minzhetang/pangu-riscv-soc/README.md

# 盘古100Pro+ RISC-V SoC

面向盘古100Pro+（MES2L676-100HP）、目标器件PG2L100H-6IFBG676的比赛项目。包含五级流水线CPU、同步存储适配、UART TX/GPIO包装及裸机C验证。

状态快照：**2026-10-25，F147只读复核在明示建模边界内排除新旧最终综合网表的有效组合环，但sdm2adm的7→8条告警根因/严重性仍未解释；F146收益候选暂不替换F143/O2稳定基线**。不是正式CoreMark成绩、完整ISA、外部/CDC时序、post-route全验证或实机验收。

仓库已建立：`main`跟踪`origin/main`，首次53项基线提交为`cac9f87aedef4879a3dc2893dc16f32fed8c849b`。首次推送前已核空引用，仓库名称及Private标记由负责人在已登录官网确认。Git成功没有改变下面的软件/硬件验收边界。

## 已验证与尚未验证

|事项|当前证据|
|---|---|
|CPU执行裸机C及同步存储|有限软件系统通过，存储32K ROM/32K RAM使用官方primitive功能模型|
|UART/GPIO|原程序N16/N234回归无退化，真实CPU读写及公开串行输出通过；B v02原R1–R3由F152独立复验关闭，有限软件交付可接收；RX未系统集成|
|最终阶段v01审收（历史，后续见F152）|F149共70文件完整分类覆盖，7新编译/7运行；共享RX逐笔顺序、指定关联变异和末半stop复位控制关闭，有限功能保留。事件快照、TX绝对沿号和活动元数据仍有条件；不升级系统或硬件验收|
|物理时钟计数|64位自由运行、组合只读、高低高读取；计时单元增强296检查及真实C通过|
|CoreMark短运行|2K总数据、两个种子、各1迭代，CRC/全状态/有序副作用/计时与后置UART通过|
|计算区原始时钟数|性能种子2,103,648；验证种子2,263,000；不是主机运行秒数|
|正式CoreMark成绩|**未取得**。不足10秒的原提示保留；27MHz仅为软件频率设定|
|PDS逻辑实现预检|F141实际综合/映射/PnR通过，最终1806 LUT/1555 FF/14 DRM36；27MHz内部setup/hold最差24.425/0.115ns。外部IO未约束、7条constant-probe警告未关闭，非板级Fmax/运行验收|
|板级顶层适配|F142新增15个真实IO约束、KEY0三沿复位、四键/八LED和234拍UART；复位与两个短C新运行/全状态/公开波形通过。实际PnR1805 LUT/1519 FF/14DRM，27MHz内部最差setup23.279ns/hold0.129ns；异步/外部时序和7告警仍有边界，无位流/实机|
|新板级top上的CoreMark|F143保持13源/两旧镜像，在N234下2个新DUT有限通过；计算窗口逐笔事件/时刻及终态同F136，raw ticks仍2103648/2263000，完整662/661字节UART；计算无退化也无提速。本轮0GCC/0PDS/0硬件|
|O2→O3单变量质量实验|F144两新镜像/两新DUT严格功能短测通过，但计算ticks2106278/2267352，比O2慢0.1250%/0.1923%；镜像均增3080B。拒绝O3、保留O2；0PDS/0硬件，不将全程序结束稍早或编译选项当计算收益/架构创新|
|控制流只读质量评估|F145从旧真实轨迹核对149422/162524次计算区重定向，后继EX间隔6拍；已决目标提前送同步ROM、标签匹配少一槽仅为候选。0新DUT/构建/参考重放，理论空间不是实测收益|
|已决目标取指候选|F146原763+67定向+2CoreMark严格通过；同O2镜像计算2103648→1804804、2263000→1937952，少14.2060%/14.3636%。+108LUT/+33FF，27MHz内部STA通过但估频72.6850→60.5583MHz；constant-probe7→8未定位，候选不升稳定基线，无位流/硬件|
|告警只读收窄|F147两最终VM完整解析，INIT/实际绑常量与状态边界建图0残余；粗略共同伪反馈不是PDS根因。0新编译/DUT/PDS，告警保持未闭；精简官方两问已备未发|
|正式计量就绪检查|F150只读核68输入/四旧原流：迭代参数写死1、检查器为短测、长跑日志/周期预算不适配；下一双2迭代校准具体范围待批。0新编译/DUT/PDS，不是正式成绩|
|双种子各2迭代校准|F151新2DUT严格有限通过，raw4207378/4526490、finalCRC72be/fe8c、完整662/661UART；只新端口迭代接线/验证预算，13RTL不改，先验参考与每笔副作用/全态核同。仍不足10秒、非正式或实机验收|
|B最终阶段v02接收|F152外层80文件/7新编译7DUT，RX270事件/2700快照0差异、TX12完整事件E+10N准确、27diff精确重建；N1旧版本文案非阻塞另注。v02当前B交付、核心同SHA，RX未接SoC，非新系统/硬件验收；F154收到冻结97/96核同、B已知悉|
|长测证据/资源M0|F153仅主机处理四旧流，392.5MB→64.6MB逐字节还原、原输入39项不改；发现旧samples列表270M拍引用下限2.16GB。0新DUT/CPU/PDS，下一分段记录与流式检查的具体scope待批准，非长测就绪|
|当前系统上板、片上波形|**未验证**；over_temp原因未闭环，硬件操作保持停止|

F146仅在独立副本修改cpu/soc取指选择，队员包装/TX/GPIO及官方算法不改。历史F136性能检查器曾漏计启动BSS，初版FAIL保留、以其`check-result-v2.json`为准；F143新`check-result.json`继承正确v2语义，不过滤启动零写。有限结果不能证明CPU整体正确，F146仅新增有限程序/同频条件下有实测支持的计算收益，不证明创新首创或最高频率吞吐改善。

## 目录与验收入口

首次提交保留原工作路径，避免移动或重写已冻结成果：

- `work/system/2026-10-24-timed-coremark-m1/source/`：本阶段整组RTL。`memory_model.sv`为项目自写绑定，不含Pango专有primitive实现，亦不是已验证生产可综合内存。
- 同目录`firmware/`、`port/`：启动/链接、计时C及CoreMark平台适配。
- 同目录`tests/`、Python检查文件：计时单元、系统监视和独立判定；仅白名单内文件入仓。
- 同目录`runs/*/check-result*.json`及少量报告：选定的软件验收证据；波形和大型原始日志留在本地。
- [本阶段验证报告](reports/verification/2026-10-24-timed-coremark-m1.md)、[前一系统报告](reports/verification/2026-10-24-soc-txgpio-m1-system.md)。报告中的本地绝对路径不代表该资源已随仓库分发。
- [F141生产视图与PDS预检](reports/verification/2026-10-24-fpga-implementability-m0.md)：`work/fpga/2026-10-24-implementability-m0`保留独立副本、验证宏侧文件、脚本、完整命令及选定结果；旧F136绑定仍为历史软件基线。初始化/模型/工具数据库和原始日志不入仓。未生成位流，过温STOP不变。
- [F142板级软件适配报告](reports/verification/2026-10-25-board-top-m1.md)：`work/fpga/2026-10-25-board-top-m1`包含独立新增top/reset、短C、TB/检查器、引脚/时钟工程和分层结果；既有11源功能不改。其当时新top未跑CoreMark状态由下条F143限定取代，原报告不改；模型16键、负测及波形解析不计新DUT。
- [F143板级CoreMark复验](reports/verification/2026-10-25-board-coremark-m1.md)：同名work/fpga目录保留新TB/运行器/检查器、精确镜像与13源收据、完整UART变化记录和窗口原生VCD、质量对照及分层结果。连续串口记录不冒充全算法原生波形或片上ILA，旧成果和硬件STOP保持。
- [F144编译优化反例与取舍](reports/verification/2026-10-25-compile-quality-m1.md)：同名work/fpga目录保留统一O3/真实描述diff、冻结预期、完整命令、严格终态/事件/串口与波形结果、容量/栈/计算和输出分列。O3只为已验证后拒绝的候选，不是新默认基线；原O2未重跑或覆盖。
- [F145控制流只读量化](reports/verification/2026-10-25-control-flow-quality-m0.md)：work/analysis同名目录包含原迹解析/逐PC统计、来源SHA、最小候选范围；没有新CPU验证、实现或优化收益，下一RTL/TB/模型/PDS阶段须另获批准。
- [F146取指候选与质量代价](reports/verification/2026-10-25-resolved-target-fetch-m1.md)：同名work/fpga目录含准确两源diff、逐例结果、两检查器历史失败/同输出修正、完整命令和新原始证据。候选暂缓合入，F143仍稳定；完整日志/波形/模型本地保留，不声称干净克隆一键复现。
- [F147告警只读调查](reports/verification/2026-10-25-prefetch-warning-m0.md)：完整图/建模边界、共有粗略假阳性、官方帮助检索与内部图不可达范围分列；不以自写解析器代替官方消息解释，不提升候选或恢复硬件。
- [F151双迭代真实校准](reports/verification/2026-10-25-coremark-iter2-m1.md)：新参数初始化、先验参考、2个实际DUT/计时/全状态/有序副作用及完整串行证据，旧源/失败保留；F143稳定/F146暂缓，下一长测资源方案未自动实施。
- [F150正式测量就绪](reports/verification/2026-10-25-coremark-measurement-readiness-m0.md)：旧实际ELF/轨迹和资源预算审计，保持稳定F143；下一有限双迭代scope未批，原B反馈已由用户报告转交，等待新答复。
- [F153长测资源与有界归档原型](reports/verification/2026-10-26-coremark-longrun-evidence-m0.md)：work/analysis同名目录含原型/实际四流结果/正负控和下一PENDING范围；未改DUT采集器或功能检查器，不当>=10秒验证/FPGA成绩。
- [F152最终v02接收与差额关闭](reports/progress/2026-10-25-stage-final-v02-review.md)、[给B的回执与五问答复](deliveries/mainline-stage-final-v02-response-2026-10-25-v1/TEAMMATE_REPLY.md)：逐文件覆盖/原5波形与7新DUT分开，N1注记保留；B只冻结和具体复验支持，无必须新开发或重封包，旧根OPEN_PREEXISTING与硬件STOP保持。
- [F149最终阶段v01审收](reports/progress/2026-10-25-stage-final-v01-review.md)、[队员R1–R3集中反馈](deliveries/mainline-stage-final-response-2026-10-25-v1/TEAMMATE_REPLY.md)：新DUT/原波形分列，已证项关闭，只收敛验证/元数据差额；原核心和硬件STOP保持。
- [F148/2335完整审收与八问](reports/progress/2026-10-25-increment-2335-mainline-alignment.md)、[集中队员回复](deliveries/mainline-increment-2335-response-2026-10-25-v1/TEAMMATE_REPLY.md)：原/新波形、失败和有限关闭分列，原核心保持，B仅验证差额/最终封包；10/27窗口及硬件STOP不变。
- [1735增量分层审收](reports/progress/2026-10-24-increment-1735-mainline-alignment.md)、[给队员的集中反馈](deliveries/mainline-increment-1735-response-2026-10-24-v1/TEAMMATE_REPLY.md)。新收件不扩大PDS或硬件授权，原系统有限验收保持。
- [首次提交范围](docs/repository/FIRST_COMMIT_SCOPE.md)、[逐文件SHA-256清单](docs/repository/first-commit-files.json)、[外部依赖与复现边界](docs/repository/EXTERNAL_DEPENDENCIES.md)。

## 复现边界

既有环境为Icarus/vvp 13.0、xPack RISC-V GCC 15.2.0-1、PDS 2022.2-SP6.4。工具、授权、专有模型及CoreMark上游算法源不在首次提交中；不会从本仓库自动安装或下载它们。

计时单元`tb_timer_unit_v2`只依赖本仓库三个源文件及现有Icarus，无需PDS模型。下面是PowerShell入口示例，**不表示为本轮Git同步额外重跑了计时单元**；先自行将两个变量设为本机已有合法工具的绝对路径，不修改系统PATH：

```powershell
$iverilog = '<absolute-path-to-iverilog.exe>'
$vvp = '<absolute-path-to-vvp.exe>'
$ivlLib = '<absolute-path-to-ivl-library-directory>'
$baseline = 'work/system/2026-10-24-timed-coremark-m1'
New-Item -ItemType Directory -Force build | Out-Null
& $iverilog -B $ivlLib -g2012 -Wall -s tb_timer_unit_v2 -o build/timer-unit.vvp "$baseline/source/cycle_counter64.sv" "$baseline/source/soc_data_adapter.sv" "$baseline/tests/tb_timer_unit_v2.sv"
if ($LASTEXITCODE -ne 0) { throw 'Compile failed; do not execute its output' }
Push-Location build
try { & $vvp -N -M- "-M$ivlLib" timer-unit.vvp } finally { Pop-Location }
```

**完整SoC尚不具备干净克隆后一键复现入口。**保留的阶段Python脚本含本机路径、历史保护记录和外部依赖；部分历史文件不在首提中。不可直接执行这些脚本并假定已具备依赖。后续应独立整理可迁移运行器、初始化生成与外部模型定位；本次不为入仓改动验证逻辑或伪造重新复现。

## 仓库边界

`.gitignore`采用明确文件白名单，新增文件须审查后更新清单；默认不收工具/安装包、专有模型、授权或凭据、机器标识、照片/原始资料、完整交付包、本地项目记忆及大型构建/波形产物。`.gitattributes`关闭换行自动转换，以保持冻结文件的原始SHA；不修改全局Git配置。

忽略规则不保护已跟踪文件，也挡不住强制添加。每个工作单元仍须核对实际差异、暂存清单和敏感信息，再非强制推送并检查远端结果。普通源码/测试/文档经审查可更新白名单；重大范围、敏感疑点、远端冲突/分叉或破坏性操作须暂停。测试按改动风险选择，不为每次Git操作全量重跑。

`first-commit-files.json`记录`cac9f87`的历史53项快照，不是永久禁止修改代码的规则；其中准备状态与SHA对应首提交。后续文件发生已审修改时，应以当前Git差异和新范围验证。`verify_first_commit.py`是首提准备的一次性历史入口，不应在已初始化仓库重复执行其prepare/audit。这里没有后台定时同步，也不读取或索取认证凭据。

本仓库未替全部工程统一授予新的开源许可。CoreMark及其他第三方依赖的版权/许可仍归各自权利人；工具授权文件与应保留的开源版权声明是两类不同材料。
