minzhetang/pangu-riscv-soc/reports/progress/evidence/2026-10-25-stage-final-v02-review/COMMANDS.md

# v02主机复验命令和原始收据

所有调用普通用户；仅固定7项编译经过本批外部工具审批，其余普通执行。不运行收到的Python main或旧VVP。

1. review.py init / structured / diff：原件只读检查；final_waves.py解析原五波形。
2. native_review.py prepare / compile / run：复制核SHA后7固定编译与7新DUT。
3. verify_new.py：新公开波形/账本/绝对沿及纯函数变异。

工作目录：D:/A_FPGA_Comp/work/peripheral-review/2026-10-25-stage-final-v02

完整绝对argv逐项列在该目录plan.json、compile.json、run.json以及logs/<id>/process.json；新stdout/stderr与VVP/VCD同根保留。

```json
{"id": "wrap16", "phase": "compile", "argv": ["D:\\A_FPGA_Comp\\tools\\iverilog-13.0-msys2-ucrt64\\ucrt64\\bin\\iverilog.exe", "-B", "D:\\A_FPGA_Comp\\tools\\iverilog-13.0-msys2-ucrt64\\ucrt64\\lib\\ivl", "-g2012", "-Wall", "-s", "tb_local_regif_txgpio_m1", "-DCLKS_PER_BIT=16", "-DTB_MAX_CYCLES=300000", "-I", "D:\\A_FPGA_Comp\\work\\peripheral-review\\2026-10-25-stage-final-v02\\source", "-o", "D:\\A_FPGA_Comp\\work\\peripheral-review\\2026-10-25-stage-final-v02\\build\\wrap16.vvp", "D:\\A_FPGA_Comp\\work\\peripheral-review\\2026-10-25-stage-final-v02\\source\\local_regif_txgpio_m1.v", "D:\\A_FPGA_Comp\\work\\peripheral-review\\2026-10-25-stage-final-v02\\source\\uart_tx.v", "D:\\A_FPGA_Comp\\work\\peripheral-review\\2026-10-25-stage-final-v02\\source\\gpio_core.v", "D:\\A_FPGA_Comp\\work\\peripheral-review\\2026-10-25-stage-final-v02\\source\\regif_tx_public_monitor.sv", "D:\\A_FPGA_Comp\\work\\peripheral-review\\2026-10-25-stage-final-v02\\source\\tb_local_regif_txgpio_m1.sv"], "cwd": "D:\\A_FPGA_Comp\\work\\peripheral-review\\2026-10-25-stage-final-v02", "returncode": 0, "hex": "0x00000000", "timed_out": false, "timeout_s": 60, "duration_s": 0.062, "stdout": "D:\\A_FPGA_Comp\\work\\peripheral-review\\2026-10-25-stage-final-v02\\logs\\compile-wrap16\\stdout.log", "stderr": "D:\\A_FPGA_Comp\\work\\peripheral-review\\2026-10-25-stage-final-v02\\logs\\compile-wrap16\\stderr.log", "log_truncated": false, "cleanup": "NOT_NEEDED"}
```
```json
{"id": "wrap234", "phase": "compile", "argv": ["D:\\A_FPGA_Comp\\tools\\iverilog-13.0-msys2-ucrt64\\ucrt64\\bin\\iverilog.exe", "-B", "D:\\A_FPGA_Comp\\tools\\iverilog-13.0-msys2-ucrt64\\ucrt64\\lib\\ivl", "-g2012", "-Wall", "-s", "tb_local_regif_txgpio_m1", "-DCLKS_PER_BIT=234", "-DTB_MAX_CYCLES=300000", "-I", "D:\\A_FPGA_Comp\\work\\peripheral-review\\2026-10-25-stage-final-v02\\source", "-o", "D:\\A_FPGA_Comp\\work\\peripheral-review\\2026-10-25-stage-final-v02\\build\\wrap234.vvp", "D:\\A_FPGA_Comp\\work\\peripheral-review\\2026-10-25-stage-final-v02\\source\\local_regif_txgpio_m1.v", "D:\\A_FPGA_Comp\\work\\peripheral-review\\2026-10-25-stage-final-v02\\source\\uart_tx.v", "D:\\A_FPGA_Comp\\work\\peripheral-review\\2026-10-25-stage-final-v02\\source\\gpio_core.v", "D:\\A_FPGA_Comp\\work\\peripheral-review\\2026-10-25-stage-final-v02\\source\\regif_tx_public_monitor.sv", "D:\\A_FPGA_Comp\\work\\peripheral-review\\2026-10-25-stage-final-v02\\source\\tb_local_regif_txgpio_m1.sv"], "cwd": "D:\\A_FPGA_Comp\\work\\peripheral-review\\2026-10-25-stage-final-v02", "returncode": 0, "hex": "0x00000000", "timed_out": false, "timeout_s": 60, "duration_s": 0.047, "stdout": "D:\\A_FPGA_Comp\\work\\peripheral-review\\2026-10-25-stage-final-v02\\logs\\compile-wrap234\\stdout.log", "stderr": "D:\\A_FPGA_Comp\\work\\peripheral-review\\2026-10-25-stage-final-v02\\logs\\compile-wrap234\\stderr.log", "log_truncated": false, "cleanup": "NOT_NEEDED"}
```
```json
{"id": "rx8", "phase": "compile", "argv": ["D:\\A_FPGA_Comp\\tools\\iverilog-13.0-msys2-ucrt64\\ucrt64\\bin\\iverilog.exe", "-B", "D:\\A_FPGA_Comp\\tools\\iverilog-13.0-msys2-ucrt64\\ucrt64\\lib\\ivl", "-g2012", "-Wall", "-s", "tb_uart_rx", "-DCLKS_PER_BIT=8", "-DTB_MAX_CYCLES=5045", "-I", "D:\\A_FPGA_Comp\\work\\peripheral-review\\2026-10-25-stage-final-v02\\source", "-o", "D:\\A_FPGA_Comp\\work\\peripheral-review\\2026-10-25-stage-final-v02\\build\\rx8.vvp", "-s", "review_rx_dump", "D:\\A_FPGA_Comp\\work\\peripheral-review\\2026-10-25-stage-final-v02\\source\\uart_rx.v", "D:\\A_FPGA_Comp\\work\\peripheral-review\\2026-10-25-stage-final-v02\\source\\rx_public_capture.sv", "D:\\A_FPGA_Comp\\work\\peripheral-review\\2026-10-25-stage-final-v02\\source\\tb_uart_rx.sv", "D:\\A_FPGA_Comp\\work\\peripheral-review\\2026-10-25-stage-final-v02\\tests\\review_rx_dump.sv"], "cwd": "D:\\A_FPGA_Comp\\work\\peripheral-review\\2026-10-25-stage-final-v02", "returncode": 0, "hex": "0x00000000", "timed_out": false, "timeout_s": 60, "duration_s": 0.063, "stdout": "D:\\A_FPGA_Comp\\work\\peripheral-review\\2026-10-25-stage-final-v02\\logs\\compile-rx8\\stdout.log", "stderr": "D:\\A_FPGA_Comp\\work\\peripheral-review\\2026-10-25-stage-final-v02\\logs\\compile-rx8\\stderr.log", "log_truncated": false, "cleanup": "NOT_NEEDED"}
```
```json
{"id": "rx16", "phase": "compile", "argv": ["D:\\A_FPGA_Comp\\tools\\iverilog-13.0-msys2-ucrt64\\ucrt64\\bin\\iverilog.exe", "-B", "D:\\A_FPGA_Comp\\tools\\iverilog-13.0-msys2-ucrt64\\ucrt64\\lib\\ivl", "-g2012", "-Wall", "-s", "tb_uart_rx", "-DCLKS_PER_BIT=16", "-DTB_MAX_CYCLES=11319", "-I", "D:\\A_FPGA_Comp\\work\\peripheral-review\\2026-10-25-stage-final-v02\\source", "-o", "D:\\A_FPGA_Comp\\work\\peripheral-review\\2026-10-25-stage-final-v02\\build\\rx16.vvp", "-s", "review_rx_dump", "D:\\A_FPGA_Comp\\work\\peripheral-review\\2026-10-25-stage-final-v02\\source\\uart_rx.v", "D:\\A_FPGA_Comp\\work\\peripheral-review\\2026-10-25-stage-final-v02\\source\\rx_public_capture.sv", "D:\\A_FPGA_Comp\\work\\peripheral-review\\2026-10-25-stage-final-v02\\source\\tb_uart_rx.sv", "D:\\A_FPGA_Comp\\work\\peripheral-review\\2026-10-25-stage-final-v02\\tests\\review_rx_dump.sv"], "cwd": "D:\\A_FPGA_Comp\\work\\peripheral-review\\2026-10-25-stage-final-v02", "returncode": 0, "hex": "0x00000000", "timed_out": false, "timeout_s": 60, "duration_s": 0.046, "stdout": "D:\\A_FPGA_Comp\\work\\peripheral-review\\2026-10-25-stage-final-v02\\logs\\compile-rx16\\stdout.log", "stderr": "D:\\A_FPGA_Comp\\work\\peripheral-review\\2026-10-25-stage-final-v02\\logs\\compile-rx16\\stderr.log", "log_truncated": false, "cleanup": "NOT_NEEDED"}
```
```json
{"id": "rx234", "phase": "compile", "argv": ["D:\\A_FPGA_Comp\\tools\\iverilog-13.0-msys2-ucrt64\\ucrt64\\bin\\iverilog.exe", "-B", "D:\\A_FPGA_Comp\\tools\\iverilog-13.0-msys2-ucrt64\\ucrt64\\lib\\ivl", "-g2012", "-Wall", "-s", "tb_uart_rx", "-DCLKS_PER_BIT=234", "-DTB_MAX_CYCLES=110967", "-I", "D:\\A_FPGA_Comp\\work\\peripheral-review\\2026-10-25-stage-final-v02\\source", "-o", "D:\\A_FPGA_Comp\\work\\peripheral-review\\2026-10-25-stage-final-v02\\build\\rx234.vvp", "-s", "review_rx_dump", "D:\\A_FPGA_Comp\\work\\peripheral-review\\2026-10-25-stage-final-v02\\source\\uart_rx.v", "D:\\A_FPGA_Comp\\work\\peripheral-review\\2026-10-25-stage-final-v02\\source\\rx_public_capture.sv", "D:\\A_FPGA_Comp\\work\\peripheral-review\\2026-10-25-stage-final-v02\\source\\tb_uart_rx.sv", "D:\\A_FPGA_Comp\\work\\peripheral-review\\2026-10-25-stage-final-v02\\tests\\review_rx_dump.sv"], "cwd": "D:\\A_FPGA_Comp\\work\\peripheral-review\\2026-10-25-stage-final-v02", "returncode": 0, "hex": "0x00000000", "timed_out": false, "timeout_s": 60, "duration_s": 0.063, "stdout": "D:\\A_FPGA_Comp\\work\\peripheral-review\\2026-10-25-stage-final-v02\\logs\\compile-rx234\\stdout.log", "stderr": "D:\\A_FPGA_Comp\\work\\peripheral-review\\2026-10-25-stage-final-v02\\logs\\compile-rx234\\stderr.log", "log_truncated": false, "cleanup": "NOT_NEEDED"}
```
```json
{"id": "rxneg", "phase": "compile", "argv": ["D:\\A_FPGA_Comp\\tools\\iverilog-13.0-msys2-ucrt64\\ucrt64\\bin\\iverilog.exe", "-B", "D:\\A_FPGA_Comp\\tools\\iverilog-13.0-msys2-ucrt64\\ucrt64\\lib\\ivl", "-g2012", "-Wall", "-s", "tb_uart_rx_neg", "-DCLKS_PER_BIT=16", "-DTB_MAX_CYCLES=20000", "-I", "D:\\A_FPGA_Comp\\work\\peripheral-review\\2026-10-25-stage-final-v02\\source", "-o", "D:\\A_FPGA_Comp\\work\\peripheral-review\\2026-10-25-stage-final-v02\\build\\rxneg.vvp", "D:\\A_FPGA_Comp\\work\\peripheral-review\\2026-10-25-stage-final-v02\\source\\uart_rx.v", "D:\\A_FPGA_Comp\\work\\peripheral-review\\2026-10-25-stage-final-v02\\source\\rx_public_capture.sv", "D:\\A_FPGA_Comp\\work\\peripheral-review\\2026-10-25-stage-final-v02\\source\\tb_uart_rx_neg.sv"], "cwd": "D:\\A_FPGA_Comp\\work\\peripheral-review\\2026-10-25-stage-final-v02", "returncode": 0, "hex": "0x00000000", "timed_out": false, "timeout_s": 60, "duration_s": 0.047, "stdout": "D:\\A_FPGA_Comp\\work\\peripheral-review\\2026-10-25-stage-final-v02\\logs\\compile-rxneg\\stdout.log", "stderr": "D:\\A_FPGA_Comp\\work\\peripheral-review\\2026-10-25-stage-final-v02\\logs\\compile-rxneg\\stderr.log", "log_truncated": false, "cleanup": "NOT_NEEDED"}
```
```json
{"id": "txcap", "phase": "compile", "argv": ["D:\\A_FPGA_Comp\\tools\\iverilog-13.0-msys2-ucrt64\\ucrt64\\bin\\iverilog.exe", "-B", "D:\\A_FPGA_Comp\\tools\\iverilog-13.0-msys2-ucrt64\\ucrt64\\lib\\ivl", "-g2012", "-Wall", "-s", "tb_regif_tx_capture_neg", "-DCLKS_PER_BIT=16", "-DTB_MAX_CYCLES=20000", "-I", "D:\\A_FPGA_Comp\\work\\peripheral-review\\2026-10-25-stage-final-v02\\source", "-o", "D:\\A_FPGA_Comp\\work\\peripheral-review\\2026-10-25-stage-final-v02\\build\\txcap.vvp", "D:\\A_FPGA_Comp\\work\\peripheral-review\\2026-10-25-stage-final-v02\\source\\regif_tx_public_monitor.sv", "D:\\A_FPGA_Comp\\work\\peripheral-review\\2026-10-25-stage-final-v02\\source\\tb_regif_tx_capture_neg.sv"], "cwd": "D:\\A_FPGA_Comp\\work\\peripheral-review\\2026-10-25-stage-final-v02", "returncode": 0, "hex": "0x00000000", "timed_out": false, "timeout_s": 60, "duration_s": 0.047, "stdout": "D:\\A_FPGA_Comp\\work\\peripheral-review\\2026-10-25-stage-final-v02\\logs\\compile-txcap\\stdout.log", "stderr": "D:\\A_FPGA_Comp\\work\\peripheral-review\\2026-10-25-stage-final-v02\\logs\\compile-txcap\\stderr.log", "log_truncated": false, "cleanup": "NOT_NEEDED"}
```
```json
{"id": "wrap16", "phase": "run", "argv": ["D:\\A_FPGA_Comp\\tools\\iverilog-13.0-msys2-ucrt64\\ucrt64\\bin\\vvp.exe", "-N", "-M-", "-MD:\\A_FPGA_Comp\\tools\\iverilog-13.0-msys2-ucrt64\\ucrt64\\lib\\ivl", "D:\\A_FPGA_Comp\\work\\peripheral-review\\2026-10-25-stage-final-v02\\build\\wrap16.vvp", "+WAVE_FILE=D:/A_FPGA_Comp/work/peripheral-review/2026-10-25-stage-final-v02/build/wrap16.vcd"], "cwd": "D:\\A_FPGA_Comp\\work\\peripheral-review\\2026-10-25-stage-final-v02", "returncode": 0, "hex": "0x00000000", "timed_out": false, "timeout_s": 30, "duration_s": 0.031, "stdout": "D:\\A_FPGA_Comp\\work\\peripheral-review\\2026-10-25-stage-final-v02\\logs\\run-wrap16\\stdout.log", "stderr": "D:\\A_FPGA_Comp\\work\\peripheral-review\\2026-10-25-stage-final-v02\\logs\\run-wrap16\\stderr.log", "log_truncated": false, "cleanup": "NOT_NEEDED"}
```
```json
{"id": "wrap234", "phase": "run", "argv": ["D:\\A_FPGA_Comp\\tools\\iverilog-13.0-msys2-ucrt64\\ucrt64\\bin\\vvp.exe", "-N", "-M-", "-MD:\\A_FPGA_Comp\\tools\\iverilog-13.0-msys2-ucrt64\\ucrt64\\lib\\ivl", "D:\\A_FPGA_Comp\\work\\peripheral-review\\2026-10-25-stage-final-v02\\build\\wrap234.vvp", "+WAVE_FILE=D:/A_FPGA_Comp/work/peripheral-review/2026-10-25-stage-final-v02/build/wrap234.vcd"], "cwd": "D:\\A_FPGA_Comp\\work\\peripheral-review\\2026-10-25-stage-final-v02", "returncode": 0, "hex": "0x00000000", "timed_out": false, "timeout_s": 30, "duration_s": 0.109, "stdout": "D:\\A_FPGA_Comp\\work\\peripheral-review\\2026-10-25-stage-final-v02\\logs\\run-wrap234\\stdout.log", "stderr": "D:\\A_FPGA_Comp\\work\\peripheral-review\\2026-10-25-stage-final-v02\\logs\\run-wrap234\\stderr.log", "log_truncated": false, "cleanup": "NOT_NEEDED"}
```
```json
{"id": "rx8", "phase": "run", "argv": ["D:\\A_FPGA_Comp\\tools\\iverilog-13.0-msys2-ucrt64\\ucrt64\\bin\\vvp.exe", "-N", "-M-", "-MD:\\A_FPGA_Comp\\tools\\iverilog-13.0-msys2-ucrt64\\ucrt64\\lib\\ivl", "D:\\A_FPGA_Comp\\work\\peripheral-review\\2026-10-25-stage-final-v02\\build\\rx8.vvp", "+WAVE_FILE=D:/A_FPGA_Comp/work/peripheral-review/2026-10-25-stage-final-v02/build/rx8.vcd"], "cwd": "D:\\A_FPGA_Comp\\work\\peripheral-review\\2026-10-25-stage-final-v02", "returncode": 0, "hex": "0x00000000", "timed_out": false, "timeout_s": 30, "duration_s": 0.079, "stdout": "D:\\A_FPGA_Comp\\work\\peripheral-review\\2026-10-25-stage-final-v02\\logs\\run-rx8\\stdout.log", "stderr": "D:\\A_FPGA_Comp\\work\\peripheral-review\\2026-10-25-stage-final-v02\\logs\\run-rx8\\stderr.log", "log_truncated": false, "cleanup": "NOT_NEEDED"}
```
```json
{"id": "rx16", "phase": "run", "argv": ["D:\\A_FPGA_Comp\\tools\\iverilog-13.0-msys2-ucrt64\\ucrt64\\bin\\vvp.exe", "-N", "-M-", "-MD:\\A_FPGA_Comp\\tools\\iverilog-13.0-msys2-ucrt64\\ucrt64\\lib\\ivl", "D:\\A_FPGA_Comp\\work\\peripheral-review\\2026-10-25-stage-final-v02\\build\\rx16.vvp", "+WAVE_FILE=D:/A_FPGA_Comp/work/peripheral-review/2026-10-25-stage-final-v02/build/rx16.vcd"], "cwd": "D:\\A_FPGA_Comp\\work\\peripheral-review\\2026-10-25-stage-final-v02", "returncode": 0, "hex": "0x00000000", "timed_out": false, "timeout_s": 30, "duration_s": 0.093, "stdout": "D:\\A_FPGA_Comp\\work\\peripheral-review\\2026-10-25-stage-final-v02\\logs\\run-rx16\\stdout.log", "stderr": "D:\\A_FPGA_Comp\\work\\peripheral-review\\2026-10-25-stage-final-v02\\logs\\run-rx16\\stderr.log", "log_truncated": false, "cleanup": "NOT_NEEDED"}
```
```json
{"id": "rx234", "phase": "run", "argv": ["D:\\A_FPGA_Comp\\tools\\iverilog-13.0-msys2-ucrt64\\ucrt64\\bin\\vvp.exe", "-N", "-M-", "-MD:\\A_FPGA_Comp\\tools\\iverilog-13.0-msys2-ucrt64\\ucrt64\\lib\\ivl", "D:\\A_FPGA_Comp\\work\\peripheral-review\\2026-10-25-stage-final-v02\\build\\rx234.vvp", "+WAVE_FILE=D:/A_FPGA_Comp/work/peripheral-review/2026-10-25-stage-final-v02/build/rx234.vcd"], "cwd": "D:\\A_FPGA_Comp\\work\\peripheral-review\\2026-10-25-stage-final-v02", "returncode": 0, "hex": "0x00000000", "timed_out": false, "timeout_s": 30, "duration_s": 0.703, "stdout": "D:\\A_FPGA_Comp\\work\\peripheral-review\\2026-10-25-stage-final-v02\\logs\\run-rx234\\stdout.log", "stderr": "D:\\A_FPGA_Comp\\work\\peripheral-review\\2026-10-25-stage-final-v02\\logs\\run-rx234\\stderr.log", "log_truncated": false, "cleanup": "NOT_NEEDED"}
```
```json
{"id": "rxneg", "phase": "run", "argv": ["D:\\A_FPGA_Comp\\tools\\iverilog-13.0-msys2-ucrt64\\ucrt64\\bin\\vvp.exe", "-N", "-M-", "-MD:\\A_FPGA_Comp\\tools\\iverilog-13.0-msys2-ucrt64\\ucrt64\\lib\\ivl", "D:\\A_FPGA_Comp\\work\\peripheral-review\\2026-10-25-stage-final-v02\\build\\rxneg.vvp", "+WAVE_FILE=D:/A_FPGA_Comp/work/peripheral-review/2026-10-25-stage-final-v02/build/rxneg.vcd"], "cwd": "D:\\A_FPGA_Comp\\work\\peripheral-review\\2026-10-25-stage-final-v02", "returncode": 0, "hex": "0x00000000", "timed_out": false, "timeout_s": 30, "duration_s": 0.032, "stdout": "D:\\A_FPGA_Comp\\work\\peripheral-review\\2026-10-25-stage-final-v02\\logs\\run-rxneg\\stdout.log", "stderr": "D:\\A_FPGA_Comp\\work\\peripheral-review\\2026-10-25-stage-final-v02\\logs\\run-rxneg\\stderr.log", "log_truncated": false, "cleanup": "NOT_NEEDED"}
```
```json
{"id": "txcap", "phase": "run", "argv": ["D:\\A_FPGA_Comp\\tools\\iverilog-13.0-msys2-ucrt64\\ucrt64\\bin\\vvp.exe", "-N", "-M-", "-MD:\\A_FPGA_Comp\\tools\\iverilog-13.0-msys2-ucrt64\\ucrt64\\lib\\ivl", "D:\\A_FPGA_Comp\\work\\peripheral-review\\2026-10-25-stage-final-v02\\build\\txcap.vvp", "+WAVE_FILE=D:/A_FPGA_Comp/work/peripheral-review/2026-10-25-stage-final-v02/build/txcap.vcd"], "cwd": "D:\\A_FPGA_Comp\\work\\peripheral-review\\2026-10-25-stage-final-v02", "returncode": 0, "hex": "0x00000000", "timed_out": false, "timeout_s": 30, "duration_s": 0.031, "stdout": "D:\\A_FPGA_Comp\\work\\peripheral-review\\2026-10-25-stage-final-v02\\logs\\run-txcap\\stdout.log", "stderr": "D:\\A_FPGA_Comp\\work\\peripheral-review\\2026-10-25-stage-final-v02\\logs\\run-txcap\\stderr.log", "log_truncated": false, "cleanup": "NOT_NEEDED"}
```
