minzhetang/pangu-riscv-soc/reports/progress/evidence/2026-10-25-stage-final-v02-review/READING_CHECKLIST_COMPLETED.md

# v02逐文件阅读/解析清单

80文件；0仅哈希、0未读。旧同SHA内容按F149完整阅读证据复用，变更源按实际v01→v02完整差额核查。原5VCD全时间线解析与本次7新DUT分开。

|文件|状态|
|---|---|
|artifacts/stage-return-final-20261027-v02/CHANGED_FILES.json|FULL_STRUCTURED_PARSE_AND_SEMANTIC_CHECK|
|artifacts/stage-return-final-20261027-v02/coverage_map.json|FULL_STRUCTURED_PARSE_AND_SEMANTIC_CHECK|
|artifacts/stage-return-final-20261027-v02/delivery.json|FULL_STRUCTURED_PARSE_AND_SEMANTIC_CHECK|
|artifacts/stage-return-final-20261027-v02/DEPENDENCIES.json|FULL_STRUCTURED_PARSE_AND_SEMANTIC_CHECK|
|artifacts/stage-return-final-20261027-v02/DIFF.patch|FULL_STRUCTURED_PARSE_AND_SEMANTIC_CHECK|
|artifacts/stage-return-final-20261027-v02/HISTORY_ALIASES.json|FULL_STRUCTURED_PARSE_AND_SEMANTIC_CHECK|
|artifacts/stage-return-final-20261027-v02/MODULE_STATUS.json|FULL_STRUCTURED_PARSE_AND_SEMANTIC_CHECK|
|artifacts/stage-return-final-20261027-v02/OPEN_ITEMS.md|FULL_CURRENT_DELTA_PLUS_VERIFIED_PRIOR_FULL_READ|
|artifacts/stage-return-final-20261027-v02/SHA256SUMS.txt|FULL_STRUCTURED_PARSE_AND_SEMANTIC_CHECK|
|artifacts/stage-return-final-20261027-v02/SOURCE_INDEX.json|FULL_STRUCTURED_PARSE_AND_SEMANTIC_CHECK|
|artifacts/stage-return-final-20261027-v02/START_HERE.md|FULL_CURRENT_DELTA_PLUS_VERIFIED_PRIOR_FULL_READ|
|artifacts/stage-return-final-20261027-v02/work/peripherals/rx/CHANGELOG.md|FULL_CURRENT_DELTA_PLUS_VERIFIED_PRIOR_FULL_READ|
|artifacts/stage-return-final-20261027-v02/work/peripherals/rx/docs/RX-LEDGER-1.3.5.md|FULL_CURRENT_DELTA_PLUS_VERIFIED_PRIOR_FULL_READ|
|artifacts/stage-return-final-20261027-v02/work/peripherals/rx/logs/rx-20261025-211013/compile_illegal.log|FULL_STRUCTURED_PARSE_AND_SEMANTIC_CHECK|
|artifacts/stage-return-final-20261027-v02/work/peripherals/rx/logs/rx-20261025-211013/compile_N16.log|FULL_STRUCTURED_PARSE_AND_SEMANTIC_CHECK|
|artifacts/stage-return-final-20261027-v02/work/peripherals/rx/logs/rx-20261025-211013/compile_N234.log|FULL_STRUCTURED_PARSE_AND_SEMANTIC_CHECK|
|artifacts/stage-return-final-20261027-v02/work/peripherals/rx/logs/rx-20261025-211013/compile_N8.log|FULL_STRUCTURED_PARSE_AND_SEMANTIC_CHECK|
|artifacts/stage-return-final-20261027-v02/work/peripherals/rx/logs/rx-20261025-211013/compile_neg.log|FULL_STRUCTURED_PARSE_AND_SEMANTIC_CHECK|
|artifacts/stage-return-final-20261027-v02/work/peripherals/rx/logs/rx-20261025-211013/compile_watchdog.log|FULL_STRUCTURED_PARSE_AND_SEMANTIC_CHECK|
|artifacts/stage-return-final-20261027-v02/work/peripherals/rx/logs/rx-20261025-211013/plan_check.log|FULL_STRUCTURED_PARSE_AND_SEMANTIC_CHECK|
|artifacts/stage-return-final-20261027-v02/work/peripherals/rx/logs/rx-20261025-211013/run_illegal.log|FULL_STRUCTURED_PARSE_AND_SEMANTIC_CHECK|
|artifacts/stage-return-final-20261027-v02/work/peripherals/rx/logs/rx-20261025-211013/run_manifest.json|FULL_STRUCTURED_PARSE_AND_SEMANTIC_CHECK|
|artifacts/stage-return-final-20261027-v02/work/peripherals/rx/logs/rx-20261025-211013/run_N16.log|FULL_STRUCTURED_PARSE_AND_SEMANTIC_CHECK|
|artifacts/stage-return-final-20261027-v02/work/peripherals/rx/logs/rx-20261025-211013/run_N234.log|FULL_STRUCTURED_PARSE_AND_SEMANTIC_CHECK|
|artifacts/stage-return-final-20261027-v02/work/peripherals/rx/logs/rx-20261025-211013/run_N8.log|FULL_STRUCTURED_PARSE_AND_SEMANTIC_CHECK|
|artifacts/stage-return-final-20261027-v02/work/peripherals/rx/logs/rx-20261025-211013/run_neg.log|FULL_STRUCTURED_PARSE_AND_SEMANTIC_CHECK|
|artifacts/stage-return-final-20261027-v02/work/peripherals/rx/logs/rx-20261025-211013/run_watchdog.log|FULL_STRUCTURED_PARSE_AND_SEMANTIC_CHECK|
|artifacts/stage-return-final-20261027-v02/work/peripherals/rx/logs/rx-20261025-211013/schema_validate.log|FULL_STRUCTURED_PARSE_AND_SEMANTIC_CHECK|
|artifacts/stage-return-final-20261027-v02/work/peripherals/rx/logs/rx-20261025-211013/tool_iverilog.log|FULL_STRUCTURED_PARSE_AND_SEMANTIC_CHECK|
|artifacts/stage-return-final-20261027-v02/work/peripherals/rx/logs/rx-20261025-211013/tool_python.log|FULL_STRUCTURED_PARSE_AND_SEMANTIC_CHECK|
|artifacts/stage-return-final-20261027-v02/work/peripherals/rx/logs/rx-20261025-211013/tool_vvp.log|FULL_STRUCTURED_PARSE_AND_SEMANTIC_CHECK|
|artifacts/stage-return-final-20261027-v02/work/peripherals/rx/logs/rx-status-selfcheck-20261025-211027/summary.json|FULL_STRUCTURED_PARSE_AND_SEMANTIC_CHECK|
|artifacts/stage-return-final-20261027-v02/work/peripherals/rx/results.json|FULL_STRUCTURED_PARSE_AND_SEMANTIC_CHECK|
|artifacts/stage-return-final-20261027-v02/work/peripherals/rx/scripts/run_rx.py|FULL_CURRENT_DELTA_PLUS_VERIFIED_PRIOR_FULL_READ|
|artifacts/stage-return-final-20261027-v02/work/peripherals/rx/scripts/rx_status_selfcheck.py|SAME_SHA_FULL_PRIOR_REVIEW_REUSED|
|artifacts/stage-return-final-20261027-v02/work/peripherals/rx/STATUS.md|FULL_CURRENT_DELTA_PLUS_VERIFIED_PRIOR_FULL_READ|
|artifacts/stage-return-final-20261027-v02/work/peripherals/rx/tb/rx_public_capture.sv|SAME_SHA_FULL_PRIOR_REVIEW_REUSED|
|artifacts/stage-return-final-20261027-v02/work/peripherals/rx/tb/tb_uart_rx.sv|FULL_CURRENT_DELTA_PLUS_VERIFIED_PRIOR_FULL_READ|
|artifacts/stage-return-final-20261027-v02/work/peripherals/rx/tb/tb_uart_rx_neg.sv|SAME_SHA_FULL_PRIOR_REVIEW_REUSED|
|artifacts/stage-return-final-20261027-v02/work/peripherals/rx/tests/rx-plan-1.3.5.json|FULL_STRUCTURED_PARSE_AND_SEMANTIC_CHECK|
|artifacts/stage-return-final-20261027-v02/work/peripherals/rx/tests/rx-plan-1.3.5.sha256|FULL_STRUCTURED_PARSE_AND_SEMANTIC_CHECK|
|artifacts/stage-return-final-20261027-v02/work/peripherals/rx/waves/rx-20261025-211013/uart_rx_N16.vcd|FULL_VCD_ALL_TIMESTAMPS_PUBLIC_MODEL|
|artifacts/stage-return-final-20261027-v02/work/peripherals/rx/waves/rx-20261025-211013/uart_rx_N234.vcd|FULL_VCD_ALL_TIMESTAMPS_PUBLIC_MODEL|
|artifacts/stage-return-final-20261027-v02/work/peripherals/rx/waves/rx-20261025-211013/uart_rx_N8.vcd|FULL_VCD_ALL_TIMESTAMPS_PUBLIC_MODEL|
|artifacts/stage-return-final-20261027-v02/work/regif/txgpio-m1/docs/RUNBOOK.md|FULL_CURRENT_DELTA_PLUS_VERIFIED_PRIOR_FULL_READ|
|artifacts/stage-return-final-20261027-v02/work/regif/txgpio-m1/docs/W01-W10.md|FULL_CURRENT_DELTA_PLUS_VERIFIED_PRIOR_FULL_READ|
|artifacts/stage-return-final-20261027-v02/work/regif/txgpio-m1/logs/regif-capture-20261025-210624/compile_capture.log|FULL_STRUCTURED_PARSE_AND_SEMANTIC_CHECK|
|artifacts/stage-return-final-20261027-v02/work/regif/txgpio-m1/logs/regif-capture-20261025-210624/run_capture.log|FULL_STRUCTURED_PARSE_AND_SEMANTIC_CHECK|
|artifacts/stage-return-final-20261027-v02/work/regif/txgpio-m1/logs/regif-capture-20261025-210624/summary.json|FULL_STRUCTURED_PARSE_AND_SEMANTIC_CHECK|
|artifacts/stage-return-final-20261027-v02/work/regif/txgpio-m1/logs/regif-entry-selfcheck-20261025-210805/summary.json|FULL_STRUCTURED_PARSE_AND_SEMANTIC_CHECK|
|artifacts/stage-return-final-20261027-v02/work/regif/txgpio-m1/logs/regif-m1-20261025-210743/compile_N16.log|FULL_STRUCTURED_PARSE_AND_SEMANTIC_CHECK|
|artifacts/stage-return-final-20261027-v02/work/regif/txgpio-m1/logs/regif-m1-20261025-210743/compile_N234.log|FULL_STRUCTURED_PARSE_AND_SEMANTIC_CHECK|
|artifacts/stage-return-final-20261027-v02/work/regif/txgpio-m1/logs/regif-m1-20261025-210743/plan_check.log|FULL_STRUCTURED_PARSE_AND_SEMANTIC_CHECK|
|artifacts/stage-return-final-20261027-v02/work/regif/txgpio-m1/logs/regif-m1-20261025-210743/run_N16.log|FULL_STRUCTURED_PARSE_AND_SEMANTIC_CHECK|
|artifacts/stage-return-final-20261027-v02/work/regif/txgpio-m1/logs/regif-m1-20261025-210743/run_N234.log|FULL_STRUCTURED_PARSE_AND_SEMANTIC_CHECK|
|artifacts/stage-return-final-20261027-v02/work/regif/txgpio-m1/logs/regif-m1-20261025-210743/tool_iverilog.log|FULL_STRUCTURED_PARSE_AND_SEMANTIC_CHECK|
|artifacts/stage-return-final-20261027-v02/work/regif/txgpio-m1/logs/regif-m1-20261025-210743/tool_python.log|FULL_STRUCTURED_PARSE_AND_SEMANTIC_CHECK|
|artifacts/stage-return-final-20261027-v02/work/regif/txgpio-m1/logs/regif-m1-20261025-210743/tool_vvp.log|FULL_STRUCTURED_PARSE_AND_SEMANTIC_CHECK|
|artifacts/stage-return-final-20261027-v02/work/regif/txgpio-m1/README.md|FULL_CURRENT_DELTA_PLUS_VERIFIED_PRIOR_FULL_READ|
|artifacts/stage-return-final-20261027-v02/work/regif/txgpio-m1/results.json|FULL_STRUCTURED_PARSE_AND_SEMANTIC_CHECK|
|artifacts/stage-return-final-20261027-v02/work/regif/txgpio-m1/scripts/regif_capture_selfcheck.py|SAME_SHA_FULL_PRIOR_REVIEW_REUSED|
|artifacts/stage-return-final-20261027-v02/work/regif/txgpio-m1/scripts/regif_entry_selfcheck.py|FULL_CURRENT_DELTA_PLUS_VERIFIED_PRIOR_FULL_READ|
|artifacts/stage-return-final-20261027-v02/work/regif/txgpio-m1/scripts/run_regif_m1.py|FULL_CURRENT_DELTA_PLUS_VERIFIED_PRIOR_FULL_READ|
|artifacts/stage-return-final-20261027-v02/work/regif/txgpio-m1/tb/regif_tx_public_monitor.sv|FULL_CURRENT_DELTA_PLUS_VERIFIED_PRIOR_FULL_READ|
|artifacts/stage-return-final-20261027-v02/work/regif/txgpio-m1/tb/tb_local_regif_txgpio_m1.sv|SAME_SHA_FULL_PRIOR_REVIEW_REUSED|
|artifacts/stage-return-final-20261027-v02/work/regif/txgpio-m1/tb/tb_regif_tx_capture_neg.sv|SAME_SHA_FULL_PRIOR_REVIEW_REUSED|
|artifacts/stage-return-final-20261027-v02/work/regif/txgpio-m1/tests/w01-w10-plan-1.0.5.json|FULL_STRUCTURED_PARSE_AND_SEMANTIC_CHECK|
|artifacts/stage-return-final-20261027-v02/work/regif/txgpio-m1/tests/w01-w10-plan-1.0.5.sha256|FULL_STRUCTURED_PARSE_AND_SEMANTIC_CHECK|
|artifacts/stage-return-final-20261027-v02/work/regif/txgpio-m1/waves/regif-m1-20261025-210743/regif_m1_N16.vcd|FULL_VCD_ALL_TIMESTAMPS_PUBLIC_MODEL|
|artifacts/stage-return-final-20261027-v02/work/regif/txgpio-m1/waves/regif-m1-20261025-210743/regif_m1_N234.vcd|FULL_VCD_ALL_TIMESTAMPS_PUBLIC_MODEL|
|AUTHORIZATION_AND_BOUNDARIES.md|FULL_TEXT_READ|
|CHECK_REPORT.json|FULL_STRUCTURED_PARSE_AND_MANIFEST_CHECK|
|CHECK_REPORT.md|FULL_TEXT_READ|
|DELIVERY_CONTENTS.json|FULL_STRUCTURED_PARSE_AND_MANIFEST_CHECK|
|MAINLINE_HANDOFF.md|FULL_TEXT_READ|
|QUESTIONS_TO_MAINLINE.md|FULL_TEXT_READ|
|REFERENCES.md|FULL_TEXT_READ|
|RESULTS_SUMMARY.json|FULL_STRUCTURED_PARSE_AND_MANIFEST_CHECK|
|SHA256SUMS.txt|FULL_STRUCTURED_PARSE_AND_MANIFEST_CHECK|
|START_HERE.md|FULL_TEXT_READ|
