minzhetang/pangu-riscv-soc/snapshots/2026-11-01-paused-technical-review/evidence/hardware/2026-11-01-mul-sm2-repeat-h70-r1/UART_REPORT.txt

BOARD_QA_M2 BOOT
RAMTEST PASS wstrb/sign/zero
MULTEST PASS 80
LED 00000000 WRITE 00000001 READ 00000001
LED 00000001 WRITE 00000002 READ 00000002
LED 00000002 WRITE 00000004 READ 00000004
LED 00000003 WRITE 00000008 READ 00000008
LED 00000004 WRITE 00000010 READ 00000010
LED 00000005 WRITE 00000020 READ 00000020
LED 00000006 WRITE 00000040 READ 00000040
LED 00000007 WRITE 00000080 READ 00000080
GPIO_INPUT_READY KEY1..4 press/release;120s limit
INPUT 00000000
GPIO_WAIT
GPIO_WAIT
GPIO_WAIT
GPIO_WAIT
INPUT 00000001
GPIO_WAIT
INPUT 00000000
GPIO_WAIT
GPIO_WAIT
INPUT 00000002
INPUT 00000000
GPIO_WAIT
GPIO_WAIT
INPUT 00000004
GPIO_WAIT
INPUT 00000000
GPIO_WAIT
INPUT 00000008
GPIO_WAIT
INPUT 00000000
GPIO_INPUT PASS press=0000000f release=0000000f
2K performance run parameters for coremark.
CoreMark Size    : 666
Total ticks      : 496232016
Total time (secs): 18
Iterations/Sec   : 14
Iterations       : 256
Compiler version : GCC 15.2.0
Compiler flags   : -DBOARD_QA_M2=1 -DPROJECT_MULSI3_SM2=1 -march=rv32i -mabi=ilp32 -O2 -ffreestanding -fno-builtin -fno-common -fno-pie -fno-stack-protector -fno-unwind-tables -fno-asynchronous-unwind-tables -mno-relax -msmall-data-limit=0 -Wall -Wextra -Werror -nostdlib -nostartfiles -Wl,--no-relax -Wl,--build-id=none -Wl,-T,firmware/link.ld -Wl,-Map,build/performance256/program.map -Ifirmware -Iport -Iupstream -Ibuild/performance256 -DTOTAL_DATA_SIZE=2000 -DITERATIONS=256 -DPERFORMANCE_RUN=1
Memory location  : Code in on-chip ROM; data in static on-chip RAM; clock ratio 1:1
seedcrc          : 0xe9f5
[0]crclist       : 0xe714
[0]crcmatrix     : 0x1fd7
[0]crcstate      : 0x8e3a
[0]crcfinal      : 0xb40f
Correct operation validated. See README.md for run and reporting rules.
Raw start hi/lo : 00000000 1a12331b
Raw end hi/lo   : 00000000 37a6196b
Raw delta hi/lo : 00000000 1d93e650
Timer Hz set    : 27000000; MEASUREMENT CANDIDATE; TARGET EVIDENCE REQUIRED
BOARD_QA_M2 END LED=000000a5
