minzhetang/pangu-riscv-soc/snapshots/2026-11-03-submission/START_HERE.md

# Latest submission source and technical report — 3 November 2026

This reviewed snapshot accompanies the full [competition code package](../../deliveries/competition-source-package-2026-11-03-v1/package/START_HERE.md). The archive is a real RAR5 code attachment; expanded source is also tracked for inspection. No private-workspace access is required to read its main code, tests and declared dependencies.

- [Full project/source coverage](../../deliveries/competition-source-package-2026-11-03-v1/package/PROJECT_MAP.md)
- [Production, application and independent-candidate identities](../../deliveries/competition-source-package-2026-11-03-v1/package/VERSION_TABLE.md)
- [Reproduction entry points and legal external dependencies](../../deliveries/competition-source-package-2026-11-03-v1/package/REPRODUCIBILITY.md)
- [Chinese technical report PDF](report/技术报告.pdf) and [editable DOCX](report/技术报告.docx): 41 pages, 16 tables, 18 figures. These are the reviewed-layout submission draft, pending the owner's final submission review, not a competition acceptance or new functional result.
- [Contribution/result evidence mapping](report/成果—证据对应表.md), [figure descriptions](report/图表说明.md), and [remaining submission materials](report/提交前需用户核实.md).

Production SM2 and the event-recorder application each retain their finite board-level evidence. BTB/M-mode, Cache and synthetic fixed-point FC are separate candidates. The BTB CoreMark long run remains incomplete; the completed short tests, offline resource/STA results and failed-run prefixes are not a new >=10-second candidate score. Original on-chip O2 captures do not become SM2 or BTB captures. The actual PDS resource table is 14.5 DRM36-equivalent for SM2; earlier truncated integer14 is historical.

Report figures include real board/interface images, captured-WDF-derived plots and labelled explanatory diagrams. They are not a claim that all source trees have board or ILA acceptance. Public models, references, negative tests and historical failure records remain labelled. RX has not been integrated into the production SoC; the separate offline tool retains its G1–G3 limitations.

The PDF/DOCX and selected supporting materials are exact copies of the local report delivery (REPORT_SOURCE_MAP.json). The full local QA history, memory extracts, official template copies and draft exports are deliberately not uploaded. Code-package provenance and the current file set are described by its own MANIFEST/SHA256SUMS. No new build, simulation, PDS flow or hardware operation was performed for this Git synchronization. No project-wide open-source license has been added; third-party copyright and CoreMark notices remain.

The older root README/CONTRIBUTION review is a separate pending documentation change and is not included in this sync. Use this snapshot and the linked code-package version table for the current results. Tool installers, credentials, licenses/keys, machine identifiers, proprietary models/databases and large historical traces remain excluded. No repository visibility change or deployment is authorized by this snapshot.
