minzhetang/pangu-riscv-soc/deliveries/mainline-led-configured-status-scope-2026-10-30-v1/EXECUTION_SCOPE.md

# A-LED-CONFIG-STATUS-M1 / 1.0.0

日期2026-10-30，D206；**PENDING_USER_APPROVAL，未执行**。本范围是D204单次只读结束之后的新建议，不继承其硬件额度。无B派工/对外发送。

## 目的与固定输入

只验证一次官方LED临时配置前后STATUSR变化、配置完成状态和用户可观察的LED行为。不做CPU/CoreMark/ILA或长期热稳定验收。

- 目标PG2L100H，公开ID00602899，index0/TCK1MHz。
- 原LED `work/pds-led/2026-10-11-scbv-high-build/generate_bitstream/led_test.sbit`，3791112B，SHA256 `5CBE55491613F163BBDC372F2F5226F1D0E1C1A95A508A02ED54BF150704F307`。
- program3（关断配置+ISC），沿历史已执行路径；不改SCBV/电源/跳线/温控/位流。不重新构建。
- 使用已装PDS2022.2-SP6.4官方cdt_js/cdt_cfg_shell，普通用户、无GUI；工具审批独立。不安装、改许可/驱动/系统环境。

## 批准后可实施内容

在唯一新目录准备有界控制器、离线解析/流程/故障守卫；旧只读入口和旧LED脚本不覆盖、不重跑。实体就绪门未满足前不启动服务器、不枚举设备。

一次冷启动、一个本轮服务器/客户端、一次扫描/公开ID、**一次配置前状态**。前状态bit27=1或身份不符则不分配/下载位流，直接结束。否则只分配上述固定文件、设置program3、执行一次cfg_program；成功后立即读状态，若flag0且时间充足可约5秒后再读一次（总状态最多3次）。flag1/错误/超时即结束，不继续等待或追加下载。LED观察在现有时间窗内，由用户反馈，不强求视频/延长运行。

命令白名单：cfg_set_tcl_break、cfg_connect、cfg_set_cable_property、cfg_scan_chain、cfg_read_device_property(mode0/3)、cfg_assign_file(固定文件)、cfg_set_device_property(program3)、cfg_program(至多一次)、cfg_disconnect及客户端退出。不允许通配Tcl/其他设备属性。

**不含Flash、复位命令、readback/verify、UID/eFuse、CPU程序、温控寄存器、SCBV或供电修改**。首次LED位流仍只易失性下载。服务器会产生配置动作，不能将杀掉客户端解释成器件已停止。

## 预算与风险

- 历史单配置168.5秒，不保证这次相同。配置命令上限200秒，控制器总上限240秒（含自有进程清理），从接12V起用户独立通电硬限300秒。
- 实施时按保守上电时间界动态扣减；发cfg_program前必须有完整200秒配置预算及至少20秒读取/退出余量，否则不开始配置，不靠重新计时获得预算。用户回复/审批延迟照计。
- 到达限时或有异味/烟雾/异响/供电反复掉电，用户先断12V，再断下载器USB；不等待聊天或程序，不带电插拔JTAG、不摸芯片判温。实体步骤一次一步。
- 配置期间无连续温度或bit27监控，不能保证风险可控到无损坏；300秒只为容纳已知耗时并留退出余量，**不是经测温证明安全的区间**。
- 配置异常/超时：保留已发命令/输出、标注设备状态未知，不盲发断连/复位/重试；按结束或紧急断电步骤停止供电，随后确认本轮自有进程退出。不对配置断电的设备状态作成功承诺。

## 验收与收尾

记录同一次上电的前/后原状态、hex/binary一致性、DONE/错误位、每条命令/单配置计数、进程rc与退出、用户观察/断电报告、SHA与未修改输入。只有新实际输出可作本轮证据。

配置完成、状态采样、LED行为、实际温度/安全、CPU实机与正式成绩分别报告；flag0不自动解除停止。前flag0/后flag1只能说配置后出现，不证明配置导致真实过热或误报。完成或失败即停，不自动进入下一硬件阶段。
