minzhetang/pangu-riscv-soc/work/fpga/2026-10-25-board-top-m1/IMPLEMENTATION_SCOPE.md

# A-BOARD-TOP-M1 已批准纯软件范围

2026-10-25实施（资料核对始于10-24）；D131。用户在F141结尾唯一建议后明确“同意继续”，批准板级顶层/复位/UART/引脚约束及必要短验证、PDS CLI复验。原D130建议保留历史，不重复申请普通技术选择。

在本独立目录保留F141十一源的source-before，CPU/ALU/control/regfile、B包装/TX/GPIO、计时器/路由/存储功能不改。新增board_top/board_reset_sync、基于真实四按键的短C/独立监视/自动判定和有来源的15IO约束；原TB/输入/预期/算法不改。

GPIO低4位为KEY1–4按下=1，高4位0，LED不反相；KEY0低有效异步断言、3沿同步释放（无消抖/物理MTBF承诺）。UART为234物理拍/bit，27MHz名义115384.615baud，误差约+0.1603%；不是默认16拍或照抄教材50MHz示例。

先冻结手工预期和独立模型，固定两Icarus编译目标（复位单元/真实C板顶层），实际三个有界运行（复位/K5/K12）；核完整RF/32K RAM、每笔有序WB和访存、不去重、公开UART/GPIO及控制X/Z/正常停止。复位单元覆盖冷初态/无钟/异步断言/3沿释放/反复按键。新C有data/BSS、实际外设读写/重复合法写/6帧/签名/EBREAK，非CoreMark。

通过后已有PDS2022.2-SP6.4 CLI对目标PG2L100H/-6/FBG676执行compile/synthesis/map/pnr/report_timing（无gen_bit_stream），使用F141同一performance镜像，核初始化、关键层次和15个真实引脚、内部27MHz多角时序。异步输入/输出没有板厂外部时序预算时保留未约束边界，不造delay/false path。7条constant-probe只作有界只读诊断，不能无依据判无害或等同真实组合环。

普通编译/启动既有崩溃证据仍在；本批外部执行通过工具另审批、非管理员、固定命令、编译120s/运行45s/PDS1200s、首错诊断。新错误如需改CPU/存储协议/原预期即停，保留证据给最小方案。

不新增工具/GUI/管理员/许可证或环境修改，不执行破解软件，不动原件、B任务/接口/返回窗口。**无位流、服务器/设备枚举/JTAG/上电/下载/Flash/SCBV/供电/温控；over_temp STOP保持。**板级软件适配不等硬件/完整CDC或正式CoreMark/ILA验收。阶段完成报告/记忆/普通Git工作单元同步后停止。
