minzhetang/pangu-riscv-soc/snapshots/2026-11-03-submission/report/figures/04-event-flow.pdf

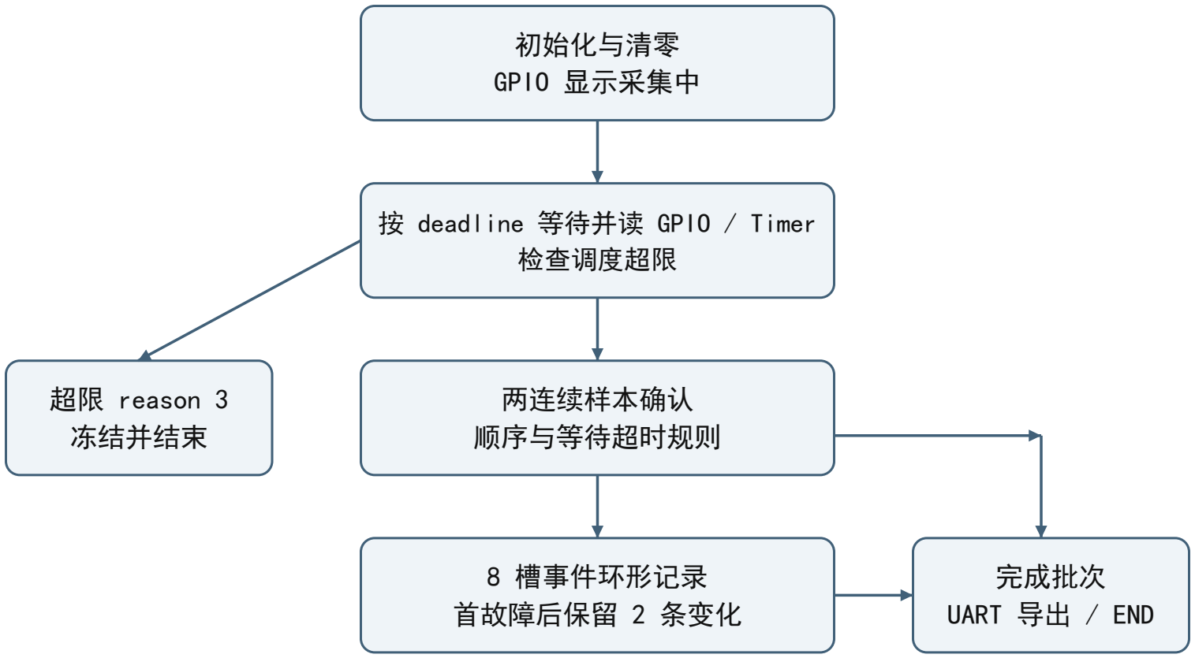
[picture p1: figure]
初始化与清零 GPIO 显示采集中; 按 deadline 等待并读 GPIO / Timer 检查调度超限; 两连续样本确认 顺序与等待超时规则; 8 槽事件环形记录 首故障后保留 2 条变化; 超限 reason 3 冻结并结束; 完成批次 UART 导出 / END

采集期间不阻塞打印；导出期间停止监测；冻结后拒绝与环形覆盖均显式计数
