minzhetang/pangu-riscv-soc/snapshots/2026-11-03-submission/report/figures/06-btb-control.pdf

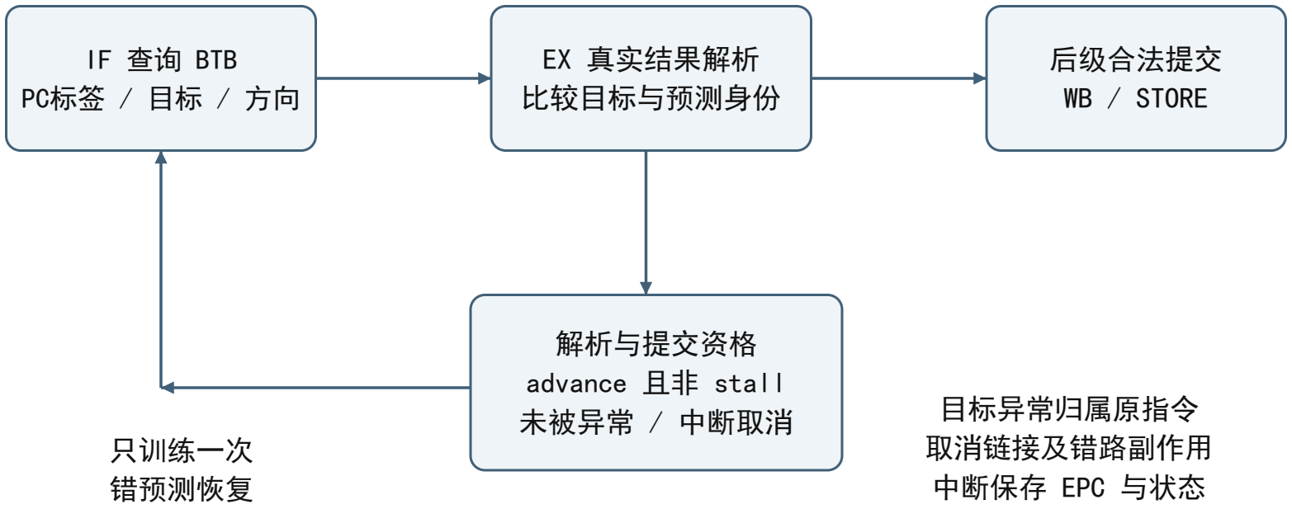
[picture p2: figure]
IF 查询 BTB PC标签 / 目标 / 方向; EX 真实结果解析 比较目标与预测身份; 后级合法提交 WB / STORE; 解析与提交资格 advance 且非 stall 未被异常 / 中断取消; 只训练一次 错预测恢复; 目标异常归属原指令 取消链接及错路副作用 中断保存 EPC 与状态

独立候选保留原特权模块；实际验收限定动态预测及所选 M-mode 场景
