minzhetang/pangu-riscv-soc/snapshots/2026-11-02-sm2-acceptance/REPORT.md

# SM2双种子实机复验与UART接收诊断

日期：2026-11-02，北京时间。D300/F260。**结论：接受D294定义裸机EEI内的SM2非调试运行版本，作为当前推荐版本；旧O2恢复版及所有失败保留。** 本轮没有修改CPU、SoC、外设RTL或CoreMark程序，没有重新仿真/综合；使用此前已审位流，实际完成两次新的易失性配置。Flash、芯片保护、SCBV、供电和跳线未由软件更改。

## 1. 版本、证据与采用门

结果入口：`D:/A_FPGA_Comp/work/quality/2026-11-02-sm2-resume-m3/RESULTS.json`。恢复快照：`D:/A_FPGA_Comp/deliveries/accepted-basic-sm2-2026-11-02-v1/START_HERE.md`。快照80项源副本/证据约23.7MB，逐项核SHA；完整码流仅本地保存，不因冻结自动运行。

固定比较条件：同PG2L100H/FBG676工程、27MHz约束、RV32I/ILP32、GCC15.2.0/O2、CoreMark256迭代、相同数据集/种子和计算计时边界。主线先前新增EEI对齐终止规则已有24项定向及原763冻结回归，本轮没有重复运行或把它升级为全部RV32I/特权符合性。

SM2只替换编译运行时软乘`__mulsi3`，采用符号幅度及双bit循环；CoreMark算法/工作量不变，编译flags明示`PROJECT_MULSI3_SM2`。基准、SM2性能及验证实现的CPU SHA均为`60F02899294C5BEF04E522622E32764A13B910008ADD85A73FE607550F9AF272`。80组乘法和RAM字节/半字/符号扩展自检在计时窗外，串口格式化与GPIO等待也不计入计算周期。

预先冻结的采用门为性能周期至少减少5%、程序增量不超过512B、不增加DRM、同27MHz内部时序通过及正确性/重复性保持。本次没有改门槛或回填预期。

| 项目 | 原O2对照 | SM2性能 | SM2验证 |
|---|---:|---:|---:|
| 256迭代计算周期 |538539600|496232016|522673286|
| 标称27MHz秒数 |19.945911111|18.378963556|19.358269852|
| 新清洁报告 |原实机基线，按原版本引用|本轮1份完整严格通过；与旧H69首轮同周期|本轮2份完整严格通过，同周期|
| 五CRC |各原记录|e9f5/e714/1fd7/8e3a/b40f|18f2/e3c1/0747/8d84/798f|
| 性能程序字节 |19684|19744（+60B）|19752，不与不同种子的性能bin直接比增量|
| LUT / FF / DRM36 |1810 /1527 /14|相同|相同|

性能种子周期减少**7.85598385%**，同标称频率下吞吐增加**8.52576671%**；二者不是同一百分比。性能种子精确名义迭代率13.928968259次/秒；不拿程序按整数秒打印的商替代原始64位周期计算。不用宿主墙钟时间跑分，也不把参数27MHz当独立实测校频。

上表资源/STA来自D294已有实现审计，本轮只重新核身份，没有重跑PDS。性能/验证均27MHz八组内部STA零失败、0Critical、1856片INIT与固定程序一致。该0Critical属于**非调试运行版**，不能消除旧调试版4个Critical或物理CDC/外部IO的限制。

## 2. 两次配置与身份链

| 镜像 | 实际配置阶段 | sbit SHA256 | 完整原厂SVF SHA256 |
|---|---|---|---|
| 性能 |`work/pds-jtag/2026-11-02-sm2-performance-m3`|`5A687E9081AB17EB8EAA7FBC6277CB383F5035B70FDBACD4F4EEBA2F21668CE4`|`18501E48C340300CCFD9762A20615DD9B420A38EB558C4412E4FE89A114446FD`|
| 验证 |`work/pds-jtag/2026-11-02-sm2-validation-m3`|`65567CF5D50D53925DADEAE3B5FF5E2FBF6DD04CD4F9E91EDE5F0621C382D68D`|`D20212CEA388D9F8B22D2F2D1AC6E7D2F6140ABD4C538E01113CBBCA1FEAF87C`|

每阶段恰一次`cfg_execute_svf`，无`cfg_program`或Flash操作。本阶段2次配置预算已用完，不自动恢复性能镜像或追加下载。最后驻留为**SM2验证种子非调试镜像**。

验证SVF本轮由官方工具离线导出，未通过修改SVF载荷构造。按先前已核PDS导出变换还原后，从同步区偏移2084至末尾与sbit配置流完全一致；同步前141字节为导出器正常化差异，不声称整文件逐字节等同。完整SVF指令流程与已验原厂性能流程一致。两次配置后均两份状态读回`0x081ffca0`，DONE/DONE_I/GOUTEN为1、CRC/ID/timeout等为0；bit27记录为1，但不被单独用作本方停止条件，也没有改芯片保护或确认实际温度。

## 3. 串口问题的实际排查结果

初始设备枚举未见CP210x，用户仅重新插紧UART后恢复COM22/OK/问题0。下载器A/B口不是板载UART，未将COM20/21当作UART。只读核得CP210x签名驱动版本11.6.0.420；本轮没有安装、回滚或重配置驱动。

| 对照 | 原始结果 | 判断 |
|---|---|---|
| 新.NET 65536B请求 |0字节、114条RXOver|增缓冲没有解决，拒绝验收|
| .NET 4096B，用户复跑 |0字节、16条RXOver|不能归因于仅缓冲大小|
| 原生Win32 ReadFile/COMSTAT |0字节、15条mask1 RXOver，3955次读取；队列0|波特率/8N1回读一致，不能只归咎.NET|
| 用户仅UART USB断开10秒后重接，原生同参数 |1912B、五CRC及496232016周期正确，UART错误0；宿主收尾标forced unknown|报告/传输正确但整体严格检查FAIL，原件不改|
| 增2秒有界退出等待后的性能复跑 |1872B、同CRC/周期、错误0、root0/Job空/无强清|完整严格通过|
| 验证首轮 / 重复 |2268B /1908B、同CRC/522673286周期、错误0、所有工具正常退出|两份完整严格通过|

UART USB断接后恢复是**本次对照观察**，不是唯一根因证明，更不证明硬件、线材或驱动永久无问题。各报告字节数差异来自计时窗外的`GPIO_WAIT`和按键事件，不是减少基准计算/输出。没有隐藏接收错误、裁掉不合格报告或把退出码0单独当成功。

微软将`CE_RXOVER`定义为输入缓冲溢出/相关接收条件，与`CE_OVERRUN`字符缓冲丢字节不同；本轮分别照录，不把两者混为同一种已定位故障。参考[ClearCommError官方文档](https://learn.microsoft.com/en-us/windows/win32/api/winbase/nf-winbase-clearcommerror)。原生入口在确认错误后记录并调用API继续读取，不忽略错误，最终只要有错误就拒绝清洁验收。

宿主收尾修复只在**根进程已退出**时，给所属子进程最多2秒自行收尾，随后仍沿原严格Job检查；若仍有残留，原强清/未知标志继续生效。没有把原forced unknown改成PASS或扩大无限等待，原v1源码与失败检查保留。

## 4. 验收证据与可复查命令

本轮完整通过的三份`CAPTURE_CHECK.json`、`SERIAL_RESULT.json`、`RESULT.json`及`uart-raw.bin`分别在：

- `D:/A_FPGA_Comp/work/pds-jtag/2026-11-02-sm2-performance-native-repeat-m3/`
- `D:/A_FPGA_Comp/work/pds-jtag/2026-11-02-sm2-validation-m3/`
- `D:/A_FPGA_Comp/work/pds-jtag/2026-11-02-sm2-validation-native-repeat-m3/`

性能旧首轮H69仅做原记录重核，结果`LEGACY_H69_RECHECK.json`，不计新DUT；新native-r2有正确报告但宿主收尾未过，保留其`CAPTURE_CHECK.json`失败和`REPORT_ONLY_CHECK.json`分层结论。所有当前通过捕获都有完整有序QA/RAM/80乘法/四键、唯一完整CoreMark、五CRC、原始计时差值、真实终止和全字节/分块账本检查。

离线复核命令（只读已有文件，验证器拒绝覆盖同名旧结果，重判需新输出目录）：

```powershell
& '<VERIFIED_PYTHON>' -X utf8 -B work/quality/2026-11-02-sm2-resume-m3/check_capture.py <capture-stage> performance
# 第二、三份使用validation。实际全部命令/来源/结果由各ATTEMPT和RESULT定位。
```

用户另确认KEY0时全灭、松开8灯依次亮、末态LED0/2/5/7亮；这是现场光学观察，和程序GPIO寄存器回读分开。不是独立仪器测量或完整IO电气验收。串口的GPIO检查分别保存每次真实按下/松开事件，未去重伪造。

## 5. 最终版本与剩余边界

推荐SM2性能/验证这对固定非调试版本，用于定义裸机EEI内的当前基本作品运行；原O2和原始失败不删除、不覆盖。复制快照中已核源码、约束、启动/链接/端口、bin/ELF、位流、SVF和必要证据；**不是已经形成完整比赛提交包**。软件重建所需CoreMark上游六文件及版权/Apache-2.0材料、GNU工具链和PDS合法环境另列依赖，未把外部模型/安装包/许可证塞入快照。

仍未解决/未验证：

- UART此次异常的唯一底层原因及长期稳定性；独立校频、温度、SCBV实际供电接线。
- 物理CDC/MTBF/外部IO全面签核；旧调试版4Critical。
- SM2程序本身的新片上流水窗口：原O2四窗ILA只作原基线瓶颈分析，不移植成优化版取证。
- 完整RV32I、特权异常/MMU或高阶任务2；B的HL4仍为独立候选，不合并、不继承本实机结果。
- 无统一退休PC/完整架构提交轨迹，有限签名与程序输出不能证明所有执行正确。
- 最终比赛技术报告、代码依赖闭包和视频/照片材料的统一整理与提交核验。

本轮结束时所有所属监听、客户端和硬件服务器正常退出；最后验证版仍按用户连接状态驻留，没有获得新的断电回执。后续硬件范围另按实际目标核准，不复用本轮ATTEMPT或按键提示。D245待审仓库文档保持原样，本轮不以技术结论顺带批准该批文档。
