minzhetang/pangu-riscv-soc/reports/hardware/2026-10-30-diagnostic-readiness.md

# 当前诊断条件与停止边界

2026-10-30，F184/D202。用户报告：仅基本万用表，型号不清楚，无测温功能，可测电压/电流/电阻/通断；这是用户报告，不是A独立器材验收。不再追问型号、不自动要求购买。

## 本轮实际复核

- 两份原PDF重新核SHA，读取相关页，Poppler新渲染并视觉核对三页：UG040005 V1.3实际59/印58表3-14，UG040009 V1.6实际15/印14与29/印28。缺Symbol/ArialUnicode显示字体警告保留，关键表格与正文可辨。原PDF及技术结论未被新证据推翻。
- CFG27行仅名为over_temp/过温标志，没有该位完整极性/有效性/锁存清除定义。ADC OT高有效/滞回，以及未配置ADC上电仍监测的说明，不能补成CFG27全部规则。
- 原结果JSON与配置命令日志重新读取；仅一次历史cfg_program，STATUSR081efca0/bit27=1。没有新温度、配置前bit27或供电读数，没有执行原硬件脚本。
- 本地PDF提取脚本首次把BOM编码拼为utf8-sig而停止，改为标准utf-8-sig后完成只读复核；未发生工具/硬件调用，不把该错误说成芯片或文档问题。

证据与SHA/页码：`work/analysis/2026-10-30-hardware-diagnostic-readiness-m0/REVIEW_RESULT.json`；新图cfg59.png/adc15.png/adc29.png。原文件：`reports/hardware/2026-10-14-over-temp-evidence/UG040005_Logos2_Configuration_V1.3_EN.pdf`、`UG040009_Logos2_ADC_V1.6_EN.pdf`；原JSON `reports/hardware/2026-10-14-led-volatile-result.json`，配置日志 `work/pds-jtag/2026-10-14-led-volatile/configuration_tcl.log`。前一系统调查的供电/原理图未知仍按F045/F046/F182，不重复全部归档调查。

## 当前可以决定什么

1. 基本万用表能提供电气检查线索，不能直接证明芯片实际温度，也不能靠电压正常、蜂鸣或某次阻值判断CFG27正常。当前测点/完整核心板接线与板厂验收条件不充分，不安排临时试探性的带电测量。
2. 不摸芯片测温，不改温控阈值/otsd_en，不轮换SCBV，不换供电/跳线凑通过，不因无咨询渠道或临近截止放行。本轮没有上电、JTAG或温度试验授权。
3. 当前缺的是可信温度取证及相匹配的安全测试条件，不是再跑软件仿真。未来可核实合适仪器/测试平台或有文档依据的诊断能力，不绑定必须购买某一设备；单独有测温工具也不自动证明全部供电/结温和CFG位正常，表面温度不直接等于结温。
4. 内部ADC数据可以是未来方案的候选信息源，但它涉及上电/读取/可能配置与校准，且与OT共享芯片监测路径，不能现在把它当独立验证或直接下载demo来解除未知。已有demo含校准条件，未核条件前不执行。

## 责任与下一步

- 硬件线：STOP，现阶段不请求接线、上电、通断测试或下载；暂无充分证据制定可立即执行的有电诊断。需要新的实体条件时，再集中给出用途、局限、具体动作和权限，用户不承担研究工作。不再索取已明确没有的测温功能或要求无渠道的厂商咨询。
- 主线可独立推进：用已验软件轨迹/窗口分析和两256实现报告整理性能解释与交付报告素材，区分完整程序/算法计时窗、参考推导/新DUT/实机，指出最有证据的瓶颈；不新跑DUT或改CPU，不用VCD替代片上波形。另行实施优化或工具执行仍核范围。
- 保留F183两256非调试位流和F181软件证据，既有7告警/外部IO/CDC、R4的4Critical/采样驱动未知不消失。此次只是把诊断的真实条件说清楚，未解决过温原因或取得实机成绩。
