minzhetang/pangu-riscv-soc/reports/progress/2026-10-30-board-readiness-m0.md

# 256程序非调试实现准备与硬件准入复核

2026-10-30；F182/D199。主线已接管剩余工作，不等B。此轮仅标准库静态检查、证据整理和待批范围；未修改功能源、未启动PDS/仿真或硬件。

## 本轮消除的缺口

新M1功能源13份逐字节同F163/source-before，生产模板12份逐字节同，memory_model是原已验的观测视图移除/INIT内联转换。不是新换一种存储时序。两份256 ELF/bin SHA与F181结果核同，真实ELF seed4=256、seed3=0x66、seed1/2模式正确；镜像分别16352/16356B，RAM/栈布局在既定范围。解码实际INIT文件，各ROM32768B严格=image+零，各RAM32768B严格A5。没有新解释器/DUT运行。

旧非调试8位流F548BC8BAA3DDFB5E2EB3158AE108F5A9DFCE7FE6C08919DB8DB245187C8D7A4当前核同，仍只绑定旧8程序；新256没有位流。performance256/validation256 raw538539600/579425414为F181参考记录，27MHz条件下约19.946/21.460秒，不是实际温度/频率/实机成绩。两个工程必须独立，不能混入调试候选。

读取F163真实build.tcl、审计相关段及原时序/源差异/INIT收据，确认可以复用compile/synthesize/dev_map/pnr/report_timing/gen_bit_stream路线。新的程序/字符串/布局变化不止一个字节，不能沿用F163“只改一个INIT”的旧断言；新审计应按两原bin独立算1792个片段，并保留未测外部IO/CDC/7告警边界。当前原件保护核同数量见SUMMARY，不重新执行旧审计入口或工具。

## 硬件准入仍未满足

|门槛|可验证的现状|本轮处置/以后需要什么|
|---|---|---|
|历史实际状态|直接解析原LED JSON：公开ID00602899、STATUSR081efca0、over_temp1、done/done_i1、CRC0|保留首次实际读数；没有新的状态/实温/配置前基线，不能认定真热、正常默认或误报|
|芯片状态规则|既有系统调查中CFG27有效性/极性/锁存清除与ADC通路仍缺完整依据|复用已核官方页码，不从ADC OT滞回推CFG27，也不以未实例化ADC忽略风险；本轮未新增阅读PDF或勘误证据|
|配置供电|SCBV High是已有用户接受的工程推断，实际三脚供电接线未闭环|本轮不改High/Low、供电、跳线或温控；警告消失不是电压实测|
|电源/当前实体状态|历史用户D-ON下POWER亮、后来已断12V与下载器USB；底板A3V3灯不能证明全电源正常|本轮未实体复核，不把旧P-ON说成OFF，不要求接线/上电/测量|
|ILA|R4尚有4条Critical/完整采样驱动/CDC证据缺口|在使用调试候选前单独关闭；不阻塞非调试程序离线构建，也不能被该构建豁免|

不能仅靠纯软件测试闭合实际温度和实际供电；没有咨询途径同样不构成安全放行依据。目前只能确定继续STOP，不能杜撰一个上电/测量阈值或恢复流程。本轮未申请联系厂家/老师，不重复已穷尽的全部压缩包调查。后续如提出实体诊断，先给明确证据依据、动作/观察量与停止条件，另批；尚无足够依据时不得安排实体尝试。

## 执行排序与下一门槛

采用：保护M1软件基线，先取得双种子256**非调试软件位流**，硬件线继续停止；旧调试导出反复失败不作为该构建前置。理由：它能消除真实交付缺口，且无需改CPU/存储时序或依赖未知实体状态。暂缓新增CPU/ISA/Cache等，保留ILA正式取证义务。未批准构建，不因本次continue自动执行PDS。

待批范围：`deliveries/mainline-coremark256-nodebug-scope-2026-10-30-v1/IMPLEMENTATION_SCOPE.md` 1.0.0，两个独立case/最多2次PDS CLI，各1800秒，总4800秒，0新GCC/仿真/硬件，保留实际许可提示与已知告警。是明确的新生产INIT/实现阶段，已用完的旧PDS额度不能复用，需用户一次授权；不是让用户选择普通技术细节。

证据入口`work/analysis/2026-10-30-board-readiness-m0/audit.py、SOURCE_AND_IMAGE_IDENTITY.json、SAFETY_GATES.json、SUMMARY.json`。历史规则来源：`reports/hardware/2026-10-15-systematic-hardware-evidence-review.md` §2/3.1–3.3；原LED `reports/hardware/2026-10-14-led-volatile-result.json`；F163实现报告及本地JSON。只读复用已核规则，本轮没有取得新的安全文档/实测，不夸大为安全原因已解决。
