minzhetang/pangu-riscv-soc/reports/progress/2026-10-28-fpga-evidence-readiness-m0.md

# 真实FPGA/片上取证路径：只读准备结果

2026-10-28（北京时间）；F164/D166。本轮只读分析与证据整理，0新构建/仿真/PDS/硬件；F163位流和F160软件验收不变。

当前已有能执行实际C程序/CoreMark并输出UART的有限软件系统，已有对应8迭代CPU位流。**现在的关键缺口是安全可用设备、实际CPU输出/时基和片上波形，而不是继续追加ISA或离线工具。**本轮取得了一份此前未读到的远程平台正式使用手册，消除了“平台是否只支持外部仪器”的资料疑问，但没有取得任何平台使用权或实机验收。

## 新证据及实际检查

|证据|实际结果|出处/范围|
|---|---|---|
|官方指南既有规则|选题一注意事项允许初赛自备或远程FPGA；复用F118已视觉核实内容，本轮未重新全审赛题/提交规则|本地选题指南PDF实际11/印刷9页；既有`reports/progress/2026-10-22-official-guide-preliminary-delivery-review.md`|
|板厂远程手册|V1.0，修订日2026/1/7，24页；全篇提取阅读，实际2/8/11/13/17/23/24页整页视觉核对|[板厂发布页](https://szlogicmatrix.com/1501.html)；独立证据目录`remote_lab_developer_manual.pdf`，3187357B，SHA256 **05FE830148F5638E0A6986938BE06DA916E700F283B28BA9ECA253A82620FDD0**|
|设备与下载|手册8–10页为申请/预约/时长规则，13页接受.sbit且演示PG2L100H与PG2L200H不匹配提示；截图不是当日可用库存或费用表|PDF8/13页视觉。10分钟是文档默认申请时长，不是免费承诺/本项目预约|
|两类分析工具|17页68通道连接外部40pin，不能当内部流水线；23–24页另有Debugger，描述导入PDS FIC及内部ILA/PCIe DMA采集|PDF17/23/24页视觉；后者为板厂功能说明，不是本项目已复现；平台封装/DMA要求仍未知|
|实时公开入口|指南HTTP地址本次普通网络Win10013后，独立工具审批下只读GET得到200和FPGA LAB标题；未执行JS/登录/读取设备清单|`HTTP_RESULTS.json`保留失败，`HTTP_RESULTS_EXTERNAL.json`保留两个固定URL成功。HTTPS入口仅工具访问失败，不能断言不存在或建议在未知入口填密码|
|PDS原生调试路径|Fabric Inserter V1.0/2022.07.12：插DebugCore形成新网表，保存FIC后Map调用插核；不能仅给现有无核sbit配一个FIC就声称可抓内部信号|`D:/PDS/PDS_2022.2-SP6.4/doc/Fabric_Inserter_User_Guide.pdf`，PDF7/17/24/26/40/47页；关键页视觉，版本页2视觉|
|采样/连接要求|Clock为调试工作/采样时钟，可选Reset低有效；深度64–131072、可选升/降沿，过滤与多窗口会影响观察含义/时序；ins_set_net按list_nets索引连接而非任意RTL层次名|同上PDF7/24/26/47，明确只是手册规则；没有运行list_nets/Inserter或验证可连接性|
|输出证据|Fabric Debugger V1.1/2023.04.24支持ASCII/WDF/FIC/VCD/TXT导出；**来自FPGA真实采集的VCD**可作片上证据，旧仿真VCD不能冒充|`D:/PDS/PDS_2022.2-SP6.4/doc/Fabric_Debugger_User_Guide.pdf` PDF18/印刷17页；版本页2/印刷1，视觉|
|现有基线|F160整组13源SHA及F163位流实际重核；源码逻辑采样对象可定位，合成网表仅做名称出现统计，不宣称每个对象可连接|`BASELINE_CHECK.json、PROBE_PLAN_DRAFT.json`；不是新DUT、真实退休或探针插入验证|

本地证据目录：`D:/A_FPGA_Comp/work/analysis/2026-10-28-fpga-evidence-readiness-m0/`。PDF全文及页面副本仅本地，Git只纳入脱敏索引/派生结论，不再分发厂商手册全文或公开联系方式。

阅读边界：PDS两本156页仅全文提取/相关章节阅读，不称逐页视觉；Inserter视觉2/7/17/24/26/40/47，Debugger视觉2/9/18/38；远程7页视觉，共18页。初次输出截断涉及非采用页，重要命令/连接/导出页另行完整补读；编码默认GBK读取失败后改显式UTF8，不涉及设计或DUT失败。网络取得的是公开资料/HTML壳，不是登录、预约、编译、烧写或实际捕获。

## 技术定案：先把片上观察设计清楚，暂不构建

1. 保留F163无调试基准，后续仅新独立调试副本，不覆盖位流/原源。优先PDS网表插核；如所需信号被优化，只能另批准最小PAP_MARK_DEBUG元数据，不能借此改CPU功能。当前RTL层次名不是FIC网表索引。
2. 草案只用1个DebugCore、1024点、27MHz物理时钟每拍采样、All Data、先禁用多窗口/资格过滤；观察逻辑140bit，有效载荷143360bit，仅为容量下界，实际块分配/控制资源/时序待新实现。窗口约37.926微秒，只能解释局部流水效率，不能覆盖整个CoreMark或宣称退休IPC。
3. 沿既有定义，执行槽为id_valid && pipeline_advance && !eei_hold；不能只采执行槽而丢失空拍/停顿。计划含id_pc、控制、32位timer低位及有序写数据观察。原理时钟域已知，但具体插核采样延迟、前/后沿坐标和触发位置必须先校准；不把Fetch PC当退休PC。
4. 针对F162同镜像地址，分次捕获list、matrix/软乘、state的局部窗口。多次捕获不是同一次全程序轨迹。raw波形、FIC、位流/程序SHA、触发/时钟/深度、完整UART、计时区和资源/时序配对归档；评分程序后续单独控制≥10秒/双种子/输出区间，不能把短程序直接改名正式成绩。
5. 本地PDS JTAG调试与远程手册所述PCIe DMA路径不能视为等价；远程若要求平台顶层/不同器件/引脚/时钟，必须先取得约束和接入说明，再定最小适配范围。第13页“烧录”没有明确SRAM/Flash目的地，须确认可限定易失性下载，不把按钮名称当授权。当前100H sbit绝不直接套200H。

## 分线推进与真实门槛

|工作|现在结论/负责|下一验收/停止条件|
|---|---|---|
|CPU/软件/位流|A保留F160/F163，无新ISA/编译需求|只有真实程序暴露缺陷才另定最小修复；不为等硬件新增细节任务|
|本地板|over_temp STOP；旧Pango咨询包已备，不重复索板图/下载器照片|必须有芯片规则/安全诊断及单独实体权限；本轮无新Pango回复，不能推断已外发/未回复或真实温度|
|远程/其他实验室板|A已确认文档级内部Debugger能力和公开门户壳；实际平台准入未定|由用户向指导老师/平台管理员人工确认下列四项；A负责分析答复与后续适配，不让用户设计信号|
|片上调试软件准备|A已收敛探针/容量/证据草案，未生成FIC/调试位流|设备/接入已明确后，另批新独立插核构建和校准范围；不动原13功能/固件，不自动PDS/GUI|
|B资源工具差额|沿D158 G1–G3，不重派核心，不替B重写，不作为A使用平台先决条件|反馈包按F161；新回执/ETA未知。原10/27 18窗口已经过去，不自动顺延或借此宣布新工具交付通过|
|报告/初赛包|A可并行复用真实证据，物理/正式分数/片上空缺明示|沿既核11/4 18:00截止；本轮不复核日期公告，不承诺取证一定完成或以文档补造缺口|

唯一需要人完成的最小动作：转发`deliveries/mainline-fpga-platform-check-2026-10-28-v1/PLATFORM_QUESTIONS.txt`给指导老师或平台管理员，获取**可用设备/约束、FIC/调试兼容与封装、UART/计时、正式安全入口/费用/时段**四项事实。主线已完成公开可独立检查；没有账号/当前库存和内部接入资料，不能自行推定兼容。无需发源码/位流、提供口令或操作本地硬件；咨询未代发。

下一推荐实施仅在适配条件明确后定案为“独立调试副本、必要非功能探针保留、单次插核构建及配对时序/资源/镜像核验”，**尚未授权/实施**；若只有不同器件/需要DMA功能，先说明代价和具体范围，不先开工。截止临近不解除任何安全/对外权限。
