minzhetang/pangu-riscv-soc/reports/progress/2026-10-27-b-offline-r1-dispatch.md

# B新任务：离线工具资源/失败守卫整改R1

2026-10-27（客户端日期），F158/D158。用户要求按当前进度派新任务。**先关闭已证实的工具护栏缺口，不继续添加外设/CPU/通用功能。** 已准备`deliveries/mainline-b-offline-r1-2026-10-27-v1/`，补充1.0.1、冻结ABI1.0.0不改，收到核验可开工；尚未代发，新B回执/容量/承诺未知。

## 当前证据与审收范围

原`队员成果接收/B-VERIFY-OFFLINE-M0-return-v01/`374文件/373SHA核同（共836432B），两个frozen文件与A合同输入同字节。已解析B结果37条PASS_LOCAL/P02合计9378498，但不是A全量独立复现。旧“尚未收到/回执未知”由收到v01文件及其回执取代；历史时刻/工时是B自述，未当A实测。

A仅在新独立副本执行4个小型CLI控制，人工预期先冻结，原v01及输入包不改：

|ID|预期|实测|结论|
|---|---|---|---|
|C0|默认8条完整MATCH/rc0|rc0、8条、fully_consumed=true|正控符合|
|C1|worker限额1B，超出不能MATCH，应LIMIT5|rc0/MATCH，实际parent测worker峰18755584B、自测峰21000192B|资源阈值未生效；无需实际大分配即可复现|
|C2|结果限256B，不写超限文件|rc7/TOOL_ERROR，但worker-result1372B、result2135B|有拒绝、无错误MATCH，但仍违反文件限额|
|C3|-O拒绝且不改受保护工具树|rc3正确，却在复制工具树创建目录/945B结果|错误路径保护顺序有缺口|

全部为普通可信现有Python执行B源码的**host控制**，不是新DUT/CPU/ISA重放/硬件。原件373SHA后核仍同。精确计划/结果/原stdout/stderr在`work/analysis/2026-10-27-b-offline-r1-dispatch/`；任务包带CASE、结果及移植式复现命令，未带私人机器/解释器账户路径。

## 最小任务与分工

B-VERIFY-OFFLINE-M0-R1：仅在自己的新return-v02中修RUN/src/测试入口，执行工作集/日志/结果配置限额、统一所有分支的输出保护和有界身份读取、同一总截止时间及真实父/worker rc判据。冻结比较/codec/原37输入和预期不动；回归37例加针对性新负例/真实runner控制、压力和搬目录。结果容量过小可rc5拒绝并不写结果，不能写超限fallback。CASE元数据1MiB/归档index2MiB前置检查；不把metadata身份哈希排除在期限外。无新ISA、采集格式、通用清树、安装或硬件。

这是有界质量收束，非接管B重写：A提供3已证反例与固定验收；B完成局部实现与真实证据后A审代码/独立复现。原37自测保留，不冒称所有比较行为错误；更不因收到包升级系统/硬件验收。

预计2–4净工时是A工作块估计，不是B承诺；B收到先回容量/ETA和10/27 18:00北京时间旧外设窗口冲突情况，不自行改窗。到点交真实完成/剩余，不降预期。目标返回`B-VERIFY-OFFLINE-M0-return-v02/`，源码/准确diff/原37不变SHA/新增冻结计划/原日志与真实rc/资源清理/压力移植/未完成/SHA齐备；无需重发65MB输入或重封外设v02。

A主线F157管道有限通过、1编译/1DUT已用完，下一只读采集开销/长跑预算；旧M1同步已核`bc051624`远端/干净（66项/487路径）。A不等B完整QA，不替其重写；F143稳定/F151校准/F146暂缓/F147告警及over_temp STOP保持，未启动任何新硬件或长测。
