minzhetang/pangu-riscv-soc/reports/progress/2026-10-26-b-stream-toolkit-assessment.md

# B流式验证工具包建议评估：收窄离线范围，不外包整条主线

2026-10-26，F155/D154。**原提案有价值，但范围过宽且部分重复。不推荐原样整包派发；推荐B承担独立的离线故障、压力及可移植复现验收包，A保留CPU参考语义、在线采集和最终集成。**这是评估/建议，没有批准新任务或合同、没有派发/外发、没有队员工期承诺；原A-M1仍PENDING。

## 1. 实际起点

|已核证据|真实状态|对分工的影响|
|---|---|---|
|F151 `check_coremark.py:84–106`|Stream.append已经逐笔比较EX/WB/MEM，finish拒绝多余尾事件；参考模型31/67/76/88行实际生成各类append|并非缺少流式逐笔比较；另写相同内核会重复并引入双实现漂移|
|同文件26/33/46/50行|UART samples逐物理拍增长，然后整列解码；F153算术下限约2.16GB/270M拍|通用比较库不能直接解决具体UART/稀疏MMIO适配的内存问题|
|F153 block_codec.py/SUMMARY|4MiB无损分块/索引已实现，四旧流392.5→64.6MB逐字节核同；原型单输入上限512MiB|不再另造压缩格式；边界/故障/压力复验仍有增量价值，不能宣称生产长流已就绪|
|A stage_coremark.py26行及B已有runner_common.py|已有有界执行、原生rc和日志截断/清树机制；B清树采用Windows Toolhelp|不从零重写进程管理，不把Windows实现冒称跨平台|
|两oracles/expected.json|EX/WB/MEM是count+digest；另有RF/RAM/report文件和计时/MMIO列表，逐笔架构期望仍由Reference运行时生成|“参考结果已冻结”不等于已有可直接发B的完整逐笔期望流；只交摘要不够支持逐笔核验|
|stage_coremark.py6–9行|仍引用多个历史工作目录，仿真构建还依赖PDS模型|拷贝当前脚本不能直接算独立目录可移植复现，需要A先提供最小离线适配入口|
|实际M1目录/状态|新M1目录不存在、SCOPE_STATUS明确PENDING；B v02已接收冻结，仅保留有界协助|目前没有正在实施的新管道可以直接转交；新B任务也未授权/接受|

12份实物SHA、代码锚点和oracle结构见`evidence/2026-10-26-b-stream-toolkit-assessment/ASSESSMENT_EVIDENCE.json`。本轮只读静态分析，0编译/仿真/ISA重放/压力测试，未修改任何上述源文件。

## 2. 能否缩短关键路径

**有条件节省A的离线工具开发/测试工时，但不能承诺缩短主要CPU仿真时间。**原方案的净收益取决于：实际交出去的A工作量，减去A冻结输入、适配、独立复验和返工成本。没有这些实测，不给节省百分比或“一天一定比A自己做快”的承诺。

F153双160次约11主机小时只是当前速度的条件估算。比较器再快也不会直接减少VVP模拟CPU所执行的拍；硬件停止、时基和ILA同样不是工具包能解决的事项。现有逐笔比较已经流式，重写比较内核的边际收益可能小于接入成本。

真正值得并行的是独立故障源、首错定位、EOF/关闭标记、截断/退出码、内存随规模增长、搬目录后误引旧BASE等检查。它能提高可信度，也能减少A事后追查，但需要一次主线独立复现。AI开发快不能替代语义冻结和验收。此前R1真实采样沿、R2事件/观察沿的差异说明，只定字段名而不定含义仍会反复修证；不应简单归咎B速度。

## 3. 推荐的一日独立任务候选

建议名称：**B-VERIFY-OFFLINE-M0：离线证据工具的独立对抗测试与复现验收包**。状态为建议、未派发、没有正式合同或截止承诺。

建议B负责：

1. 只读复用A冻结的分块读取/现有逐笔匹配内核，通过A提供的最小入口做离线CLI、首错诊断和独立目录复现，不另实现ISA/流水线/计时判据。
2. 在新目录或有界生成器中构造缺/多/重复/乱序、跨块首错、字段错、X/Z、半行/缺尾/缺关闭证据、索引/压缩损坏、过长行、超预算和假成功结果。合法重复WB/STORE不能去重；SHA只核身份，不能代替逐笔比较。
3. 输出错误类别、首错流/序号、期望/实际和有限邻域；日志/差异/运行有硬上限。提前结束、未完整消费或日志截断不能判成功。比较空流相等不能自动推出CPU正常完成。
4. 多档规模压力测试，报告真实读取字节/记录数/时间/峰值；不得把生成器逻辑偏移超过4GB当成实际4GB文件I/O验证。优先支持两端已有Windows/Python，不新增安装；未实测Linux/macOS不宣称通过。
5. 一次交源码、运行入口、冻结故障矩阵、原始日志、结果JSON、SHA/来源清单和局限说明。每项应可执行复现，不能只给RTL式的单文件、截图或PASS总数。

**A保留**：公共参考模型、架构期望生成、UART采样/计数/相位含义、DUT记录器/在线归档/背压/临时spool清理、CPU/系统验收及真实DUT权限。B不改CPU、参考模型、冻结预期或主线文件，不启动DUT/PDS/硬件，不重做进程清树，也不修改旧冻结包。

“约一天”应是A冻结输入且B确认接收/可用工时后的目标工作块，不是当前已经确认的工期。10月27日18:00仍是旧外设返回窗口，不能自动拿来约束这个新任务，也不因新建议顺延旧窗。

## 4. 一次交接是否足够

一次交接可覆盖**一个固定离线版本**，不足以保证未来格式永不变或零返工。派发前A至少一次备齐：

- 版本/SHA、字段宽度、周期含义、每类顺序、重复/X-Z/空流/跨块边界、EOF和完整关闭证据。EX不是退休PC，WB/MEM分流不能被B擅自拼成统一提交序列。
- 可直接运行的最小只读入口、路径参数、迭代器或既有append接口。不能让B从全项目历史目录里自行决定架构和拆依赖。
- 固定正负样本、人工预期、资源/日志/差异上限、错误分类和退出码；A另保留预先冻结的独立验收样本，不能按B实际结果回填期望。
- 逐笔参考来源：若比较真正架构期望，A须提供只读参考产出接口/适配器或预先导出的记录，不能只给count+digest。已验收DUT旧轨迹可作记录回归黄金样本，但必须标为“已验收轨迹重放”，不能冒充独立ISA参考或新CPU功能证明。
- 独立新输出目录、禁止覆盖/删除用户原件、既有工具清单与缺失时停止行为；不自动下载依赖。输入/结果显式UTF-8，纳入中文、空格路径，不能依赖机器默认编码。库校验不能因Python优化选项或异常处理变为放行，生产使用条件应由A冻结。

目前codec、四旧流和既有参考语义源可以提供；**独立生产比较入口、长测逐笔参考和M1新采集格式不能冒充已经准备好**。因此不能现在只发一句“按最新工程做”就期望B独立一天。

若想立即派出不依赖M1的部分，应只以**F153离线容器+既有已验收轨迹**为固定对象做故障/压力/移植验收；生产比较器适配仍在A，不让B等待未实施的新管道。该部分提高验证质量，但不声称直接修好2.16GB采样列表。

交接后用一次集中问题单、一次集中返回和一次A复验收敛；真实缺陷仍可能需要最小差额，不能承诺绝无评审/返工。发现协议缺口时B集中列出，不自行改格式/降标准。新格式由A版本化，旧结果不静默改写。

## 5. 并行、汇合和退路

- A-M1若获批，A推进在线采集、有界UART/MMIO适配、独立语义/全态判断及一次2迭代DUT对照，不等待B完成全部通用工具。
- B只有在新任务正式批准/接受后才开展离线质量包，当前没有新增实施授权。结果按材料、模块、主机复现、接口、系统、硬件六层验收。
- 若B延误/不兼容，不把整个主线停住；已有有限检查仍可用于既定短验证。不得在正式派给B后又在A平行重写同一套；需接管或改变承诺时集中说明，由负责人选择。
- 若A准备冻结接口的成本过高，替代任务就是审查现有F153容器，交独立故障语料和可复现问题，不再开发通用比较器。它更独立，能提前暴露工具失效，但属于质量支持线。

**结论：收窄后的离线质量包值得考虑，原版“流式验证+完整运行复现全包”不宜原样派发。**推荐保留A主线所有权、一次冻结小范围、B集中交付；不以给B安排一天本身衡量项目收益。若采纳，下一由A准备最小冻结入口与正式新范围，再确认新增B任务和可用工时。本轮未派发/外发、未建立任务包、未更改D152原scope SHA/PENDING状态，硬件STOP保持。
