minzhetang/pangu-riscv-soc/reports/progress/2026-10-26-b-v02-freeze-ack.md

# B v02回执与冻结身份确认

2026-10-26，F154/D153。用户报告B已知悉并确认F152/D151，随后只读核查实际收到的`队员成果接收/frozen-v02-20261026`：97文件、96条SHA全部核同；70份v02镜像、17份继承依赖、4份A接收回执与既有原件同字节。FREEZE_INDEX引用和记录SHA核同，精确清单见同级evidence的RESULT.json/inventory.json。

本次只检查冻结身份，复用同SHA的F152语义/仿真结论，0新构建/DUT/PDS/硬件，不将冻结当v03或新功能验收。14:30冻结时刻是B记录声明，未独立见证该动作。

B只保留冻结和按A具体有界问题协助，当前无需补交/开发/重跑/ZIP/v03。N1旧文案由A另注，W06/GPIO有限接收与旧根OPEN_PREEXISTING保持。10月27日18北京时间窗口不变。

当前“B回执未知”已由用户反馈取代；A下一A-COREMARK-STREAM-EVIDENCE-M1仍PENDING，协作回执不是该阶段批准，over_temp硬件STOP保持。未外发或建立后台任务。
