minzhetang/pangu-riscv-soc/snapshots/2026-11-03-submission/report/图表说明.md

# 图表与图片说明

正文使用18幅图、16张表。figures还保留可追溯原图和可编辑矢量PDF；不应把目录中的所有文件都当作正文编号。

| 文件 | 来源/生成方法 |
|---|---|
| `figures\01-system.png` | 本报告依据已核源码/结果绘制；说明性图表，依据SOURCE_DATA；非工具截图或实测波形 |
| `figures\02-pipeline.png` | 本报告依据已核源码/结果绘制；说明性图表，依据SOURCE_DATA；非工具截图或实测波形 |
| `figures\03-memory-phases.png` | 本报告依据已核源码/结果绘制；说明性图表，依据SOURCE_DATA；非工具截图或实测波形 |
| `figures\04-event-flow.png` | 本报告依据已核源码/结果绘制；说明性图表，依据SOURCE_DATA；非工具截图或实测波形 |
| `figures\05-cache-architecture.png` | 本报告依据已核源码/结果绘制；说明性图表，依据SOURCE_DATA；非工具截图或实测波形 |
| `figures\06-btb-control.png` | 本报告依据已核源码/结果绘制；说明性图表，依据SOURCE_DATA；非工具截图或实测波形 |
| `figures\07-ai-datapath.png` | 本报告依据已核源码/结果绘制；说明性图表，依据SOURCE_DATA；非工具截图或实测波形 |
| `figures\08-sm2-cycles.png` | 本报告依据已核源码/结果绘制；说明性图表，依据SOURCE_DATA；非工具截图或实测波形 |
| `figures\09-cache-tradeoff.png` | 本报告依据已核源码/结果绘制；说明性图表，依据SOURCE_DATA；非工具截图或实测波形 |
| `figures\10-btb-cycles.png` | 本报告依据已核源码/结果绘制；说明性图表，依据SOURCE_DATA；非工具截图或实测波形 |
| `figures\11-platform.jpg` | 实物图\板子\34C5BFA1610D91A5CB45FD70DDE63EC8.jpg；仅旋转90度/裁剪None，不改技术内容 |
| `figures\12-pds-debugger.png` | deliveries\video-editing-assets-for-B-2026-11-02-v1\02-images\native-gui\03-PDS-Debugger-O2-waveform.png；仅旋转0度/裁剪(0, 0, 1920, 845)，不改技术内容 |
| `figures\13-list-waveform.png` | work\fpga\2026-11-01-coremark256-ila-efficiency-m1\qualified-windows\list\list-waveform.png；原图逐字节复制 |
| `figures\13b-list-detail.png` | work\fpga\2026-11-01-coremark256-ila-efficiency-m1\qualified-windows\list\list-waveform.png；仅旋转0度/裁剪(0, 430, 2150, 770)，不改技术内容 |
| `figures\14-matrix-waveform.png` | work\fpga\2026-11-01-coremark256-ila-efficiency-m1\qualified-windows\matrix\matrix-waveform.png；原图逐字节复制 |
| `figures\15-state-waveform.png` | work\fpga\2026-11-01-coremark256-ila-efficiency-m1\qualified-windows\state\state-waveform.png；原图逐字节复制 |
| `figures\16-matrix_repeat-waveform.png` | work\fpga\2026-11-01-coremark256-ila-efficiency-m1\qualified-windows\matrix_repeat\matrix_repeat-waveform.png；原图逐字节复制 |
| `figures\17-normal-ui.png` | work\video-recording\2026-11-03-event-demo-v1\take-normal-r3\sscom-after-take.png；仅旋转0度/裁剪(0, 44, 1640, 700)，不改技术内容 |
| `figures\18-order-ui.png` | work\video-recording\2026-11-03-event-demo-v1\take-order\sscom-receive-original.txt；原始ASCII文本仅按空格换行排版，不是工具截图；旧截图实际为Codex前台，已排除 |
| `figures\19-timeout-ui.png` | work\video-recording\2026-11-03-event-demo-v1\take-timeout-r2\sscom-after-take.png；仅旋转0度/裁剪(0, 44, 1640, 700)，不改技术内容 |

三幅可读局部波形20-list-readable、21-matrix-readable、22-state-readable逐点取自既有真实FPGA WDF对应CSV，不是重新DUT/片上采样，也不是生成的假波形。原始值、窗口和文件身份见evidence/WAVE_FIGURE_DATA.json。图10是已保存WDF在Fabric Debugger离线重开的真实界面。

说明性系统图依据实际源码绘制；柱状图只重绘已核数据，数值与适用条件见报告及NUMERIC_RECHECK.json。照片仅旋转，真实界面仅裁剪，不补画输出。图15由真实原始ASCII串口文件换行排版，明确不是GUI截图。原始误截Codex图片没有作为证据图交付。
