minzhetang/pangu-riscv-soc/snapshots/2026-11-03-submission/report/成果—证据对应表.md

# 成果与证据对应表

本文档供提交前核对，不替代正式报告。E01–E21与报告参考文献对应；路径以项目根目录为基准，均为既有证据，本轮未产生新DUT/PDS/板级结果。

| 编号与成果 | 实现与适用版本 | 原始证据入口 | 可使用的结论 |
|---|---|---|---|
| E01 五级流水线与冒险 | `deliveries/accepted-basic-sm2-2026-11-02-v1/performance/pds/source/cpu.v`<br>SM2生产裸机EEI | `reports/verification/2026-10-24-memory-adapt-m1.md`<br>`work/quality/2026-11-01-basic-completion-m2/regression763` | 五级流水线、两相同步存储适配、前推和真实源load-use；有限回归，不等完整ISA认证 |
| E02 启动链接 | `deliveries/accepted-basic-sm2-2026-11-02-v1/performance/software/firmware/start.S`<br>SM2以及独立event | `deliveries/accepted-basic-sm2-2026-11-02-v1/performance/software/firmware/link.ld`<br>`reports/verification/2026-10-23-c-boot-m1-external-and-run.md` | 真实GCC RV32I/ILP32、data复制/BSS清零/8KiB栈；RF initial不是热复位清零 |
| E03 SoC外设与Timer64 | `deliveries/accepted-basic-sm2-2026-11-02-v1/performance/pds/source/soc_top.sv`<br>固定SYNC_MEMORY=1 | `deliveries/accepted-basic-sm2-2026-11-02-v1/performance/pds/source/soc_data_adapter.sv`<br>`deliveries/accepted-basic-sm2-2026-11-02-v1/performance/pds/source/local_regif_txgpio_m1.v`<br>`reports/verification/2026-10-24-timed-coremark-m1.md` | ROM32KiB/RAM32KiB、TX/GPIO及Timer64；RX仅独立核心 |
| E04 基础板级CoreMark | `deliveries/accepted-basic-sm2-2026-11-02-v1/performance/software/port/core_portme.c`<br>SM2性能256/验证256 | `reports/hardware/2026-11-02-sm2-dualseed-and-uart-closure.md`<br>`work/quality/2026-11-02-sm2-resume-m3/RESULTS.json` | 27MHz名义条件18.378963556/19.358269852秒；五CRC与重复输出通过；非EEMBC认证或独立校频 |
| E05 软乘优化 | `deliveries/accepted-basic-sm2-2026-11-02-v1/performance/software/firmware/mul_sm2.S`<br>SM2 vs同EEI旧软乘 | `work/quality/2026-11-01-basic-completion-m2/PERFORMANCE_PLAN.json`<br>`reports/hardware/2026-11-02-sm2-dualseed-and-uart-closure.md` | 同条件性能计算周期538539600→496232016，下降7.85598%，+60B、不增DRM；不是硬件乘法 |
| E06 主线资源勘误 | `work/quality/2026-11-01-basic-completion-m2/impl-sm2/build/place_route/board_top.prr`<br>SM2 PnR | `work/fpga/2026-11-03-event-recorder-m3/RESOURCE_PARSER_CORRECTION.json` | 1810LUT/1527FF/14.5 DRM36等效；旧整数14已被原表纠正 |
| E07 真实片上效率分析 | `work/fpga/2026-11-01-coremark256-ila-efficiency-m1/qualified-windows`<br>旧O2固定256调试版 | `reports/hardware/2026-11-01-coremark256-onchip-pipeline-efficiency.md`<br>`work/fpga/2026-11-01-coremark256-ila-efficiency-m1/BUBBLE_ACCOUNTING.json` | 4个不同140通道×1024点窗口，实际EX槽密度/14load-use/169控制冲刷；非退休IPC或SM2新窗口 |
| E08 复位同步可靠性 | `deliveries/accepted-basic-sm2-2026-11-02-v1/performance/pds/source/board_reset_sync.sv`<br>非调试可靠性版/旧调试观察版分开 | `reports/hardware/2026-11-01-basic-reliability-and-performance.md`<br>`work/quality/2026-11-01-basic-completion-m2/DEBUG_CDC_IO_DISPOSITION.json` | 显式同步级保留及窄域入口例外；旧调试4Critical保持有限观察限制 |
| E09 事件记录算法 | `work/application/2026-11-03-event-recorder-m2/firmware/app.c`<br>event M2/M3-M5板级 | `reports/application/2026-11-03-event-recorder-three-scenario-acceptance.md`<br>`reports/application/2026-11-03-event-recorder-m2-software-freeze.md` | 100ms/128样本、二样本滤波、8槽环形与故障后2事件；正常/顺序错/超时真实板级账本 |
| E10 应用量化比较 | `work/application/2026-11-03-event-recorder-m1/COMPARISON.json`<br>M1 12000tick/32样本软件同条件 | `reports/application/2026-11-03-event-recorder-and-independent-advanced.md` | 正常UART1216→256字符、记录载荷384→128B、处理3002→2722tick；不是当前板级dense对比或总CPU占用 |
| E11 应用实现 | `work/fpga/2026-11-03-event-recorder-m3/AUDIT_RESULT_v2.json`<br>1836B event固件 | `reports/application/2026-11-03-event-recorder-pds-build.md` | 1778LUT/1527FF/12.5DRM36，27MHz内部8组时序通过，非全IO/CDC签核 |
| E12 应用真实演示 | `work/video-recording/2026-11-03-event-demo-v1/take-normal-r3/sscom-after-take.png`<br>正常/超时真实SSCOM UI；顺序错误为真实串口原文 | `work/video-recording/2026-11-03-event-demo-v1/take-order/sscom-receive-original.txt`<br>`work/video-recording/2026-11-03-event-demo-v1/take-timeout-r2/sscom-after-take.png` | 三场景真实接收文本与正常/超时界面；顺序错误原截图为Codex前台已排除；手机视频用户报告完成，原片/终剪未审 |
| E13 BTB与精确控制修复 | `work/advanced/2026-11-03-mmode-vector-m3/source/cpu_hl4.v`<br>独立M1-M3，不替换生产 | `reports/verification/2026-11-03-btb-mmode-independent-candidate.md`<br>`reports/verification/2026-11-03-btb-ifstall-candidate-m2.md`<br>`reports/verification/2026-11-03-mmode-vector-m3.md` | 单次store消费/训练、目标异常归属、stall链接保留、有限M-mode向量IRQ及返回；非完整特权 |
| E14 候选真C与CoreMark | `work/advanced/2026-11-03-coremark-strict-m5/AUDIT.json`<br>M4/M5独立32项BTB | `reports/verification/2026-11-03-taskB-software-closure.md`<br>`reports/verification/2026-11-03-coremark-resource-no-board.md` | 真C逐笔和全态；CoreMark10次短测、24故障、46相关；32项周期降低17.7560%/18.2796% |
| E15 BTB资源时序 | `work/fpga/2026-11-03-advanced-btb-offline-m1`<br>同1迭代ROM 0/64/32项 | `reports/verification/2026-11-03-coremark-resource-no-board.md` | 32项11299LUT/5088FF/16DRM36，27MHz内部STA通过/估33.9006MHz，较64少611LUT/1888FF；未板测 |
| E16 长轨迹复用 | `work/analysis/2026-11-03-coremark-evidence-alternative-v1/r3/RESULTS.json`<br>M6 192次未完成前缀 | `reports/verification/2026-11-03-coremark-layered-evidence.md` | 每种子16252928事件逐笔前缀匹配；guard错误终止，绝非≥10秒候选通过 |
| E17 两路I/D Cache | `work/independent-extensions/2026-11-03-cache-ai-m0-7c92/CACHE_REPORT.md`<br>M0独立Cache | `work/independent-extensions/2026-11-03-cache-ai-m0-7c92/CACHE_COMPARISON.csv`<br>`reports/verification/2026-11-03-independent-cache-ai-reception.md` | I/D各128B、2way/4set/16B、write-through/no-write-allocate；局部性709→390、stream357→918 |
| E18 准入策略演进 | `work/independent-extensions/2026-11-03-cache-ai-m0-7c92/cache-m2-two-ghost/REPORT.md`<br>M1/M2独立，不默认启用 | `work/independent-extensions/2026-11-03-cache-ai-m0-7c92/cache-m1-admission/REPORT.md`<br>`work/independent-extensions/2026-11-03-cache-ai-m0-7c92/cache-m2-two-ghost/COMPARISON.csv`<br>`reports/reviews/2026-11-03-cache-ai-m0-m2-v1/GOLDEN_RECHECK.json` | 双ghost交替534→282、stream357；M0交替270仍快，twoword942等退化保留 |
| E19 定点FC | `work/independent-extensions/2026-11-03-cache-ai-m0-7c92/AI_REPORT.md`<br>独立16×8合成FC | `work/independent-extensions/2026-11-03-cache-ai-m0-7c92/AI_RESULTS.json`<br>`reports/verification/2026-11-03-independent-cache-ai-reception.md` | 128MAC、40bit整数累加、ties-away舍入/饱和、136/148拍；配置单列，无真实模型/识别率 |
| E20 流式严格验证 | `reports/verification/2026-10-26-coremark-stream-evidence-m1.md`<br>主线验证链 | `reports/verification/2026-11-03-coremark-resource-no-board.md`<br>`reports/verification/2026-11-03-coremark-layered-evidence.md` | 无损分段/逐笔有序/全态及独立计时、负向守卫；不将旧重放作新DUT |
| E21 成果归属 | `.project-memory/COLLABORATION.md`<br>用户确认主线及B来源 | `CONTRIBUTION.md`<br>`deliveries/task2-review-20261101-v01/mainline-adjudication-v1/MAINLINE_DECISION.md` | 主线由负责人Codex辅助；B外设/包装/自测/离线工具与原HL4另列，主线审查修复集成另列 |

## 本轮重新核对与纠正

- SM2布局布线报告的DRM36等效数为14.5，旧摘要曾将小数截断为14；正文按原报告纠正，不改写旧记录。
- take-order/sscom-after-take.png实际为Codex前台，不能用作串口截图。图15改为同目录已保存的真实ASCII接收文本排版，明确不是界面截图；原件不改。
- 新高阶候选使用自身M5短测和离线PDS证据；M6仅有两组完整前缀，不称整例或目标时间≥10秒通过。
- 已验基础SM2、旧O2片上分析、event应用和独立高阶分别对应固定版本。
