minzhetang/pangu-riscv-soc/snapshots/2026-11-03-submission/report/提交前需用户核实.md

# 提交前只需人工核实的事项

1. **作品名和网站字段一致**：报告题名为“面向设备故障回溯的 RISC-V 可编程事件记录终端”。请与报名/作品页面名称统一；正文按匿名模板未填写学校、老师、姓名。不是要求重新确认已记录的技术分工。
2. **最终实物照片**：报告已有真实开发板正面结构照。模板另要求作品全貌正面、斜45°照片；当前可核资料没有本作品最终完整接线工作台的这两张照片。需要补真实照片并据此替换/增补3.1，不能拿概念图或厂商宣传照替代。网站全貌1张、细节最多4张，各≤10MB。拍照本身不需要为本报告重新上电。
3. **视频终稿与原片**：三类应用片段已由用户报告拍完，手机原片未在本次可核文件中取得。本轮不宣称审过最终视频；提交前核对正常/错误/超时、串口与LED可读，MP4/H.264、≤3分钟、≤300MB，避免PPT式讲解。已有软件素材无需重录。
4. **声明与访问权限**：使用授权书需真实队伍编号、全体成员、年份、全员签名与日期，打印签名扫描PDF；获奖/指导教师项目等声明仅由本人核实。网站代码包和私有GitHub访问需按提交要求安排，不能假定评委能访问私有仓库。本轮没有更改可见性、打包源码或上传。

技术范围已在报告3.3.12与4.1集中说明，无需为了提交把独立Cache/AI写成已集成，把候选短测写成≥10秒，或把旧片上窗口写成SM2新采样。报告可先审阅，以上实物材料补齐前不应声称全部提交项已完备。
