minzhetang/pangu-riscv-soc/reports/progress/evidence/2026-10-25-increment-2335-alignment/READING_CHECKLIST_COMPLETED.md

# 2335主线阅读覆盖完成清单

原接收窗口清单不覆盖；79件逐项阅读/完整解析，哈希核对与功能结论分开。

|状态|相对接收根路径|字节|证据|
|---|---|---:|---|
|已完整解析|CHANGED_FILES.json|22307|READING_COVERAGE.json对应路径/分段/解析记录|
|已全文阅读|CHECK_PACKAGE_OPEN.md|405|READING_COVERAGE.json对应路径/分段/解析记录|
|已完整解析|delivery.json|3749|READING_COVERAGE.json对应路径/分段/解析记录|
|已完整解析|DEPENDENCIES.json|1464|READING_COVERAGE.json对应路径/分段/解析记录|
|已完整解析|DIFF.patch|215236|READING_COVERAGE.json对应路径/分段/解析记录|
|已完整解析|HISTORY_ALIASES.json|1424|READING_COVERAGE.json对应路径/分段/解析记录|
|已全文阅读|MAINLINE_ASKS.md|1911|READING_COVERAGE.json对应路径/分段/解析记录|
|已全文阅读|MECHANISM_COMMANDS.md|1969|READING_COVERAGE.json对应路径/分段/解析记录|
|已全文阅读|META_CORRECTIONS.md|948|READING_COVERAGE.json对应路径/分段/解析记录|
|已完整解析|MODULE_STATUS.json|2496|READING_COVERAGE.json对应路径/分段/解析记录|
|已全文阅读|README.md|4310|READING_COVERAGE.json对应路径/分段/解析记录|
|已完整解析|REMAINING_NET_HOURS.json|1399|READING_COVERAGE.json对应路径/分段/解析记录|
|已全文阅读|REVIEW_RESPONSE.md|2668|READING_COVERAGE.json对应路径/分段/解析记录|
|已完整解析|SHA256SUMS-INCREMENT.txt|8860|READING_COVERAGE.json对应路径/分段/解析记录|
|已完整解析|SOURCE_INDEX.json|5921|READING_COVERAGE.json对应路径/分段/解析记录|
|已全文阅读|SOURCE_INDEX.md|3978|READING_COVERAGE.json对应路径/分段/解析记录|
|已完整解析|history/regif-results-231958.json|19172|READING_COVERAGE.json对应路径/分段/解析记录|
|已完整解析|history/rx-results-232514.json|60063|READING_COVERAGE.json对应路径/分段/解析记录|
|已全文阅读|work/peripherals/docs/RUNNER-P0-20261024.md|3036|READING_COVERAGE.json对应路径/分段/解析记录|
|已全文阅读（完整分段）|work/peripherals/rx/CHANGELOG.md|8539|READING_COVERAGE.json对应路径/分段/解析记录|
|已完整解析|work/peripherals/rx/results.json|60063|READING_COVERAGE.json对应路径/分段/解析记录|
|已全文阅读（完整分段）|work/peripherals/rx/STATUS.md|8990|READING_COVERAGE.json对应路径/分段/解析记录|
|已全文阅读|work/peripherals/rx/docs/RX-LEDGER-1.3.3.md|2023|READING_COVERAGE.json对应路径/分段/解析记录|
|已全文阅读（完整分段）|work/peripherals/rx/scripts/run_rx.py|28865|READING_COVERAGE.json对应路径/分段/解析记录|
|已全文阅读|work/peripherals/rx/scripts/rx_status_selfcheck.py|2390|READING_COVERAGE.json对应路径/分段/解析记录|
|已全文阅读|work/peripherals/rx/tb/rx_public_capture.sv|2235|READING_COVERAGE.json对应路径/分段/解析记录|
|已全文阅读（完整分段）|work/peripherals/rx/tb/tb_uart_rx.sv|49904|READING_COVERAGE.json对应路径/分段/解析记录|
|已全文阅读（完整分段）|work/peripherals/rx/tb/tb_uart_rx_neg.sv|14430|READING_COVERAGE.json对应路径/分段/解析记录|
|已完整解析|work/peripherals/rx/tests/rx-plan-1.3.3.json|21387|READING_COVERAGE.json对应路径/分段/解析记录|
|已完整解析|work/peripherals/rx/tests/rx-plan-1.3.3.sha256|112|READING_COVERAGE.json对应路径/分段/解析记录|
|已完整解析|work/peripherals/rx/logs/rx-20261024-232514/compile_illegal.log|795|READING_COVERAGE.json对应路径/分段/解析记录|
|已完整解析|work/peripherals/rx/logs/rx-20261024-232514/compile_N16.log|860|READING_COVERAGE.json对应路径/分段/解析记录|
|已完整解析|work/peripherals/rx/logs/rx-20261024-232514/compile_N234.log|863|READING_COVERAGE.json对应路径/分段/解析记录|
|已完整解析|work/peripherals/rx/logs/rx-20261024-232514/compile_N8.log|857|READING_COVERAGE.json对应路径/分段/解析记录|
|已完整解析|work/peripherals/rx/logs/rx-20261024-232514/compile_neg.log|847|READING_COVERAGE.json对应路径/分段/解析记录|
|已完整解析|work/peripherals/rx/logs/rx-20261024-232514/compile_watchdog.log|821|READING_COVERAGE.json对应路径/分段/解析记录|
|已完整解析|work/peripherals/rx/logs/rx-20261024-232514/plan_check.log|1832|READING_COVERAGE.json对应路径/分段/解析记录|
|已完整解析|work/peripherals/rx/logs/rx-20261024-232514/run_illegal.log|785|READING_COVERAGE.json对应路径/分段/解析记录|
|已完整解析|work/peripherals/rx/logs/rx-20261024-232514/run_manifest.json|5261|READING_COVERAGE.json对应路径/分段/解析记录|
|已完整解析|work/peripherals/rx/logs/rx-20261024-232514/run_N16.log|55440|READING_COVERAGE.json对应路径/分段/解析记录|
|已完整解析|work/peripherals/rx/logs/rx-20261024-232514/run_N234.log|34905|READING_COVERAGE.json对应路径/分段/解析记录|
|已完整解析|work/peripherals/rx/logs/rx-20261024-232514/run_N8.log|46552|READING_COVERAGE.json对应路径/分段/解析记录|
|已完整解析|work/peripherals/rx/logs/rx-20261024-232514/run_neg.log|1390|READING_COVERAGE.json对应路径/分段/解析记录|
|已完整解析|work/peripherals/rx/logs/rx-20261024-232514/run_watchdog.log|811|READING_COVERAGE.json对应路径/分段/解析记录|
|已完整解析|work/peripherals/rx/logs/rx-20261024-232514/schema_validate.log|1174|READING_COVERAGE.json对应路径/分段/解析记录|
|已完整解析|work/peripherals/rx/logs/rx-20261024-232514/tool_iverilog.log|4092|READING_COVERAGE.json对应路径/分段/解析记录|
|已完整解析|work/peripherals/rx/logs/rx-20261024-232514/tool_python.log|694|READING_COVERAGE.json对应路径/分段/解析记录|
|已完整解析|work/peripherals/rx/logs/rx-20261024-232514/tool_vvp.log|1478|READING_COVERAGE.json对应路径/分段/解析记录|
|已完整解析|work/peripherals/rx/logs/rx-status-selfcheck-20261024-232527/summary.json|975|READING_COVERAGE.json对应路径/分段/解析记录|
|已完整解析|work/peripherals/rx/waves/rx-20261024-232514/uart_rx_N16.vcd|822316|READING_COVERAGE.json对应路径/分段/解析记录|
|已完整解析|work/peripherals/rx/waves/rx-20261024-232514/uart_rx_N234.vcd|8931739|READING_COVERAGE.json对应路径/分段/解析记录|
|已完整解析|work/peripherals/rx/waves/rx-20261024-232514/uart_rx_N8.vcd|371833|READING_COVERAGE.json对应路径/分段/解析记录|
|已全文阅读|work/regif/txgpio-m1/README.md|2579|READING_COVERAGE.json对应路径/分段/解析记录|
|已完整解析|work/regif/txgpio-m1/results.json|19172|READING_COVERAGE.json对应路径/分段/解析记录|
|已全文阅读|work/regif/txgpio-m1/docs/RUNBOOK.md|2698|READING_COVERAGE.json对应路径/分段/解析记录|
|已完整解析|work/regif/txgpio-m1/docs/SHA256SUMS.txt|10739|READING_COVERAGE.json对应路径/分段/解析记录|
|已全文阅读|work/regif/txgpio-m1/docs/W01-W10.md|3489|READING_COVERAGE.json对应路径/分段/解析记录|
|已全文阅读|work/regif/txgpio-m1/scripts/regif_capture_selfcheck.py|3084|READING_COVERAGE.json对应路径/分段/解析记录|
|已全文阅读|work/regif/txgpio-m1/scripts/regif_entry_selfcheck.py|6234|READING_COVERAGE.json对应路径/分段/解析记录|
|已全文阅读（完整分段）|work/regif/txgpio-m1/scripts/run_regif_m1.py|19240|READING_COVERAGE.json对应路径/分段/解析记录|
|已全文阅读|work/regif/txgpio-m1/tb/regif_tx_public_monitor.sv|2972|READING_COVERAGE.json对应路径/分段/解析记录|
|已全文阅读（完整分段）|work/regif/txgpio-m1/tb/tb_local_regif_txgpio_m1.sv|23194|READING_COVERAGE.json对应路径/分段/解析记录|
|已全文阅读|work/regif/txgpio-m1/tb/tb_regif_tx_capture_neg.sv|3496|READING_COVERAGE.json对应路径/分段/解析记录|
|已完整解析|work/regif/txgpio-m1/tests/w01-w10-plan-1.0.3.json|14202|READING_COVERAGE.json对应路径/分段/解析记录|
|已完整解析|work/regif/txgpio-m1/tests/w01-w10-plan-1.0.3.sha256|118|READING_COVERAGE.json对应路径/分段/解析记录|
|已完整解析|work/regif/txgpio-m1/logs/regif-capture-20261024-231843/compile_capture.log|838|READING_COVERAGE.json对应路径/分段/解析记录|
|已完整解析|work/regif/txgpio-m1/logs/regif-capture-20261024-231843/run_capture.log|1277|READING_COVERAGE.json对应路径/分段/解析记录|
|已完整解析|work/regif/txgpio-m1/logs/regif-capture-20261024-231843/summary.json|511|READING_COVERAGE.json对应路径/分段/解析记录|
|已完整解析|work/regif/txgpio-m1/logs/regif-entry-selfcheck-20261024-232004/summary.json|4138|READING_COVERAGE.json对应路径/分段/解析记录|
|已完整解析|work/regif/txgpio-m1/logs/regif-m1-20261024-231958/compile_N16.log|982|READING_COVERAGE.json对应路径/分段/解析记录|
|已完整解析|work/regif/txgpio-m1/logs/regif-m1-20261024-231958/compile_N234.log|984|READING_COVERAGE.json对应路径/分段/解析记录|
|已完整解析|work/regif/txgpio-m1/logs/regif-m1-20261024-231958/plan_check.log|1375|READING_COVERAGE.json对应路径/分段/解析记录|
|已完整解析|work/regif/txgpio-m1/logs/regif-m1-20261024-231958/run_N16.log|5181|READING_COVERAGE.json对应路径/分段/解析记录|
|已完整解析|work/regif/txgpio-m1/logs/regif-m1-20261024-231958/run_N234.log|3007|READING_COVERAGE.json对应路径/分段/解析记录|
|已完整解析|work/regif/txgpio-m1/logs/regif-m1-20261024-231958/tool_iverilog.log|4093|READING_COVERAGE.json对应路径/分段/解析记录|
|已完整解析|work/regif/txgpio-m1/logs/regif-m1-20261024-231958/tool_python.log|697|READING_COVERAGE.json对应路径/分段/解析记录|
|已完整解析|work/regif/txgpio-m1/logs/regif-m1-20261024-231958/tool_vvp.log|1479|READING_COVERAGE.json对应路径/分段/解析记录|
|已完整解析|work/regif/txgpio-m1/waves/regif-m1-20261024-231958/regif_m1_N16.vcd|130401|READING_COVERAGE.json对应路径/分段/解析记录|
|已完整解析|work/regif/txgpio-m1/waves/regif-m1-20261024-231958/regif_m1_N234.vcd|1918491|READING_COVERAGE.json对应路径/分段/解析记录|

8问逐项书面答复见主线报告§8及deliveries/mainline-increment-2335-response-2026-10-25-v1/TEAMMATE_REPLY.md。

未重复文件按dependencies/semantics继承定位；ZIP仅队员SHA声明，未独立核验；源目录无改动。
