minzhetang/pangu-riscv-soc/deliveries/competition-source-package-2026-11-03-v1/package/advanced/cache-ai/AI_REPORT.md

# AI 独立全连接算子结果（仅合成数据）

未移植真实训练模型。模型来源：无；权重/输入来源：本目录 reference_ai.py 确定性数学函数及人工边界值；无第三方模型使用许可依赖。
文件名检索未找到 .onnx/.tflite/.pt/.pth/.npz/.npy（排除 tools 和本交付目录）；未解包遍历归档、未宣称项目绝无真实模型。用户没有提供已核验合法模型，本轮按允许的合成算子分支完成。
这是具备配置、矩阵存储、128 次 MAC 调度、8 行输出和背压控制的 FC 原型；无 CPU 接入、激活/网络拼接、识别率、端到端 AI 系统或 CPU 加速比。

|用例|无背压/有背压周期|配置周期|量化前最大绝对误差|最终最大绝对误差|最终RMSE|饱和输出|
|---|---:|---:|---:|---:|---:|---:|
|non_grid_1|136/148|304|0.0398116301|0.0361495208|0.0173183255|0/8|
|non_grid_7|136/148|304|0.0164461785|0.0159578972|0.00844058423|0/8|
|non_grid_19|136/148|304|0.0186124557|0.0110440963|0.00714440981|0/8|
|zero|136/148|304|0|0|0|0/8|
|extrema|136/148|304|0|61.5175781|61.5087897|8/8|
|bias_limits|136/148|304|0|524349.5|524349.26|8/8|
|rounding|136/148|304|0|0.0078125|0.00769139844|0/8|
|saturation|136/148|304|0|0.015625|0.00913572131|3/8|

误差单位为实数输出值。non_grid 三组以未量化 float 输入、权重和 bias 的 Python 点积为参考；边界用例以精确可表示整数张量的实数点积为参考。大范围/极端 bias 的巨大误差来自规定的输出饱和，不作模型精度结论。
所有 raw40 与 Python 任意精度整数点积逐行精确相等，所有 int8 与独立 divmod 舍入/饱和预期相等。输出 16 组×8=128 项（含背压重复），另有协议复跑。
计算周期从 start 接受边沿到最后结果接受边沿；16 MAC+1 响应/行，无等待136拍，固定背压合计12拍后148拍。
配置152个握手，当前简单 TB 每项驱动占2拍，计304拍；这是驱动开销，不是硬件要求的最低配置时间。配置与计算合计440/452拍（不含 start 驱动间隔和复位）。
有符号 int8/64，bias/4096；raw40/4096。累加数学边界 [-2147743744,2147745791]，40位无溢出；输出最近舍入、半值远离零、限幅[-128,127]。
零、正负乘积、极值、±32/±96半值、饱和边界、int32 bias极限均覆盖。协议测试：非法配置无初始化效果、缺失初始化错误、忙时不接受配置/start、保留配置重复启动、MAC中/结果挂起复位、复位后必须重载。
负向控制把派生向量最后一个输出期望改1，得到 mismatch/exit1；原冻结材料不改。
原始日志 logs/ai_*，波形 ai_rounding.vcd、ai_reset.vcd；逐项实际输出见 AI_RESULTS.json；原始浮点和定点张量/预期 ai_vectors/cases.json。
