minzhetang/pangu-riscv-soc/deliveries/competition-source-package-2026-11-03-v1/package/advanced/cache-ai/CACHE_REPORT.md

# Cache 独立仿真结果

44 组配置全部通过独立字节内存及独立 Cache 行/LRU 事务预期检查。包含 I/D、缓存/直通、延迟 0/3；每次后端还叠加确定性命令及 beat 等待。
以下周期包含同一 TB 的请求驱动、响应消费、0..3 拍背压及固定收尾开销；不是 CPU 周期或物理时钟实测。延迟参数是每 beat 准备等待数，不是总内存延迟。
命中率分母为可缓存且合法的读请求；写命中不计入统计。无 Cache 命中率为 0。字节数仅为 payload：读 beat 每拍 4 B，写按有效字节；不计地址/控制总线开销。

|通道/序列|延迟|请求|无Cache→有Cache周期|周期变化|读命中|后端事务|传输B|
|---|---:|---:|---:|---:|---:|---:|---:|
|D/locality|0|64|519→342|-34.10%|60/64 (93.75%)|64→4|256→64|
|D/locality|3|64|709→390|-44.99%|60/64 (93.75%)|64→4|256→64|
|D/stream|0|32|264→534|+102.27%|0/32 (0.00%)|32→32|128→512|
|D/stream|3|32|357→918|+157.14%|0/32 (0.00%)|32→32|128→512|
|D/conflict|0|7|62→95|+53.23%|2/7 (28.57%)|7→5|28→80|
|D/conflict|3|7|80→155|+93.75%|2/7 (28.57%)|7→5|28→80|
|D/protocol|0|8|66→66|+0.00%|2/3 (66.67%)|7→5|28→32|
|D/protocol|3|8|85→91|+7.06%|2/3 (66.67%)|7→5|28→32|
|D/bytes|0|22|178→190|+6.74%|1/3 (33.33%)|21→20|54→74|
|D/bytes|3|22|236→268|+13.56%|1/3 (33.33%)|21→20|54→74|
|D/mixed|0|96|777→1353|+74.13%|0/64 (0.00%)|96→96|318→1086|
|D/mixed|3|96|1062→2166|+103.95%|0/64 (0.00%)|96→96|318→1086|
|I/locality|0|64|519→342|-34.10%|60/64 (93.75%)|64→4|256→64|
|I/locality|3|64|709→390|-44.99%|60/64 (93.75%)|64→4|256→64|
|I/stream|0|32|264→534|+102.27%|0/32 (0.00%)|32→32|128→512|
|I/stream|3|32|357→918|+157.14%|0/32 (0.00%)|32→32|128→512|
|I/conflict|0|7|62→95|+53.23%|2/7 (28.57%)|7→5|28→80|
|I/conflict|3|7|80→155|+93.75%|2/7 (28.57%)|7→5|28→80|
|I/protocol|0|8|63→63|+0.00%|2/3 (66.67%)|6→4|24→28|
|I/protocol|3|8|79→85|+7.59%|2/3 (66.67%)|6→4|24→28|
|D/lanes|0|65|519→591|+13.87%|16/33 (48.48%)|63→47|196→336|
|D/lanes|3|65|706→885|+25.35%|16/33 (48.48%)|63→47|196→336|

|检查|结果及证据|
|---|---|
|命中/缺失/冲突替换|locality/stream/conflict，全响应及 hit/事务/字节统计精确相等；conflict 的 A,B,A,C,B 区分 LRU 与 FIFO|
|字节写/零掩码/写缺失|bytes 原测试 + lanes 补测，16 种掩码每次写后立即读；命中与冷行写分别覆盖|
|等待与背压|两延迟和确定性命令/beat 停顿；每个响应 0..3 拍等待；逐拍检查响应与命令有效载荷稳定|
|相同请求/副作用/锁存|protocol 序列及 MODE2；valid 连续保持跨两次接收，阻塞期间不重复接收，MMIO 正好返回 0/1，修改已接受的输入不影响事务|
|复位|MODE1：填充中取消、响应挂起取消、已提交写后取消；无幽灵响应、计数复位、已提交写保留；I/D 并发分别得到独立内存结果|
|非法请求|非对齐读/I 写 error，后端无对应命令；无完整异常/总线错误协议|
|检查器负向|只改派生向量第一期望字，RTL 仿真 exit1 且 data mismatch；原预期 SHA 未变|

收益依访问序列而异。局部性有收益；stream 的每行仅用一个字仍取整行，读传输扩大 4 倍且周期增加；不接受“Cache 一定提速”。
原字节测试最后才读，可能掩盖中间 lane 错误，已以先冻结的独立补测收敛；原结果保留。没有修改原冻结计划/预期。
接口与限制见 cache_plan.md / INTERFACES.md；原始日志在 logs；逐项机器数据在 CACHE_RESULTS.json 和 CACHE_SUPPLEMENT_RESULTS.json。
