minzhetang/pangu-riscv-soc/deliveries/competition-source-package-2026-11-03-v1/package/application/event-recorder/A_REPORT.md

# A线事件记录应用：三场景有限板级验收与交付

2026-11-03，D320/F277。**固定应用第一版的正确性/正常与错误场景/量化说明/材料阶段完成；不是全部工业产品或FPGA长期稳定性验收。**

## 实际用途与真实执行链

低速设备动作异常时，需要知道“先错了哪个动作、等了多久、故障前后发生了什么”，而不只是看到报警灯。原型由未改SM2 CPU/SoC执行真正编译的裸机C，通过同步GPIO及timer读取状态，过滤、顺序/等待规则、RAM环形记录，批次完成后物理UART输出。KEY1/2/3明确模拟设备输入，没有部署到真实工业设备。

固定规则0→1→3→7→0，采样2700000目标tick/128次，WAIT20、2连续样本稳定过滤、8槽事件记录。首次故障后保留2条后续变化再冻结，之后变化显式拒绝；环满显式evicted，调度过载reason3冻结，不静默补采。采集中不打印，结束后导出，导出期间不采集。没有RX/中断/外部传感器/Flash日志。CPU、存储时序、外设接口及约束不因本轮补验而改。

## 三项板级验收

|场景及原始目录|全部有序E事件(index,state,reason)|关键结果|用户观察|
|---|---|---|---|
|正常 M4/capture-normal-r2|(63,1,0)、(76,3,0)、(94,7,0)、(104,0,0)|128样本、4事件、fault0/frozen0/rejected0/late0；292B|LED0/2/5/7常亮|
|顺序错误 M4/capture-order-r2|(24,2,1)、(36,0,1)、(64,1,0)|fault1、故障+2后文后frozen1、rejected1/late0；253B|LED0/7常亮|
|等待超时 M5/capture-timeout-r2|(22,1,0)、(42,1,2)、(48,0,1)、(74,1,0)|fault2、frozen1/rejected1/late0；292B|KEY0后LED6采集，最终明确确认LED0和LED7均亮|

新超时全部事件tick分别62100703、116100703、132300701、202500705。接受状态1到超时index差**20**，tick差**54000000**，按标称27MHz对应2秒；后两事件顺序和冻结检查通过。最终采集窗口345600100tick、处理8876tick、128样本完成。正常/顺序错误窗口分别345600102/345600100tick，处理8866/8480tick。均约12.800004秒标称换算，不是宿主墙钟，不冒已校准频率。

逐条原始UART而不是PASS摘要核对：REC2固定14字段、全部E数量/顺序/软件时间与采样index日程/原因/严格值、END和无额外文本、串口无错误；无去重。冻结后的rejected1实际报告保留，不能描述为无限连续无丢事件。板级无独立精确GPIO全边沿采样和内部全部WB/STORE/退休PC观测，不扩大声明。原RTL仿真完整输入/内存/副作用/串行TX解码/返回值检查沿原报告使用，不拿最终字符串替代这些检查。

## 配置、恢复和可重建性

M5同固定sbit/完整官方CRAM SVF一次易失性重载311.531秒成功；原始ID正确、配置后两次0x081ffca0/DONE1/DONE_I1/GOUTEN1，bit27照录，其余受检配置错误0。自动无人输入报告136B与M4逐字节一致：128样本345600098tick，work8214、fault/late/事件均0。

本次超时完成后再只读核验两次：仍**0x081ffca0，DONE/DONE_I/GOUTEN=1**，13.203秒、原生rc0、自有Job空无强清，未配置/改保护。这证明此次测试后的有限状态保持，**不关闭此前DONE0变化根因**。用户的连续供电报告和曾见读数变化同时保留，不能猜成误按PROG、断电、温控或CPU错误；POWER亮不等配置有效。

新增便携build_software入口已分别实际重建event/dense，与冻结程序bin逐字节同：1836B/2164B。event .bss196B、dense1220B，另各预留8KB栈，没有独立栈水位测试。89原件SHA复核保持，主CPU SHA60F02899…F272。ROM载荷绑定/1600INIT/27MHz内部8组0failing/97约束审计沿M3，1778LUT/1527FF/12.5DRM36；旧CoreMark SM2实际14.5DRM，不能跨程序当本轮优化收益。固定程序/sbit/SVF完整身份见覆盖表和清单。

## 量化收益：限定为同条件RTL对照

M1使用相同采样过程、输入、顺序与故障规则对比固定原始采样和事件上下文策略。正常场景：输出1216→256字符，减少78.95%；记录载荷384→128B，减少66.67%；采样处理段3002→2722tick，减少9.33%。每条事件/故障和相同观察范围核对，原始数据见M1_COMPARISON；共同审核RAM未混入产品载荷。没有把减少采样率或少做检测算成收益。

这些不是当前100ms板级dense对照测量，不能将当前normal292B与旧1216B跨配置直接算收益。忙轮询等待仍占CPU，不宣称总CPU占用下降；事件策略保留诊断上下文，不宣称可还原每个原始采样。M1最大已观察延迟18024.5tick属于12000tick周期及有限相位，不是当前板级全相位保证。100ms内脉冲可完全漏采、200ms内脉冲可能被2样本过滤；不以27MHz宣称高速采样。

## 所有失败与等待如实保留

- M4首normal实际1→3→1→0→3，与冻结正常预期不符；首order仅2→0，故障上下文未收齐。都仍为FAIL，不根据实际回填预期。
- M4首timeout/随后KEY0正控制均0B/全LED灭，工具明确停止；只读DONE/DONE_I/GOUTEN0。配置变化原因未知，不能说已经实测超时算法失败。
- M5首timeout窗口900秒到期0B，现场回执后到（LED6曾亮，后LED0亮），只证明现场观察，不能补造已关闭窗口的UART。D319/v1当时“未收回执”历史由此次迟到回执补充，不改旧TIME_LIMIT结果。
- M5新timeout-r2重新监听后真实复跑成功，才取得本次292B和明确LED0/7回执。没有重新下载，不拿迟到观察升级旧运行。

这些记录与成功一并随包，不把外层Python rc0、文件存在或哈希自洽当功能PASS。所有本轮所属配置/接收/诊断工具正常结束，Job空，无后台工作；当前仍供电为用户现态报告，不是软件保证有人看守。

## 推荐版本和仍未完成

推荐本固定event应用作为**低速、有限批次原型演示版**：保留未改SM2 CPU/SoC及当前ROM绑定，原D300 CoreMark基础恢复包继续独立保留，不合HL4。正常/顺序错误/等待超时三场景具备可信物理UART与LED证据；其他抖动、环绕、过载等沿有限软件验证，未冒称全部板级覆盖。

旧配置保持异常、全物理IO/CDC/MTBF、旧调试Critical、温度/晶振校准/接线未测边界仍开放；没有新应用ILA、真实工业传感器运行或工业认证，没有新增视频。后续唯一高价值工作是按DEMO_GUIDE录下同一版本三场景的板卡与真实串口同框素材，和本报告/代码包一起纳入提交；依赖实体拍摄，不伪造或用PPT片段替代。若再次配置状态异常，按既有证据有界诊断，不宣布长期稳定。

本轮没有新CPU功能、PDS重构、Flash/芯片保护/SCBV/供电跳线改变、B新派工或外发；D245待审仓库文档未借本轮自动提交推送。
