minzhetang/pangu-riscv-soc/deliveries/competition-source-package-2026-11-03-v1/package/evidence/reports/2026-11-03-event-recorder-and-independent-advanced.md

# 事件记录应用M1与独立高阶候选阶段报告

2026-11-03。D311/F270/F271。应用优先；本阶段没有PDS构建、GUI/服务器、JTAG、下载、串口硬件接收或电源操作。原D300有限验收及硬件风险记录保持，不把软件测试解除为硬件放行。

## 做成了什么

在未改动的已验SM2 CPU/SoC/外设RTL上，真正编译的裸机C程序通过GPIO MMIO获取TB驱动的数字状态，读取真实RTL计时器，执行两样本抖动过滤、动作顺序/超时检测、环形事件与故障前后上下文保存，再经原UART发送器输出。TB从串行引脚独立解码，不只看PASS文本；完整账本、时间戳、顺序、原始存储、复位重跑和main返回另行核对。

这是面向低速数字设备状态的**有限批次原型**，不是现场工业部署或连续高速采集产品。它解决“持续保存原始样本产生大量数据，而故障时缺少清晰前后事件”的原型问题。能保留事件变化及窗口，不能恢复被丢弃的全部原始采样波形。

基线恢复入口：`deliveries/accepted-basic-sm2-2026-11-02-v1/START_HERE.md`。其FINAL_MANIFEST逐项回核通过，沿用快照，不制造新的巨大复制。应用输入源与M0同SHA，未改生产CPU/SoC或公共冻结模型；仿真存储用M0独立同步数组模型，不是厂商DRM时序模型。

## 赛题原件复核

原文件：`题目/全国大学生嵌入式芯片与系统设计竞赛'2026FPGA赛道选题指南-紫光同创 (1).pdf`。

实际PDF第10页=印刷第8页：RV32I基础、不少于3级流水线、数据/控制冲突处理、UART/GPIO；高阶2为动态预测（如BTB）及完整RISC-V异常/中断。实际第11页=印刷第9页：实际应用场景、CoreMark/MHz、频率及资源效率、代码/约束/注释与ILA关键算法流水线分析；CoreMark运行不少于10秒。两页已渲染并视觉阅读，留在应用spec目录。应用不能替代原CoreMark/片上分析；有限BTB不能等同完整高阶2。该两页未明确高阶必做/免做，不擅自解释。

截止沿已有同赛事协办方公告记录2026-11-04 18:00（北京时间），来源入口 `deliveries/submission-video-2026-11-02-v1/SUBMISSION_CHECKLIST.md`；本轮未重新联网核查。当前已11月3日，不把剩余时间投入整套特权/MMU换核；先冻结可信应用软件证据与原作品，硬件应用另批。

## 输入、规则与验收

冻结计划先于DUT：初版6场景在FROZEN_PLAN.json，新增满窗口故障场景预先写入FROZEN_PLAN_v2.json，旧计划不改。每组32个外部GPIO状态，2个软件模式，每次TB完成两轮真实复位。GPIO输入不是宿主生成结果；Python只驱动/核对输入与期望，不执行替代CPU的应用。

|场景|预期关键结果|实际|
|---|---|---|
|normal|4次合法变化，无故障|两模式/两轮PASS|
|order_post|顺序错误1，保存触发与2后续，冻结，之后1次显式拒绝|PASS|
|timeout|状态1在第6个后续采样超时，reason2|PASS|
|bounce_reject|交替抖动不产生接受事件|PASS|
|bounce_boundary|连续两次刚好接受，单次不接受|PASS|
|ring_wrap|16次合法变化，8槽，evicted8，顺序保留最后8条|PASS|
|wrap_fault_window|13条插入，evicted5；最后5前+1触发+2后，冻结|PASS|

14个唯一场景/模式组，28份选用重复结果。续跑缓存缺陷导致部分组重复执行，不将重复调用增加为覆盖；详README的证据留存限制。每组使用同预期，不根据DUT回填。

检查内容：每个样本值对应实际GPIO load；每个timestamp对应RTL计时器实际load及目标采样窗；完整事件tick/index/state/reason与顺序；dense32组原始存储精确匹配；异常写错误/X拒绝；完整UART接受字符与引脚解码逐字一致、start/stop检查；main最后x10=0与EEI停止kind2；复位后两轮数据完全一致。检查器另有missing/duplicate/order/time/state五个负向变异，均拒绝，这是离线检查器自检，不计新DUT用例。

尚无全寄存器/所有访存的统一退休轨迹实机或仿真参考证明；局部寄存器/main返回与软件状态签名不能冒充完整ISA符合性。

## 量化与边界

两模式同采样间隔12000tick、同32样本输入口径、同过滤/诊断/故障上下文。dense在同事件引擎上额外保存并输出全部原始采样；不比较一个完全不做诊断的简化采样器。

正常场景：有效UART字符1216→256（少78.95%）；所有7场景约69.97%–90.57%。记录载荷容量384B（256B原始+128B同上下文）→128B（少66.67%）。两模式共同保留256B审核samples及其他工作数据，故**不是整个程序RAM或硬件资源降低66.67%**；示例程序尚未剥离审核仪器化。环形覆盖与冻结拒绝显式报告，事件摘要不保存所有原始样本。

正常处理段3002→2722目标tick（约9.33%）；该段不含等待/串口，且包含共同审计。不宣称整体CPU占用或CoreMark提速：两模式都忙轮询，观察窗约384k tick几乎不变。真实串口输出在采集结束后，导出期不继续监测，不能无条件持续运行。

同一输入变化到记录最大**18024.5目标tick**，从新VCD外部pins与reset时基回查；这是本批输入相位最大值，不是全相位穷尽。两样本抖动过滤+采样抖动的冻结检查预算≤25004tick。timestamp是软件观察时间；32位低计时未测试回绕。当前27MHz标称换算下采样间隔约0.444ms，批次约14.22ms；此仿真版本不是可直接让人按键操作的慢速演示程序，下一需冻结人可操作参数。

短于采样间隔的脉冲可能漏；未连续两次观察的变化会被过滤。过载处理限于8槽覆盖/冻结拒绝与deadline监视；没有生产级持续流控、中断或RX控制。32样本结束必须导出/停止，故障后没有新事件时不能保证补足2条上下文。

## 工具、错误与证据入口

实际版本日志：GCC xPack15.2.0，Icarus13.0 stable；无需安装/改PATH。编译/展开/仿真完整argv、rc、墙钟和超时位于应用COMMANDS.json/TOOL_VERSIONS.json；程序ELF/bin/8192字ROMhex、启动/链接、普通VCD、RAMdump和UART均为本阶段新产物。

原Icarus0xC0000005保留；等价观察信号/寄存器返回观察调整后成功，但同RTL冗余再编也异常，根因未定。两模式复用同一成功VVP，因为RTL/TB相同、ROM在运行时加载，不拿旧固件冒新运行。CRLF宿主检查错误与修正保留。续跑组织缺陷记录于README，后续新实现使用唯一目录，不能掩盖其历史波形留存不足。

工作目录 `work/application/2026-11-03-event-recorder-m1`，入口README、RESULTS、COMPARISON、CHECKER_CONTROLS、BASELINE_CHECK/FULL_BASELINE_RECHECK、APP_TB_DIFF、ARTIFACTS和SHA。必要原波形/读取日志留本地，体积约783MB，不复制到每份交付或上传。该规模也说明应继续采用有界局部采集而非无限扩测。

## 高阶线实际进展

`work/advanced/2026-11-03-hl4-precise-target-m0`：原B BTB模块12项检查编译/仿真通过；原HL4 CPU独立顶层展开rc0，但连接ROM/反例TB展开两次0xC0000005，DUT NOT_RUN。R2目标未对齐修复准确diff已保存，仅独立候选，**未验证/不采用**。

没有新动态证据证明CPU停顿训练、预测恢复、精确异常、中断有界响应正确；R1/R3和PMP/MMU/CSR缺口保持开放。没有新CoreMark预测收益、PDS、位流或实机结果。完整高阶2未完成，原生产CPU没有替换。没有给B派新工单或索取已有材料。

## 推荐下一阶段

唯一优先：应用M2软件定型——参数化人可操作的采样周期/批次与触发窗口，剥离审核数组后核实际RAM上限，保留同口径自动检查，形成可供后续PDS绑定的独立程序镜像。当前授权内可继续普通用户软件实施；PDS构建/新镜像下载/实体演示另集中申请，不消费旧额度。高阶只在应用冻结后继续连接TB工具隔离和原/修复反例，不堆叠未验证修复。
