minzhetang/pangu-riscv-soc/deliveries/competition-source-package-2026-11-03-v1/package/evidence/reports/2026-11-03-independent-cache-ai-reception.md

# 独立Cache/AI原型主线接收审查

2026-11-03；D331/F288。结论：**有条件接收为独立原型及有限仿真证据，不采用到生产CPU/SoC，不默认启用M1/M2。**

## 真实主线状态与范围

恢复时CURRENT/INDEX已是D330/F287：原M6长测因宿主守卫误计归档gzip退出，用户已采纳分层复用、不重跑方案。因此没有正在运行的M6需要中断或接管。本次不推定恢复长测，不更改该主线决定。0新DUT编译/仿真、0PDS、0硬件、0安装/外发/Git操作；只执行已审阅的三个离线审计及本机只读解析/金值重算。

## 阅读、完整性与审计

三份MAINLINE_HANDOFF、接口、报告、M2完整Cache RTL和FC RTL、TB、模拟后端、参考/冻结生成器、候选diff与运行器已核查。全目录1160文件逐SHA及文本解码，所有Python AST/JSON结构解析，13份SHA清单逐项校验且所有引用在交付根内；无符号/重解析链接。每项状态见INPUT_COVERAGE，自动文本解码不冒称人工逐行审阅全部历史副本。少数PLAN采用CP936编码，以该编码补读，原件不转换。

check_delivery.py无--replay，仅调用audit；M1/M2 audit无仿真/子进程入口。实际普通Python -X utf8 -B运行三者native rc0，输出与命令在COMMANDS和三份audit.log。根脚本的--replay会启动仿真，本轮没有调用；参考/冻结生成器也没有执行写入。

440份原始.log全部读取/提取指标及错误行，21份VCD完整事件解析：结构、时间单调、时钟/复位后握手计数；两份AI rounding波形逐笔核±32/±96等8输出，M2 adverse波形48请求/48响应及44命中一致。其余波形保留完整解析计数，协议语义仍依据TB审查和原日志，不称全部信号/全部边界的独立波形证明。全部交付文件审计前后SHA相同。

另用本审查独立字节数组按冻结输入重算M0/M1/M2向量全部响应金值，并用整数点积/舍入/饱和重算8组AI、64行金值，全部一致。没有重新生成或覆盖原预期，也不是新DUT。只读审计及旧波形重审不能升级成主线重新编译运行通过。

## 有限成果与真实取舍

|成果|收到并核定的原记录|量化结果及边界|
|---|---|---|
|M0 Cache|I/D各128B，2way/4set/16B行；44配置、复位/并发/held-valid/掩码补测/负向；原隔离recheck依赖同SHA|D locality delay3直通709→Cache390周期；stream却357→918，不能说总能加速|
|M1 admission|102配置、5协议及1预期数据错误拒绝；110进程原收据|stream918→357、pollution1296→522；两行交替270→534退化，因此默认ADMISSION=0保留|
|M2 two-ghost|184配置、4协议、数据和统计两类负向；16/16预冻性能门；193进程原收据|两行交替M1 534→M2 282，44/48命中、192→40B；stream仍357；相对M0交替270仍慢4.44%，局部性414仍慢于M0 390|
|AI FC|16×8，128 MAC，raw40/int8；8合成张量×2背压、配置/初始化/复位/负向原记录|start到末输出136/148周期；配置TB304周期单列；不构成真实模型/识别率或CPU加速比|

M2仍有three-line历史槽抖动、twoword942慢于M0 797及直通534等反例；不是通用最优。M2历史状态220逻辑bit/Cache，I+D440bit，比M1多224bit总量；不能当实际FF/LUT/频率/功耗报告。各阶段矩阵有继承与重叠，不简单相加冒充唯一覆盖量。

## 接收层次

|层级|结论|
|---|---|
|材料完整性|本机SHA/清单/引用/只读审计通过；原件未改|
|模块自身有限仿真|原日志、冻结金值、协议/负向与代表性波形支持，限定接收|
|本机复现|仅离线审计/金值重算/波形解析完成；新DUT重编/运行未执行|
|CPU/SoC接口兼容|尚不兼容直接接入，未批准适配|
|系统集成|未实施/未验收|
|综合与板级|均NOT_RUN；AI真实模型NOT_DONE|

## 主要集成风险和审计局限

1. **不可缓存译码不能照搬**：原型bit31=1旁路，而主线UART/timer等0x2000…地址bit31=0。直接接入会缓存状态/副作用读，存在陈旧值或重复/遗漏副作用风险。须按主线实际地址图独立定合同，并验证不推测MMIO、取指/数据访问权限及握手。
2. Cache前后端均blocking ready/valid，并要求后端正确按长度/顺序/rlast返回；无错误/超时恢复。当前CPU接口不能仅接线替代；须另批存储等待适配。阵列组合读未证明DRM映射、频率或时序。
3. I/D仿真是两份独立后端内存，不验证共享存储仲裁、一致性、自修改代码、DMA。cacheable/uncached别名写不snoop，bypass切换不失效，只能按合同统一reset；不能在系统里默认成立。复位要求后端协议一起取消，已提交写不回滚。
4. M1/M2参数在cache_m0有默认0，但子系统wrapper没有向外暴露策略参数，测试用defparam选择两实例。未来应经正式包装合同，不能把TB开关当生产配置接口。
5. AI合成FC无真实模型、网络/激活拼接或端到端任务，极值饱和误差不是识别率。cfg_ready/valid同步高有效reset与生产复位/软件控制并未适配。
6. 三个原审计依赖assert，必须普通Python，不可-O。计划/预期SHA一致支持冻结身份，单靠SHA不能独立证明历史冻结时间；原运行器有先核冻结再运行逻辑，源码到历史编译物的完整身份本轮未重新构建验证。原收据的Job关闭不等于已经独立证明全部子孙自然退出，不能夸大工具机制验收。

## 主线吸收决定

吸收源码、原始证据及上述取舍到独立候选档案，可在作品报告中写“独立Cache准入策略实验、合成FC算子有限验证”。不能写已接入CPU、已提升CoreMark、完整高阶1/3完成或真实AI模型移植。M0/M1/M2原件、默认参数及生产版不改，不新派B任务、不扩新策略。不自动进入CPU集成/综合/板测。后续若进入新实施阶段，最有价值的证据是代表性真实访问轨迹与实际资源代价；这是建议，非本轮新工单。

审查入口reports/reviews/2026-11-03-cache-ai-m0-m2-v1/RESULT.json、INPUT_COVERAGE、MANIFESTS、LOG_REVIEW、WAVE_REVIEW、GOLDEN_RECHECK、COMMANDS和SHA256SUMS。原件路径work/independent-extensions/2026-11-03-cache-ai-m0-7c92，根及M1/M2交接说明分别保持。
