minzhetang/pangu-riscv-soc/deliveries/competition-source-package-2026-11-03-v1/package/evidence/reports/2026-10-26-coremark-stream-evidence-m1.md

# 长测证据管道M1：有限验收通过，主机时间代价保留

2026-10-26，F157/D156–157。**保持13RTL和2迭代镜像不变，完成旧双种子等价重放、1次编译、1次新DUT及端到端严格核验。** CPU没有提速或增加ISA。它打通了“真实CPU运行→已关闭分段→无损回读归档→独立逐笔参考/全态/计时/实际串口→旧证据逐字节对照”；不是正式长测/硬件成绩。

## 实测与边界

|项|本次实际结果|
|---|---|
|旧性能/验证两种子|原严格结果除新增streaming统计外JSON逐字段一致，完整实际PIN时间线与字节解码PASS；各是旧记录重放，不计新DUT|
|模型/故障控制|N8/16/234逐拍旧模型与稀疏模型边界一致；管道15项（1正/14拒绝）、采集4拒绝、入口正常/-O/-OO三项符合预期；不计B通用套件|
|编译|1次，原生0，55.140秒；3类warning（继承时间单位、部分模块无时间单位、厂商grsn隐式线），路径归一后同F151：True|
|新DUT|仅performance-N234，2迭代，原生0，449.313秒，正常STOP/32拍尾，无第二次运行|
|架构/时序|全RF/32KiB RAM/每笔EX、WB、MEM/phase/独立计时PASS；物理5888943拍、stall173406、flush435221、计算4207378 ticks、crcfinal72be均同F151|
|真实UART/VCD|完整662字节、3838实际PIN变化；实际时间戳/中心采样及原生窗口VCD前后沿检查PASS。不是全算法VCD、退休PC或ILA|
|无损归档|142段（trace107/bus35），4602669条，194334829原始字节→31974737归档及元数据字节；回读后逐行/字节同旧，两者不是只比SHA|
|临时空间|峰值4102446B，<32MiB；142段仅关闭、回读逐字节和身份核同后逐文件删除，失败测试的超限文件保留；旧原始日志未删|
|内存|归档父进程峰值42344448B，VVP峰值60805120B，最终检查峰值229031936B；旧流重放峰值约252MB，均在本轮限制内|
|保护|208原件和50执行冻结输入SHA核同；13RTL、初始镜像、ISA模型不变；0GCC/PDS/硬件|

## 不能隐去的代价与限制

旧同输入DUT记录为320.390秒，本次449.313秒（观测比值1.4024）。主机负载未受控，不能据此断言全部增量由日志封装造成；但当前没有仿真加速证据，不能只报告压缩收益。CPU物理拍和计算量保持完全相同，归档不是CPU创新或性能提升。

去掉逐物理拍samples列表后，GPIO0空闲仅在活动/完成边界核实后跳步，实际PIN独立解码。仍保留有限MMIO观测、UART变化与归档元数据，并非整个工具恒定内存。当前512MiB raw/流、1024段/流、16M记录/流、5M ISA步和8M DUT拍是本短阶段硬限，**不能直接开160迭代或>4GB流**。正式长跑还需流总量/分页索引/参考预算与主机耗时安排，不得静默放大上限。

准备期保留3个非DUT错误：生成器检查误匹配新统计关键字、host_worker多余save导入在模型执行前失败、性能重放比较Python元组与已序列化JSON数组而失败。最后一项严格检查已PASS，保存JSON与旧JSON逐字段一致后单独资格核验，未为修脚本重跑该CPU或改预期；完整原始日志及checkpoint收据均留存。

## 证据与复现

主目录`work/fpga/2026-10-26-coremark-stream-evidence-m1/`：SUMMARY、SOURCE_RECEIPTS、APPROVAL、TEST_PLAN、compile/DUT-attempt、compile-result、frozen-live-inputs、COMMANDS、各logs/process/stdout/stderr；准确TB_DIFF、3份checker输入适配patch及audit_wave零差异证明。`runs/performance-N234/`含完整无损archive、全态、uart-pins、原生wave、check-result、strict-equality-result、UART/wave audits及capture-result；`replays/`明确旧重放，`controls/`真实拒绝/故障分列。

新源的关键变化只在采集TB、输入迭代和GPIO0/UART采样层。用`guarded_entry.py`作为正式调用边界；`-O/-OO`明确拒绝，不能直接以优化模式导入断言型内部库。本次实际命令均为非优化模式，入口负例未重跑DUT。

## 下一步技术排序

先依据这次实测做**只读采集开销归因和长跑资源预算**：分开VVP解释执行、分段归档、ISA检查和串口阶段；明确大流索引/记录总量、参考步数与可用主机时间。确认代价后再确定一项局部采集改进或正式长跑范围。新增TB改动/编译/DUT及数小时预算须另列范围，不能复用已用完的1+1许可，也不让B离线工具成为主线等待门槛。

B仍独立离线质量包，实际回执未确认，不重派核心。F143功能RTL稳定、F151校准保留、F146暂缓/F147告警，over_temp硬件STOP不变；软件通过不解除温度/供电/真实时基/片上波形缺口。

SHA256SUMS固定核对504份文件；SHA表本身及表后生成的postflight.json是独立收据，不进入自引用清单。

Git中的脱敏SUMMARY与原生进程数组见`reports/verification/evidence/2026-10-26-coremark-stream-evidence-m1/`；本地原始argv和完整载荷继续只读保留。
