minzhetang/pangu-riscv-soc/deliveries/competition-source-package-2026-11-03-v1/package/advanced/cache-ai/cache-m1-admission/REPORT.md

# Cache M1 可选准入策略：有限验证结果

102组序列配置、5项协议/复位测试及1项故意错误期望拒绝通过；共110个逐次低优先级有界编译/仿真进程。没有长压力测试、CPU集成、PDS、硬件或主线进程操作。
本轮在M0末级已测出的流式浪费上验证一个候选，没有改M0原件。单字冷读不取整行，同组再次读同一缺失行才填充。详情见PLAN.md。
**定案：仅保留为可选实验参数，ADMISSION默认0；不全局替代M0。** 流式与污染访问有收益，但常见冷启动及同组交替访问有退化。

|序列（0=D，1=I）|delay|无Cache/M0/M1周期|相对M0变化|无Cache/M0/M1字节|M0/M1事务|M0/M1命中（分母）|
|---|---:|---:|---:|---:|---:|---:|
|0_locality|0|519/342/354|+3.51%|256/64/80|4/8|60/56 (64)|
|0_locality|3|709/390/414|+6.15%|256/64/80|4/8|60/56 (64)|
|0_stream|0|264/534/264|-50.56%|128/512/128|32/32|0/0 (32)|
|0_stream|3|357/918/357|-61.11%|128/512/128|32/32|0/0 (32)|
|0_conflict|0|62/95/62|-34.74%|28/80/28|5/7|2/0 (7)|
|0_conflict|3|80/155/80|-48.39%|28/80/28|5/7|2/0 (7)|
|0_protocol|0|66/66/75|+13.64%|28/32/36|5/6|2/1 (3)|
|0_protocol|3|85/91/97|+6.59%|28/32/36|5/6|2/1 (3)|
|0_bytes|0|178/190/184|-3.16%|54/74/66|20/21|1/0 (3)|
|0_bytes|3|236/268/253|-5.60%|54/74/66|20/21|1/0 (3)|
|0_mixed|0|777/1353/777|-42.57%|318/1086/318|96/96|0/0 (64)|
|0_mixed|3|1062/2166/1062|-50.97%|318/1086/318|96/96|0/0 (64)|
|0_lanes|0|519/591/468|-20.81%|196/336/148|47/48|16/15 (33)|
|0_lanes|3|706/885/603|-31.86%|196/336/148|47/48|16/15 (33)|
|0_twoword|0|393/509/585|+14.93%|192/384/480|24/48|24/0 (48)|
|0_twoword|3|534/797/942|+18.19%|192/384/480|24/48|24/0 (48)|
|0_adverse|0|393/246/393|+59.76%|192/32/192|2/48|46/0 (48)|
|0_adverse|3|534/270/534|+97.78%|192/32/192|2/48|46/0 (48)|
|0_pollution|0|681/840/459|-45.36%|336/608/88|38/16|46/68 (84)|
|0_pollution|3|930/1296/522|-59.72%|336/608/88|38/16|46/68 (84)|
|1_locality|0|519/342/354|+3.51%|256/64/80|4/8|60/56 (64)|
|1_locality|3|709/390/414|+6.15%|256/64/80|4/8|60/56 (64)|
|1_stream|0|264/534/264|-50.56%|128/512/128|32/32|0/0 (32)|
|1_stream|3|357/918/357|-61.11%|128/512/128|32/32|0/0 (32)|
|1_conflict|0|62/95/62|-34.74%|28/80/28|5/7|2/0 (7)|
|1_conflict|3|80/155/80|-48.39%|28/80/28|5/7|2/0 (7)|
|1_protocol|0|63/63/70|+11.11%|24/28/32|4/5|2/1 (3)|
|1_protocol|3|79/85/90|+5.88%|24/28/32|4/5|2/1 (3)|
|1_twoword|0|393/509/585|+14.93%|192/384/480|24/48|24/0 (48)|
|1_twoword|3|534/797/942|+18.19%|192/384/480|24/48|24/0 (48)|
|1_adverse|0|393/246/393|+59.76%|192/32/192|2/48|46/0 (48)|
|1_adverse|3|534/270/534|+97.78%|192/32/192|2/48|46/0 (48)|
|1_pollution|0|681/840/459|-45.36%|336/608/88|38/16|46/68 (84)|
|1_pollution|3|930/1296/522|-59.72%|336/608/88|38/16|46/68 (84)|

周期包含相同驱动/背压/收尾开销，沿用M0定义；非CPU或板级实测。命中率用命中数除表中合法可缓存读数；字节只计payload。
stream单次逐行读：M1与无Cache流量相同；two-word每行仅读两字：首读旁路、次读才取整行，反而比M0多一个事务，应避免用于这类访问。
adverse同组A/B交替：单ghost槽反复被覆盖，始终不能准入；M0两路本能容纳两行。pollution热集穿插冷行：未复用冷行不驱逐热行，因此出现收益。
增加每Cache四组×(26bit tag+1valid)=108逻辑状态位，I+D共216位及比较/控制逻辑；未综合，不能换算成实际FF/LUT或频率代价。
准确性：所有读值/错误来自独立字节内存；单独的list+ghost参考决定命中及后端统计，冻结在RTL实现前。旧bytes与逐次lanes均回归，覆盖写穿透、16掩码、写缺失/零掩码、MMIO、非对齐和I写错误。
新MODE3：首次single、ghost复位清除、第二次4beat填充、随后命中、填充中复位不安装残行；继承MODE1/2验证已提交写保持、I/D并发及held-valid副作用。
测试夹具在运行前发现MODE1固定绝对事务数不适配候选，另存execution_tb.sv改为相对事务数等待。原冻结TB/预期未改，说明和独立SHA见PRE_RUN_CORRECTION.md。
candidate.sv的ADMISSION=0是缺省M0路径，本轮baseline从原M0源码编译；新参数1通过TB显式defparam开启。未新增CPU接口或指令。
资源限制沿用复制的run.py：20秒、256MiB/进程、384MiB/Job，挂起创建后加入Job再恢复；64MiB目录/1MiB日志为20ms采样守卫，不是文件系统硬配额。
本轮停止于一个策略的定向比较，不继续堆叠更多准入/预取/替换算法；AI仍为M0合成算子，未新增真实模型证据。
