minzhetang/pangu-riscv-soc/deliveries/competition-source-package-2026-11-03-v1/package/advanced/cache-ai/cache-m2-two-ghost/REPORT.md

# Cache M2：两项ghost历史的有限优化结果

已完成一轮候选，不改M0/M1原件。184组轨迹配置、4项协议/复位、数据与统计两类负向检查均通过，预冻性能门16/16满足。193个有界编译/仿真进程逐个执行。
M2每组保留两个未准入行tag，以FIFO替换历史；命中任一历史时才整行填充。M1只有一个tag，同组A/B交替会相互覆盖，M2可保留二者。容量/行大小/写策略/请求与响应/不可缓存区域均沿用M0。

**结论：在本矩阵中修复M1两行交替退化并保留流式收益；仍为可选独立原型，不全局默认替换M0。**

|通道/序列（0=D,1=I）|延迟|直通/M0/M1/M2周期|M2相对M1|M0/M1/M2字节|M0/M1/M2事务|M0/M1/M2读命中数（分母）|
|---|---:|---:|---:|---:|---:|---:|
|0_adverse|0|393/246/393/255|-35.11%|32/192/40|2/48/4|46/0/44 (48)|
|0_adverse|3|534/270/534/282|-47.19%|32/192/40|2/48/4|46/0/44 (48)|
|0_bytes|0|178/190/184/184|+0.00%|74/66/66|20/21/21|1/0/0 (3)|
|0_bytes|3|236/268/253/253|+0.00%|74/66/66|20/21/21|1/0/0 (3)|
|0_conflict|0|62/95/62/87|+40.32%|80/28/64|5/7/7|2/0/0 (7)|
|0_conflict|3|80/155/80/132|+65.00%|80/28/64|5/7/7|2/0/0 (7)|
|0_fifo|0|111/171/111/141|+27.03%|144/52/100|9/13/13|4/0/0 (13)|
|0_fifo|3|147/279/147/214|+45.58%|144/52/100|9/13/13|4/0/0 (13)|
|0_lanes|0|519/591/468/468|+0.00%|336/148/148|47/48/48|16/15/15 (33)|
|0_lanes|3|706/885/603/603|+0.00%|336/148/148|47/48/48|16/15/15 (33)|
|0_locality|0|519/342/354/354|+0.00%|64/80/80|4/8/8|60/56/56 (64)|
|0_locality|3|709/390/414/414|+0.00%|64/80/80|4/8/8|60/56/56 (64)|
|0_mixed|0|777/1353/777/777|+0.00%|1086/318/318|96/96/96|0/0/0 (64)|
|0_mixed|3|1062/2166/1062/1062|+0.00%|1086/318/318|96/96/96|0/0/0 (64)|
|0_pollution|0|681/840/459/459|+0.00%|608/88/88|38/16/16|46/68/68 (84)|
|0_pollution|3|930/1296/522/522|+0.00%|608/88/88|38/16/16|46/68/68 (84)|
|0_protocol|0|66/66/75/75|+0.00%|32/36/36|5/6/6|2/1/1 (3)|
|0_protocol|3|85/91/97/97|+0.00%|32/36/36|5/6/6|2/1/1 (3)|
|0_seeded|0|519/474/495/495|+0.00%|174/210/206|30/39/38|34/25/26 (42)|
|0_seeded|3|709/631/681/669|-1.76%|174/210/206|30/39/38|34/25/26 (42)|
|0_stream|0|264/534/264/264|+0.00%|512/128/128|32/32/32|0/0/0 (32)|
|0_stream|3|357/918/357/357|+0.00%|512/128/128|32/32/32|0/0/0 (32)|
|0_triple|0|393/798/393/393|+0.00%|768/192/192|48/48/48|0/0/0 (48)|
|0_triple|3|534/1374/534/534|+0.00%|768/192/192|48/48/48|0/0/0 (48)|
|0_twoword|0|393/509/585/585|+0.00%|384/480/480|24/48/48|24/0/0 (48)|
|0_twoword|3|534/797/942/942|+0.00%|384/480/480|24/48/48|24/0/0 (48)|
|1_adverse|0|393/246/393/255|-35.11%|32/192/40|2/48/4|46/0/44 (48)|
|1_adverse|3|534/270/534/282|-47.19%|32/192/40|2/48/4|46/0/44 (48)|
|1_conflict|0|62/95/62/87|+40.32%|80/28/64|5/7/7|2/0/0 (7)|
|1_conflict|3|80/155/80/132|+65.00%|80/28/64|5/7/7|2/0/0 (7)|
|1_fifo|0|111/171/111/141|+27.03%|144/52/100|9/13/13|4/0/0 (13)|
|1_fifo|3|147/279/147/214|+45.58%|144/52/100|9/13/13|4/0/0 (13)|
|1_locality|0|519/342/354/354|+0.00%|64/80/80|4/8/8|60/56/56 (64)|
|1_locality|3|709/390/414/414|+0.00%|64/80/80|4/8/8|60/56/56 (64)|
|1_pollution|0|681/840/459/459|+0.00%|608/88/88|38/16/16|46/68/68 (84)|
|1_pollution|3|930/1296/522/522|+0.00%|608/88/88|38/16/16|46/68/68 (84)|
|1_protocol|0|63/63/70/70|+0.00%|28/32/32|4/5/5|2/1/1 (3)|
|1_protocol|3|79/85/90/90|+0.00%|28/32/32|4/5/5|2/1/1 (3)|
|1_seeded|0|519/390/420/417|-0.71%|128/164/160|8/17/16|56/47/48 (64)|
|1_seeded|3|709/486/540/534|-1.11%|128/164/160|8/17/16|56/47/48 (64)|
|1_stream|0|264/534/264/264|+0.00%|512/128/128|32/32/32|0/0/0 (32)|
|1_stream|3|357/918/357/357|+0.00%|512/128/128|32/32/32|0/0/0 (32)|
|1_triple|0|393/798/393/393|+0.00%|768/192/192|48/48/48|0/0/0 (48)|
|1_triple|3|534/1374/534/534|+0.00%|768/192/192|48/48/48|0/0/0 (48)|
|1_twoword|0|393/509/585/585|+0.00%|384/480/480|24/48/48|24/0/0 (48)|
|1_twoword|3|534/797/942/942|+0.00%|384/480/480|24/48/48|24/0/0 (48)|

表中周期沿用相同TB，含请求驱动、逐笔0..3拍响应背压和固定收尾，不是CPU或板级周期。hit率=表内读命中数/合法可缓存读分母；旁路hit率为0。传输bytes仅payload，不含命令头。
延迟3的D两行交替：534→282拍，减少47.19%，44/48命中；较M0的270拍仍多4.44%，因为每行多一个首次单字事务。字节192→40B。
单次流式保持357拍/128B，与直通相同，M0为918拍/512B；污染序列保持522拍，M0为1296拍；局部性保持414拍，仍慢于M0的390拍。
剩余反例：每行只读两个字仍942拍，慢于M0的797和直通534拍；三行同组循环超出两个ghost槽，仍无命中，M2为534拍。未据局部改进声称通用最优。
状态成本：两ghost/组+FIFO共220逻辑bit/Cache、I+D440bit，比M1增加224bit总量；还有第二tag比较器及选择逻辑，未综合，不能视为实际FF/LUT或频率/功耗结论。
新增参数GHOST_TWO默认0，ADMISSION仍默认0。ADMISSION=1,GHOST_TWO=1才启用M2；两个参数通过本TB defparam设置。默认生产/CPU文件均未改，M0/M1分别用原源码新编译作公平对照。
正确性独立于准入参考：所有读值/error由独立字节数组oracle提供；list/FIFO历史oracle只计算hit/事务/bytes。不以同一RTL算法计算数据金值。旧17组序列原样继承，另增I/D三行循环、FIFO覆盖/重访和固定种子64笔读写序列，共23组×4策略×2延迟。
MODE1~4验证复位清双ghost、首次单读/再次填充/随后hit、填充中reset不安装残行、已提交写保留、I/D并发与持续valid副作用。reset同时作用缓存与后端，既有限制保留。
统计负向：真实M1执行同一adverse序列，所有读数据PASS但统计不符M2预期，检查器拒绝；原始log及NEGATIVE_STATS.json均保留。数据负向另将派生向量期望字破坏，实际exit1。
运行器沿用受限Job：挂起创建→加入Job→恢复，BELOW_NORMAL，20秒/进程、256MiB/进程、384MiB/Job；64MiB目录及1MiB日志为20ms采样守卫，非硬磁盘配额。无全局进程控制/主线读取接管。
本轮完成预定一次策略优化，停止扩算法。AI维持M0合成FC，真实模型/识别率/CPU集成/综合实现/板级验证均无新增证据。完整高阶1/3未宣称完成。
