minzhetang/pangu-riscv-soc/deliveries/competition-source-package-2026-11-03-v1/package/application/event-recorder/historical-reports/2026-11-03-event-recorder-board-partial.md

# 事件应用板级验收：正常与顺序错误通过，超时受配置现态阻塞

2026-11-03，D316/D317、F275。入口：`work/pds-jtag/2026-11-03-event-recorder-m4/RESUMED_STAGE_RESULT.json`。

## 实际执行

用户明确恢复，报告暂停期间12V一直未断、三线仍接通并可配合。普通用户只读枚举CP210x COM22正常、未见配置/串口工具竞争；没有新下载、PDS、RTL或程序改动。继续D314原固定应用，逐次独立接收/KEY0复位，115200/8N1、无流控；完整命令在各SERIAL/CAPTURE文件和`capture_case.py`/`capture_case_r2.py`。

|采集|结论|实际原始证据与限制|
|---|---|---|
|自动无人输入（原F274）|有限通过|128样本/345600098tick，136B，事件0/fault0/late0|
|normal首轮|FAIL，保留|331B，实际1→3→1→0→3，fault1/frozen1；用户LED0/7。与冻结正常序列不符，具体操作/输入链路原因未定|
|normal-r2|有限通过|292B，1→3→7→0，index63/76/94/104，全reason0，fault0/frozen0/rejected0/late0；用户LED0/2/5/7|
|order首轮|FAIL，保留|214B，仅2→0，reason1/1，fault1但frozen0；缺最后KEY1事件，不能算完整故障上下文验收|
|order-r2|有限通过|253B，2→0→1，index24/36/64，reason1/1/0，fault1/frozen1/rejected1/late0；用户LED0/7|
|timeout首轮|FAIL/未取得完整运行证据|0B、用户全LED灭；主动结束接收CONTROLLER_STOP，非进程超时，不能说已实测超时语义错误|
|timeout-r2目录内复位正控制|不计超时测试，未完成|只按KEY0，其余键不按；仍0B/全LED灭，主动结束，无DUT超时语义结论|

normal-r2窗口345600102tick、处理8866tick；order-r2窗口345600100tick、处理8480tick。名义27MHz换算均约12.800004秒，没有板载晶振校频。通过项全部事件tick与sample index日程逐条核对、完整报文/END、无UART错误、精确事件数量/顺序/原因和header/fault/frozen核对；没有去重。order-r2末尾拒绝1条与松键后的拒绝机制相符，但无独立GPIO全边沿捕获，不能声称穷尽外部输入。两轮失败未改预期后重判PASS。

各次接收均已退出且Job为空，无强制清理；成功接收rc0，两个空接收因控制器明确停止返回rc2，不能把外层脚本rc0当通过。第一轮normal-r2准备发生PowerShell引号解析错误及随后缺脚本，未执行硬件；改为明确文件生成后成功，记录在首normal USER_OBSERVATION，未据此改任何DUT预期。

## 当前关键阻塞

用户报告POWER亮、KEY0单独复位仍所有用户LED灭。随后新独立只读诊断`read_live_state.py`：器件链/ID PG2L100H/0x00602899匹配，两次状态**0x00180c80，DONE=0、DONE_I=0、GOUTEN=0、bit27=0**，其余受检配置错误位0；13.281秒正常退出、两个Job空无强清，没有文件分配或Program。这与前一次配置后的0x081ffca0不同。

只能确认当前配置状态不满足正常运行条件；不能仅凭此证明SRAM每一位被擦除，也不能确定是否误按PROG、瞬时供电、保护或其它原因。用户“12V一直未断”报告保留，与当前读数分别记载，不能改写成已查明断电，也不能归咎超时C程序或bit27。POWER亮不等配置有效，KEY0复位不能替代重新配置。原正常/顺序错误的真实报告不因后续异常失效，但不宣称平台长期稳定。

## 推荐最小下一步与门槛

准确方案见M4/NEXT_RELOAD_SCOPE.json：申请**额外一次同一固定镜像完整官方CRAM SVF易失性重载**，100kHz、Program600秒/控制器900秒守卫、先监听后配置/状态核验；先自动无人输入正控制，再只补超时场景与LED。若再次配置失效或读写错误，保留证据停止，不自动第二次重载。

原D314只批准1次，已消费；本轮恢复并非额外配置批准。当前方案未执行/未批准，不把prepare文件当权限。不改CPU/SoC、程序、预期、PDS、Flash、芯片保护、供电/SCBV或跳线。已有D300 SM2恢复快照及M3绑定保持，高阶候选仍独立。

## 作品与证据边界

现在确实已有真实CPU裸机C采集GPIO/计时、过滤、规则检测、故障上下文和物理UART导出的正常/顺序错误板级闭环，按键明确为模拟设备输入。不是工业部署、连续高速采样或完整ISA证明。本批没有应用ILA、完整内部WB/STORE或异常机制实机验收；128样本批次后停止采集并导出，忙轮询、不接RX/中断，事件时间是软件观察时刻。

量化对照沿F270/M1：相同仿真采样口径正常场景UART1216→256字符，事件记录载荷384→128B，处理段3002→2722tick；不是本批硬件对照测得收益，也不声称总CPU忙轮询占用下降。production event .bss196B、dense1220B/差1024B及额外8KB栈预留沿F272；物理RAM资源未因此按比例减少。当前normal实际串口292B，配置/协议不同于M1，不混用字节数。

全IO/CDC、旧调试Critical、校频/温度及原工具限制仍保留；新非调试应用12.5DRM36、1778LUT/1527FF沿F273实现报告，不借此关闭旧调试问题。本轮不新增B任务，不后台执行，D245待审文档未提交推送。
