minzhetang/pangu-riscv-soc/deliveries/competition-source-package-2026-11-03-v1/package/application/event-recorder/historical-reports/D319_A_CHECKPOINT.md

# 可编程事件记录与故障回溯原型：A线当前报告

2026-11-03 / D318–D319。最终当前分类：**SOFTWARE_AND_TWO_BOARD_SCENARIOS_READY_TIMEOUT_PENDING_USER**。

## 解决的问题与实际流程

低速设备动作按规定顺序进行，等待超时或顺序不对时，单个报警灯不能解释故障前后经历。原型用同一采样口径检测合法0→1→3→7→0、20样本等待、2样本稳定过滤，并在8槽环形RAM中保留有限故障上下文，首次故障后两条变化事件冻结；采集结束才输出，避免阻塞串口扰动采集。现用板载KEY1/2/3模拟设备状态，未接真实工业设备。

主线CPU/SoC/接口不改，真实C程序启动、读GPIO/timer、在RAM操作和物理UART发送，主机只解析输出。程序event1836B/.bss196B，dense对照2164B/.bss1220B；128样本、2700000tick周期、WAIT20。计时是目标timer不是宿主墙钟。名义27MHz对应12.8秒，没有独立校频。

## 当前证据分层

|层级|事实|边界|
|---|---|---|
|软件与RTL|M1同输入7场景×2模式，每组2复位；M2去审核数组后8组、过载、慢周期两样本、128形状三例通过|原始结果沿用，当前没有为了文档重跑全CPU回归；大历史波形未全部装入包|
|可重建性|本轮便携入口各实际编译一次event/dense，bin逐字节同冻结版本|没有因此改变ROM或新跑DUT|
|实现|原M3初始化、27MHz内部时序/97约束核验，1778LUT/1527FF/12.5DRM36|外部IO/CDC/旧调试Critical不由此全面签核|
|新重载|M5一次完整SVF311.531秒，ID正确、后DONE/DONE_I/GOUTEN1，配置错误项0，bit27=1照录|bit27不是实测温度，没有改芯片保护|
|自动完整批次|两次加载分别得到相同136B：128样本、345600098tick、work8214、late/fault/事件均0|仅无人输入，不代替全部人工场景|
|正常流程|M4-r2：1/3/7/0、index63/76/94/104、reason全0、fault/late/rejected0；292B，LED0/2/5/7|人工输入边沿无独立采样，不能断言绝对边沿精度|
|顺序错误|M4-r2：2/0/1、index24/36/64、reason1/1/0、fault1/frozen1/rejected1/late0；253B，LED0/7|有限故障上下文，不是全原始波形还原|
|超时板级|本次等待现场输入的接收窗口到期，0字节，尚未收到操作完成回执；超时板级仍未验收，不是已经证明超时程序失败。软件权限不能替代实体按键。|按冻结预期检查index差20、账本及冻结，缺证不接收|

正常窗口345600102tick、处理8866tick；错误窗口345600100tick、处理8480tick，处理段不含忙轮询等待和串口导出，不当整体CPU占用下降。主机检查全部E顺序/时间日程/数量/原因及完整REC2/END、传输错误和重复，无去重。没有新应用ILA或内部全WB/STORE实机轨迹。

## 量化对照及不能夸大的地方

相同M1仿真输入、采样口径和故障规则下，正常事件版相对固定采样对照：UART1216→256字符（减少78.95%），记录载荷384→128B（减少66.67%），处理段3002→2722tick（减少9.33%）。这是有限仿真对照，不是当前100ms/128样本板级已量到的收益；当前normal真实292B也不能与旧1216B跨配置直接算收益。更少事件表示保留诊断信息，不宣称仍可无损还原每个采样值。

busy wait仍占CPU、导出期停止监测；没有RX命令、中断、Flash留存或持续后台采集。M1最大已观察变化检测延迟18024.5tick属于其12000tick周期及有限相位，不冒称当前板级全相位最坏延迟。100ms短脉冲可漏采、两样本稳定过滤有明确限制。

## 失败、配置异常和当前未闭项

M4正常首轮实际1/3/1/0/3，与预期不符；顺序错误首轮只有2/0、不足冻结上下文；均保留FAIL，原因未唯一确定，未修改预期。随后timeout和只按KEY0正控制0B/全LED灭，POWER亮；只读ID正确但两次0x00180c80/DONE0/DONE_I0/GOUTEN0，配置状态为何变化未知。用户供电连续报告与工具读数同时保留，不能自行写成已断电、已误按或CPU超时程序已坏。

本轮同镜像恢复后自动报告通过，不能抹去此前异常或宣布长期稳定。本次等待现场输入的接收窗口到期，0字节，尚未收到操作完成回执；超时板级仍未验收，不是已经证明超时程序失败。软件权限不能替代实体按键。 接收的原生退出/显式停止/到期分别记录；不能以外层Python rc0或文件存在当成功。所有结束的自有Job空，无后台程序或隐含重试。

硬件温度/精确供电时刻/晶振校准未知；保护不改，不写Flash/改SCBV/供电跳线，不合HL4或继承其未验证收益。原SM2资源数字14.5DRM、应用12.5，原整数14/12误解析勘误在evidence/implementation，不回写旧冻结历史。

## 唯一下一项

当用户可在板旁操作时，先核当前供电/配置连续性，在全新只读接收窗口执行一次冻结超时序列并观察LED。已有正常/顺序错误无需重跑，不新增CPU功能或无限扩测。

本包是可检查材料交付；不替用户拍摄不存在的实体视频、不对外发送、不宣称比赛全部要求完成。
