minzhetang/pangu-riscv-soc/deliveries/competition-source-package-2026-11-03-v1/START_HERE.md

# 全项目代码总包交付入口

用于比赛“全部代码”附件的文件为：

**[pangu-riscv-soc-all-source-2026-11-03-v1.rar](pangu-riscv-soc-all-source-2026-11-03-v1.rar)**

- 真正RAR5，6,053,724字节（6.053724 MB），严格小于200,000,000字节。
- SHA-256：`2A8B11E52A86D87DC117DAF43451071CF2EF7C10D219E144AE37B74A243882BC`。
- 压缩包内仅有package目录，共8,745文件，展开124,093,673字节。高压缩率来自大量文本代码/冻结输入/参考结果，不是缺少源码。
- [完整SHA与体积记录](RELEASE_RESULT.json)、[归档SHA](ARCHIVE_SHA256.txt)。RAR及目录均保留本地，尚未上传。

## 评审从哪里开始

解包后读[package/START_HERE.md](package/START_HERE.md)，再看[成果覆盖表](package/PROJECT_MAP.md)、[分版表](package/VERSION_TABLE.md)和[复现入口](package/REPRODUCIBILITY.md)。

1. baseline/sm2：已验双种子256次CoreMark基础CPU/SoC、完整FPGA流程/约束、启动/链接/固件/ROM和TX/GPIO/Timer。
2. application/event-recorder：真正裸机C事件记录及正常/顺序错误/超时；抖动、环形窗口和原始采样对照，RTL输入、人工冻结预期、原始串口与检查器。
3. advanced：主线修复后的BTB/M-mode、真实C、严格CoreMark短测及三配置离线资源/STA；Cache M0/M1/M2与定点AI的独立源码、参考/向量/协议负向及量化结果。
4. baseline/o2-onchip及verification：真实片上四窗口、配置/分析脚本；763例冻结基础输入、模型/TB、系统存储、独立RX、外设包装、流式及离线验证工具。

各方向独立保存，未把旧实机证据转给BTB/Cache/AI。M6失败及有效前缀仍只作历史；本包不等候选CoreMark≥10秒完成、完整高阶任务或新硬件验收。

## 静态核验结果

- 复制输入8,725项，8,631个不同来源文件前后SHA不变。
- 8,532份副本逐字节等于原件；193份提交副本的文档/日志/链接map等元数据匿名化用户目录，原件不变。其中1份历史Python整理脚本仅其生成文档的路径文字匿名化，运行逻辑未改，见PROVENANCE。
- 8处ROM与固定bin绑定、12组核心身份、CoreMark六上游算法/许可、763例输入目录核对通过。
- 新入口相对链接、活动Tcl源/约束输入、直接RTL头文件检查通过；历史绝对路径和省略的大轨迹依赖已逐类说明，不宣称所有历史脚本开箱即用。
- 敏感凭据/用户标识（含二进制字符串）未命中；仅命中的“大学”是官方赛事文件标题。无专有模型、安装包、授权密钥或无必要大产物。
- RAR原生test退出0；成员列表与实际文件集合精确一致；独立目录解包后逐SHA/覆盖检查通过。

上述均是**材料与身份检查**。本轮没有编译、仿真、PDS构建、硬件操作、安装、上传、Git提交或推送。

## 依赖与上传前动作

代码、TB、冻结输入/预期、参考模型、启动/链接/移植层、选定固定镜像及合法CoreMark许可均已随包。[外部依赖表](package/dependencies/DEPENDENCIES.md)列明合法Icarus13、GCC15.2.0-1、PDS2022.2-SP6.4及厂商原语的取得要求；专有模型/工具不复制。RX未接主线，独立离线工具G1–G3限制保持。

本包已具备本轮代码附件的RAR格式、体积及静态材料条件；请用户审阅入口后手动上传RAR，**不要上传review目录或整个工作区**。技术报告、视频、照片和签名声明是另外的提交项，本代码包不替代它们，也不证明报名系统最终接收。

review目录是A本机内部溯源/静态检查/归档日志及解包回读副本，不在RAR中。首次归档参数把UTF-8清单错按UTF-16读取，未创建归档；已根据本机RAR手册纠正编码，原rc10保留。一次主机解析器编码拼写错误仅影响列单读取，修正后从既成归档继续核验，未重新生成或覆盖它。上述不是项目DUT失败。
