minzhetang/pangu-riscv-soc/deliveries/mainline-cold-readonly-2026-10-30-v1/EXECUTION_SCOPE.md

# 一次冷启动只读复验：A-COLD-READONLY-M0 /1.0.0

2026-10-30，D204。用户已明确项目进度优先、接受必要风险；主线采用一次有界复验推进诊断，不再以完全查明CFG27或拥有测温仪作为全部检查前置。不是温度/供电安全已证明，也不是无限硬件授权。**执行前仍须逐步完成实体状态确认；尚未上电或运行任何硬件工具。**

## 这一轮做什么

仅一次原装12V冷启动，在用户现场看守和随时可断电的条件下，用已安装PDS官方cdt_js/cdt_cfg_shell扫描一次链，TCK1MHz，读取公开器件ID及两次配置状态。两次状态读取间隔约5秒，记录实际时间。之后断连客户端/停止本轮服务器，用户先断12V再断下载器USB；不带电插拔JTAG。目标PG2L100H/公开ID00602899，封装和速度仍只来自既有板卡资料，不由ID独立证明。

不会分配或下载任何位流，不调用program/verify/readback/复位/寄存器写入/Flash/UID/eFuse命令，不安装/重装驱动、改许可证、SCBV、供电/跳线或温控。不开GUI，不用管理员权限，不联系外部。首次只读结束即停，不自动转LED或CPU下载。

**上电可能自动加载Flash中既有内容**；本轮不修改Flash不代表FPGA一定处于空闲或未配置状态。当前不保证启动内容或所有供电正常，这是风险取舍的一部分。

## 实体步骤与时限

1. 先由用户确认12V及下载器USB当前均断开；排线/开关先不动，若接线相对历史改变则先说明。此前Pin1/原装12V/D-ON与已纠正P-ON错误记录要复用，不重接或沿用旧错误建议。
2. 根据实际断电起点逐步核对JTAG现状，再给接USB与上电的单一步骤；不得同时让用户执行多项实体动作。原装电源不能确认、排线方向/连接有疑点或不便及时断电时，不进入上电步骤。
3. 上电步骤明确要求从12V接通起计时，第一轮暴露目标不超过60秒；这是操作限时，不是声称60秒内安全。到时无论聊天/脚本是否完成，用户先断12V再断USB，不等待软件指令。用户需要现场看守，出现异味/烟雾/异响/电源反复掉电或其它明显异常立即断电，不摸芯片判温。无测温条件无法监视结温变化，不能保证没有损坏风险。
4. 工具入口只在用户确认本轮已就绪后运行；一个客户端/至多一个本轮官方服务器，脚本整体45秒，单命令5秒（链扫描最多8秒），不盲扫重试。现有服务器/客户端或端口占用，先停本轮，不强杀他人进程或擅自借用未知服务。服务器/扫描及USB设备检查只属于这一轮就绪后的操作，未就绪不执行。

## 判断与结束

- bit27为0：仅记录此条件下未置位，不能宣布旧问题根因消失/温度或所有供电正常；保留与历史081efca0的对比、两次原始状态及CRC/DONE等字段。
- bit27为1：记录复现。第一份为1不盲目延长或继续5秒等待，结束客户端并让用户按结束步骤断电；不自行解除温控或换档重试。
- 读数不同：记录时间/其它位，作为状态依赖线索，不直接命名为锁存清除或软件误报。
- 身份不符、命令错误/超时、结果缺失或退出异常：停止，不下载/修驱动/追加扫描。
- 完成标准是取得或明确无法取得新的读数，不是必须得到0。诊断执行完成、现象是否复现、实际温度是否已知、是否可进一步运行分层报告。

风险取舍已获用户表达，不再反复要求“相信无过热”。仍保留一次一个实体步骤、工具权限单独核及阶段范围边界；用户当前唯一需要做的是确认断电起点。硬件工具尚未执行，不预写冷启动/标志0/实机通过。
