minzhetang/pangu-riscv-soc/deliveries/coordination-cancellation-2026-10-30-v1/CANCELLATION.md

# 撤销剩余B交接与主线接管

日期：2026-10-30（北京时间）。决定D198，来源：用户明确撤销B交接并要求剩余工作仅由本主线Codex完成。本说明为主线已生效决定及可转告文字，不是B回执；未代发，B实际获知/停止状态未知。

撤销PLATFORM-HANDOFF-1.0的后续B0–B4接手安排及其他剩余B派工，不再等待B0，不要求B继续开发、补证或封包。既有交付/限定验收/失败证据不撤销，完整技术交接包full-project-technical-handoff-2026-10-29-v01及所有原件/SHA保留，不删除或回写。若收到已完成但尚未转回的B资料，仅作已有成果安全接收核查，不自动重开任务。

余下技术工作由A主线Codex统一承担：CPU/SoC/软件、工具与平台诊断、安全恢复方案、实机与片上分析方案/结果分析、复验、优化、文档和最终整合。用户仅承担无法代做的实体动作、真实权限和人工沟通。换负责人不把未闭安全/工具问题变成已解决，不降低独立检查标准；可复用旧成果，不从零重写。

当前技术锚点：F181四C/四参考/双种子N2两短DUT/48主机控制；256未运行RTL或实机，无正式成绩。F163旧8非调试位流与R4调试候选分别保留。over_temp STOP、配置供电/SCBV、调试Critical及CDC边界不变。此决定不自动批准新构建/仿真/CPU修改、PDS/GUI/安装/驱动/系统或硬件，不重置用完预算。

## 可转告B及其Agent

项目负责人已决定取消此前发给B的剩余工作交接，余下工作统一由A主线承担。请停止按旧交接包新增开发、补证、封包或平台操作；无需继续等待/提交B0回执，也无需重做已交成果。请保留现有源码、原日志、波形和冻结包，不删除或修改历史。若已有尚未交回的完成内容，可一次告知现有位置/版本，勿为此新增执行。原有硬件停止条件保持。本通知不是对既有成果质量的否定，也不要求新增交付。
