minzhetang/pangu-riscv-soc/deliveries/mainline-fpga-implementability-scope-2026-10-24-v1/IMPLEMENTATION_SCOPE.md

# A-FPGA-IMPLEMENTABILITY-M0：生产存储与目标PDS实现预检范围

版本1.0.0；日期2026-10-24（北京时间）；**TECHNICALLY_DEFINED / IMPLEMENTATION_PENDING_APPROVAL**。本文件是可审批范围，不是已授权实施、综合通过或硬件放行。依据D124/D127，保持“真实闭环→证据分析→定向打磨→冻结交付”。

## 目的与已查前提

回答：F136已经执行真实C、GPIO/UART与短CoreMark的软件SoC，能否在PG2L100H-6IFBG676上形成有效的综合/映射/布局布线结果？真实存储资源和27MHz内部时序代价是什么？不再追加无关ISA细节，不以模型通过或32个仿真实例替代实现报告。

已验技术基线：`D:\A_FPGA_Comp\work\system\2026-10-24-timed-coremark-m1`，Git代码文档锚点b713ebd；权威summary为F136有限系统通过。最新B审收F139仅更新验证证据，包装/核心与F136同SHA，不需要队员新开发/批准。

本次只读准备核同11源、F136 postflight整组SHA，机械解码5个现有初始化表的完整ROM/RAM字节，与原632/632/812/15912/15920B程序和补零/A5初态相符。**0新编译/仿真/PDS，当前许可证未重新验证。**完整路径/SHA/证据在`D:\A_FPGA_Comp\reports\progress\evidence\2026-10-24-fpga-implementability-readiness\readiness.json`。

实际风险：

- `source/memory_model.sv`实例化官方primitive且数据口已有功能证据，但还包含仿真模型内部`.mem`的只读观察引用；观察赋值已有translate_off，不能据此断言已不兼容，也不能未经生产视图/工具检查就认定可综合。
- 公共source目录没有全局通用init_tables，5个程序在各`cases/<case>/source/init_tables.svh`分别冻结；必须选定对应镜像，不把一个镜像的结果配另一个初始化。
- 模型实例GTP_DRM18K_E1在本机Logos2 IPC模板有来源，目标资料以36K资源计量；最终primitive识别/映射、INIT保留和实际资源必须查PDS结果，不自行按仿真数换算。
- regfile含initial零化，bank/region寄存器含初值。冷启动初始化支持、复位及热重启不等价；本阶段核工具实际保留情况，不改CPU/RF或宣布任意热复位已验。

## 申请批准的唯一实施范围

授权后在`D:\A_FPGA_Comp\work\fpga\2026-10-24-implementability-m0`新建唯一目录，若已存在换唯一后缀。保留source-before、原镜像/旧测试/报告，复制前后SHA核同。

允许局部新增/修改：

1. **生产存储副本**：仅自有memory_model绑定/初始化生成与必要验证视图分离；保留32K ROM、32K RAM、两读ROM/字节RAM写、固定一拍响应、区域/bank配对、原INIT位值和两拍CPU时序。生产工程排除TB、层级模型观察、$fatal等仿真诊断；仿真侧可用明确条件宏/独立只读观察文件保留原全状态检查。官方仿真primitive只供现有Icarus验证，绝不当PDS设计源或随Git分发。
2. **A顶层与工程连接**：优先以F136 soc_top的逻辑接口和模块连接为实现顶层，新增最小工程包装只解决工具接入；保留外设地址20000000–ff、只读计时20000100/104、ROM/RAM地址图。CPU/ALU/control/regfile、B包装/TX/GPIO、计数器及路由功能不改。避免无实际输出而把整套CPU优化成空设计，核映射的关键层次/数据通路确实存在。
3. **PDS工程/Tcl/FDC**：使用现有PDS2022.2-SP6.4命令行，目标Logos2/PG2L100H/-6/FBG676；先解析、综合、dev_map，再pnr/report_timing。时钟沿用27MHz/37.037037ns。新目录运行，进程退出后再核本次新报告/数据库/日志，不以exit0或旧产物存在验收。
4. **必要验证/报告**：新增局部TB、运行器、初始化反解/功能差异检查及结果汇总；复用原输入/预期和可信Icarus绝对路径，不安装软件、不改PATH。冻结源、命令、预算后运行。新外部编译执行仍按固定批工具权限单独申请。

**命令行PDS解析/综合/映射/布局布线/时序执行属于本次申请内容；目前尚未执行。**已有安装不重装，不打开GUI/硬件工具；若命令行不可用而必须GUI、管理员或许可证修改，保留报错，先请求对应权限。

不允许：改CPU/ISA/流水线/前推/存储协议、改B接口/承诺、增加RX包装/FIFO/中断/Cache/预测器/M扩展、调整算法或正式计时策略、大重构、外发或专有模型复制；不改变SCBV/供电/跳线/温控。不生成位流，尤其不调用gen_bit_stream；不启动硬件服务器、不枚举设备/扫描JTAG、不上电/下载/Flash。

## 固定推进和验收关口

|关口|必要产出与通过标准|失败/停止条件|
|---|---|---|
|M0a生产视图/初始化|生产设计源无官方内部mem引用和TB；自有绑定的功能端口/primitive参数/INIT逐位一致；全容量与bank/byte写检查，原系统C N16/N234和计时C有限复验，核全状态及有序副作用|若需改CPU、原预期或接口，停并给最小诊断；不能为综合把初始化/检查删掉|
|M0b PDS综合/映射|目标器件确为指定版本，官方primitive无未解析黑盒；INIT/bank/lane连接有效，CPU/存储/UART/GPIO/计时功能未被整体剪除；取真实LUT/FF/DRM/IO资源及警告|不能识别GTP18K或需更换物理组织时先诊断，不顺手改成另一套36K/复制ROM；局部工具语法修正保留diff，不能掩盖功能变化|
|M0c布局布线/内部时序|真实pnr结束，27MHz内部寄存器路径setup/hold及最差路径、时钟/未约束项分开报告；资源/频率结论带设计/镜像/工具/约束/SHA|若27MHz不满足，报告实际负裕量/路径和最小建议，不降频凑PASS、不加虚假false path；禁止因PnR成功宣称板卡运行|
|M0d交付|脚本/源/初始化收据、原命令/退出/新日志、综合映射与pnr时序结果、SHA、差异与剩余风险；保留F136及本轮失败|阶段完成停止；下一优化/正式≥10秒/板级顶层/ILA/硬件均不自动开始|

验证按改动风险控制：CPU不变不重跑763旧ISA矩阵；若功能绑定和INIT逐位无变化，先跑上述三个C系统目标及存储单元，不因文档调整重跑长基准。若实际功能绑定改变，才补双参数CoreMark的原镜像有限回归；不修改输入/CRC/预期，不把旧结果记本轮运行。编译60–120s/目标、短系统运行45s/目标、必要CoreMark240s/目标，并同时设周期/日志上限；具体批次冻结后执行，首错诊断、不盲目重装/重试。PDS单次构建进程上限20分钟；等待期间保持进度更新，超时只处理本次明确拥有的进程，不影响其他工程。

## 时序/板级/成绩边界

本阶段是逻辑SoC可实现性预检，**不是已经确认全部板级IO的可下载顶层**。仅有来源的时钟/约束沿用；其他逻辑GPIO/停止诊断口可能未有板级引脚和外部时序约束，不凭空指定引脚/IO delay，不用false path隐藏。内部setup/hold与未约束外部IO分开；若工具缺Fmax有效报告，只报指定27MHz的真实裕量，不外推全系统最高频率。后续板级顶层要另核官方UART/LED/复位等实际接口，但不让当前映射调查无限等待该工作。

冷配置初态不等热复位清RAM；复位行为沿原基线保存，未支持的初始化必须暴露。当前SCBV High Voltage仍是工程决定，不借本阶段声明硬件电压正确。正式CoreMark≥10秒、真实FPGA时钟/运行、片上波形和创新收益都未因软件通过满足。over_temp停止条件继续有效。

## 分工、依赖和唯一用户动作

A承担存储生产视图/PDS/系统复验及报告；B按F139原验证整改和最终包收敛并行，不等待本批准，不新增B任务/返工/窗口承诺。现有包装源码、回执和接口已具备本阶段依赖，不索重复材料。

**推荐批准整个M0纯软件阶段**，一次覆盖上述局部生产存储/工程/必要TB及PDS命令行流程；阶段内普通取舍由A自主收敛，真实新权限仍按规则申请。理由：当前程序闭环已成立，继续增加软件用例不能证明目标资源和时序；先取得映射证据才能判断后续优化的频率/面积代价。未经批准不把笼统“继续”视为本范围/PDS门槛已解除。

可直接批准的表述：**“同意A-FPGA-IMPLEMENTABILITY-M0上述纯软件实施及PDS命令行综合、映射、布局布线、时序检查，不含位流生成或硬件操作。”**

## 官方依据及适用范围

- 安装内`D:\PDS\PDS_2022.2-SP6.4\doc\ADS_Synthesis_User_Guide.pdf` v2.2，实际119–120页/印刷118–119，§5.25：translate_off/on控制综合忽略段；119页已完整视觉核对。这不自动证明本工程所有仿真代码已安全排除。
- 安装内`D:\PDS\PDS_2022.2-SP6.4\doc\Pango_Design_Suite_User_Guide.pdf` v1.5，实际166页/印刷165命令行，250页/249表9-7/8/9目标/compile/dev_map，255页/254表9-14 report_timing（整页已视觉核）。示例含旧2021.3路径，执行参数以当前安装和已成功LED流程核对，不照抄旧版本路径。
- 已验LED只读脚本`D:\A_FPGA_Comp\work\pds-led\2026-10-11-scbv-high-build\build.tcl`证明本项目历史set_arch/综合映射/报告调用方式，不证明今天许可证或新SoC已通过；本阶段移除原脚本gen_bit_stream而不改其历史原件。
