minzhetang/pangu-riscv-soc/deliveries/mainline-increment-1735-response-2026-10-24-v1/TEAMMATE_REPLY.md

# 可直接转发B队员及其AI：1735审收与最后一轮最小收敛

1735 ZIP及全部73个文件已收到。主线逐项完成阅读/结构解析、继承来源核查及五配置原波形解析，并从源码新编译、新运行了包装N16/N234、RX N8/N16/N234和RX负测，共6个目标。编译无警告错误，5个功能波形的独立合同模型检查通过，RX92/110/68笔有序type/data吻合。**整体有条件接收；现有包装和TX/GPIO/RX核心保留，不重派核心开发。**这不是硬件或整包最终验收。A已有F134真实C→GPIO→UART和F136计时/双参数短CoreMark有限系统结果，本次未重跑或升级它们。

以下已接收、无需重复：包装/RX原批准与回执；新版包装缺/重复/错误标记拒绝与2正确+12负例材料；runner First/Next仅允许错误18、拒绝0/5的修正；W01真实请求及26=9+6+11计数、GPIO同值独立写；RX5e 0x44 DROP、A1/A1同沿替换、CANCEL读取真实后态；delivery新SHA纠正。旧F123 60.078/59.063秒失败继续留存。不要再按“未补DROP/同字节/未批准包装或RX”重做。

请现在直接推进下面一次性最小补项，均为原已批任务内的验证/交付整改，不改核心/包装RTL、接口或主线CPU。无需等待A的PDS或新系统阶段。

1. **P0，包装捕获与逐笔关联。**仅调整包装TB/必要共用monitor、runner和新计划。持续从公开uart_tx独立解码每一完整帧/复位取消，不用tx_ready回升替代完整帧，不用刺激任务更新的last_tx_byte填持续账本。现在两处posedge always之间edge_count有竞争：N16首请求日志edge8，实际第9沿，11/26条少1拍，N234有1/10条。固定唯一时基，记录time及沿前输入/真实核心接受。正式判定核seq/edge/addr/strobe/error/ready/accept和帧的关联，不只核9/6/11数量与数据列表；主线把首请求addr改fc、edge改999999仍被analyze_run接受。验收：原N16/N234有限场景保持、6完整+3取消、36请求逐字段可关联；同一正式捕获路径在无主动check_tx_frame时仍能发现额外/漏帧、错字节/坏stop、复位取消及重复/漏GPIO事件，有正确控制。保留已有标记负例，不再制造无关矩阵。

2. **P0，RX真实事件时刻、正式捕获负测及失败传播。**仅改RX验证侧/runner/新计划。统一用合同d/S与唯一时基，在同一事件沿分别取沿前与NBA后稳定公开状态；若还有较晚观察，另记时间，别混成一组pre/post。N16 5e S为第8081沿：实际pre_FE=1、post_FE=0，但新日志pre_FE仍0；仅pre_clear借上拍1，其余来自晚时刻。三配置消费记录均少标1沿，ACCEPT pre_valid/CONSUME post_valid也不是统一沿前后快照。CANCEL已改实测后态，无须再按“填常数”修；把它纳入统一时刻检查即可。负测应真正调用正式捕获实现，或提供可检查的等价证明；目前独立rx_public_capture与正式内嵌串行/延迟/复位捕获不同，共用末端比较宏不够。另修case_status吞overall=FAIL：主线传FAIL及带TEST_PASS的块，实际仍回PASS。总配置/逐行/入口必须一致拒绝非零rc、截断和全局失败。验收：保留92/110/68有序事件和既有功能结果；N8/N16/N234逐笔时刻/前后态可对照VCD，正式捕获路径漏/多/错序/错字节、同字节替换、DROP/CANCEL正负控制可检出；注入整体FAIL不得输出全PASS或入口0。

3. **P1，新计划与最终新包索引收敛，不回改旧包。**RX1.3.1 expected_by_config仍旧40/39、49/48、28/27；新实际应为41/41、50/50、29/29（valid/consume，OV/FE仍4/7）。按新场景手工预期升版冻结，去掉旧通用预算歧义，保留旧计划。RUNBOOK还留旧TB SHA/版号，W01–W10文档VCD字节数也旧；W06文字说已测ready回归沿写，但现程序只发忙内写，应如实标本阶段未覆盖或在原相关边界最小补证。原runner文档手工清理4.172s与该run原JSON4.141s不同，以原记录更正，不重跑。包装子清单过期PYC可从新交付排除；历史results命名别名已从0030同SHA原results解析到，不用重发旧结果。新最终包给自洽的入口/模块版本/SHA/依赖及别名映射，能从净目录定位所有源、include、工具路径参数、计划和原证据。旧根handoff manifest/source/link FAIL继续留历史，B不回写原基线；A负责主线导入映射和验收，B负责新交付自身组成索引。元数据-only不重跑DUT。

只交本次差额：准确diff/新旧SHA、新冻结计划、完整命令/原生rc/超时与截断记录、受影响有限运行日志/普通VCD/完整事件账本、results及未闭项。包装两配置、RX三配置及必要小负测足够，不重跑无关CPU、CoreMark或所有历史测试；先冻结手工预期，不按DUT回填，不改旧证据。若发现必须改核心、合同或扩大接口，先提交最小矛盾，由A评估真实范围，不自行扩大。

**现在做什么/等待谁：**B立即做以上验证和新包收敛，不等RX或包装重新开工批准；CPU/同步存储/计时/CoreMark/PDS准备/系统问题由A负责，B不用承担。RX包装、Timer、CPU/SoC或硬件均不新增授权。A收到后做必要差额复验；不能把A当前系统通过当你方整包最终通过，也不能让这些验证侧整改阻断A已通过系统的独立工作。

**10月27日18:00北京时间返回窗口不变。**已收到新增2.7h与剩余0.5–1h估计，不要求重复报全历史，也不把估计当承诺；只反馈本次尚余补项的新增净工时、是否冲突原窗和真实未完成项。不能自动要求在旧0.5–1h内吸收全部审查返工。若有冲突，原窗先交真实完成部分/未闭项，由A提出最小取舍、负责人决定，不自行延期、取消RX或降低验收。硬件继续STOPPED，无PDS/服务器/JTAG/上电/下载/Flash/SCBV/供电/温控操作。本回复供负责人转交，A未宣称自动发送或队员已收到。
