minzhetang/pangu-riscv-soc/deliveries/competition-source-package-2026-11-03-v1/package/THIRD_PARTY_NOTICES.md

# 来源、版权与团队贡献

项目主线CPU/SoC、存储与软件适配、验证、性能分析、优化、应用和FPGA集成由项目负责人在Codex辅助下完成。队员B提供UART TX/RX、GPIO、TX/GPIO包装、自测/离线工具及原高阶HL4候选；随后主线的审查、反例、修复与集成单独区分。独立Cache/AI原型由项目另一独立研究工作线形成。本包不估算贡献百分比，也不以Git提交署名替代原始来源。

CoreMark来自EEMBC，固定上游提交1f483d5b8316753a742cbf5590caf5bd0a4e4777；本项目未改变其核心算法，新增移植/启动/计时与输出。完整许可和CoreMark acceptable-use条款见dependencies/coremark/LICENSE.md，所有上游头部版权、商标与出处保留。基准非EEMBC认证，短测或候选前缀不宣传为正式成绩。

Pango工具、原语实现和板卡资料归各自权利人，专有模型/工具/许可证未随包；项目memory_model为自身绑定，不因引用GTP_DRM名称而把厂商原语实现重许可。Icarus日志中的Stephen Williams版权和公开作者邮箱是第三方归属，保留而不当成本队身份。

本次整理没有为项目新增整体开源许可，没有抹去第三方权利，也没有改变私有仓库可见性。本包用于用户授权的竞赛提交与技术评审/复现；本轮未外发上传。匿名化只针对本地用户目录名，不变更技术内容；详PROVENANCE。
