minzhetang/pangu-riscv-soc/snapshots/2026-11-01-paused-technical-review/checkpoint/CURRENT-before.md

# 当前阶段与入口

2026-11-01 D294：基础缺口/板级GPIO/调试约束/单热点性能/本地交付进行中。已独立冻结47条当前已验O2输入证据，入口deliveries/accepted-basic-snapshot-2026-11-01-v1/START_HERE.md。用户确认供电/下载器/UART仍接通、可配合；尚无本阶段新硬件。

新独立CPU候选仅接入原EEI对齐fatal：12例×两模式24新PASS，旧14FAIL/2TIMEOUT/8控制PASS；原763冻结全回归PASS。主机CRLF分类错误保留后离线纠正，非重跑。当前准备同27MHz两版程序/实现，板级采集未就绪，不按键。

入口work/quality/2026-11-01-basic-completion-m2/PLAN.json、eei-alignment/RESULTS_ADJUDICATED.json、regression763/RESULTS.json、PERFORMANCE_PLAN.json；后续先查新ATTEMPT/RESULT。原F253/F254稳定版本保持，候选不当已验；芯片保护/Flash/SCBV供电跳线不改，bit27照录，D245本地文档不提交推送。完整WORKING_POLICY。
