minzhetang/pangu-riscv-soc/snapshots/2026-11-01-paused-technical-review/checkpoint/RESUME.md

# 中断恢复入口：2026-11-01 D295

用户要求暂停。本轮仅检查原件、进程与落盘，无新测试、构建或硬件操作。

- 启动按AGENTS完整读取规则和CURRENT，再读CHECKPOINT与EVIDENCE_SHA256。等用户明确恢复并核实际连接，不能用旧回执推断当前供电。
- 原已验O2基线：deliveries/accepted-basic-snapshot-2026-11-01-v1/START_HERE.md。新EEI候选24定向及原763冻结回归通过，原失败/预期不变。
- H66四键输入/RAM/80乘法通过；H67用户视觉确认复位全灭、八灯顺序亮、末态A5（0/2/5/7亮）。H67未重做四键的TIMEOUT保留。
- H69首次候选五CRC/496232016周期通过：18.378963556标称秒，相对538539600降7.85598%，程序+60B，同27MHz、LUT1810/FF1527/DRM36 14不增加。尚未最终采用。
- H70接收总窗截断；H70-r1完整报告同周期、四键完整，但ErrorReceived含Overrun。原因未定，不能认定主机误报或无异常重复通过。原件保留。下一先诊断采集端缓冲/错误与时间记录，再决定有界复验，不盲目重下载。
- 验证种子新镜像PDS与1856 INIT审计完成，27MHz八组0failing，SHA见CHECKPOINT；尚未导出新SVF或上板，H71/H72不存在。解决采集异常后才按剩余额度推进。
- 旧ATTEMPT/按键窗口全部失效，无后台监听。未新确认断电/温度；不造已关闭/安全事实。bit27照录，不改保护/Flash/SCBV。D245文档保持本地，不提交推送。
- 最终报告/代码包/演示材料仍未完成。旧调试4Critical及CDC/外部IO限定不因非调试版0Critical而豁免。

补充：用户随后报告“已断电”，见POWER_OFF_RECEIPT.json。此前未确认断电仅为当时状态；USB/JTAG拔除未确认。易失性配置不视为仍驻留，下次恢复须重新核连接和加载状态，项目继续暂停。
