minzhetang/pangu-riscv-soc/work/analysis/2026-10-26-coremark-longrun-evidence-m0/COMMANDS.md

# 实际命令与执行范围

工作目录：D:/A_FPGA_Comp；工具为既有Python，无安装/PATH修改。

```powershell
& 'C:\Users\tamii\.cache\codex-runtimes\codex-primary-runtime\dependencies\python\python.exe' -B 'D:\A_FPGA_Comp\work\analysis\2026-10-26-coremark-longrun-evidence-m0\run_audit.py'
```

本命令主机处理旧四流12.75s结束，原生rc0；SUMMARY保存各encode/逐字节校验时长、峰值、完整原SHA/索引SHA。CODEC_SELFTEST为host容器完整性，INDEX_BOUND_CHECK为追加的读取前索引限制控制，均非新CPU测试。两原子命令只Python；0GCC/Icarus/vvp/ISA重放/PDS/硬件。

未来SCOPE_STATUS为PENDING；NEXT_IMPLEMENTATION_SCOPE不是可直接执行的指令或授权。gzip有效载荷/受控损坏副本保留本地，原始来源不删。
