minzhetang/pangu-riscv-soc/work/analysis/2026-10-26-coremark-longrun-evidence-m0/NEXT_IMPLEMENTATION_SCOPE.md

# 下一实施范围：A-COREMARK-STREAM-EVIDENCE-M1（提案，待批准）

2026-10-26，依据F153/D152。此文件是具体范围，不是已经实施、已批准或长跑就绪结论。

## 目标与固定输入

在独立`work/fpga/2026-10-26-coremark-stream-evidence-m1`（若存在则唯一新名）解决长测的证据采集/检查内存瓶颈，实际验证一次与F151相同的性能种子2迭代程序。保持F143/F151完整13RTL、官方六算法、两C端口/启动/链接、同O2/seed4=2镜像、27MHz名义时钟、N234、GPIO0和已有所有功能/相位/停止/未知值守卫不变。旧源码、TB、模型、输入、预期和产物不覆盖。候选F146不使用，不重新GCC构建。

## 仅修改新副本

1. 新TB只改trace/bus记录的封装与文件轮转，公开原记录字段/沿前沿后语义、顺序、重复次数和连续uart-pins原始证据不变；每个关闭段<=32768记录且逐行<=256B（<=8MiB），关闭后才发布带类别/连续序号/计数的就绪事件。原生普通VCD窗口保留，不启用压缩VCD。不改CPU/外设/存储或测试程序。
2. 主机监督器只接收本轮已关闭临时spool段，分块gzip后逐字节回读、核SHA/条数与连续索引并固定清单。仅允许在上述核验成功后清理**本轮新建且位于本轮独立spool内的临时原始段**，保留其无损gzip与索引；每个目标解析绝对路径核在spool内，不递归删除、不动任何旧源/旧日志/原包。失败/未验证段保留，运行判FAIL；原始信息不能靠丢段减量。
3. 新检查器按块迭代，不把全日志/所有物理拍装入列表。UART用实际连续PIN变化独立解码，取代`samples`按时钟增长；MMIO/前后计数逐记录检查、计时/相位/BSS/停止/全RF/RAM/有序EX-WB-MEM逐笔比较均保留，不去重、不只比最终digest。验证所需ISA模型不改语义/5M步预算；只有数据输入迭代器/有证明的固定GPIO0空闲跳步可改。空闲跨越须先和原ContractModel按拍运行做边界控制，不能跳过活动UART或ready返回沿。
4. 所有新主机代码、记录格式、段解析及负例在新目录保存；源码/TB/模型前后SHA、准确diff、来源、命令、原生rc、普通VCD/完整串口与输出保持。

## 验收顺序与硬上限

- 先重放F151两种子现有完整原流，逐字节还原，检查全态、逐笔流/计时/串口，与旧结果一致；这是host复验，不计新DUT。缺/多/乱序/重复/错字节、缺WB/多STORE、X/Z、错误phase/停止、索引/内容损坏、超预算都应拒绝。不得把候选codec完整性当CPU功能通过。
- 固定GPIO0的空闲模型控制覆盖N8/16/234和活动/空闲/完成边界，且原ready完成沿旧值、下一沿新值不变。任何不等价先停止，不改RTL/降低预期。
- 再固定**1次非管理员Icarus编译**（外部工具审批另核，120s，失败即停），**1次普通vvp性能种子2迭代**，8M拍/600主机秒。不重跑763例或验证种子DUT。新输出全RF/RAM/逐笔流摘要及计数/物理拍/stall/flush/raw4207378/CRC72be/全部662字节和实际pin时刻必须同F151，逐笔合法流仍独立比较；正常停止尾32拍无副作用。
- 原生VCD256MiB、stdout/stderr各8MiB、未归档spool32MiB（到界即FAIL）、本短例无损归档总256MiB、主机功能检查512MiB工作集/600s及参考5M步/600s。记录真实峰值与吞吐；异常/锁文件/归档落后/杀进程不算成功。不得根据实际结果回填预期。
- 只批准上述**2迭代管道验证**，不批准160迭代或>=10秒DUT长测；正式长跑另以实际管道资源及预先冻结参考决定。prototype现每输入512MiB上限不能直接用于>4GB整文件，生产清单/流式总量上限必须显式设计，不能静默放到无限。

## 权限、依赖与停止条件

这是对新TB记录管道/功能检查器/本轮临时spool生命周期的新增实施范围，须一次明确批准；其后普通技术细节自主处理，不逐项询问。无GUI/管理员/安装/许可证/系统环境修改；外部编译仍单独工具核准。B v02可接收且TX/GPIO/包装与F151同SHA，B无需新任务/再次索包；RX REGIF与SoC接收不在范围。

本阶段若保持全部副作用检查不能满足预算，保存诊断并停止，不通过减少工作量、修改CPU或强行放大上限凑通。工具失败、功能不等价、必须修改13RTL/程序/已批接口、超出上述运行次数或硬件门槛均停止。over_temp STOP、F146暂缓/F147告警保持；不PDS/服务器/设备/JTAG/上电/下载/Flash/供电/SCBV/跳线/温控或外发。
