minzhetang/pangu-riscv-soc/work/analysis/2026-10-25-prefetch-warning-m0/PANGO_QUESTIONS.md

# 给Pango技术支持的精简问题（待负责人转发，尚未发送）

器件PG2L100H-6IFBG676，盘古100Pro+；PDS 2022.2-SP6.4 build146967，采用PDS自带综合流程。

同一板级工程旧版在`Start sdm2adm.`与成功结束之间出现7次、新候选8次：
```
W: Loop was found during constant probe.
```
消息没有编号、网名或层级。后续综合/布局布线通过，27MHz内部STA为正；这不能证明警告无害。只做纯软件，尚无该工程实机证据。

主线只读展开已保存的最终综合Verilog，按官方primitive方向、LUT INIT/实际绑常量和FF/同步DRM状态边界检查，新旧最终图均无残余组合环。曾发现新旧共有的双输出LUT伪反馈：I5固定1时，Z实际不依赖I4；这只是我们粗略图误判的解释，**尚未证明与工具消息相关**。未修改源码消警告，也未关闭检查。

请只协助明确两点：

1. **这条确切sdm2adm消息在该版本/器件上的含义和严重性是什么？**它是否可能来自常量探测的临时依赖或双输出LUT表示，还是必然指最终组合环？若有适用已知问题、勘误/补丁或官方安全判据，请给文档编号/版本。
2. **如何从现有保存数据库定位每条消息的具体节点/逻辑锥？**请给当前版本支持的只读命令/报告选项及应加载的数据库阶段；优先不重新综合、不改RTL。如果必须重建，请说明最少需要的阶段与选项，或需要我们准备的最小工程内容。

暂不附许可证、机器标识、电脑名、下载器信息、整套专有模型或原始日志头；如需工程，先由负责人审查最小分享范围。本文件不授权外发、启动PDS、新构建或硬件操作。
