minzhetang/pangu-riscv-soc/work/analysis/2026-10-25-control-flow-quality-m0/IMPLEMENTATION_SCOPE.md

# A-CONTROL-FLOW-QUALITY-M0：本轮只读评估范围

2026-10-25，D137。用户在F144唯一下一建议后回复“继续”，本轮仅核查既有有效O2基线、原始轨迹及源码，形成一项最小方案与实施请求。

读取F143板级O2整组源码/两个镜像及已验EX-WB-MEM轨迹、F136反汇编/已验分类、F142存储与实现证据。逐文件SHA前后核同；只在本目录及报告/记忆/Git白名单写分析脚本、派生统计与计划，不修改RTL/TB/参考模型/输入/预期，不生成或运行新VVP/ELF/位流。

从已验合法EX顺序与指令编码统计JAL、JALR/返回和条件分支；正负偏移/实际taken、EX间隔与原flush计数互证。目标等于PC+4时不能只凭后继PC判taken，必须单列并核现有间隔，无法确定则标未知。不是退休PC或新DUT动态覆盖，解析器合成检查单独记。

依据真实开销与同步取指/前推/EEI约束，比较小范围方案，最多推荐一个。只读时序推演与理论上界不是实现或收益；如无可信局部方向，保留原结构。止于报告、最小文件/测试/PDS代价范围请求及记忆同步；不自动进入实现。不安装/GUI/授权配置/外发/硬件，over_temp STOP及B原任务/窗口不变。
