minzhetang/pangu-riscv-soc/work/analysis/2026-10-25-control-flow-quality-m0/NEXT_IMPLEMENTATION_SCOPE.md

# A-RESOLVED-TARGET-FETCH-M1：唯一建议的下一实施范围（未批准、未实施）

2026-10-25，D138建议。当前只读评估D137不授权本文件中的RTL、TB、模型调整或运行。

## 问题与方案

F143/O2两组计算窗口的已验EX轨迹表明，taken条件分支/JAL/JALR后的下一条合法EX间隔为6个物理拍；普通无依赖路径为2拍。当前代码先等推进沿更新pc_reg并清IF/ID与ID/EX，再等同步ROM返回，损失两个逻辑槽。

唯一推荐：仅在SYNC_MEMORY=1且新实验参数开启时，将**已经在现有EX路径判定正确的重定向地址**送入随后存储采样沿的取指端口，保存该次请求的valid/PC标签；下一推进沿如果标签、有效状态和重定向仍匹配，就把已返回的目标指令保存在IF/ID，并让顺序PC接目标+4。仍清除错误路径ID/EX，让当前分支/跳转正常进入后级。目标尚不可信、标签不匹配、非对齐、复位/EEI停止等情况走原路径。

这是利用已有两相同步取指时序的候选，不提前猜测条件、不改变比较/前推/分支目标语义，不添加预测表、Cache或新ISA。目标是把已命中请求后的EX间隔由6降至4拍；不是已证明的可用功能或提升。

## 最小文件与接口范围

在新的独立work副本保留source-before/models-before，不动F143/O2、F144失败选择与冻结证据。

- 新cpu.v：新增一个默认0的实验参数及最少valid/地址标签、取指地址mux、IF/ID有效/数据与PC重定向选择。仅SYNC_MEMORY=1且参数1生效，默认0和SYNC_MEMORY=0行为应保持。pc仍是实际取指请求地址，不冒称退休PC；内部pc_reg与IF/ID标签分别核对。
- 新soc_top.sv：仅CPU实例的一处显式参数绑定开启候选。端口/软件地址/MMIO语义不变，board_top/reset、memory_model及所有B RTL不改。
- 新验证副本：允许新定向TB/运行脚本、同步时序检查器/计数模型适配、监视器，必要时给独立参考包装增加明确模式参数；算法、启动/链接、O2 ELF/bin、ISA语义/原预期均不改。不能简单把flush计数去掉或统一把2改1；必须区分重定向事件、实际丢弃槽及独立预测的命中/回退，核请求/响应标签与沿前/沿后状态。
- PDS工程仅在功能通过且计算收益成立后，复制F142原器件/15引脚/27MHz约束，映射相同O2性能镜像，完成compile/synthesize/map/pnr/report_timing代价对照；不生成位流/硬件，不改外部约束以凑时序。

不改ALU/control/regfile、比较/前推/load-use逻辑、写回/存储边沿、数据内存时序、B包装、Timer或接口；不补非法编码/异常。如果实现必须更改这些禁止项或存储协议，保存诊断并停止，重新说明范围。

## 必须冻结的验收

1. 参数0下原763例用原输入/预期/严格判定回归，无退化；不要求其历史17/20个未冻结stall/flush项变成新独立预期。编译预算按准备后的实际固定清单一次审批，不盲复用旧外部许可。
2. 参数1的新小范围定向测试，覆盖六类taken/not-taken、有/无符号及相等边界、正/负/PC+4目标、连续重定向、JAL/JALR链接/rd=x0/rd=rs1、返回、EX/WB/WB→ID和load依赖；重点核目标第一条使用链接值/执行STORE/LOAD/再次跳转，旧路径STORE/WB/ECALL/EBREAK被清、旧MEM STORE仍完成、目标只执行一次。
3. 新请求后复位、EEI drain/STOP、空泡/无效控制、非对齐/未映射目标回退与原语义对照。不得趁机修异常；不能把目标PC对了当作目标指令/标签也对了。
4. 原两个O2 CoreMark镜像在参数1下各一次有界运行；原O2参数0结果复用。核CRC/种子、全RF/32K RAM、每笔EX/WB/MEM各自有序无去重（不冒称统一退休提交）、所有MMIO与12timer LOAD、完整UART/计时分区、正常返回与停止。原生普通波形明确捕获每类新请求/响应/命中与回退的时序窗口，实际UART连续记录不冒充完整ILA。
5. 独立预测的合格重定向目标EX间隔应6→4，未合格保持原行为；不是仅检查全程flush总数。程序不变但计时、串口轮询采样时刻可能变化，应按独立物理外设模型生成动态期望，不照抄旧时间戳/总计数或按DUT回填。
6. 每个进程显式超时和文件上限，CoreMark沿现600万物理拍/360s且首个设计失败停止。新RTL/模式在运行前冻结；旧源码/输入/日志结束SHA核同。当前只读阶段0新编译/DUT不能计入这些测试。

## 收益、代价与停止条件

现有统计下，若所有149422/162524次重定向都各省2物理拍且其他因素不变，理想少298844/325048 tick，约14.21%/14.36%计算时间。这是条件算术，**不是预计必达/已测提升**；只改直接JAL的理想空间仅0.39%/0.35%，不推荐为它单独改前端。

新路径可能把前推/比较/加法/mux接到ROM地址setup；不能沿用旧正裕量保证通过。valid/PC标签和匹配逻辑可能增加FF/LUT。实际以相同种子/镜像/时钟/输出条件下的计算ticks、CRC、代码/观测栈、PDS资源和最终27MHz时序报告判定。计算与输出分开；软件变快但时序/正确性变差不接收，也不把工具估算频率当硬件Fmax。

任一正确性/重复副作用/未关闭X-Z失败、时序不满足、无可信计算收益、需要改变数据存储/握手/全局流水线或显著超预算即停止候选、保留F143。阶段内普通细节由A处理，重大范围再确认。不承诺首创/创新得分或正式成绩。over_temp STOP、B原任务和10/27 18:00北京时间窗口保持。
