minzhetang/pangu-riscv-soc/work/fpga/2026-10-25-board-coremark-m1/NEXT_QUALITY_SCOPE.md

# 唯一下一建议：A-COMPILE-QUALITY-M1（未批准/未实施）

2026-10-25，D134建议。已有闭环证明新板级top功能/计时/报告对应正确，但尚无效率收益。下一用一个可逆的软件变量做可比实验，避免先改CPU或堆复杂模块。

建议批准的整阶段：

1. 先核官方CoreMark适用规则和现有源码完整性；不能确认允许的改动不实施。不改五算法源及处理工作量、种子/2K/各1迭代或计时/输出策略。
2. 在新独立副本仅将现RV32I/ILP32构建的-O2改为-O3，并如实更改编译描述元数据；其余开关、13RTL、存储/地址/时钟/N234/引脚保持。重用本轮O2真实结果，不因文档重复跑旧基线。
3. 两个新镜像检查ROM32K/RAM32K/8K栈/纯RV32I；溢出或新缺陷先停，不扩容量/修CPU/降CRC或预期。新增必要模型/有界TB配置/检查器，原预期/旧证据保留。
4. 固定两个新编译和两个有界短运行，核三CRC/全态/有序副作用/真实计时/全部串行字节，分别报告计算和输出。若进入PDS资源对照，只构建候选性能镜像至综合/映射/pnr/27MHz报告，比较F142对应O2实现；不生成位流/硬件。
5. 验收看同条件原始ticks、代码/栈/资源/内部时序代价与正确性。无收益、失败、容量/时序不满足或需扩大范围即停止该候选，保留O2；有收益也仅候选，不能宣称正式成绩或架构创新。

使用已验合法工具/绝对路径，不安装/改PATH/许可证/GUI；新沙箱外执行仍走工具审批，阶段内普通细节由A收敛。不改B任务/接口/承诺，不重复派核心；over_temp STOP不变。

这是下一阶段的一次范围请求，**不是当前实施或授权记录**。当前D133仅两个既有镜像复验，不自动扩到优化/PDS执行、正式≥10秒或硬件。
