minzhetang/pangu-riscv-soc/deliveries/competition-source-package-2026-11-03-v1/package/advanced/cache-ai/MAINLINE_HANDOFF.md

# 主线待审核吸收：CACHE-ISOLATED-M0 / AI-ISOLATED-M0

日期：2026-11-03（Asia/Shanghai）。唯一目录：
`D:\A_FPGA_Comp\work\independent-extensions\2026-11-03-cache-ai-m0-7c92`。

本轮用户明确允许独立开发覆盖原 CURRENT 的暂停新功能安排，仅限本目录。
主线仍优先 CoreMark M6 长测。本会话未启动、重启、接管、终止或调整主线进程；
未运行PDS/硬件/安装/系统环境修改，未执行Git命令，未写公共记忆/已验CPU/SoC/
公共参考模型/冻结测试/CoreMark目录/共享辅助脚本/其他对话文件。
未建立后台监控，不对主线当前完成状态作新判断。

## 已验证事实

- Cache：独立I/D两端口，各128B、2way、4set、16B行；D写穿透/写缺失不分配，LRU。
  44组缓存/直通×延迟对照全部符合独立内存响应与独立行/LRU统计预期；另有复位、
  I/D并发、持续valid、副作用与负向拒绝。源/接口/计划/原始预期都在本目录。
- 同条件D局部性64读、delay3：709→390周期（减少44.99%），60/64命中，
  后端事务64→4，payload256→64B。单次流式32读：357→918周期（增加157.14%），
  0/32命中，事务32→32，128→512B。完整I/D/两延迟/混合结果看CACHE_COMPARISON.csv。
- AI：16×8定点全连接算子，1 MAC/cycle、128 MAC/任务，完整调度/存储/配置/结果流。
  8组合成张量×2输出停顿模式的raw40及int8逐项匹配独立Python参考。
  start到最后结果握手136/148周期，当前TB配置304周期；不与CPU性能比较。
  缺失初始化、忙时握手、重复start、复位与负向拒绝均有限通过。
- 最终源码在新子目录recheck-001独立复制后，重新完成同样68个有界编译/运行进程，
  全部自动审计通过。每次只运行一个短仿真。主目录保留初次验证，未覆盖历史结果。

## 技术决定与理由

- 选择小Cache、blocking握手、无脏行：以有限成本先验证接收/完成/副作用/复位，
  不引入当前CPU缺失的总线协议。没有采用写回、多请求或CPU包装，均未获集成验证。
- AI选择小FC及合成测试分支：没有用户提供或本轮核验许可的真实模型材料。
  常见模型文件后缀检索无命中，但未解包穷尽全部归档。权重是原创生成的合成张量，
  不称真实模型移植，不报告识别率或完整边缘AI系统。
- 原字节掩码测试仅末尾读可能掩盖中间错误，保留原冻结材料，先冻结逐写逐读补测再验证。
  初次运行器工具路径算错，CreateProcess前WinError2；无仿真启动，空日志保留。
  最终运行器采用挂起创建→设置Job内存/进程数限制→恢复，避免子进程抢先逃出资源限制。

## 分层状态

|层级|CACHE-ISOLATED-M0|AI-ISOLATED-M0|
|---|---|---|
|设计|完成本原型接口/数值/复位约定|完成本算子结构/量化约定|
|实现|独立RTL、双通道包装、模拟后端、TB、参考完成|独立FC RTL、配置/控制器、TB、参考完成|
|独立仿真|上述有限矩阵及隔离复跑PASS|合成算子有限矩阵及隔离复跑PASS|
|真实模型|不适用|NOT_DONE：未取得/移植合法真实模型|
|CPU集成|NOT_RUN/NOT_IMPLEMENTED|NOT_RUN/NOT_IMPLEMENTED|
|综合实现|NOT_RUN|NOT_RUN|
|板级验证|NOT_RUN|NOT_RUN|

## 假设、限制与待办

Cache要求后端严格按长度/顺序返回且无错误；复位须含后端协议取消。无一致性/总线仲裁/
错误恢复，I/D仿真后端内存分离，不可据此称共享存储系统正确。
bit31不可缓存映射为本原型约定，尚未与生产SoC映射适配。
混用缓存/不可缓存别名写可能陈旧；模式切换须失效，当前仅统一reset方式。
组合数组可仿真不等BRAM映射/时序资源已达标。AI没有网络、激活/模型精度或性能优势证据。

待主线审核：决定是否吸收此独立证据/源码、未来映射及实际模型来源。
本轮不自动集成、综合、板测或展开长压力测试。结论严格限独立模块原型及有限验证，
不宣称完整高阶1或高阶3完成；不替代CoreMark主线优先级。

审核入口README.md、CACHE_REPORT.md、AI_REPORT.md、INTERFACES.md；
自动判定 `python check_delivery.py`；SHA256SUMS.txt覆盖交付文件（清单自身除外）。
