minzhetang/pangu-riscv-soc/deliveries/competition-source-package-2026-11-03-v1/package/advanced/cache-ai/cache-m1-admission/MAINLINE_HANDOFF.md

# M1待主线审核吸收，M0原记录保留

2026-11-03，用户要求在原隔离任务继续推进；所有本轮成果在本子目录，公共记忆、
Git、CoreMark、CPU/SoC及共享文件未写，未接管/中断/调优任何主线进程。

已实现并有限验证可选的两次访问准入策略，以原M0同条件重新运行作对照。
delay3 D序列：stream 918→357拍、512→128B；pollution1296→522拍；
locality390→414拍；同组A/B交替270→534拍；每行读两字797→942拍。
这组反例说明不能全局默认开启，故只保留为参数ADMISSION=1候选，默认0不改。
108bit/Cache额外ghost状态，I+D216逻辑bit；资源/频率尚无测量。

独立字节参考检查全部数据，另有准入/LRU/事务参考；102组配置、5项协议/复位、
1项预期负向拒绝通过，110次有界进程。M0原412项交付SHA逐项核同。
原M0参考/冻结预期未覆盖，新PLAN/EXPECTED先冻结再实现；运行前发现并记录继承TB
绝对事务数等待的局限，另存执行TB以相对事务数等待，不改数据预期。

|层级|状态|
|---|---|
|设计|本轮可选策略定义完成|
|实现|候选RTL、TB、独立参考、自动审计及量化表完成|
|独立仿真|有限测试PASS；存在明确性能退化，未作通用采用|
|CPU集成|NOT_RUN/NOT_IMPLEMENTED|
|综合实现|NOT_RUN|
|板级验证|NOT_RUN|
|AI|沿用M0合成FC结果，未改；真实模型NOT_DONE|

审核入口REPORT.md、COMPARISON.csv、SOURCE_DIFF.patch、RESULTS.json、logs/、
波形及三份SHA清单。自动判定 `python audit.py`（只读，不启动仿真）。
主线可审核策略适用条件和未来实际访存轨迹；本轮不扩更多算法、共享总线、CPU、
综合、硬件或长压力测试。不宣称完整高阶1/3或完整边缘AI系统。
