minzhetang/pangu-riscv-soc/deliveries/competition-source-package-2026-11-03-v1/package/advanced/cache-ai/cache-m2-two-ghost/MAINLINE_HANDOFF.md

# Cache M2待审核结论 — 2026-11-03

用户要求再次优化，在原隔离根新建cache-m2-two-ghost，保留M0/M1原件及各自SHA。
未写公共记忆/CPU/SoC/CoreMark/共享脚本/其他对话文件，未执行Git、PDS、硬件或安装，
未控制/中断/调整主线进程。不推断主线实时进度。

定案：为M1增加第二ghost标签和FIFO位，作为ADMISSION=1,GHOST_TWO=1可选候选，
默认ADMISSION=0、GHOST_TWO=0均不改。每Cache220逻辑历史状态位，比M1多112位。
delay3两行交替由M1的534→282周期（减少47.19%），恢复44/48读命中，192→40B。
保持流式357拍/128B、污染序列522拍和局部性414拍。三行循环仍无命中、每行两字
仍比M0慢；不是普遍最优，也没有频率/资源/功耗证据，不全局采用替换M0。

184组有限轨迹配置、4项协议/复位、2类负向检查通过，性能门16/16满足。
独立字节金值/独立准入统计，计划与预期在实现前冻结。193个进程逐次有界低优先级。
新增FIFO覆盖/重访、固定种子混合读写和双ghost复位；完整逐项结果见REPORT.md与JSON。
M0/M1旧清单逐项SHA回读核同。统计负向用真实M1正确读值却错误M2统计验证拒绝，
数据负向仍实际exit1，未改冻期待凑结果。

|层级|状态|
|---|---|
|设计|本轮可选策略已定义|
|实现|独立候选RTL/参考/TB/脚本完成|
|独立仿真|有限矩阵PASS及预冻收益门通过|
|CPU集成|NOT_RUN/NOT_IMPLEMENTED|
|综合实现|NOT_RUN|
|板级验证|NOT_RUN|
|AI真实模型|本轮未变，M0合成算子不升级为真实模型|

自动审计 `python audit.py`（只读，不启动仿真），SHA256SUMS覆盖交付自身外所有文件。
入口REPORT.md、COMPARISON.csv、RESULTS.json、TARGETS.json、SOURCE_DIFF.patch、
logs/与五份VCD。重新运行必须使用独立新目录并保留原日志，原运行器拒绝覆盖。
本轮按一次候选停止，不扩更多替换/准入/预取策略；下一有价值的证据应是已合法获取的
代表性实际访问轨迹与资源代价，而非把这些合成用例收益当CPU/系统收益。
不宣称完整高阶1或3、综合可实现性或板级正确性。
