minzhetang/pangu-riscv-soc/deliveries/competition-source-package-2026-11-03-v1/package/advanced/btb-mmode/project/work/advanced/2026-11-03-btb-mmode-m1/CURRENT-before-D322.md

# 当前阶段与入口

2026-11-03 D321/F281：三场景手机拍摄回执均已收，正常take-normal-r2、错误take-order、超时take-timeout-r2的UI账本都通过；r2超时是最小化窗口恢复后的导出重试，非新物理运行。用户要额外重拍第一段，旧证据保留；NORMAL_R3_READY已核SSCOM COM22打开/空显示/前台，等待新normal-r3拍摄与回执。入口work/video-recording/2026-11-03-event-demo-v1各take及READY。手机原片仍未收到/未视觉核验；UI文本不当原生驱动检测或成片验收。

D320应用v2/D300恢复基线保持，旧失败/配置变化原因未知保留。无新Program/PDS/RTL/Flash/保护SCBV供电跳线改变，温度IO/CDC/旧调试Critical及D245门保持。规则WORKING_POLICY，历史INDEX。
