minzhetang/pangu-riscv-soc/deliveries/competition-source-package-2026-11-03-v1/package/application/research-origin/project/work/application/2026-11-03-event-recorder-m1/CURRENT.before-M1-completion.md

# 当前阶段与入口

2026-11-03 D310/F269：用户批准应用优先+高阶独立RTL软件阶段。应用M0已有真实RV32I C/未改SM2 CPU执行及8份完整记录器快照独立对照通过；仅确定性重放，不是GPIO实时采集/量化对照或实机。入口work/application/2026-11-03-event-recorder-m0/README.md、LEDGER_RESULT.json。下一A实时GPIO/计时/逐笔账本与同输入量化；B高阶尚未新实施/NOT_RUN，不替换主线。无PDS/硬件；D300已验基线保持。下方D309视频状态为历史并存，不代表本应用验收。

2026-11-02 D309/F268：给B后期的集中素材包完成，入口deliveries/video-editing-assets-for-B-2026-11-02-v1/START_HERE.md，同名ZIP约9.63MB。原生v2原ZIP+4直接剪辑视频/4字幕、8张图片、历史UART/分析及口径说明，35文件/34项SHA全核；O2波形与SM2结果分明，旧PPT素材不采用。未含手机新录像/本次SSCOM结果，未外发/新运行或操作GUI硬件；D307用户手动演示状态仍待真实材料核验。

2026-11-02 D308/F267：PDS Fabric Debugger已恢复原O2历史list波形，留GUI给用户手动展示；点击步骤deliveries/manual-board-demo-2026-11-02-v1/PDS波形展示步骤.md，READY见work/video-recording/2026-11-02-manual-wave-open-v1。无新采样/服务器/扫描/下载、不占SSCOM；与当前SM2实时串口分段标明，不称同轮波形。D307串口准备及正式拍摄待用户进行。

2026-11-02 D307/F266：用户将手动操作同框拍摄；点击清单deliveries/manual-board-demo-2026-11-02-v1/操作清单.md。用户报告三线保持且12V未断；当前CP210x COM22，SSCOM5.13.1 GUI已准备（端口关闭、S0/R0）。先由用户设置字体/取消HEX与时间戳/清窗口，等软件就绪再预演一次、正式一次；主线不抢鼠标、不自动开COM/复位/Program。期望当前SM2验证版，须实际输出确认。

2026-11-02 D306：原生PDS/Debugger v2包用户确认可用；最早computer-recordings-v1说明页录屏不入成片（旧包保留）。剪辑纠正与P0补拍入口deliveries/video-editing-direction-2026-11-02-v1/TO_B.md。下一优先板卡真实操作与同次实时UART，原生软件仅短证据段，无新硬件/录屏授权消费。

2026-11-02 D305/F265：已自行录好实际PDS/Debugger原生GUI，4段82秒；入口deliveries/native-software-recordings-for-B-2026-11-02-v2/START_HERE.md，交付同名ZIP约4.66MB。原生工程/资源/时序/源码与原O2历史WDF缩放，完整解码/13帧视觉/70原件SHA通过；无新构建或硬件，两GUI正常退出、服务器0。B后期优先此包；D304仅图文辅助。实物片与成片待补，许可证实际提示剩1天，后续合法续期另处理。

2026-11-02 D304/F264：8段电脑证据展示录屏已完成并打包，入口deliveries/computer-recordings-for-B-2026-11-02-v1/START_HERE.md；交付同名ZIP（约3.24MB）。H264/1080p/无声共136秒，逐段解码/14帧视觉检查通过。用户指定B后期，未外发/无B回执；历史UART和原O2片上图离线展示，不是新运行或原生PDS GUI。下一用户转包、收实物录像，B剪辑配音；下方D303现场/成片待补仍有效。

2026-11-02 D303/F263：用户决定暂不做高阶，转作品提交整理，优先视频。入口deliveries/submission-video-2026-11-02-v1/START_HERE.md；分镜/补拍/提交清单同目录，里程碑见TODO。6张1080p卡、4原O2片上图、两组SM2原UART已整理；现场录像与成片待补。下一先收已有手机录像，不自动启动硬件或安装剪辑工具。

已验仍D300/F260：SM2定义裸机EEI非调试性能/验证版，496232016/522673286周期，双种子CRC及重复报告通过；降周期7.85598%、+60B，同27MHz/LUT1810/FF1527/DRM36 14。报告reports/hardware/2026-11-02-sm2-dualseed-and-uart-closure.md；固定恢复deliveries/accepted-basic-sm2-2026-11-02-v1/START_HERE.md。原O2波形不当SM2新波形；旧调试Critical/CDC/IO/校频温度与UART根因限制保留。

此前2次配置预算已用完，工具已退出，最后SM2验证版；无新断电回执，不复用ATTEMPT/按键。bit27照录，芯片保护/Flash/SCBV供电跳线不改。D302维持B HL4独立候选；D198不派技术工单，D301海报素材保留。

Git技术最新已核4502fea；D245待审README/CONTRIBUTION/依赖/AUDIT及白名单仍本地。本次视频资料未提交推送/上传。完整规则WORKING_POLICY.md；上一CURRENT原样存视频包evidence/CURRENT.before-video-phase.md，历史入口见INDEX。
