minzhetang/pangu-riscv-soc/deliveries/competition-source-package-2026-11-03-v1/package/application/research-origin/project/work/application/2026-11-03-event-recorder-m2/CURRENT.before-M2-completion.md

# 当前阶段与入口

2026-11-03 D311/F270/F271：应用M1有限RTL闭环和量化完成，下一优先A-M2慢速参数/去审核RAM软件定型。入口reports/application/2026-11-03-event-recorder-and-independent-advanced.md、deliveries/event-recorder-software-2026-11-03-v1/START_HERE.md；原始结果work/application/2026-11-03-event-recorder-m1。7场景×2模式/每组2复位严格通过，非板级应用；重复执行/工具失败与证据留存不足见README。高阶原BTB12项模块通过，整核连接TB工具异常、R2补丁NOT_RUN，不替换CPU；入口work/advanced/2026-11-03-hl4-precise-target-m0/README.md。

已验仍D300 SM2基础非调试版，恢复deliveries/accepted-basic-sm2-2026-11-02-v1，84项SHA回核同。当前授权仅独立软件/RTL仿真，未新PDS/GUI/JTAG/下载/Flash或实体操作；不推定现在供电状态或复用旧额度，bit27照录/保护不改。完整规则WORKING_POLICY.md；D245待审文档不自动提交，未外发。本次前CURRENT保留work/application/2026-11-03-event-recorder-m1/CURRENT.before-M1-completion.md；历史/视频入口见INDEX。里程碑见TODO。
