minzhetang/pangu-riscv-soc/snapshots/2026-11-03-submission/report/figures/02-pipeline.pdf

同一上升沿时钟 固定两相使能 valid 与副作用分离

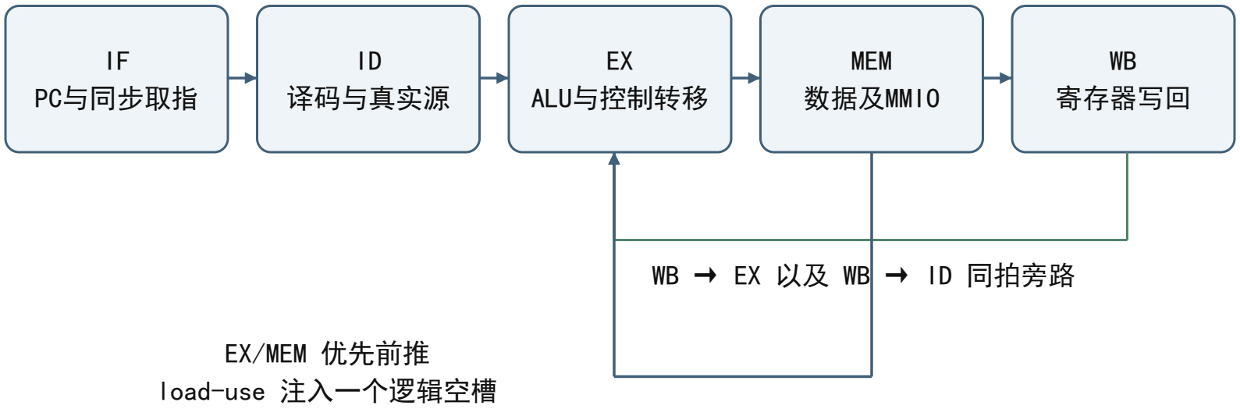
[picture p23: figure]
IF PC与同步取指; ID 译码与真实源; EX ALU与控制转移; MEM 数据及MMIO; WB 寄存器写回; → ID 同拍旁路; EX/MEM 优先前推 load-use 注入一个逻辑空槽
