minzhetang/pangu-riscv-soc/snapshots/2026-11-03-submission/report/figures/03-memory-phases.pdf

## 固定一拍同步读与两相流水推进

流水线 | 保持 | 推进 | 保持 | 推进 | 保持 | 推进

### STORE 只在采样沿产生一次写选通 RF 只在推进沿写回

两相是同一个时钟下的使能，不是两个时钟域；无气泡时也每两拍推进一次
