minzhetang/pangu-riscv-soc/snapshots/2026-11-03-submission/report/figures/05-cache-architecture.pdf

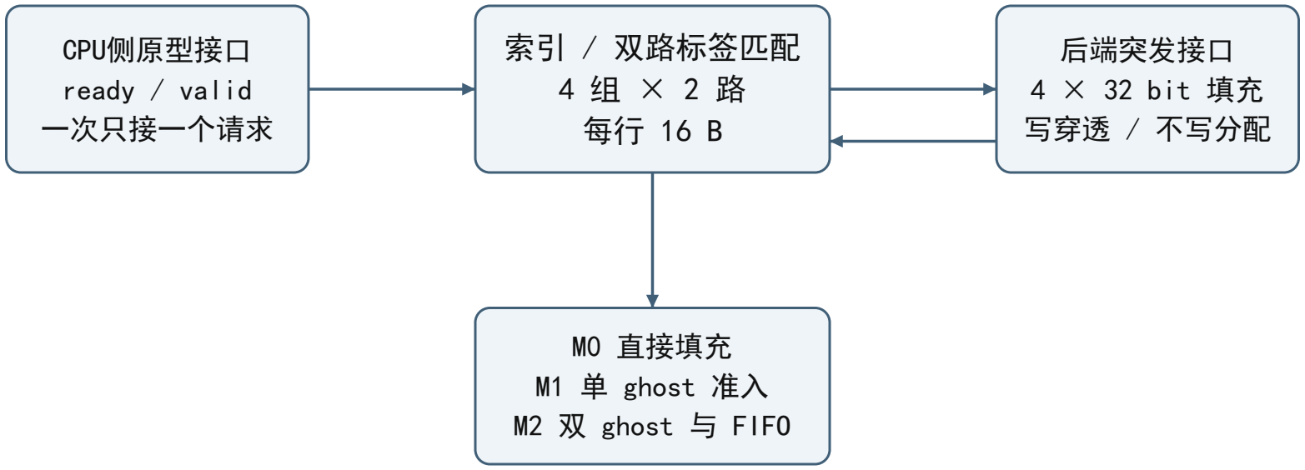
[picture p24: figure]
CPU侧原型接口 ready / valid 一次只接一个请求; 索引 / 双路标签匹配 4 组 × 2 路 每行 16 B; M0 直接填充 M1 单 ghost 准入 M2 双 ghost 与 FIFO; 后端突发接口 4 × 32 bit 填充 写穿透 / 不写分配

I / D 各 128 B 本图为单个 Cache 独立后端模型尚未验证共享仲裁与一致性
