minzhetang/pangu-riscv-soc/snapshots/2026-11-03-submission/report/figures/07-ai-datapath.pdf

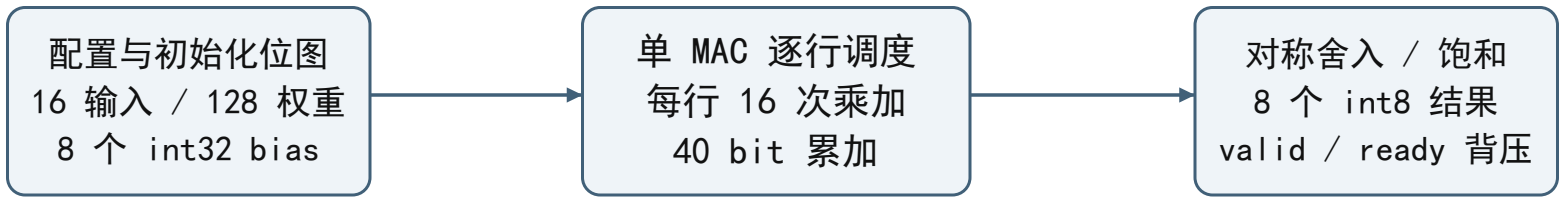
[picture p25: figure]
配置与初始化位图 16 输入 / 128 权重 8 个 int32 bias; 单 MAC 逐行调度 每行 16 次乘加 40 bit 累加; 对称舍入 / 饱和 8 个 int8 结果 valid / ready 背压

raw = bias + Σ input × weight | input、weight 表示整数值 / 64
q = sign(raw) × floor((abs(raw) + 32) / 64) | y = clip(q, -128, 127)

每任务 128 MAC 无背压 136 拍 固定背压 148 拍 配置另计

合成数据算子实验，不是 YOLO / 大模型移植，不报告识别率或 CPU 加速比
