minzhetang/pangu-riscv-soc/snapshots/2026-11-03-submission/report/figures/08-sm2-cycles.pdf

## 实机同条件计算周期

性能种子 / 256次 | 原软乘 | 538539600
SM2 | 496232016

同 CPU / 27 MHz / GCC O2 / 相同工作量 周期减少 7.856% 程序增加 60 B
