minzhetang/pangu-riscv-soc/snapshots/2026-11-03-submission/report/figures/09-cache-tradeoff.pdf

# Cache 准入策略的收益与代价

流式 32 读 | 直通 | 357
M0 | 918
| M1 | 357
| M2 | 357
同组两行交替 | 直通 | 534
M0 | 270
| M1 | 534
M2 | 282
局部性 64 读 | 直通 | 709
| M0 | 390
| M1 | 414
| M2 | 414

D通道 delay=3 纵向为同输入策略对比 单位为原型 TB 周期，不是 CPU 周期
