minzhetang/pangu-riscv-soc/snapshots/2026-11-03-submission/report/figures/10-btb-cycles.pdf

# 独立 BTB 候选 CoreMark 短测

性能种子 / 1次 | 关闭 | 2103652
64项 | 1719152
32项 | 1730128
验证种子 / 1次 | 关闭 | 2263004
64项 | 1837836
32项 | 1849336

计算窗 STORE 接受沿差 共同镜像与同步读时序 未达到 10 秒，不是正式实机成绩
