minzhetang/pangu-riscv-soc/snapshots/2026-11-03-submission/report/figures/20-list-readable.pdf

## list 真实片上局部窗口

样本 548～559 单步为一个物理时钟 数据来自原始 WDF 对应 CSV

548 | 549 | 550 | 551 | 552 | 553 | 554 | 555 | 556 | 557 | 558 | 559

推进

### EX有效

### load-use

冲刷

### 分支取

EX PC | 0578 | 0578 | 0000 | 0584 | 0584 | 0588

绿色为有效推进槽；阴影不代表退休事件。PC 只在推进点标注；逐点原值随报告保留。
