minzhetang/pangu-riscv-soc/snapshots/2026-11-03-submission/report/figures/21-matrix-readable.pdf

## matrix 真实片上局部窗口

样本 4～17 单步为一个物理时钟 数据来自原始 WDF 对应 CSV

4 | 5 | 6 | 7 | 8 | 9 | 10 | 11 | 12 | 13 | 14 | 15 | 16 | 17

推进

### EX有效

### load-use

冲刷

### 分支取

EX PC | 1B68 | 1B6C | 1B6C | 0000 | 1B40 | 1B44 | 1B48

绿色为有效推进槽；阴影不代表退休事件。PC 只在推进点标注；逐点原值随报告保留。
