minzhetang/pangu-riscv-soc/snapshots/2026-11-03-submission/report/figures/22-state-readable.pdf

## state 真实片上局部窗口

样本 512～525 单步为一个物理时钟 数据来自原始 WDF 对应 CSV

512 | 513 | 514 | 515 | 516 | 517 | 518 | 519 | 520 | 521 | 522 | 523 | 524 | 525

推进

### EX有效

### load-use

冲刷

### 分支取

EX PC | 1EE0 | 1EE4 | 1EE8 | 1EE8 | 1EEC | 1EF0 | 1EF4

绿色为有效推进槽；阴影不代表退休事件。PC 只在推进点标注；逐点原值随报告保留。
