minzhetang/pangu-riscv-soc/deliveries/mainline-board-coremark8-bitstream-scope-2026-10-27-v1/IMPLEMENTATION_SCOPE.md

# A-BOARD-COREMARK8-BITSTREAM-M1 / 实施范围1.0.0

2026-10-27，D163技术推荐，**PENDING_SCOPE_APPROVAL：未获新PDS/位流构建授权**。本阶段只为已验证短程序准备CPU基准位流，非正式CoreMark成绩/完整作品/片上ILA/硬件放行。

## 目标与不变基线

在全新`work/fpga/2026-10-27-board-coremark8-bitstream-m1`（已存在则唯一新目录）使用F160整组13功能RTL和已构建/完整仿真通过的性能8迭代镜像：

- `work/fpga/2026-10-27-coremark-longrun-ready-m2/source/`13文件，按SOURCE_RECEIPTS整组核验，不能混F146候选。
- 同目录`build/performance8/program.bin` SHA **EC365839FEA1111CB365763322E2FA99C3C3B3F6B74A5884C5B0EB30593486F0**，15912B；配套ELF/初始化表SHA由本阶段冻结记录。既有8迭代结果物理18515827、计算16829452ticks、CRCccd1/663UART，仅软件有限证据。
- 复用F142板级94条引脚约束与27MHz时钟约束，目标PG2L100H/-6/FBG676、top=board_top。不改电气标准、引脚、普通IO时序或虚构外部delay。

## 唯一允许的实现变化

1. 只在新副本建立PDS最小工程/调用脚本、产物与检查器；功能RTL、CPU流水线、存储/Timer、外设、软件算法/port/启动/链接完全不改。**不调用GCC或Icarus，不新增DUT**；复用F160已验证镜像。
2. PDS源沿F142已验证的确定性转换：12文件字节相同；memory_model去掉M0_VERIFY观测块并将对应初始化表内联，其余逻辑逐字符核同。源模块仍保持原件；这是生产绑定/初始化准备，不是功能RTL重构。新ROM32768B须逐字节等于15912B镜像+零填充，RAM初态保持原A5，不能继续引用旧1迭代INIT。
3. **仅1次既有PDS2022.2-SP6.4普通CLI流程**：compile→ADS synthesis→dev_map→pnr→report_timing→gen_bit_stream。不使用GUI、安装、升级、管理员权限，不改变环境/许可证配置。不执行任何硬件服务器/设备/JTAG/下载/Flash命令。
4. gen_bit_stream仅在新副本显式沿用D010接受的工程决定`-scbv "High Voltage"`；不试Low，不改板上状态或旧工程。实际核心板配置供电仍未完整闭环，软件警告消失不构成电压安全证明。

## 预算、验收与停止

- PDS只启动一次，墙钟<=1800秒；整个阶段含准备/审计<=2400秒。启动前卷可用空间>=4GiB；stdout/stderr各<=32MiB，复用已验限时入口、记录实际可取得的进程资源及观测边界。新范围不等于无限重试或新增完整监督框架。
- 只用现有合法许可正常checkout，记录脱敏成功/失败及实际剩余天数提示；不读取许可内容/机器标识，不依据旧9天推算今日有效期。失败或需要人工许可操作即停，不修改配置或重装。
- 先冻结13源、镜像/ELF、初始化、FDC、脚本及旧报告保护清单。PDS完全退出后才核本次阶段完成标志、真实rc、新鲜非空.sbit、大小/SHA256、工具/器件/SCBV设置与生成时间窗，不能靠旧文件或exit0。
- 核合成网表GTP初始位参数与新ROM/RAM逐块对应、存储/CPU层次实际存在、零latch、真实15针及内部27MHz最终setup/hold/recovery/removal。不将内部通过当14个外部异步IO已约束或已验证CDC。
- 与F142旧流程逐分类对比：已知7条constant-probe及外部未约束限制保留、不宣布无害；Bitstream-2001应不出现，其他新增warning/critical/错误必须诊断记录，必要时停止产物准入。F146新增告警候选不混入本阶段。
- 新源/旧源、镜像、12文件及memory_model确定性转换逐字节或规范化核同；保留旧工程、位流、日志、失败和新候选。工具/时序失败、所需功能改动/新增调用、GUI/系统权限等出现时停止相关动作，不为跑通改RTL/时序预期或继续盲建。

## 交付与后续边界

交付精确diff/源与INIT收据、完整脱敏命令、真实日志/rc、最终时序与资源、告警清单、新位流路径/SHA256以及分层结果。成功只记“CPU短程序软件位流生成”，**未JTAG识别/未CPU实机运行/无正式CoreMark/无ILA**。

本阶段不植入ILA或生成160迭代新程序，不跑长测，不申请账号/远程平台，不连接、上电、读硬件状态、下载或Flash。先保留无调试基准位流用于后续受控比较；片上调试插入/资源开销、正式双种子>=10秒与实机取证仍须分别明确新范围。

over_temp STOP绝不解除。即使软件生成成功，仍须独立安全依据与硬件授权才能进入实机步骤；本确认不能被当作该放行。
