minzhetang/pangu-riscv-soc/deliveries/mainline-stage-final-response-2026-10-25-v1/START_HERE.md

# 最终阶段候选v01主线复核回复

先读TEAMMATE_REPLY.md；COUNTEREXAMPLES.json给实际原/新证据的剩余反例。整体有条件接收，核心/包装不重做，只收敛R1–R3。当前阶段新7编译/7仿真和全5配置公开端口检查已完成；共享顺序/V3指定关联变异/新增末半停止位取消可关闭。完整主线报告在reports/progress/2026-10-25-stage-final-v01-review.md。

本目录由负责人转交；尚未自动发送。无需再发2335、旧整包或ZIP；不包含新核心合同，不扩RX包装/系统/硬件权限。
