minzhetang/pangu-riscv-soc/reports/progress/evidence/2026-10-25-stage-final-v01-review/READING_CHECKLIST_COMPLETED.md

# 最终阶段70项阅读/解析覆盖

状态区分全文阅读、当前完整差额＋已核历史原文、同SHA复用、完整解析；不是把复用冒称重新全文读。

|状态|接收根相对路径|字节|
|---|---|---:|
|FULL_PARSE|CHANGED_FILES.json|20383|
|FULL_PARSE|coverage_map.json|3433|
|FULL_PARSE|delivery.json|3350|
|FULL_PARSE|DEPENDENCIES.json|5424|
|FULL_PARSE|DIFF.patch|102733|
|FULL_PARSE|HISTORY_ALIASES.json|1660|
|FULL_PARSE|MODULE_STATUS.json|3430|
|FULL_READ|OPEN_ITEMS.md|777|
|FULL_PARSE|SHA256SUMS.txt|8011|
|FULL_PARSE|SOURCE_INDEX.json|7246|
|FULL_READ|START_HERE.md|1740|
|FULL_DELTA_PLUS_PRIOR_READ|work/peripherals/rx/CHANGELOG.md|8726|
|FULL_READ|work/peripherals/rx/docs/RX-LEDGER-1.3.4.md|676|
|FULL_PARSE|work/peripherals/rx/logs/rx-20261025-191037/compile_illegal.log|795|
|FULL_PARSE|work/peripherals/rx/logs/rx-20261025-191037/compile_N16.log|860|
|FULL_PARSE|work/peripherals/rx/logs/rx-20261025-191037/compile_N234.log|863|
|FULL_PARSE|work/peripherals/rx/logs/rx-20261025-191037/compile_N8.log|857|
|FULL_PARSE|work/peripherals/rx/logs/rx-20261025-191037/compile_neg.log|847|
|FULL_PARSE|work/peripherals/rx/logs/rx-20261025-191037/compile_watchdog.log|821|
|FULL_PARSE|work/peripherals/rx/logs/rx-20261025-191037/plan_check.log|1832|
|FULL_PARSE|work/peripherals/rx/logs/rx-20261025-191037/run_illegal.log|785|
|FULL_PARSE|work/peripherals/rx/logs/rx-20261025-191037/run_manifest.json|5263|
|FULL_PARSE|work/peripherals/rx/logs/rx-20261025-191037/run_N16.log|55442|
|FULL_PARSE|work/peripherals/rx/logs/rx-20261025-191037/run_N234.log|34907|
|FULL_PARSE|work/peripherals/rx/logs/rx-20261025-191037/run_N8.log|46554|
|FULL_PARSE|work/peripherals/rx/logs/rx-20261025-191037/run_neg.log|1390|
|FULL_PARSE|work/peripherals/rx/logs/rx-20261025-191037/run_watchdog.log|811|
|FULL_PARSE|work/peripherals/rx/logs/rx-20261025-191037/schema_validate.log|1173|
|FULL_PARSE|work/peripherals/rx/logs/rx-20261025-191037/tool_iverilog.log|4092|
|FULL_PARSE|work/peripherals/rx/logs/rx-20261025-191037/tool_python.log|696|
|FULL_PARSE|work/peripherals/rx/logs/rx-20261025-191037/tool_vvp.log|1478|
|FULL_PARSE|work/peripherals/rx/logs/rx-status-selfcheck-20261025-191053/summary.json|975|
|FULL_PARSE|work/peripherals/rx/results.json|60154|
|FULL_DELTA_PLUS_PRIOR_READ|work/peripherals/rx/scripts/run_rx.py|28865|
|FULL_READ|work/peripherals/rx/scripts/rx_status_selfcheck.py|2390|
|FULL_DELTA_PLUS_PRIOR_READ|work/peripherals/rx/STATUS.md|8997|
|FULL_READ|work/peripherals/rx/tb/rx_public_capture.sv|2405|
|FULL_DELTA_PLUS_PRIOR_READ|work/peripherals/rx/tb/tb_uart_rx.sv|51705|
|FULL_DELTA_PLUS_PRIOR_READ|work/peripherals/rx/tb/tb_uart_rx_neg.sv|14533|
|FULL_PARSE|work/peripherals/rx/tests/rx-plan-1.3.4.json|22135|
|FULL_PARSE|work/peripherals/rx/tests/rx-plan-1.3.4.sha256|112|
|FULL_PARSE|work/peripherals/rx/waves/rx-20261025-191037/uart_rx_N16.vcd|1023649|
|FULL_PARSE|work/peripherals/rx/waves/rx-20261025-191037/uart_rx_N234.vcd|11243577|
|FULL_PARSE|work/peripherals/rx/waves/rx-20261025-191037/uart_rx_N8.vcd|456733|
|FULL_READ|work/regif/txgpio-m1/docs/RUNBOOK.md|2698|
|FULL_READ|work/regif/txgpio-m1/docs/W01-W10.md|3581|
|FULL_PARSE|work/regif/txgpio-m1/logs/regif-capture-20261025-190535/compile_capture.log|838|
|FULL_PARSE|work/regif/txgpio-m1/logs/regif-capture-20261025-190535/run_capture.log|1412|
|FULL_PARSE|work/regif/txgpio-m1/logs/regif-capture-20261025-190535/summary.json|550|
|FULL_PARSE|work/regif/txgpio-m1/logs/regif-entry-selfcheck-20261025-190752/summary.json|6567|
|FULL_PARSE|work/regif/txgpio-m1/logs/regif-m1-20261025-190737/compile_N16.log|982|
|FULL_PARSE|work/regif/txgpio-m1/logs/regif-m1-20261025-190737/compile_N234.log|984|
|FULL_PARSE|work/regif/txgpio-m1/logs/regif-m1-20261025-190737/plan_check.log|1375|
|FULL_PARSE|work/regif/txgpio-m1/logs/regif-m1-20261025-190737/run_N16.log|5181|
|FULL_PARSE|work/regif/txgpio-m1/logs/regif-m1-20261025-190737/run_N234.log|3007|
|FULL_PARSE|work/regif/txgpio-m1/logs/regif-m1-20261025-190737/tool_iverilog.log|4093|
|FULL_PARSE|work/regif/txgpio-m1/logs/regif-m1-20261025-190737/tool_python.log|697|
|FULL_PARSE|work/regif/txgpio-m1/logs/regif-m1-20261025-190737/tool_vvp.log|1479|
|FULL_READ|work/regif/txgpio-m1/README.md|2579|
|FULL_PARSE|work/regif/txgpio-m1/results.json|19302|
|FULL_READ|work/regif/txgpio-m1/scripts/regif_capture_selfcheck.py|3249|
|FULL_READ|work/regif/txgpio-m1/scripts/regif_entry_selfcheck.py|7599|
|FULL_DELTA_PLUS_PRIOR_READ|work/regif/txgpio-m1/scripts/run_regif_m1.py|20404|
|FULL_READ|work/regif/txgpio-m1/tb/regif_tx_public_monitor.sv|3205|
|PRIOR_FULL_READ_REUSED|work/regif/txgpio-m1/tb/tb_local_regif_txgpio_m1.sv|23194|
|FULL_READ|work/regif/txgpio-m1/tb/tb_regif_tx_capture_neg.sv|4634|
|FULL_PARSE|work/regif/txgpio-m1/tests/w01-w10-plan-1.0.4.json|15535|
|FULL_PARSE|work/regif/txgpio-m1/tests/w01-w10-plan-1.0.4.sha256|118|
|FULL_PARSE|work/regif/txgpio-m1/waves/regif-m1-20261025-190737/regif_m1_N16.vcd|131109|
|FULL_PARSE|work/regif/txgpio-m1/waves/regif-m1-20261025-190737/regif_m1_N234.vcd|1930509|
