minzhetang/pangu-riscv-soc/deliveries/mainline-formal-coremark-software-scope-2026-10-29-v1/IMPLEMENTATION_SCOPE.md

# A-FORMAL-COREMARK-SOFTWARE-M1 /1.0.0（待批准）

日期2026-10-29；依据F179/D193只读预检。目标：给B正式测量所需的**软件候选及独立先验**，同时取得新移植端口双种子短测的严格结果；不是取得正式跑分或恢复硬件。

## 固定输入和保护

基于`work/fpga/2026-10-27-coremark-longrun-ready-m2`整组，核13RTL/两模型/官方六源/启动链接/旧结果；F163生产绑定作生成初始化的固定模板。只在唯一新目录`work/software/2026-10-29-formal-coremark-m1`（已有选后缀）工作，保留source-before/models-before/port-before、输入SHA和准确diff。旧S/F/D/C、B原件/已转1311文件交接包均不改。

## 允许修改/新增

1. 新core_portme.c/.h：诚实时基常量参数、完整可追溯编译flags/内存描述与测量候选标记；HAS_FLOAT0及现有64位采样/32位delta超限拒绝保持。频率固定27000000，仅作编译设定，不写成实测。移植端口不更改计时窗/少算工作；UART格式化/输出继续窗外。不得删掉不足10秒错误凑通。
2. 新build_identity.h及运行计划/工具脚本：统一相对路径编译，完整参数/seed/迭代/频率/程序身份；不引入硬件FPU、M/C、OS或新库安装。
3. 新参考/检查适配副本、计量解析器和必要自检。保持Reference ISA语义/内存/旁路/调度语义；只允许两处25M步数预算守卫在新副本按case明确调为上限250M，短case外层仍5M限。准确diff区分预算/检查元数据与架构语义。原公共模型/预期不改。
4. 镜像、ROM/RAM初值及独立case：四份C程序（两种子×N2/N256），2000B，rv32i/ilp32/O2；原算法/启动/链接/13功能RTL不改。若生成生产memory_model只内联新INIT数据，不修改绑定逻辑；CPU/SoC/时钟/寄存器/接口/外设/约束/FIC不变。
5. 沿用原采集TB事件谓词/时刻/字段；只允许新副本的实例参数/phase符号地址/周期预算按case冻结，不改监测语义/删事件。原TB、历史计划及所有预期保留。

## 明确执行数量与预算

|项目|最多次数|限额|
|---|---:|---|
|GNU C编译链接|4（perf2/val2/perf256/val256）|每次60s，辅助objcopy/objdump/readelf/nm每项20s；不额外native查询/试编|
|独立ISA先验|4，与四程序对应|N2各5M步/300s；N256各250M步/1200s。报告/参考数据每case64MiB，父/子各512MiB；不得把超限转成功|
|Icarus RTL编译|2，仅双种子N2|每次120s；现有绝对路径/-B/VPI；普通权限，若需要沙箱外必须另核工具权限；错误即停不盲试|
|新DUT|2，仅双种子N2|每例12M物理拍/900s，正常停止+原尾拍；新普通窗口VCD≤256MiB；完整逐笔流，不force/不去重/不预置最终态|
|最终检查|2双种子N2|每例300s；比较全RF/RAM、每笔合法EX/WB/READ/STORE各自有序、计时/stall/flush/副作用、完整PIN及窗口VCD|
|计量/报告主机正负控|一批预先冻结小型夹具|≤60s合计/64MiB；无DUT/PDS；关键边界与缺身份/错CRC/重复/错误输出须拒绝|

整个阶段同一**7200s绝对deadline**，不因子阶段或重试重置；剩余不足则停止。每流raw16GiB/500M条/16384段、index16MiB、每例archive4GiB/spool32MiB沿已有有界协议，不扩大上限来掩盖问题；实际本阶段全部新证据总量≤2GiB，单stdout/stderr16MiB/生成结果64MiB/内存512MiB，计量失败/无测量值fail-closed。不得改Windows安全、PATH、许可或工具。

## 验收与失败处理

先手工冻结各模式标准CRC、报告字段、允许源diff、预算/版本和预期，再编译/独立参考；对应新DUT前冻结完整先验。seed4实际ELF分别2/256、实际上游六源SHA不变、镜像≤32KiB/RAM布局/合法I编码/启动无溢出。N256的crcfinal/RF/RAM/时序由新参考实际求出，不复制8值/不把线性外推当预期。

N2两例严格比较、完整串口报告与窗外发送均通过，官方至少10秒报错在短case保留；N256参考若计算时长不足10名义秒/超32位/CRC或错误字段不合格则停止，不能自动换次数/放宽。**256没有RTL新执行，始终标PROGRAM_BUILT_REFERENCE_ONLY_PENDING_TARGET_RUN**，参考摘要不替代DUT逐笔检查。hardware_valid/formal_score_valid保持false；不因模型、编译或正确性文字升级实机验收。

HAS_FLOAT0整数秒显示照旧；主机精确用iterations×真实freq/rawdelta给迭代率，CoreMark/MHz以实际物理CPU时钟计算，不能把pipeline advance0.5当MHz分母。只有B后续有合法冻结版本/真实时基/双种子≥10s/CRC/重复运行和原始输出、由A核实后才能报正式结果；本阶段解析器面对缺实机身份只能输出候选/拒绝，不能自填“已测”。

出现新编译/加载/设计错误、超时/超限/XZ/错误重复副作用、额外RTL/算法需求时保留证据并停止相关执行，不扩大功能修复或追加运行。报告源diff/工具命令/前后SHA/结果/警告/时长与不足；不回滚或改写旧成功/失败。

## 对B与硬件边界

产出独立版本增量：两256程序/必要源与INIT/构建计划/独立先验、两短程完整软件证据、精确计量和报告工具/说明，包准备不自动发送。B已收旧固定8不变，可先B0/B1/B2；B3等正式候选及相应安全/执行批准。B普通平台判断自主，不重派核心/不由A逐键指挥。

**0 PDS/网表导出/新位流/GUI/安装/硬件服务器/设备枚举/JTAG/上电/下载/Flash；0 SCBV/供电/跳线/温控改动；0外发/上传。** over_temp STOP不变。旧1.3.0直接网表导出不在本范围。
