minzhetang/pangu-riscv-soc/deliveries/mainline-postroute-netlist-export-scope-2026-10-29-v1/IMPLEMENTATION_SCOPE.md

# A-POSTROUTE-NETLIST-EXPORT-M0

版本1.0.0；2026-10-29；推荐待批，未执行。

目的：把R4已有后布局设计导出为可逐脚解析的原生文字连接网表，补充后布局D输入驱动证据；不重新设计CPU或制造位流。官方依据：安装版PDS用户手册V1.5实际PDF148/252页、§3.7/§9.11。仅有功能说明，独立读取缓存DB所需接口仍须本机确认。

## 允许范围

1. 新独立目录，按实际需要复制已有R4数据库/工程元数据并核SHA；原件、FIC、位流、RTL、INIT、程序和约束不变。不得覆盖已存在输出。
2. 一次普通权限`D:/PDS/PDS_2022.2-SP6.4/bin/pds_shell.exe`进程，最长180秒，阶段总900秒；0GUI。该进程内至多6项只读接口/帮助查询（包括`gen_netlist -help`），确认如何载入既有后布局DB及功能网表导出。
3. 只有确认不需重新实现且语义符合本范围时，才在同一进程中载入同字节副本、导出一次文字网表；优先仅sim.v，不需要SDF/仿真。不能用`-run`或自动追跑前置的方式。若不支持独立导出、要求重新编译/实现/新权限，立即记录停止，不猜接口或追加进程。
4. 主机脚本只读解析新网表：记录每个实际核查采样D/CLK引脚、网络、驱动实例/输出脚及逻辑别名；优先136–139/34/38，再全140。保留未知、多驱动、常量及不支持原语，不伪造完整覆盖或执行专有模型。
5. 原生进程退出后才验新文件、大小/SHA/mtime、成功/错误日志和真实执行阶段。单日志16MiB、导出128MiB、阶段磁盘256MiB、被监督进程内存1GiB上限；超限/超时/未知错误即停止。输出只本地保存，专有模型/完整网表不上传。

## 明确禁止

0 compile/synthesize/dev_map/pnr/report_timing/gen_bit_stream，0 GCC/Icarus/DUT/后布局仿真；不修改设计/时钟/约束/属性/复位/程序/B接口。允许工具内只读载入元数据，不允许写回/更新原DB或自动重建依赖。

不打开GUI、管理员、安装、许可配置、驱动或环境修改；不另启原生帮助进程。0 Debugger/服务器/设备枚举/JTAG/上电/下载/Flash，不改SCBV、供电、跳线或温控；over_temp STOP保持。

## 验收与停止

原始DB/冻结输入前后SHA同；实际只发生获批读取/导出。成功导出和连接核查分层，完整数据驱动未核实不记PASS；不以rc0、文件存在或网名相同代替逐脚证据。

若发现真实缺失/错误连接，仅报告最小修复建议，不改RTL/FIC/DB。4条Critical、CDC、实机采样和正式CoreMark不因导出或连接核对而豁免。阶段完成或门槛出现即停止，不自动重开GUI/重复构建。
