minzhetang/pangu-riscv-soc/deliveries/mainline-coremark-longrun-ready-scope-2026-10-27-v1/IMPLEMENTATION_SCOPE.md

# A-COREMARK-LONGRUN-READY-M2 / 实施范围1.0.0

2026-10-27，D159技术推荐；**PENDING，尚未实施/批准**。原D156的1次编译/1次DUT已用完，不据“恢复主线”自动扩大执行。

## 目标

在独立`work/fpga/2026-10-27-coremark-longrun-ready-m2`（冲突则唯一新目录）验证大流容器/主机预算路径，并仅运行一例性能种子8迭代程序，形成可度量准入。不开展160迭代或“仿真10秒即正式成绩”，不改CPU或新增ISA/SoC功能。B独立R1不作为前置等待。

## 最小修改范围

1. 复用F157的13功能RTL、同27MHz名义时钟、N234、GPIO0和官方算法/启动/链接/计时，全部SHA冻结，不改流水线、存储、外设或SCBV。独立复制源码、TB、检查器和两模型，保留before和准确diff。
2. A自己的stream_io/监督器升级为明确有界生产候选：每流raw<=16GiB、记录<=500000000、段<=16384、主索引<=16MiB先stat再读，整例无损归档含元数据<=4GiB；仍每段32768记录/每行256B、raw spool32MiB、单段<=8MiB；不修改同字节F153 block_codec。语义/字段/顺序不改，超界失败而非无限放宽。元数据与删除账本必须有界，清理限本轮已关闭并无损回读/身份核同段，失败保留；不触旧日志或用户成果。
3. 监督器采用同一绝对deadline，向分块压缩/回读/校验传递；处理一批归档时也检查预算/队列，不在回调返回后才检查。内存测量不可用须明确失败，不能None按0继续；只使用现有标准库/自身及本次进程，不枚举设备。以guarded非优化入口执行，冻结依赖断言不被-O绕过。记录VVP、父归档、参考与最终检查分项时间/峰值和观测局限。
4. 参考模型仅提高候选步数预算为25000000，ISA语义不改；冻结比较器迭代/周期限额改成按本case独立期望，原2迭代期望不动。TB保留全RF/RAM/每笔EX-WB-MEM、正常32拍尾、连续真实UART PIN及原生VCD窗口。可仅将每记录total计数累加移到关闭段时汇总，减少冗余解释执行；不改采样时刻/谓词或以少记记录换速度。不追求未经证明的提速比例，不为优化另开多轮DUT。
5. 只编译性能种子新C镜像：现有可信GNU裸机工具链，-O2/RV32I/ILP32及原宏不变，仅ITERATIONS=8；允许单次GCC链接构建及其必要objcopy/objdump/readelf/nm检查，不改六算法/port/启动/链接源码。检查ELF实际seed4=8、仅参数初始化差异及指令支持、预先独立参考CRC/全态/逐笔/计时/输出；不得用DUT回填预期。

## 顺序与验收

A. 先冻结计划/输入。对新CLOSED-SEGMENTS容器做主机正负控制：**真实顺序消费>512MiB**的确定性数据及1025个真实小段，逐字节还原/数量/索引核同、预算/坏尾/缺多乱序/不完整关闭拒绝，测峰值；这是host容器测试，重复旧记录不能当CPU程序或>4GB实际I/O验证。B ABI仍旧冻结512MiB，两种工具格式不静默混用。未实际消费>4GB不得宣称已验证。

B. 旧F151双种子2迭代只读重放，新检查器的所有严格字段/全态/有序副作用/计时/完整UART同旧；不重跑763例或旧DUT。新8迭代独立时序/ISA参考在新DUT前冻结，预算2500万步/900秒，已校准语义和真实MMIO时序不改变。

C. **仅1次Icarus编译**，120秒，普通非管理员现有工具，外部工具路由仍单独核准；失败即停，不盲试。**仅1次普通vvp性能8迭代**，32000000拍/2400主机秒。预估约24分钟只是两点条件估计，不是工期/性能保证，不执行验证种子新DUT。

D. 新全寄存器/32KiB RAM、每笔独立EX/WB/MEM及顺序/数量、不去重、stall/flush、真实计数时刻、phase/BSS、无算法区串口/端口错误、实际完整PIN/UART与原生窗口VCD检查全部符合先验；x/z、提前停止、重复副作用都失败。8迭代预期由独立参考给出，不用本分析的外推当oracle。保留SIM ONLY/非正式成绩；不能用VCD代ILA。

硬预算：所有新主机工作集<=512MiB（VVP同上限）、原生VCD256MiB、stdout/stderr各8MiB、spool32MiB、归档4GiB，参考900秒/2500万步、最终功能检查1800秒、主机容器控制900秒，整个已授权阶段墙钟总额<=7200秒（含处理/清理）；进入前确认本工作卷至少12GiB可用空间，不采集机器标识。原生工具/阶段deadline与资源读不到即失败，不只记录警告。窗口大小不因测试失败扩大。

## 停止条件/交付

工具错误、功能不等价、超预算、需要改13RTL/程序算法/已批接口或增加GCC/编译/DUT次数均停止，保留失败/未完成，不降低预期。单次C构建失败不重试；辅助检查命令各一次，输出异常即停。GUI/安装/管理员/许可/环境及外部权限不在范围。

交付准确diff/源SHA/冻结计划和参考、完整命令与真实rc/日志、新容器/窗口VCD/PIN及各层结果、资源分项和未验证边界。有限8迭代+host规模通过，只证明这些行为；不批准160次/新优化/正式长测，也不证明>4GB实际I/O/FPGA/温度。完成后报告再收敛下一范围，不自动延长。

over_temp STOP、F143稳定/F151校准、F146暂缓/F147告警保持；无PDS/服务器/JTAG/设备/上电/下载/Flash/供电/SCBV/跳线/温控。无需等待B R1，也不代B重写通用离线CLI。
