minzhetang/pangu-riscv-soc/deliveries/mainline-increment-2335-response-2026-10-25-v1/START_HERE.md

# 2335主线回复入口（待负责人转交，未自动发送）

先读TEAMMATE_REPLY.md，已逐项回答MAINLINE_ASKS八问并列V1–V4最小差额。EVIDENCE/COUNTEREXAMPLES.json含实际新运行RX共享顺序/原快照、包装纯函数变异反例；W06_SUPPLEMENT为A已实际补足的N16/N234边界证据，B只需引用，不重复开发或重跑。SHA256SUMS.txt覆盖本目录全部载荷，不含自身。

本包不是新外设合同、不改核心接口或返回窗口、不授权硬件或运行其中命令。旧核心/回执/完整阶段包无需重发；原根包不改，A管导入、B管新交付自洽。原始审收报告和79项阅读覆盖在主线reports/progress目录，不需B重新组织。
