minzhetang/pangu-riscv-soc/deliveries/mainline-increment-2335-response-2026-10-25-v1/TEAMMATE_REPLY.md

# 可直接转发B队员及其AI：2335审收、八问定案及最后差额

2335目录79文件已经主线完整核查：25全文阅读、54完整解析，全部5配置原VCD及继承/67个diff hunk核过；主清单78/78、新值76/76、源索引23/23匹配。清单SHA为F6D9D970...B9539C；90C45380...181441的ZIP SHA目前只记你方声明，A未见ZIP，不要求为此重发2335整包。**整体有条件接收：保留所有核心和包装，不重派核心开发；尚不能称验证交付最终全通过。**下面逐项回答MAINLINE_ASKS八问，替代继续等待式反馈。本文尚未由A自动发送，由负责人转交。

1. **接收与剩余项。**已接收、无需重复：原合同/回执、冻结TX/GPIO/RX及包装RTL、独立公开TX监视器已提交/正式与负测共用、36笔请求真实沿号/字段吻合、RX92/110/68有序内联事件及全部沿号、5e pre_FE=1→post_FE=0、失败传播修正、正常/负例原材料。已闭的项目不重做。剩余仅V1–V4验证/新包差额（见下），不改核心或外部合同。

2. **独立复现。**A用现有Icarus/vvp13.0、绝对路径从源码实际重建并运行包装计划1.0.3的N16/N234、RX计划1.3.3的N8/N16/N234和RX/共享TX捕获小负测；五配置逐端口独立模型检查均通过，原波形复核与新DUT分开记录。RX正式TB未改，另加只读final观察模块导出共享捕获数组，证明共享账本确实错序：N16 seq92/93应为ACCEPT B2→CONSUME B2，实为CONSUME B2→ACCEPT B2；同字节A1亦有相同交换，三配置各4处顺序差异。内联账本/RX核心均通过，不能把这个验证缺陷说成核心FAIL或整包全PASS。watchdog/非法参数和真实Windows清树本轮未重跑，只复核原日志/机制与现有纯函数控制。

3. **W06限制。**它是原合同必验边界，不能单靠声明gap豁免；现在A已经补证关闭N16/N234有限范围：E+10N完成沿按旧ready拒绝、不排队；E+10N+1合法沿接受一次，含同值重复正常帧。主线独立TB、两份新VCD/日志/结果在本回复目录W06_SUPPLEMENT，给定核心不改。**B不必再开发或重跑W06**，只在最终coverage_map引用A-W06-SUPPLEMENT及SHA；原1.0.3未覆盖事实仍留历史，不能把A运行冒称B旧run覆盖。A首份自写TB在time0初始化有X的失败也保留，已用显式复位事件的v2重新通过完整波形，未降低期望。

4. **GPIO1.0.2书面结论。**有限模块功能可接收，不再PENDING：F123的W1/W8/W16及负测已实际通过，核心SHA03380919...F95E、1.0.2计划BACF07BE...47BE/原TB SHA均回核；F139及本次包装N16的六次独立写/两级同步和系统既有使用继续支持。GPIO1.0.2是验证包版本，RTL仍原1.0.0。旧F123清树60.078/59.063秒失败不删除、不改成功；最终入口应明确采用已收1930 run_gpio.py（6CDDE2E5...034CC）与1735共享runner的组合，A已核实际委托关系，勿回退旧入口或声称本轮重做了Windows清树。无需再开发GPIO/全矩阵或重交旧包；最终新树入口与索引仍按V4核验。

5. **旧根包责任。**冻结handoff及其check_package的manifest/source-link失败继续留历史，不回写、不要求B无限修根，也不在本条另授权改旧根。A负责主线继承/导入映射和接收验收；B负责新最终交付自身入口、当前活动清单和依赖正确。旧根open记录可以保留，不阻断本次有限模块接收；新最终树自己的活动文件清单却必须自洽。无需为修新包元数据再等审批。若确需改旧冻结根，另由A说明最小范围后申请，当前不做。

6. **A系统边界。**CPU、同步存储、SoC适配、Timer/CoreMark、PDS/最终集成与报告归A。接收提示中的F141是当时快照；当前主线稳定F143，F146优化候选暂缓升级、F147只读告警收窄，均不新增B任务。本次没有因收包重跑CPU/CoreMark或升级系统/硬件验收。**A接入现有TX/GPIO没有再缺核心、包装或回执，不要求B补这类材料**；RX尚无包装/系统验收，不自动扩RX寄存器包装、FIFO/中断或硬件。只需下列验证差额/最终索引，B无需等待A厂家咨询/工具告警或新系统阶段。

7. **返回窗口。**仍为2026年10月27日18:00北京时间，不自动顺延。2.1h和剩余0.5–1h为你方当时估计，不是可无条件吸收新审查返工的承诺。请只反馈V1–V4真正剩余净工时、是否冲突原窗及未完成项，不重报全历史。若冲突，按原窗先交真实完成部分和未闭清单；A提出最小取舍、负责人决定，B不自行延期、取消RX、改合同或降低判定标准。

8. **最终格式与立即行动。**请形成一个新的stage-return-final-20261027-v01目录（已有则用唯一递增版），不覆盖任何旧包。必须有START_HERE.md、delivery.json、MODULE_STATUS.json、OPEN_ITEMS.md、CHANGED_FILES.json、准确DIFF.patch、SHA256SUMS.txt、SOURCE_INDEX.json、DEPENDENCIES.json、HISTORY_ALIASES.json、coverage_map；每项依赖写明增量ID/包内相对路径/精确SHA/版本和用途。改动文件保留work相对路径，新的验证计划先冻结；仅交受影响测试的新原始compile/run双日志（argv/cwd/工具版/原生rc/超时/截断/结束原因）、普通VCD、逐笔账本和results。旧已收依赖可以准确引用，不需重发全历史/核心/整包；A负责组合。不要用新版本文件冒充旧历史同SHA别名。目录+主清单即可，ZIP可选，提供时由A实算SHA，不能把2335缺ZIP当必补阻塞。**B现在立即做V1–V4验证端差额并最终封包，不等开工/接口重新批准；A负责后续必要差额复验与导入。**

## V1–V4：一次性最小差额与验收标准

- **V1（P0，B）：RX单一权威捕获、严格有序和同事件快照。**只动RX TB/共享capture/必要脚本和新计划。正式与负向真正共用同一捕获事件序列，逐笔一一比较type/data/事件沿或明确相位；不去重、不用集合/成员存在检查放行重复/错序。现行两层循环并非多重集证明；A还给出等数量不同频次仍放行的纯控制反例。每个真实事件先保存其沿前公开输入/输出，再在NBA稳定后取post（建议1ps观察，早于刺激在1ns撤销输入；若晚观察另列time）。N16第176沿CONSUME现在pre_ready记0而实际1、post_valid记1而实际0；5e第8081沿post_clear实际仍1，日志0是后来撤销后的值，pre_FE/OV已对无需重新补DROP。保留92/110/68及原功能预期，不改核心/回填值；检查A1/B2、A1/A1、重复频次、错序、DROP/CANCEL正负例，保持DUT reset/在途取消语义且不丢跨测试历史。不要把data沿前预置成新值来绕开真实NBA消费/发布。仅复验受影响RX三配置及最小共享捕获/状态控制即可。

- **V2（P0，B）：TX完整帧与取消口径。**监视器确已独立观察公开pin，这项提交事实已接收；但当前COMPLETE发生在stop中心后，分别比E+10N早7/116拍。现有六帧原/新完整引脚正确，不代表监视器覆盖了末半stop复位。保持独立串行捕获，在实际完整10N结束才记COMPLETE；之前复位应CANCEL，补一个末半stop复位最小控制，正式/负测用同一实现。若采用STOP_SAMPLE事件可以另记，但不能把它等同完整帧或用ready/last_tx_byte回填。原有6完整+3取消输入不改期望，新增边界独立子项，不改TX/包装RTL。仅跑受影响包装N16/N234及共享捕获小负测，不扩N8全矩阵。

- **V3（P1，B）：包装关联判定补齐最后字段。**已闭首edge、地址/strobe/error/ready/接受类型和36笔真实波形，无需重做。当前非首请求edge仅递增，busy未比、GPIO日志seq/edge与TX事件edge未关联；A改第二笔edge+1、翻busy、COMPLETE改999999、GPIO seq/edge改99/999999仍被正式analyze_run接受。把这些与实际请求/独立合同时间线对应并拒绝同类变异，不只针对例子写特判。正确控制必须继续通过；不更改DUT或已有预期。可与V2同批复验，别重复跑两遍。

- **V4（P1，B）：仅新包元数据，A配合映射。**主清单已通过，别重发2335。模块子清单仍引用过期PYC一项；最终活动清单排除缓存/VVP。RUNBOOK§6仍把231958称1.0.1；RX新functional_expected虽正确，event_ledger.expected_by_config仍旧40/39、49/48、28/27，另留106285/200000旧预算与status旧run号；在新版本中收敛单一权威值/明确历史，旧冻结计划不回写。HISTORY_ALIASES把1.0.2/1.3.2指到新版却标HISTORICAL不是同SHA历史；改成旧源精确引用或明确被新版取代/本地未交过渡版。002716结果已从0030找到同SHA原件，不是缺交；两个新history结果与当前结果同SHA，应标镜像而非虚构新DUT。新清单每个活动文件可定位/核SHA，所有版本标注一致，历史open保留。元数据-only不重跑DUT。

现在不需要新核心/CPU/SoC功能开发；确需改CORE/包装RTL或已批准接口时先交最小矛盾给A，不自行扩大。A不代B重写模块，不要求B承担A的计时/PDS/过温诊断。所有结论仍限纯软件，硬件STOPPED；无PDS/服务器/JTAG/上电/下载/Flash/供电/SCBV/跳线/温控权限。
