minzhetang/pangu-riscv-soc/work/fpga/2026-10-25-board-coremark-m1/IMPLEMENTATION_SCOPE.md

# A-BOARD-COREMARK-M1：已批准纯软件短基线复验

日期2026-10-25；D133。用户在F142唯一下一建议后明确“同意继续”，批准以已验板级13源为不变基线，复用F136性能/验证两个镜像、CRC与手工计划，执行新板级top/三沿复位/N234下的两个短CoreMark基线。

仅新增独立配置/初始化副本、TB观察、运行/检查脚本和证据，不改13个功能RTL、官方算法/软件端口、原镜像、原TB/预期、CPU参考和外设模型。先核完整SHA、冻结两个输入和计时/报告对照，再编译和运行。

编译固定2个目标、各120秒、首错停，已知普通上下文崩溃不盲试，新增非管理员沙箱外工具权限单独审批。两个普通vvp各6000000物理拍/360秒上限，trace/bus/nativeVCD每文件256MiB上限，普通窗口VCD；另从实际UART引脚连续记录变化，完整核全部报告字节，不能把停采VCD称全程波形。

检查完整32寄存器/32K RAM、每笔EX/WB及有序READ/STORE、不去重、12个真实计时LOAD沿前值、启动BSS零写、相位0/1/2/3/4、计算窗口零MMIO写、全部串口字节/帧时刻、正常EBREAK/返回和独立stall/flush计数。CPU无真实退休PC/统一提交，边界保留。算法原始ticks与F136同条件对照，输出等待单独报告，不以串口耗时冒充计算改进。

这是各1迭代/2K总数据的有限软件复验，保留上游不足10秒提示，不声明正式CoreMark成绩、全部CPU/ISA正确或创新收益。若发现功能失败，保留证据，不改RTL/预期或扩大范围凑通；验证端新错误可在独立新版本纠正并保留旧失败，不将重审当新DUT。

**不启动PDS/GUI或硬件服务器，不生成位流，不枚举设备/JTAG/上电/下载/Flash，不改SCBV/供电/温控，不安装/改环境/许可证，不执行破解软件或外发。**B沿F139原任务和10月27日18北京时间窗口，不重复派核心/索已收资料；over_temp STOP不变。

完成真实复验、质量对照、报告/记忆及普通Git工作单元同步后停止；新的优化/正式长测/硬件范围不自动授权。
