minzhetang/pangu-riscv-soc/deliveries/competition-source-package-2026-11-03-v1/package/baseline/o2-onchip/qualified-windows/matrix/matrix-waveform.png

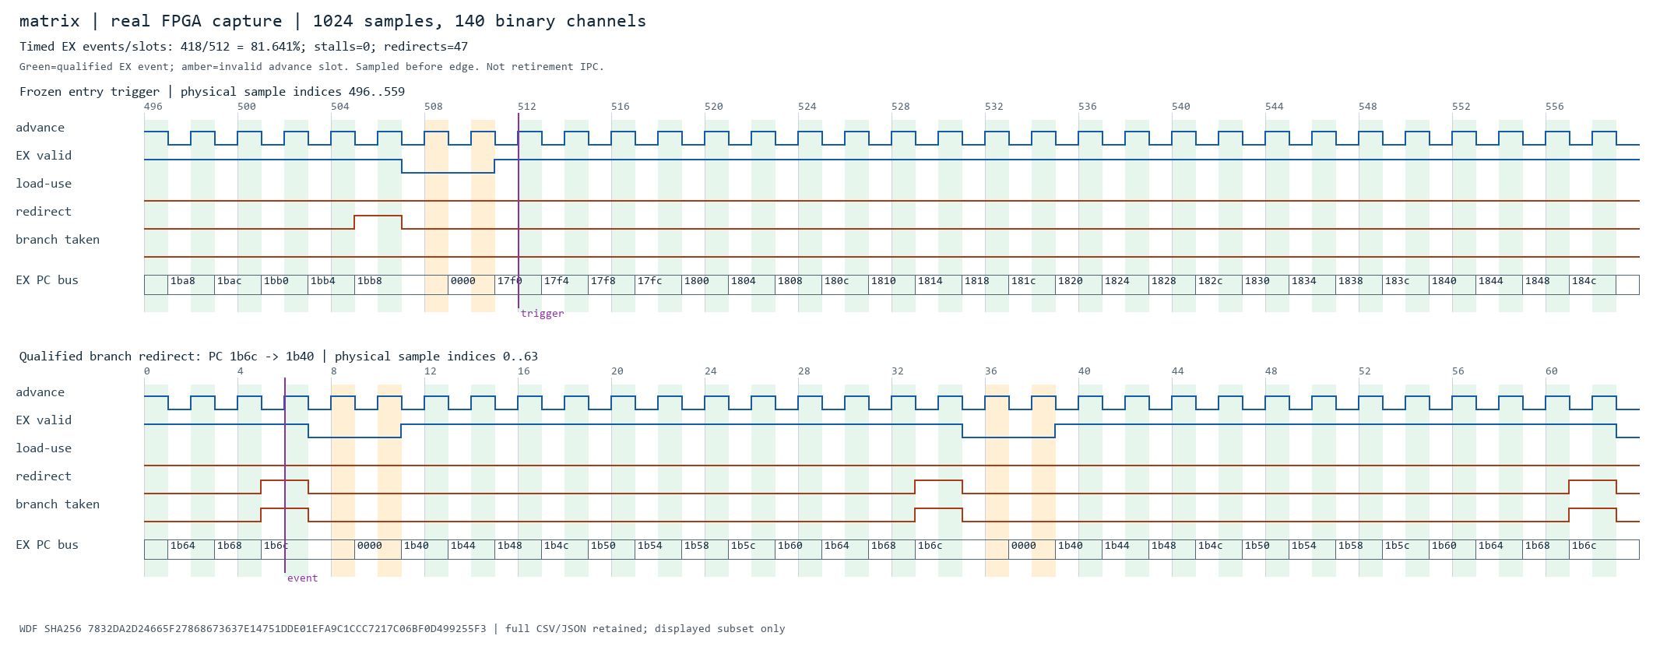
deliveries/competition-source-package-2026-11-03-v1/package/baseline/o2-onchip/qualified-windows/matrix/matrix-waveform.png
