minzhetang/pangu-riscv-soc/snapshots/2026-11-03-submission/report/figures/13b-list-detail.png

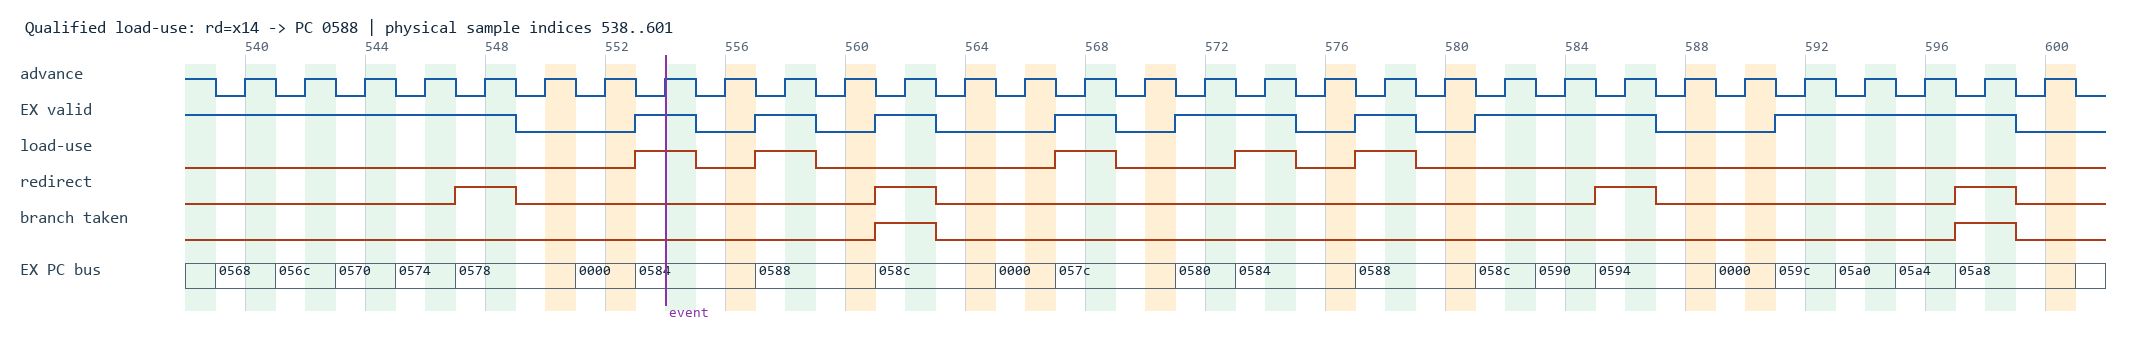
snapshots/2026-11-03-submission/report/figures/13b-list-detail.png
