minzhetang/pangu-riscv-soc/snapshots/2026-11-03-submission/report/figures/18-order-raw-text.pdf

UART raw text / order fault / recorded demonstration

REC2 002932e0 00000080 00000014 00000080 00000000 000002a7 14997309 00002112 00000000 00000003 00000000 00000001 00000001 00000001
E 02e5967d 00000011 00000002 00000001
E 04fd2bdd 0000001e 00000000 00000001
E 06c25b7f 00000029 00000001 00000000
END
