minzhetang/pangu-riscv-soc/(list of files, cad)

Other CAD files:
deliveries/competition-source-package-2026-11-03-v1/package/advanced/btb-mmode/project/work/fpga/2026-11-03-advanced-btb-offline-m1/pred0/device_map/board_top_hl4_dmr.prt
deliveries/competition-source-package-2026-11-03-v1/package/advanced/btb-mmode/project/work/fpga/2026-11-03-advanced-btb-offline-m1/pred0/place_route/board_top_hl4_prr.prt
deliveries/competition-source-package-2026-11-03-v1/package/advanced/btb-mmode/project/work/fpga/2026-11-03-advanced-btb-offline-m1/pred1/device_map/board_top_hl4_dmr.prt
deliveries/competition-source-package-2026-11-03-v1/package/advanced/btb-mmode/project/work/fpga/2026-11-03-advanced-btb-offline-m1/pred1/place_route/board_top_hl4_prr.prt
deliveries/competition-source-package-2026-11-03-v1/package/advanced/btb-mmode/project/work/fpga/2026-11-03-advanced-btb-offline-m1/pred32/device_map/board_top_hl4_dmr.prt
deliveries/competition-source-package-2026-11-03-v1/package/advanced/btb-mmode/project/work/fpga/2026-11-03-advanced-btb-offline-m1/pred32/place_route/board_top_hl4_prr.prt
deliveries/competition-source-package-2026-11-03-v1/package/baseline/o2-onchip/build/device_map/board_top_dmr.prt
deliveries/competition-source-package-2026-11-03-v1/package/baseline/o2-onchip/build/place_route/board_top_prr.prt
