minzhetang/pangu-riscv-soc/deliveries/competition-source-package-2026-11-03-v1/package/baseline/o2-onchip/build/multiseed_summary.csv

version,2022.2-SP6.4<build 146967>
project name,flow.pds
Single Seed:
Seed,State,Convergence,Setup(Slow),Setup(Fast),Hold(Slow),Hold(Fast),Recovery(Slow),Recovery(Fast),Removal(Slow),Removal(Fast),PBM-GP,PBM-PreGP,PBM-PostGP,LP,Total Placement Cpu Time,Detailed routing,Total Routing Cpu Time,Wire Length After Post-GP,Wire Length After LP,Wire Length After DP,Routing Arc Length,Worst Slack After GP Timing,Worst Slack After LP Timing,Worst Slack Before RP,Worst Slack Before DP,Worst Slack After DP,Worst Slack After Placement,Worst Slack After TA By Preroute,TNS After DP,TNS Before Route,Setup(Slow) Total Failing TNS,Setup(Slow) Total Failing Endpoints,Hold(Slow) Total Failing THS,Hold(Slow) Total Failing Endpoints,Power
single,OK,OK,20.033,22.098,0.158,0.113,33.099,34.480,0.352,0.249,NA,NA,NA,0.16,6.83,6.00,14.14,NA,NA,NA,62266,NA,NA,21334,21334,21334,21334,NA,0,0,0.000,0,0.000,0,NA
Pass Rate/Convergence Rate,100.00%,100.00%
Synthesize:
control_set,46
Synthesize Performance Summary:
slack category,Synthesize Setup WNS,Synthesize Setup TNS,Synthesize Recovery WNS,Synthesize Recovery TNS
slack value,25.527,0.000,35.710,0.000
Synthesize Process Cpu Time,0h:0m:8s
Device Map:
Device Map Resource Usage Summary:
Logic Utilization,LUT,FF,DRM,APM,Distributed RAM,HSSTHP,USCM,HCKB,RCKB
Used,2942,3838,18,0,0,NA,2,0,0
Available,66600,133200,155,240,19900,NA,32,96,24
Utilization(%),5%,3%,12%,0%,0%,NA,7%,0%,0%
Device Map Process Cpu Time,0h:0m:7s
Project Configurations:
top module,board_top
compile," -top_module {board_top} "
synthesize," -ads "
device map,
place & route,
Test Parameters Configurations:
testparam,
