minzhetang/pangu-riscv-soc/docs/repository/LATEST_RESULTS.md

# Latest project results — 3 November 2026

Start with the [submission snapshot](../../snapshots/2026-11-03-submission/START_HERE.md), [complete source package](../../deliveries/competition-source-package-2026-11-03-v1/package/START_HERE.md), or [technical report PDF](../../snapshots/2026-11-03-submission/report/技术报告.pdf).

The source package includes accepted SM2 CPU/SoC/software, the device-event application, independent BTB/M-mode and Cache/AI work, FPGA source/constraints, on-chip analysis and the required verification dependencies. Versions and verification layers are kept separate. The RAR is a submission artifact, not a replacement for browseable source.

CoreMark board measurements apply to the accepted baseline; BTB has strict short simulation and offline implementation comparisons, with >=10-second candidate simulation still incomplete. Cache/AI remain independent prototypes and synthetic FC data are not model accuracy. No new functional/hardware validation was performed for this sync. See the version table and report for the actual conditions and limitations.

The root README/CONTRIBUTION documentation review remains local and has not been silently approved or included. This entry makes the current evidence available without changing those pending documents.
