minzhetang/pangu-riscv-soc/reports/verification/2026-10-25-board-coremark-m1.md

# 新板级顶层的双种子CoreMark短复验：有限通过

日期2026-10-25（北京时间）；A-BOARD-COREMARK-M1；授权D133，实测F143/限定验收D134。

**已打通：F142真实引脚对应的13源板级顶层/三沿复位/N234 → 两个既有裸机CoreMark镜像真实CPU执行 → 独立计时/CRC/全状态/有序副作用 → 完整UART实际引脚报告 → 正常停止。**只有纯软件验证，没有新PDS运行、位流或硬件操作；不足10秒，不能报告正式CoreMark成绩或效率提升。

## 1. 基线、输入与保护

新独立H：`D:\A_FPGA_Comp\work\fpga\2026-10-25-board-coremark-m1`。13源来自F142 `D:\A_FPGA_Comp\work\fpga\2026-10-25-board-top-m1\source`，逐文件SHA相同，source-before保留。镜像、ELF、原CRC/手工计划来自F136 `D:\A_FPGA_Comp\work\system\2026-10-24-timed-coremark-m1`；未重跑GCC、修改官方算法/端口或生成新的软件版本。Git开始锚点`77dbf8ac88314d0bb21cfc169d82e0d6ee057065`。

- 性能镜像15912B，BIN SHA `B4CEEC1B250A5151C1D02F018FC45B3D22CDC049E12E26EFC2A0562D23740E60`。
- 验证镜像15920B，BIN SHA `26B4F9C2900141EC2EF3A19F4C75C831ED62A1F6E02B34C441501B0FF4E84429`。
- 两表完整反解：32K ROM逐字节匹配原bin及零填充，32K RAM初态A5；表SHA原样核同。性能表还与**F142实际PDS映射工程**的初始化表SHA相同，不再是只在通用逻辑顶层执行的镜像；验证表本轮没有另作PDS映射。
- CPU/ALU/control/RF、B核心/包装、计时/路由、生产存储和board_top/reset共13源均未改；两个独立Reference/ContractModel原样复制，v2原检查器/旧失败保留。只新增观测TB、GPIO释放输入适配的检查器、运行和审计脚本。
- 先冻结H/manual-plan、frozen-case-plan、compile-plan、source/input SHA，再执行。512项冻结来源/产物/工具结束核同。准确TB/CHECKER diff、consistency-receipt、postflight及最终SHA提供可回查证据；旧VVP/VCD未冒充新执行。

## 2. 实际编译与有界运行

现有Icarus/vvp13.0，绝对路径/-B/VPI；依据既有普通编译0xC证据，仅申请一次固定2目标非管理员外部编译，各120秒、首错停，均通过，44.437/44.187秒，许可用完。保留既有继承/未显式时间单位、官方模型隐式grsn警告；没有为消警告改RTL。未安装/改PATH/许可证或执行破解软件。

|本次新DUT|编译/加载/运行|主机秒|物理拍/推进|stall/flush|EX/WB/READ/STORE|
|---|---|---:|---|---|---|
|performance-N234|PASS|201.875|3784487 / 1892243|152691 / 285711|1168111 / 792281 / 190307 / 20529|
|validation-N234|PASS|209.235|3941007 / 1970503|153013 / 298540|1220391 / 826012 / 190574 / 20433|

每例普通vvp，600万物理拍/360秒上限，trace/bus/nativeVCD各256MiB上限；没有超时/截断/强杀。正常main返回0、SP恢复18000、EBREAK正常停止，尾部32拍无错误副作用。主机运行秒不是FPGA计时。原生波形约346/349KB；完整bus约110MB、trace约53/55MB，在执行前预算内，未裁剪日志凑通过。

## 3. 严格判定结果

|项目|性能种子|验证种子|
|---|---|---|
|seedcrc|e9f5|18f2|
|list/matrix/state CRC|e714 / 1fd7 / 8e3a|e3c1 / 0747 / 8d84|
|start/end实际tick|61967 / 2165615|62369 / 2325369|
|原始计算tick|**2103648**|**2263000**|
|完整UART报告字节|662|661|
|报告SHA|7CFAD89D76DE3D8E0459487A1352DAFB7E7BD5A90D60909940F54A54A825D3D2|D30594959A0504DB76566A7BF5F2D8C7A69EA67154C6D53987145E8A116F9A1C|

全32寄存器/32K RAM、每笔合法EX/WB和READ/STORE及各自顺序均同独立参考，不去重；末态RF/RAM还与F136旧运行逐字节相同。12笔真实计时LOAD逐笔核沿前c−1/高字0，空读取窗口仍26拍，单次start/stop、无port/timer/overflow错误；并未动态触达64位进位重试或溢出错误分支。

阶段顺序严格保留**0/1/2/3/4**，包括启动BSS在PC54的唯一零写；没有再次过滤/遗漏它。计算计时区0笔MMIO写，UART全部在阶段3之后；CRC/数据量/迭代数/报告SHA在DUT前冻结，未按DUT回填。新输入GPIO为实际四键全部释放，不影响算法；没有修改旧3c/c3刺激或其预期。

原上游“Must execute for at least 10 secs”和“Errors detected”仍在RAM和真实串行报告中。这里的PASS表示**有限功能、计时及输出检查通过**，不等于上游正式成绩有效。27MHz为已约束/文档标称的软件设定，尚非实测板载频率；约0.077913/0.083815秒仅为该设定下的折算，不宣称CoreMark/MHz或优化收益。

## 4. 完整UART与窗口原生波形分开

新TB一方面生成明确停采的普通原生VCD，另一方面从**实际UART输出端口变化**连续记录时间、物理拍、clk/reset/引脚值；未用刺激数据/预计字节合成引脚记录。H/audit_uart.py独立校验连续变化与每位234拍的关系，并用另一中心采样解码全部8N1帧，与冻结报告及逐笔合法TX STORE时刻对照：

|观测|性能|验证|
|---|---:|---:|
|连续PIN记录/实际UART跳变|3834 / 3832|3818 / 3816|
|首帧/末帧起始物理拍|2224739 / 3782055|2383615 / 3938575|
|末帧完整结束拍|3784395|3940915|
|原生VCD稳定沿后检查|2719|2749|
|可见物理拍数|2183|2183|

真实pin时间戳按37037ps量化时钟严格对应cycle，首个CPU有效posedge为277777ps；每个计时LOAD在原生VCD都有沿前捕获值，沿后独立计数/相位核验另列。窗口覆盖启动、12读取、算法边界、输出转段和停止；各9个明确off时间段不伪称采到了全算法流水线。

连续UART文本是全输出端口观察，**不是全程原生VCD，更不是片上ILA**。4种真实PIN日志损坏副本（漏跳变/错位值/错时间/重复跳变）全部拒绝，原证据不变；另1控制+4种合成解码拒绝仅为解析器自检，均0新DUT。完整全状态检查器沿用已验v2语义，只将环境GPIO计划改为0，不把旧F136负例算成本轮新跑。

## 5. 计算与等待的质量对照

新旧算法计算窗口的**逐笔事件和值、绝对物理拍顺序**归一换行后SHA完全相同：性能`C9632771A168FB5EC2CE23894973B40F0C5512295BABA75795049DD85F949269`；验证`632C6D6368F014C746A17B6FD66E3C3F9F5F22E923B773AE8762355ABEF80186`。因此F136已验参考分类可以有条件沿用，而不是宣称本轮重新做了全波形空泡审计：

|计算窗口组成|性能物理拍|验证物理拍|
|---|---:|---:|
|2×EX观察|1464532|1570464|
|2×参考load-use|41428|42440|
|4×参考重定向|597688|650096|
|边界残差|0|0|
|合计|2103648|2263000|

重定向部分约占计算tick的28.41%/28.73%，固定两拍执行占69.62%/69.40%；这是当前模型的观测归因，不是退休CPI。软乘法`__mulsi3`仍为432424/485282个EX观察的热点，未据此擅自加M扩展/改算法/预测器。

|区间|性能旧N16→新N234|验证旧N16→新N234|
|---|---:|---:|
|计算|2103648 → 2103648|2263000 → 2263000|
|计算结束至UART阶段（格式化等）|59088 → 59088|58210 → 58210|
|UART阶段至完成|113906 → 1559702|113734 → 1557346|

结论：**计算无退化、无提速；输出等待按N234增加**。不能拿不同串口参数下全程序stall/flush或总时间比较CPU优劣，也不能把少打印字节包装为计算更快。H/quality-compare.json注明旧分类复用条件，0额外DUT/重放。

## 6. 资源、协作、安全及局限

性能实例与F142**13源+初始化表+N234**一致，可关联F142真实PDS实现/引脚/内部27MHz有限时序证据；本轮没有重新综合、修改约束或核许可证。F142的1805LUT/1519FF/14DRM、7条constant-probe、5异步输入/9输出无外部delay及许可最后提示余9天均属上一轮记录，不升级为本轮测量；请及时官方续期。

没有连接/上电、服务器/枚举/JTAG/下载/Flash/SCBV/供电/温控操作，over_temp STOP不变。B的F139原验证/最终包整改及10/27 18北京时间窗口保持；本轮1323个系统实际串行帧支持TX在该系统/参数下的有限行为，不自动关闭B整包条件/RX账本缺口，不重派核心或索已收材料，无新外发/送达事实。

有限种子/2K/单上下文/各1迭代，固定存储/初态，无真实退休PC或统一WB-STORE提交；无完整ISA、全部计时回绕/进位/任意热复位、正式≥10秒、实机/片上波形或创新收益。原生VCD不是完整算法波形。原失败、512保护项和所有源/输入保留，当前结果不抹掉历史问题。

## 7. 交付与唯一下一建议

H/RESULTS.json、COMMANDS.md、consistency-receipt、postflight及最终SHA为入口；compile-plan/result、simulation-result、各原生process/stdout/stderr、trace/bus/全态、uart-pins、nativeVCD、uart/wave-audit、quality-compare均对应本次新产物。专有模型/工具、镜像大表及大原始产物留本地，不随Git分发；Git并非干净克隆一键复现保证。

下一唯一建议：**A-COMPILE-QUALITY-M1，先核适用CoreMark规则，再只比较-O2→-O3的低风险编译优化**。保持13RTL/算法/数据/种子/迭代/地址/时钟/UART不变，如实更新编译描述；同一判定标准实测ticks、CRC、完整副作用/输出、代码/栈大小及现器件PDS资源/27MHz裕量，失败或无收益则保留O2，不扩M/Cache/预测器。具体范围见H/NEXT_QUALITY_SCOPE.md，**这是未批准/未实施的建议**，本轮到此停止，不先承诺提升或把编译开关当架构创新。
