minzhetang/pangu-riscv-soc/reports/verification/2026-10-25-board-top-m1.md

# A-BOARD-TOP-M1：真实板卡接口的纯软件适配，有限通过

实施与报告日期2026-10-25（北京时间）；资料核对始于10-24。D131授权，F142/D132限定验收。**没有位流或硬件操作，over_temp STOP不变。**

已将F141逻辑SoC接入独立板级顶层：15个真实引脚、27MHz/234拍UART、KEY0复位、四按键GPIO及8LED；完成新的短C真实执行、完整公开波形和目标PDS实现。不是完整CDC、板上运行或正式CoreMark验收。

## 1. 基线、范围及证据

- 新目录H：`D:\A_FPGA_Comp\work\fpga\2026-10-25-board-top-m1`；前期资料E：`D:\A_FPGA_Comp\work\fpga\2026-10-24-board-top-m1\evidence`，原件/既有副本保留，没有移动覆盖。
- 基线F141：`D:\A_FPGA_Comp\work\fpga\2026-10-24-implementability-m0`，Git开始`ab23ac2a837c38b312e49c2b4c3687b7292f2fae`。H/IMPLEMENTATION_SCOPE.md及APPROVAL.json记录用户在唯一板级建议后明确“同意继续”；原D130未批准建议保留为历史。
- 11个既有源逐文件SHA核同，CPU/ALU/control/RF、B包装/TX/GPIO、路由/计数器及存储功能均未改。新增board_top.sv、board_reset_sync.sv、短C、TB、局部检查器及工程/约束；source-before、models-before保留。原TB/输入/预期不变，不重跑763矩阵。
- H/frozen.json共438项，执行结束核同；准确新增源码diff、完整命令、输入和新产物SHA见H/SOURCE_DIFF.patch、COMMANDS.md、postflight.json与SHA256SUMS-final.txt。所有“本轮运行”仅指下面3个DUT进程，模型/负例/波形重审分列。

## 2. 板卡原件与实际引脚

板厂原件：`D:\A_FPGA_Comp\盘古100Pro+开发板（MES2L676-100HP）配套资料\教程1_硬件实验指导手册_盘古676系列100Pro开发板.pdf`，V1.2，SHA `F2FB07625A0A31705D7E8477308F7BCB1AA5272B6B0754CFBF9DACA20EBEC114`。PDF实际23、43、44、50、51页全部重新渲染、完整视觉核对电路/表格，印刷页19、39、40、46、47。页PNG/text、来源/归档收据在E，H/evidence-review.json列完整路径和SHA。

|本顶层端口|板卡连接|依据|
|---|---|---|
|clk|D18，27MHz有源晶振|T1实际23/印19；原demo FDC|
|key_n[0]|C22，KEY0，低有效|T1实际50/46按键上拉/接地电路与表；原key_led FDC|
|key_n[1..4]|C23、B22、A22、B20，KEY1–4低有效|T1实际50–51/46–47|
|uart_tx|C24，FPGA UART输出至板载USB串口|T1实际43–44/39–40；原uart FDC|
|led[0..7]|A20、C18、C19、E18、A17、A18、C17、B17，高亮|T1实际51/47电路/表；两个原demo FDC|

逐包范围（不只外层文件名）：

- `D:\A_FPGA_Comp\盘古100Pro+开发板（MES2L676-100HP）配套资料\2_Demo\2_7_key_led_test.rar` → `2_7_key_led_test\2_7_key_led_test\source\key_led_test.fdc`及key_led_test.v/tb、.pds：48条目目录安全核、4相关文本全文读取；本包无目录中嵌套归档。SHA `5BFE2D18021E87767ABF8C6AFC57EFA888B51A3F40B0882A1116CE7E3F7B62C6`。
- `D:\A_FPGA_Comp\盘古100Pro+开发板（MES2L676-100HP）配套资料\2_Demo\2_8_uart_test.rar` → `2_8_uart_test\2_8_uart_test\uart_test.fdc`及4个source/*.v、.pds：51条目目录安全核、6相关文本全文读取；本包无目录中嵌套归档。SHA `9A2FFB9D0AA30D51E07076E3794DB623C6979AD01BD3B4888CD8926DDCE9A1BE`。
- 只从完整目录选定文本至独立E/demos，大小/CRC/SHA核对；路径穿越、绝对路径、非空链接、加密/异常体积检查，无包内执行。未检查包内其他构建数据库，不能写成全部工程已重建。教程2仅相关文字复用，不作本次引脚权威。

官方uart顶层BPS_NUM=234覆盖子模块默认434；它的计数器语义不直接套用到B核心。本项目使用B合同及新波形证明**每位精确234个物理拍**。名义27MHz下为115384.615 baud，相对115200约+0.1603%；不是实际晶振频率/USB链路已测。

## 3. 新顶层的选择及边界

- KEY0：异步断言、3个上升沿后同步释放；冷配置初态0。不会改变B核心内部复位极性/CPU时钟边沿，无分频新时钟。没有消抖或最小脉宽/物理亚稳态MTBF承诺。
- KEY1–4按下取1，对应GPIO低4位，高4位固定0；8个LED直接接GPIO_OUT，高电平亮。没有把原8位3c/c3输入伪装为四按键可表达，新短C按真实接口读数，旧输入不改。
- 仅TX接入，未添加RX包装或功能；stop_pc/kind/error等诊断留内部，TB层级只读观察，未接到未知板针。软件不读取其他8位实际外部输入或宣称8个按键存在。
- H/source/board_top.sv SHA `AFC24C2EA643FD75AA4FD2C3E88B70B985A2BEE481A99A2ACD92224F16946478`；board_reset_sync.sv SHA `BE24D161CFB60F7C4D2C2EF0CF53A7D98049915189DBF150A6CEED6129070152`。

## 4. 先冻结预期，再执行

新board_smoke.c使用原启动/链接布局，RV32I/ILP32；真实data复制、BSS清零、GPIO输入/重复写/读回、6帧UART、签名及EBREAK。手工计划H/manual-plan.json先于DUT，参考逻辑的GPIO输入由冻结按键方案和独立两拍模型得出，不拿DUT返回值设预期；GPIO写5a、5a、a5和两帧AA均不去重。

新C最初被GCC15.2 `-Werror`拒绝：16项字符数组未留NUL。仅在新私有C改成自动长度数组保留终止符，索引0–15语义/手工预期不变；失败源码、日志、空build/board保留，成功件为build/board-v2（612字节）。不是CPU编译/功能错误，不降低编译告警要求。修正C SHA `D81343FDEA016B65E848FB2AD9FFBBDBF23AB728D41F0F7299E1E8BB9109734D`。

GCC/objcopy/nm/objdump/readelf实际执行成功，ELF32/小端/rv32i2p1核验；模型16个键值通过，仅使用标明STATUS总ready的合成环境，**0个DUT**。两处旧独立逻辑Reference/ContractModel不改；新checker只适配实体键输入、固件地址及手工结果，不改ISA/外设语义。

## 5. 新编译和三个实际DUT运行

现有Icarus/vvp13.0，绝对路径/-B/VPI设置；依据旧普通0xC/PDS Win623证据，不在本轮盲重试旧失败启动上下文。新工具审批限定非管理员2目标编译及1次PDS CLI，已用完。编译各120秒上限，reset0.125秒、board51.438秒，0错误；board保留既有继承/未显式时间单位、官方模型隐式grsn警告，未动原RTL消警告。

|新DUT|结果|墙钟秒|关键证据|
|---|---|---:|---|
|复位单元|PASS|0.109|17个明确检查：冷配置未按键、停钟保持、非时钟沿异步断言、3沿释放、再次按键重启释放链|
|board5-N234|PASS|1.719|完整RF/32K RAM/有序EX/WB/READ/STORE、GPIO/串口/stop正确，输出B5\r\nAA|
|board12-N234|PASS|1.829|同一612B程序、同一预期方法，真实KEY1–4另一组合，输出BC\r\nAA|

两个C例各14567物理拍、7283推进、1181stall、1192flush、tail32；EX3699/WB2452/READ1194/STORE32。stall/flush由独立指令流模型计算，非按DUT回填；所有事件逐笔核对、不去重，全RF/RAM含栈和BSS，返回0、SP恢复18000、EBREAK正常。运行器45秒/100000周期上限，普通VCD，0超时。主机秒不是FPGA运行时间。

## 6. 新波形及检查器质量

- 三份新VCD完整逐行/时间组解析：复位46组/46条件；两系统各29258组/87650条件。独立模型核每个时间组复位链和真实键位反相映射，逐有效沿重建UART/LED；模拟时钟37037ps周期（1ps量化），不是宣称晶振精确实测。
- 两系统6帧起始均为物理拍369/2727/5085/7443/9801/12159，完整234拍/bit、8N1；VCD独立中心解码结果与每笔TX STORE时刻/数据相符。GPIO接受267/277/287拍，对应5a/5a/a5；重复5a接受从请求/真实core接受证据核，不能单靠LED不变判断重复写。
- 新checker另作1正确控制+8损坏证据拒绝：错WB、重复WB、漏GPIO STORE、错UART引脚、错GPIO映射、x0错误、RAM签名错误、进程失败。仅隔离副本，无新DUT/原证据改变。
- 两个新只读审计器初版分别漏处理首#0前空组、PDS端口名后空格；在结果输出前纠正解析，未改RTL/预期、未重跑DUT/PDS。H/diagnostics-preserved.json保留解释，不把解析失败归咎CPU。

## 7. 实际PDS板级实现

PDS2022.2-SP6.4 build146967，PG2L100H/-6/FBG676，top=board_top；CLI compile → ADS synthesis → dev_map → pnr → report_timing实际完成，74.422秒、rc0/无超时，退出后检查本次新报告。未执行gen_bit_stream/服务器或GUI。当前许可证checkout成功、提示余**9天**；需及时官方续期，不从提示推算精确失效时刻，也未读取/记录授权内容/机器标识。

PDS使用F141同一performance CoreMark初始化，便于资源比较，**不是该程序在新板级top已运行**。28个GTP18K的完整参数/1792段INIT与F141合成网表逐段相同，初始化表SHA同；PnR仍保留28门/14DRM36。RF992 FF INIT0保留；复位3 FF的初态、异步清除、D=1→q0→q1及输出q2链实际保留。GPIO低4位双级8 FF保留、高4位恒0优化，既有11源SHA全部同基线。

|项目|实际结果|
|---|---|
|引脚/电气约束检查|94条约束，0 error/critical/warning；15个IO位置与冻结表一致，全部BANKL3/3.3V/LVCMOS33|
|PnR资源|1805 LUT、1519 FF、14 DRM36/155、15 IO/300、0 APM、0 latch|
|慢角内部setup/hold|23.279ns / 0.185ns，4685端点，无失败|
|快角内部setup/hold|28.647ns / 0.129ns，4685端点，无失败|
|慢角内部recovery/removal|33.991ns / 0.751ns，344端点，无失败|
|快角内部recovery/removal|35.065ns / 0.518ns，344端点，无失败|

以上为最终`pds/report_timing/board_top.rtr`。最差setup为soc/cpu_core/ex_rd[2]→前推/ALU/冲刷控制→if_inst[27]使能，15逻辑级、逻辑2.448ns/布线10.956ns。工具估计72.6850MHz只属于本镜像/布局/约束，不作实测或整板Fmax。

相对F141的1806LUT/1555FF和估计79.2896MHz，因诊断口移内、GPIO高位固定、新复位与真实引脚改变布局而不同，**不能算CPU优化/效率收益**。目标仍27MHz，没有提频或修改CPU。

## 8. 尚未关闭的边界

- **引脚约束零警告≠全部外部时序已约束**。STA仍有5个异步按键输入、9个UART/LED输出未设外部延迟；没有厂家预算就不虚构delay/false path。内部复位recovery/removal通过不覆盖原始按键脉宽/去抖/亚稳态、异步输入MTBF或完整物理CDC。
- 7条`Loop was found during constant probe`仍来自compile/sdm2adm、数量与F141相同，无具体网名。相关前后常量传播上下文已查、官方Timing Analyzer手册未提供该字符串解释；现有仿真/综合/STA不足以关闭根因。既不判真实组合环，也不宣布无害，不因此擅改CPU。
- 忽略B非法参数保护的$display/$finish、x0/未用诊断/高GPIO位清除警告原样记录；CPU主要层次、RF/存储/计数/外设仍存在，不是空设计。没有独立解码PDS二进制INIT/位流读回/后布局功能仿真。
- 新DUT仅两个稳定按键组合和复位单元，16键遍历是模型而非DUT。无任意热重启内存/RF清零保证，无RX包装/新ISA/正式CoreMark/硬件/ILA结论。SCBV工程决定、实际供电未知及over_temp STOP不变。

## 9. 证据入口及下一唯一建议

H/RESULTS.json为分层汇总，compile/simulation/pds-audit、wave-audit、checker-negative-result、manual-plan、firmware-result、pin-plan和evidence-review分别给独立范围；完整命令/进程/stdout/stderr/波形及全SHA留本地。PDS原run/flow日志可能自动含授权来源/主机字段，忽略且不复制到报告/Git；不分发工具/专有模型/大初始化或波形。本阶段保留失败诊断和冻结基线。

下一唯一推荐：**A-BOARD-COREMARK-M1纯软件复验**。以本次13源为不变基线，复用F136两个既有CoreMark镜像/CRC/手工预期，新增独立测试配置、必要观测/检查器与运行脚本，在真实板级top、复位、N234下执行两个短基线，核计数窗口/原始ticks/全状态/有序副作用和662/661字节完整公开UART；使用有界运行和明确窗口VCD避免无限大产物。模型检查与DUT分列，不改CPU/B/算法，不用较长串口时间冒充计算改善。

**此为新验证阶段建议，尚未实施，需另批固定编译/运行范围；无硬件/位流/PDS新构建授权。**短运行仍不能取得≥10秒正式成绩、实机/片上证据或创新收益。B沿F139原验证收敛/10月27日18北京时间窗口并行，无新包/送达/工期事实，不重复派核心或索已收材料。本阶段报告/记忆/Git同步后停止。
