minzhetang/pangu-riscv-soc/deliveries/competition-source-package-2026-11-03-v1/package/verification/peripherals-frozen-v02/MAINLINE_ACCEPTANCE/START_HERE.md

# v02主线接收回执

2026-10-25，F152/D151。转发TEAMMATE_REPLY.md即可；无需ZIP/整包/新审批，本文未代发。

- TEAMMATE_REPLY.md：R1–R3结果、五问及B现在动作。
- ACCEPTANCE.json：分层有限接收收据。
- IMPORT_MAP.json：只读固定当前v02，核心同SHA不覆盖；RX未系统集成。
- 主报告：reports/progress/2026-10-25-stage-final-v02-review.md。

原包PASS_LOCAL不回写，硬件STOP保持，旧根OPEN_PREEXISTING未关闭。
