minzhetang/pangu-riscv-soc/deliveries/competition-source-package-2026-11-03-v1/package/verification/peripherals-frozen-v02/FROZEN_V02/stage-return-final-20261027-v02/OPEN_ITEMS.md

# 未完成项 / Open Items（v02）

- R1/R2/R3 local closure only; mainline reproduction/final acceptance remain external.
- W06 closed by A-W06-SUPPLEMENT, not a new B run; B's old gap remains historical.
- GPIO 1.0.2 finite review accepted; no rerun or full matrix.
- Root handoff manifest/source-link failure remains `OPEN_PREEXISTING`; no root edit, no PASS claim.
- A owns CPU, synchronous storage, SoC, Timer/CoreMark, PDS, final integration/report.
- RX register packaging, FIFO/interrupt, full bus, formal timing, PDS/JTAG/power/Flash/board/thermal and hardware remain out of scope.
- Hardware state: `STOPPED`.
- Old F123 60.078/59.063 s cleanup failures retained; not rewritten.
- v01 and all old increments remain read-only and are referenced, not re-sent.
