minzhetang/pangu-riscv-soc/deliveries/competition-source-package-2026-11-03-v1/package/verification/streaming/project/work/fpga/2026-10-25-compile-quality-m1/NEXT_SCOPE.md

# 唯一下一建议：A-CONTROL-FLOW-QUALITY-M0

2026-10-25，D136建议，未开展，不是新RTL/TB/模型修改或执行授权。

问题：O3没有计算收益。F136/F143已核计算窗口的参考重定向成分约28%，固定两物理拍执行结构约69%；这是有限参考分类，不是退休CPI/全波形或可实现收益承诺。不要继续盲试编译开关，也不因软乘法热点直接添加M或改算法。

最小下一工作：只读有效O2整组源码、现有EX/WB/MEM轨迹、反汇编及既有同步存储约束；把JAL、JALR/返回、条件分支、实际taken分别计数，对齐现有流水级/取指延迟/前推/load-use/EEI停止与冲刷顺序。选至多一个收益可解释且返工可控的减泡方向，给出涉及文件/最小模型或TB变化、必须维持的副作用顺序、旧风险回归和两个CoreMark比较条件。

验收：形成可核数据和明确“可实施/收益太小/需扩大范围”判断；停止于方案及一次实施范围请求，不开始修改或新构建/仿真。无可信小范围方案则保留原结构，不为创新标签强做重构。最多推荐一个具体局部方向，不预设Cache/预测器/全异常机制，不改B任务/接口/承诺，不恢复硬件。

原D135编译实验已完成并按停止条件拒绝O3；下一实施必须有清晰范围并另行确认。正式≥10秒/FPGA运行/ILA、7条constant-probe根因和外部时序等缺口继续存在，不能被本建议豁免；over_temp STOP不变。
