minzhetang/pangu-riscv-soc/deliveries/competition-source-package-2026-11-03-v1/package/verification/system-origin/project/work/system/2026-10-23-memory-timing-m0/verification-v2/RESULT_MATRIX.md

# M0 v2完整CPU逐例结果
|程序|组合IF/组合DATA|同步IF/组合DATA|组合IF/同步DATA|同步IF/同步DATA|
|---|---|---|---|---|
|P01|PASS / 17周期 / stall1,flush0|FAIL / 18周期 / stall1,flush0|PASS / 17周期 / stall1,flush0|FAIL / 18周期 / stall1,flush0|
|P02|PASS / 24周期 / stall1,flush0|FAIL / 25周期 / stall1,flush0|FAIL / 24周期 / stall1,flush0|FAIL / 25周期 / stall1,flush0|
|P03T|PASS / 19周期 / stall1,flush1|FAIL / 20周期 / stall1,flush1|PASS / 19周期 / stall1,flush1|FAIL / 20周期 / stall1,flush1|
|P03N|PASS / 19周期 / stall1,flush0|FAIL / 20周期 / stall1,flush0|PASS / 19周期 / stall1,flush0|FAIL / 20周期 / stall1,flush0|
|P04|PASS / 19周期 / stall0,flush1|FAIL / 20周期 / stall0,flush1|PASS / 19周期 / stall0,flush1|FAIL / 20周期 / stall0,flush1|
|P05|PASS / 15周期 / stall0,flush0|FAIL / 16周期 / stall0,flush0|FAIL / 15周期 / stall0,flush0|FAIL / 16周期 / stall0,flush0|
