minzhetang/pangu-riscv-soc/reports/verification/2026-10-29-formal-coremark-readiness-m0.md

# 正式CoreMark软件预检：保留硬件基线，先补齐计量软件

2026-10-29，F179/D193。承接用户“继续主线”，按前轮已说明的**只读预检**执行。0源码修改/编译/参考执行/新DUT/PDS/GUI/硬件；46个输入SHA前后同。B0由用户收到后转回，目前未收到，不以此阻塞A的软件准备。

## 结论与取舍

最小下一实施范围不是继续导出网表或改CPU，而是：**在独立副本完善测量端口/报告与验收，做双种子短程回归，再产生双种子256迭代的独立参考和可交B的程序/初始化候选。** 不跑两个256迭代RTL长仿真，不生成新位流，不声明正式成绩。具体范围已备但未批准。

当前8迭代软件和对应F163位流不改。CPU/SoC/计数器/存储/外设均可保留；“正式程序”这里仍指待实测候选，只有B合法实机证据和最终审核齐全才可成为有效测量。

## 原件与已核事实

|问题|代码/规则与实际旧数据|判断|
|---|---|---|
|Timer宽度|F160 port/core_portme.c:stop_time使用64位差并拒绝>UINT32_MAX；header CORE_TICKS32，RTL Counter64；timer.h高-低-高读取|27MHz下10秒270000000tick，32位接受上限约159.072863秒。无须为10–20秒先改CPU/Timer或加中断；仍不证明真实时基|
|计时单位|cycle_counter64每物理时钟推进，CPU SYNC_MEMORY1每两拍推进，timer.h真实MMIO读取|频率分母使用物理时钟，不能把core MHz改为13.5以人为翻倍CoreMark/MHz；内存/CPU同物理钟1:1，另注明流水推进节拍|
|整数秒/显示|HAS_FLOAT0，coremark.h secs_ret=ee_u32；time_in_secs整除27000000；官方barebones允许HAS_FLOAT0或1|整秒不是非法实现，也不是硬件计数器精度不足。保留此端口，不引入浮点库；主机用原始delta与真实频率算精确有理数/小数，整数Iterations/Sec仅原显示，不当精确成绩|
|旧短测输出|8迭代16829452tick/名义0.623313秒，输出time0、至少10秒错误和Errors detected；算法三CRC分别e714/1fd7/8e3a|是已验有限功能结果，不能把Errors删掉算正式。旧checker硬编码要求不足10秒提示及formal_score_valid=False，需要明确短测/测量候选两类判据|
|main返回|core_main最后return MAIN_RETURN_VAL，coremark.h在当前配置定义0；与total_errors无关|EBREAK/返回0/exit0都不是正式验证成功证据，必须核报告成功信息、全部CRC/错误、计时、版本及原始输出|
|标准CRC与crcfinal|官方README/主代码识别performance e9f5、validation18f2及三固定算法CRC；最终crcfinal与迭代有关|不能复制8迭代ccd1到256；正式候选必须独立参考先验。标准成功文字也不能代整个CPU/硬件证明|
|双种子与编译|已认证固定commit的README Run Rules要求性能/验证两组、2000B、相同flags/类型，允许改移植端口和迭代，六源不改|新阶段同时交两种子候选，非只性能N256；不新增PGO/训练/M/C扩展。完整flags/内存布局必须可追溯|
|自动迭代|CoreMark iterations0会多次start/stop搜时长，现port已拒绝0|保留固定次数，不开启不受控自校准或破坏旧单窗标准|
|工具|五个现有GNU exe SHA与F114安装清单同，版本来源仍原xPack15.2.0-1/GCC15.2.0|只读字节身份复核，没有新版本查询/安装/工具链构建；新Icarus编译仍核工具权限|

全部具体代码行见`work/analysis/2026-10-29-formal-coremark-readiness-m0/CODE_ANCHORS.json`。官方README/barebones两文件重新对原source-integrity-review哈希核同，六算法/头文件也同；本轮未联网。原链接为固定提交README#run-rules及barebones_porting.md，不拿最新版推翻既有commit。

## 迭代选择与边界：只是条件推算

按性能2→8两点、验证1→2两点，各自拟合物理计算tick：

|N|性能名义秒@27MHz|验证名义秒@27MHz|状态|
|---:|---:|---:|---|
|128|9.9730|10.7306|性能推算不足10，不推荐卡边|
|160|12.4662|13.4133|只推算，不是已跑/保证；余量较小|
|192|14.9595|16.0959|只推算|
|256|19.9460|21.4612|推荐的固定27MHz候选，两组有余量且远低32位上限|

性能拟合ticks=2103679*N+20，验证=2263490*N−490；后者只有早期两点，不假称8迭代验证种子已实跑。**这些不能写进冻结预期替代参考执行，也不能替代真实≥10秒。** 新参考与B实测可能不同；发生不足/溢出/CRC错时失败并给具体差异，不能静默改频率/次数/预期。改实际频率或显著提速的候选必须重新检查时长，256不是永久通用值。

## 推荐的有界软件阶段（仍待批准）

`A-FORMAL-COREMARK-SOFTWARE-M1 /1.0.0`：

- 原S整组功能RTL/算法/启动链接和既有成果不改；新端口C/H完善可追溯flags/内存描述、时钟参数和诚实候选标记；保留整数秒、64原始值及32位拒绝规则。只新建program/INIT，生产memory绑定变化只限初始化数据。
- 四C构建：performance/validation各2迭代短测、各256迭代候选。两短测各一次新RTL编译/一次新有界DUT，核全态/每笔合法EX/WB/MEM/UART/时序和错误副作用，既有原始8记录保持不变。
- 四个独立程序参考：两短程+两256，全参考在对应新DUT或硬件前冻结；正式模型只作为先验，不当DUT。参考ISA语义不改，仅独立副本的步数守卫允许5M/250M、case限时300/1200秒，保留每笔期望事件的生成和摘要、RAM/RF/CRC/时序/报告。摘要只是先验身份，不替代短程实际逐笔比较；256尚无DUT逐笔验证仍明确保留。
- 主机精确计量/报告检查：原始tick/频率、128/256/≥10边界、32位超限/64差值、缺失/重复/错CRC/报错/返回0假成功、缺实机证据均有明确拒绝标准。软件最多输出候选状态，不可自证实机正式有效。
- 256两程序只编译和独立参考，不新RTL长跑、不PDS。给B新的清单/程序/INIT/源身份与独立预期，旧交接包不回写。B0/B1/B2旧8基线不等这些新材料；B3实际准入/执行权限仍另批。

总硬上限2小时、内存512MiB、输出/参考文件显式限额；正式参考按旧8性能6.30M步/18.625主机秒作吞吐量级参考，两256约数分钟至十余分钟各仅是估计，不能承诺。现Reference.step和oracle均有25M守卫，必须明确只在新副本调整预算，否则长参考会必然提前失败；不扩大ISA语义或放成无限。精确预算/停止在scope。

## 历史与新证据的关系

159秒范围、HAS_FLOAT0和旧短测耦合已有F150证据，本轮复核，不冒充新发现。新增的是当前8程序/工具身份锚点、256带余量提案、main返回判定风险与物理MHz报告边界的集中落实，以及避开长DUT的双种子候选验证路线。未产生新程序/CRC/正式成绩，也不宣称256可执行已证明。

旧交接包MANIFEST/SHA未改，原件46项同。用户报告已转B但B0未收到，主线自主软件准备不代管B平台；1.3.0旧网表导出待批保持，当前不继续。硬件STOP、SCBV工程假设、R4四Critical/连接/CDC边界都不解除。
