minzhetang/pangu-riscv-soc/reports/progress/2026-10-27-measurement-path-and-window-profile.md

# 主线正式测量路径与流水线窗口分析（只读）

2026-10-27，F162/D163。**下一优先是让已验证的CPU短程序形成可核准位流；暂不把约11.2–14.9主机小时的双160仿真设为默认动作。** 当前已打通C→片内同步存储→CPU→Timer/UART软件闭环，仍缺CPU位流、CPU实机、真实时基/正式双种子测量和片上波形。本轮0C构建/0RTL编译/0新DUT/0ISA模型运行/0PDS/0硬件。

## 新取得的证据，而非重跑旧测试

只顺序消费F160已归档trace，逐块核原索引/压缩块/原字节和SHA，不修改归档，不调用CPU参考。实际计数**11317031条/274238774B**，与原完整流数量/哈希一致；用原ELF静态函数表和镜像字解析PC，仅作分类。794条输入/片段索引与块前后SHA核同，17.282秒、峰31404032B。8个赛题原件SHA同F118；本轮复用已视觉核证据及固定官方commit两份规则正文，不重新渲染指南或声称重新打开官网。

计时器LOAD读数61967→16891419，差16829452物理ticks；按已设置27MHz约0.623313秒，**不是实测板上秒数**。事件c对应同沿前timer=c-1，统计区间为**61968<c<=16891420**，不得混用时钟沿前后或取指/退休PC。

|计时窗口项目|实际留存轨迹统计|
|---|---:|
|EX事件|5858143|
|WB事件|4036358|
|READ / STORE|440048 / 114704|
|两拍模式下逻辑推进槽位|8414726|
|EX事件/逻辑槽位|69.617751%|
|EX事件/物理tick|0.348089|
|未观察到EX的逻辑槽位|2556583|
|相邻EX间隔2 / 4 / 6物理tick|4496996 / 165710 / 1195436|

这些是EX发射事件密度和间隔，**不是退休IPC/整机利用率，也不能仅由缺EX把所有损失准确归因stall或flush**。4/6间隔提示后续控制流/依赖捕获重点，仍需同沿控制信号闭环。原F160整程序stall297886/flush1332226含启动和串口，不混作本表计时窗口计数。

函数`__mulsi3`占窗口EX **3459392/5858143 = 59.052707%**；状态转换537536、链表521008、matrix_mul_matrix_bitextract356256。最高热点PC0x3528/0x352c/0x3534/0x3538均在软件乘法例程，各579584次。**这不是59.1%的时间占比、异常或已实现加速**。它说明纯RV32I下软乘成本应在报告中解释；不据此擅增M扩展、改官方算法、绕过乘法或恢复F146候选。

ILA_EVIDENCE_DRAFT按原ELF给出链表、矩阵/软乘和状态转换窗口以及id_pc/id_valid/advance/stall/flush/现有timing_phase写事务选点。它只是主线技术草案，未植入/使用ILA，也没有要求队员返工。

## 软件测试通过与正式结果之间的距离

官方EEMBC固定commit1f483d5b8316753a742cbf5590caf5bd0a4e4777的本地README Run Rules明确：>=10秒、2000B、性能及验证两组种子校验、统一编译选项/类型；barebones说明强调用外部时间参考检查计时。两份本地原件路径在INPUTS。无需再次安装GCC或为跑分扩ISA。

当前port仍写死SIM ONLY/NO VALID SCORE，HAS_FLOAT=0和整数time_in_secs是允许的配置，但会截断显示；应保留原始ticks并用有理数精确分析，不能把格式变漂亮当提速。实际8迭代报告有**Errors detected**；官方core_main在不足10秒时递增total_errors，短程预冻结报告也包含该结果。正常返回/CPU有限检查通过不构成官方有效跑分，不能删该行或删短时长检查来宣称合格。

未来160若按短点线性外推，性能/验证名义时长约12.466/13.413秒；依两次已有采集速度，**仅两DUT**条件主机估计约11.21–14.89小时，尚不含参考/最终检查/构建。不同输入/主机负载/采集实现并未受控，非工期保证、先验oracle或速度收益；原F159约15.34小时是当时条件，不静默改成实测。

160程序/参考尚未构建或执行；现8版TB32M拍、参考25M步、checker明确要求短警告等仍不适用正式长测。生产候选上限16GiB/4GiB不是已实际验证全部最大体积。即使未来仿真足10名义秒，仍缺真实FPGA时基/运行/ILA证据。B离线ABI仍512MiB/6M行，不作为A长测必需依赖或偷偷扩其合同。

## PDS的真实差距及最小下一阶段

旧F142 PDS流只到report_timing，不含gen_bit_stream，使用1迭代ROM；新8迭代ROM与旧ROM仅**offset15904: 1→8**一字节不同，新表逐字节等于15912B镜像+零填充。这证明镜像来源可追溯，**不证明8镜像已被PDS实现**。

初版只读预检按13文件直接SHA比对被memory_model拒绝，保留`work/analysis/2026-10-27-measurement-path-m0/PREPARATION_NOTE.json`。回查原件表明PDS生产形式将INIT内联并去掉M0_VERIFY只读验证视图；12文件字节相同，memory_model按该确定性转换后非空白字符完全一致。没有改任何功能源或测试预期，也不把不同文件形态静默当“13份生产文件SHA一致”。

唯一推荐新阶段**A-BOARD-COREMARK8-BITSTREAM-M1**：新独立副本复用F16013源/8镜像和F142引脚/27MHz约束；不改CPU/软件，不新增GCC/Icarus/DUT，最多1次PDS普通CLI全流程生成.sbit。验收新ROM/RAM INIT逐块、真实器件/资源/最终内部时序、SCBV及全部警告、退出后鲜产物和SHA。沿D010只在新位流生成明确High Voltage；实际配置供电仍工程假设，过温STOP不变。

详范围`deliveries/mainline-board-coremark8-bitstream-scope-2026-10-27-v1/IMPLEMENTATION_SCOPE.md`，SHA **BB1D768FBB82166753982CC5167569215A31606675B6D42A959DE7E976753B9D**，**PENDING：本轮没有执行或批准**。PDS1800秒/阶段2400秒、单次；现有许可正常checkout失败就停，不读许可内容或改环境。先得到无调试基准位流，可用于之后短程序bringup与ILA插入开销对照；不把基准位流当最终含ILA作品。

## 关键路径与截止前检查节点

|顺序/负责人|通过标准与边界|
|---|---|
|当前A：保护F160/软件质量分析|本轮已完成新窗口统计、镜像差距和可核scope；无CPU改动或新加速结论|
|下一A：获批后CPU短程序位流|新鲜.sbit+INIT/引脚/最终时序/告警，仍未下载；独立于B资源工具|
|A/用户/平台：真实CPU短程运行|须先解除安全相关阻塞并单独授权平台/实体动作；再实际核CRC/UART/计数，不凭POWER或bitstream通过|
|A：可信正式计量与双种子|另明确port/时基/迭代与检查器范围；先校准真实时钟/Timer，再满足>=10秒及官方CRC，不少做工作或去打印换收益|
|A：ILA/定向打磨|明确捕获同沿语义/范围，抓链表矩阵状态关键算法；据瓶颈挑一项有可比收益/代价的改进，不预设M/Cache/预测器|
|A+B/用户：冻结作品材料|按既核表单匿名PDF、代码RAR、<=3分钟H264视频、照片与签字授权逐项形成。模块/仿真材料可复用，硬件和创新缺口如实保留|

按现有已核同年公告，截止仍为11/4 18:00；本轮未重新联网查新公告。建议10/27–28完成软件位流准备，10/28–30将安全可用平台/实际CPU与计量取证列首要条件，10/31–11/2冻结报告/视频，11/3核格式/匿名/入口并留上传余量。它们是检查窗口，不是工期/安全保证；若到10/29仍无可用平台证据，需要负责人决定合法远程平台的真实账号/费用/硬件权限或接受缺口，不用软件长跑替代。

旧许可10/25提示9天仅属当次记录，不推算今日余额/精确到期，下一PDS只读脱敏实际提示并提醒正规续期。7条constant-probe、14个外部IO时序/真实CDC、核心板供电和过温解释均未在本轮关闭。

B仅原D158/G1–G3资源差额，回复送达/ETA未知，原10/27 18外设窗口不改；A不重复其外设或等它整包。当前唯一人类动作是批准上述具体PDS纯软件构建范围；无需接线、登录、上电或扫描。
