minzhetang/pangu-riscv-soc/reports/verification/2026-10-27-coremark-longrun-ready-m2.md

# CoreMark长跑准入M2：8迭代有限实测

2026-10-27，F160/D160–161。**保持13功能RTL和算法不变，完成可信8迭代执行及大流主机守卫验证。** 不是完整RV32I验证、正式CoreMark成绩、160迭代或FPGA实机验收。

## 已打通的真实流程

同一O2/RV32I/ILP32程序仅将ITERATIONS=2改8 → 单次GNU构建/ELF与单字节镜像检查 → 预先独立ISA及MMIO时序参考 → 单次Icarus编译 → 单次有界8迭代DUT → 分段无损归档 → 全RF/RAM、逐笔EX/WB/MEM、计时、串口及窗口VCD核验。

|层次|实际证据与结果|
|---|---|
|主机容器规模|真实逐笔消费571018176字节/5898240条bus记录，1025个实际trace小段；每行重新生成核对、回读字节/SHA/数量一致。13项含一正及拒绝控制通过，另3项容量/实际回调期限控制与-O明确拒绝；不是CPU或>4GB测试|
|旧双种子重放|新检查器全严格结果与F151 JSON核同，完整PIN串口审核通过；原2迭代输入/期望保留，0旧DUT重跑|
|新C程序|仅一次GCC及必要辅助命令，各原生0；实际ELF seed4=8，二进制与旧性能2迭代仅一字节2→8。算法/port/启动/链接不改|
|独立先验|6295556ISA步，预期物理18515827，计算16829452ticks，crcfinal=ccd1，663报告字节，在DUT前冻结；与旧线性估计不同，未用估计替代oracle|
|编译|1次，原生0，46.109秒；3类warning，路径归一同旧=True|
|新DUT|1次performance8-N234/GPIO0，原生0，1063.828主机秒；正常STOP及32拍尾，无额外运行|
|功能|完整RF/32KiB RAM、每笔合法EX/WB/MEM及各自顺序/数量不去重、独立stall/flush/计时、BSS/phase及副作用一致；物理18515827，stall297886，flush1332226|
|输出/波形|663完整实际UART字节及每次PIN变化核同，原生窗口VCD前后沿/计数采样通过；不是全算法波形、统一提交/退休PC或ILA|
|实际容器|381段、12445398条、385945602原始字节→78600149含元数据归档字节；本轮各已关闭段逐字节回读并核身份后删除spool，失败夹具和历史输入保留|
|资源|spool峰4235365B；归档父峰45666304B；最终检查峰231190528B；参考峰81182720B。实际VVP峰见logs/run-performance8-N234/process.json；各工作集<512MiB|
|保护|555原件及60执行冻结输入SHA核同；13RTL/外设/官方C及参考ISA语义不改，无PDS或硬件动作|

## 代价、观测和真实限制

参考18.625秒，最终检查74.890秒。归档编码6.098、解码逐字节核验2.808、源身份复核与删除0.605秒，这些父进程片段与VVP并行/等待有重叠，**不能直接相加为串行总耗时或因果比例**。VVP及父CPU时间见SUMMARY/原process；不同长度/负载的执行不构成受控提速实验。TB把冗余total逐笔累加移到闭段汇总，字段/时刻/事件谓词未变，未声明收益比例。

每流raw16GiB/500M条/16384段/index16MiB、整例归档4GiB是明确硬上限，不是所有上限已实测；主机规模仅>512MiB和1025段。内存测量缺失、绝对期限、超限均失败；stage_clock同一绝对7200秒未重置。直接子进程和父进程测峰，GNU/Icarus内部孙进程峰没有独立测量，不夸大观测范围。CLOSED-SEGMENTS为新验证路径，raw/F153兼容读取不是所有最大规模均已验证。

独立参考25M步/900秒、DUT32M拍/2400秒、最终检查1800秒等均在批准范围。本次计算16829452/27000000约0.623313名义秒，报告保留SIM ONLY和不足10秒警告；不等真实FPGA频率或正式分数。无真实退休PC/统一WB-STORE顺序、固定内存及初态限制保留。

准备顺序曾导致一次旧重放找不到尚未完成的build-result.json，原始stderr/rc保留；诊断为元数据未就绪，在构建完成后用唯一新日志目录重放通过。该次未跑DUT、未获得/篡改功能结果；C/RTL/DUT均未重试。附加回调期限负控的首个辅助包装曾因错误文本大小写断言失败，实际守卫正确抛出ABSOLUTE_DEADLINE；原脚本/夹具保留，独立新回调与精确错误码复核通过，记录在controls/extra-guards.json。

## 入口、复现和下一步

`work/fpga/2026-10-27-coremark-longrun-ready-m2/`：SUMMARY、SOURCE_RECEIPTS、APPROVAL、TEST_PLAN、oracle-freeze、frozen-inputs、IMAGE_DIFF、EXACT_DIFF、COMMANDS、REPRODUCE、SHA256SUMS及postflight；build/compile/DUT-attempt各1。oracles为先验；replays明确旧数据；controls明确主机；runs/performance8-N234含新archive、全态、实际PIN/VCD和functional/check/UART/wave结果；logs含所有真实命令/rc/资源。

下一优先完成**正式测量路径与初赛证据缺口的只读决策**：以本次实际时间/容量更新长跑成本，判断名义160迭代的证据收益；CPU/系统已有闭环，不再自动追加数十小时仿真来冒充FPGA成绩。新长跑/优化/工具/远程或本地硬件均须明确范围/权限，不能复用这次已用完1+1。B R1独立、不重派外设、不等待其整包；原10/27 18窗口保持。over_temp STOP及F146候选/F147告警保持。
