minzhetang/pangu-riscv-soc/reports/verification/2026-10-27-coremark-longrun-budget-m0.md

# 主线恢复：采集成本与长跑准入复核

2026-10-27，F159/D159。**当前2迭代验证可信，但仍未具备直接开大长跑的条件。下一推荐只修生产有界限额/观测守卫，再做一例8迭代软件准入，不优先投入十多小时去追“名义10秒仿真分数”。**本轮只分析旧记录和源代码，0编译/新DUT/ISA重放/PDS，39输入SHA前后核同。

## 真实数据与成本

|性能种子trace|计算前字节|计算窗口字节|计算后字节|总记录|
|---|---:|---:|---:|---:|
|1迭代|894338|30245577|22115060|2171228|
|2迭代|894338|61075019|22121969|3477732|

窗口严格按已有start_ticks<cycle<=end_ticks划分，仅是trace体积/事件分类，不能拿它拆分主机耗时。两种子4份完整旧trace共11557928条逐行分类，并与原分类总数/字节核同。计算前后体积近似固定，计算窗口随迭代增长；UART计算外输出不计CPU算法提速。

F151旧性能DUT320.390秒，F157新449.313秒，观测多128.923秒/比值1.402394。新TB静态增加9205338次按记录total/count整数更新，并有逐笔fd/满段分支；实际只142次关闭归档。**这是开销线索，非因果归因**：旧数据没有逐段encode/decode时长或受控主机负载/进程CPU时间，不能认定gzip或某条语句贡献了多少秒。主机归档压缩不改变计算4207378 ticks或CPU效率，不包装成创新。

## 确实需要解决的限额

|现限额|两点条件外推首次超过（性能/验证）|判断|
|---|---|---|
|参考500万步|7 / 6迭代|8迭代已会触及，需要新预算，不是新ISA|
|每流512MiB raw|17 / 16迭代|增大DUT拍数并不能绕过容器拒绝|
|每流1600万条|12 / 11迭代|独立记录上限仍会拦住|
|1024段容量|26 / 24迭代|清单大小/段数要显式有界，不能无限载入|
|DUT800万拍|8迭代外推18515679拍|现1编译/1DUT许可已用完，新增执行仍须批准|

上表是现源常量与两次实际测量的条件推算，不是相关迭代已经跑过。格式位数、打印/轮询与数据相关代价可能变，不得把外推当冻结预期。

另静态发现A自身监督器也应改进：工作集读不到时当前保留maximum=0继续，归档回调执行期间只在返回外循环后检查总deadline/队列。**本轮没有故障注入证明这些路径**；F157实际测量可用且449秒正常结束的有限结果保留，未来生产准入必须fail-closed并把deadline传入分块工作。对A和B采用同一证据标准，不因B整改就省略A守卫。

## 长跑价值与量级

按最新吞吐与1/2迭代差分，160迭代性能/验证trace分别约49.56/52.69亿原始字节、约6406/6834段、约1.176/1.261亿参考步；仅双DUT条件估计约15.34主机小时，未包括参考/最终检查/失败返工。按名义27MHz计算区约12.47/13.41秒。以上均非实际长跑/保证工期；替代此前旧管道约11小时估计在当前管道上的适用性，旧记录保留。

**名义时钟仿真到10秒仍不能代替FPGA真实时基、实机CoreMark成绩或ILA。**硬件STOP未解，当前不值得无条件把双160长跑作为下一默认动作。先做可控生产准入与较长合法程序功能验证，把超大预算留给证据收益明确的阶段。

## 唯一下一推荐范围

`deliveries/mainline-coremark-longrun-ready-scope-2026-10-27-v1/IMPLEMENTATION_SCOPE.md`1.0.0，状态PENDING。独立副本：13RTL/ISA语义/算法/启动链接不改；主机raw/索引/段数与期限/测量守卫有界适配，真实>512MiB与1025段仅host容器控制，旧双2迭代只读等价；然后一份-O2/RV32I性能C镜像ITERATIONS=8、一编译、一新DUT，先独立冻结全态/每笔流/时序/串口预期。8迭代外推约6295562步/18515679拍，DUT约24分钟，实际需新预先参考确认，不把该外推当oracle。

计划总墙钟硬上限2小时，参考/检查/编译/运行分预算；预估整个阶段约30–60分钟仅作安排，不保证。主机资源限额和文件删除规则按已准备scope，不把所有caps静默改无限。可将total累加从每记录移到关闭段汇总，属于有限采集封装改善，不另开多轮提速试验。B R1独立推进，A不重写其工具也不等整包。

当前只完成本只读分析/具体提案，**没有新镜像/代码实施/编译/DUT或长测授权**。用户只需决定是否批准该具体M2范围，外部Icarus工具权限仍另核；无需硬件操作或重新提供旧材料。现有过温、F146候选/F147告警、正式时基/CDC/FPGA/ILA等边界保持。

证据：`work/analysis/2026-10-27-coremark-longrun-budget-m0/INPUTS.json、TRACE_PROFILES.json、FORECASTS.json、*-thresholds.json、CODE_ANCHORS.json、SUMMARY.json、POSTFLIGHT.json`。旧源码和数据未覆盖，条件推断与源/数据事实分列。
