minzhetang/pangu-riscv-soc/deliveries/mainline-b-verify-offline-m0-2026-10-26-v1/KNOWN_LIMITATIONS.md

# 限定用途

- 新A离线适配器1.0.0只支持固定trace/bus快照；非生产在线采集/独立ISA oracle，不改A的现有live checker。
- 四旧流的黄金与输入身份相同，重放核工具；不宣称新CPU功能或流水线/性能验证。原全状态/算法正确性仍以F151和主线参考为准。
- 比较周期也是字段；未来CPU优化改变时间轨迹不能直接拿这份黄金判架构错误，须A另定版本/参考。
- 冻结codec每输入512MiB、assert模式依赖，故禁止-O。压力上限不是长测多GB已就绪，>32位周期不等>4GB文件I/O。
- 只有B交付并经A复现后才能评工具可接收；A准备自检不代替B完整故障/压力套件。
- Windows已有Python为必测，其他OS未实测；不新增依赖。硬件STOP、A-M1待批不因本包变化。
- Git只纳管小型合同/代码/种子/清单；本地完整派发目录含大归档，克隆Git不等拿到所有载荷。转交整个实际目录。
