minzhetang/pangu-riscv-soc/deliveries/mainline-b-verify-offline-m0-2026-10-26-v1/TASK_CONTRACT.md

# B-VERIFY-OFFLINE-M0 / 合同1.0.0

日期2026-10-26，D155。用户已同意收窄方案并整理任务包。**任务范围批准，收到且核验可开工；通知送达/回执/工时承诺不是已知事实。** 本合同新增离线质量支持，不改已验收v02及其冻结身份/原窗口。

## 分工与边界

B在新的独立目录开发：
- `RUN.py`参数化离线入口，复用冻结 `records`/`compare`，输出稳定结果及原生退出码。
- 首错类别/1起始序号/期望实际/有限邻域；逐字段逐笔消费，不去重、不掩码、不以摘要代替记录。
- 独立故障生成、负向控制、限额及超时、真实规模压力、中文/空格路径与独立目录复现。完整矩阵见ACCEPTANCE_PLAN。
- 源码、冻结测试计划和人工预期、原日志、命令、资源实测、结果/局限/SHA的一次集中返回。

A拥有并冻结 `frozen/`、输入、格式、验收标准；A保留CPU语义参考、在线记录器/UART采样/计时、全状态/系统验收与最终集成。现离线adapter为新A准备层，沿用旧比较原则，不是字节照搬生产CPU检查器。B不另造ISA模型、压缩格式或替换生产内核。

## 禁止范围

不改CPU/ALU/控制器/SoC、公共参考、冻结TB/预期、旧包及公共项目记忆；不采集新DUT、不执行Icarus/ModelSim/编译器/PDS、不建在线归档/删除spool。不操作设备、上电/JTAG/Flash/SCBV/温控。无新增安装、GUI/管理员、许可/系统环境、联网账号/外发授权。

仅普通用户运行已有可信Python标准库。运行器只执行本任务已审查的Python worker；**不接受任意外部命令，不创建孙进程**。可复用自己已验收的有界执行经验，但不得重新开一套通用Windows清树项目或引入历史目录依赖。硬超时终止并wait自己持有的worker，清理8秒、总188秒；保留原生rc/异常/截断，失败不成功化。

冻结API有缺陷/格式缺口：先保存最小输入、期望/实际和原因，集中问题单返A；不得改冻结代码、降低标准或回填预期。独立既定用例可继续；关键内核阻塞则返回PARTIAL及明确未测。A不保证一次交接永不返工。

## 审收与停止

B先冻结计划及人工预期再跑工具；故障数据在新目录生成，原输入只读。故障用例预期被拒绝可以是“测试PASS”，但被测RUN仍须返回真实非零拒绝码，不能输出MATCH。

A收件分层：材料完整、B自测、A本机复现、ABI兼容、系统集成、硬件验证。B自测只写PASS_LOCAL，不称主线验收/CPU正确/正式CoreMark。A保留独立预冻结验收样例，不据B实测改标准。

目标约一工作日，以实际回执/可用工时为准；到工作块边界交真实成果和OPEN_ITEMS，不无限扩展。A-M1不以本包全部交付为前提；新B任务不解决旧samples列表内存或缩短VVP拍数的承诺。
