minzhetang/pangu-riscv-soc/deliveries/mainline-b-verify-offline-m0-2026-10-26-v1/TEAMMATE_PROMPT.md

B及其AI：

现派发 B-VERIFY-OFFLINE-M0，合同/ABI1.0.0，2026-10-26，D155。只做独立离线质量与可移植复现工具，收到本包且核清单即可按范围开工；不等A的M1新采集格式或GPIO/RX新审批。

立即按START_HERE完整读合同、接口、验收/种子和冻结代码，使用已有Python执行VERIFY_PACKAGE和包外SMOKE_CHECK。在自己的新目录回RECEIPT：实际接收时间、manifest/合同/接口/验收SHA、Python、可用净工时及预计返回。约一工作日目标须你依据容量确认，原10月27日18:00外设窗口不变；冲突一次报清，别虚构承诺或自动顺延。

随后独立完成RUN.py、首错诊断、故障/压力/搬目录复现及一次集中交付。复用frozen读取与compare，逐笔逐字段核对、保留重复，SHA只核身份。先冻结自己计划/人工预期再跑；把负例“预期被拒绝的测试PASS”和被测RUN非零拒绝码区分。不要因日志有PASS/exit0或生成结果就断言通过。

真实四流只是已验收旧DUT记录的重放黄金样本；手工种子只是格式样例。它们不是独立ISA参考，不是新CPU仿真或CoreMark正式成绩。不得声称本工具已解决A在线UART内存问题或减少CPU执行拍数。

本包包含输入及冻结API，不需要索取旧大包/历史工程或重开发TX/RX/GPIO。无需修改旧根、重新封v02、跑DUT、接设备或装软件。CPU/公共参考/TB/预期/主线记忆只读；A保留在线采集、语义、系统集成和最终验收，A-M1仍PENDING。

按25类验收自主完成普通技术选择，避免每小步问A；内核缺陷/真实协议冲突集中给最小复现+期望实际，冻结代码不自行修。其他独立既定项可继续，关键阻塞如实PARTIAL。不要扩成通用进程清树/压缩框架或增加依赖。

最终只需集中返回B-VERIFY-OFFLINE-M0-return-v01/，按DELIVERY_REQUIREMENTS逐项：源码、冻结计划、逐例结果、原日志/rc/命令、压力与搬目录证据、SHA/来源及未完项。65MB原输入不必重复发送；实际包SHA需匹配。A收到后独立审代码和复现，再分层给结论；你只标PASS_LOCAL，系统/硬件未验。

原v02冻结/已有接收、W06/GPIO结论和硬件STOP不变；无新CPU/REGIF/PDS/Flash/外部通信授权。完成或净工作块到点交真实状态，不等待无限完善，也不降低标准。
