minzhetang/pangu-riscv-soc/reports/progress/2026-10-26-b-verify-offline-m0-dispatch.md

# B离线质量工具任务包：已备齐，待人工转交

2026-10-26，F156/D155。用户采用F155/D154的收窄建议，现准备 **B-VERIFY-OFFLINE-M0 / 合同与ABI1.0.0**。收到并核验可在合同范围开工；A尚未代发，B实际接收/开工/容量/工期承诺未知。A-M1仍PENDING，硬件STOP保持。

## 给用户与B的唯一入口

请转交整个 `deliveries/mainline-b-verify-offline-m0-2026-10-26-v1/`，从START_HERE.md和TEAMMATE_PROMPT.md进入。无需分散发送旧工程、v02或主线历史。实际133文件、132条SHA、64664150B（约64.7MB十进制），无须安装或仿真器。

任务是：复用A冻结读取/比较API，完成离线CLI、逐笔首错诊断，独立故障/限额/压力及搬目录复现，一次交源码、冻结计划/人工预期、逐例结果、原日志/rc/命令、资源与SHA。25类验收涵盖缺/多/重复/乱序/坏尾/损坏容器/假成功/路径/期限等；每侧1/16/128MiB真实消费，不能用hash代替逐笔。

A没有替B实现RUN.py或完整故障/压力套件。新A适配器从既有逐笔/EOF原则拆出离线API，不宣称字节照搬生产检查器；F153codec原样复制。四旧流共9378498条为已验收DUT观察重放黄金，不是独立ISA参考；7手工种子不是CPU程序运行。A保留CPU参考、在线UART/MMIO/采集与系统语义。

## 实际A准备验证

|动作|原生结果|核验内容|
|---|---|---|
|原目录VERIFY|rc0，0.204秒|133文件/132SHA全等，无额外文件|
|原目录SMOKE --include-real|rc0，15.578秒|7人工种子状态与首错序号；新增离线逐笔读取3477732条旧trace两遍，完整消费MATCH|
|复制至“移植检查 空目录/task”后VERIFY|rc0，0.188秒|相同manifestSHA，独立副本|
|中文空格路径SMOKE|rc0，0.219秒|7种子相同结果，cwd位于包外，不引用主线历史|

以上为A入口准备验证，**没有执行B尚未编写的套件**，没有新DUT/编译/ISA重放/PDS。12既有证据/源文件SHA仍同F155；M1原scope SHA及状态不变。完整命令/原始stdout/stderr/rc在 `work/analysis/2026-10-26-b-verify-offline-preparation/*process.json、*.log`；脱敏入口收据与两份bootstrap详单在本报告同名evidence目录。

## 冻结身份和后续

SHA256SUMS.txt整体SHA：**61E828470ED4EE9353D429E2A974BA0B19898134E545CCC0B2737A63EDBE1630**。合同/接口/验收SHA见PACKAGE.json和RELEASE_RECEIPT。派发包冻结后不回写结果；回执写B新输出，A独立预冻结验收样例不外发、不入Git。

B回执先报告实际容量与目标；约一个工作日是容量确认后目标，不能当已承诺绝对截止。旧外设10月27日18:00北京时间窗口保持，不自动顺延/挤占。若冲突集中回报，由负责人决定取舍。

A-M1在线资源改造仍待单独批准，不等B整包才可推进；本次不实施M1、160次长跑、CPU或硬件。B完成后A先读脚本，再独立复现，分别判断材料/B自测/A复现/ABI/系统/硬件，避免将PASS_LOCAL升级。

Git只保存小型文档/代码/种子/归档索引/总清单及资格收据；96块大payload和私有验收样例保持本地排除。Git克隆不是完整载荷交付，人工应发送实际整个目录。
