minzhetang/pangu-riscv-soc/reports/verification/2026-10-26-coremark-longrun-evidence-m0.md

# CoreMark长测证据与资源方案：主机原型已验证，DUT管道尚未改造

2026-10-26，北京时间，F153/D152。当前最有价值的是先消除证据管道的内存/文件瓶颈，**不直接启动约11主机小时的双种子160迭代预测运行**。本轮只有对旧实际日志的主机程序和完整性控制，0GCC/RTL编译/DUT/ISA重放/PDS/许可查询/硬件操作。F143/O2稳定、F151双迭代校准不覆盖；F146仍暂缓，B v02有限接收保持，无新增B开发。

## 已解决的具体问题与原型结果

旧F151检查器`check_coremark.py`26/33/46行建立并逐拍追加samples，50行整列UART解码；85行三种Stream分别重读trace。实查当前Python指针为8B，270,000,001个引用加空表头的算术下限为**2,160,000,064B**（不含表扩容/其它状态）。这是静态数据结构与主机算术，不曾分配270M元素，不是实测长跑内存。只压缩磁盘文件不会消除此问题，当前检查器仍有该缺口。

新独立`work/analysis/2026-10-26-coremark-longrun-evidence-m0/block_codec.py`仅用已有Python标准库gzip/zlib，实现4MiB完整行分块、连续序号/行区间、分块原始/压缩SHA、总流SHA和固定外部索引SHA。解码有压缩/解压/索引/行/块数量上限，保留所有重复记录和CRLF；不筛事件、不去重、不开压缩VCD、不修改收到程序或旧日志。源数据仍完整保留，不清理任何原始段。

|已验收旧输入|原字节|归档字节（不含小索引）|真实记录数|结论|
|---|---:|---:|---:|---|
|performance trace.log|84091326|18780783|3477732|逐字节还原一致|
|performance bus.log|110243503|13038289|1124937|逐字节还原一致|
|validation trace.log|87958340|19708056|3651558|逐字节还原一致|
|validation bus.log|110178225|13032169|1124271|逐字节还原一致|

四流共**392,471,394B → 64,559,297B**，另37,985B索引；96块、9,378,498记录，trace分类计数逐项同F151原check-result，普通bus按完整字节/时序顺序保留。实际原型峰值工作集**61,992,960B**，主机总12.75s。以上是归档资源成本，不是FPGA提速/创新收益；压缩比仅本四份短测记录实测，不能保证未来更长或其它数据。

`CODEC_SELFTEST.json`为1正确+10预期拒绝：重复/CRLF控制，缺块、重复块、乱序、错行区间、错总SHA、路径穿越、损坏压缩、更新封套但截断gzip、解压超界、冻结索引SHA错。另`INDEX_BOUND_CHECK.json`核正确归档与超2MiB索引在读取前拒绝。它们只验证证据容器，**不新增CPU功能通过**。全39输入按前后SHA核同，13RTL/端口/启动/链接/模型/TB/四原流不改；INPUTS/SUMMARY/RESOURCE_ENVELOPE给精确收据。

## 两点校准能说明什么

以F151实际第二次增量，采用C(k)=C1+(k−1)(C2−C1)作**条件资源估算**，不是冻结的长程序预期。各自最低迭代估计129/120；统一160可作为后续候选，尚未构建或运行，不保证一定>=10秒：

|160次候选，均非实测|性能种子|验证种子|
|---|---:|---:|
|计算ticks条件估值|336596718|362157910|
|按名义27MHz秒|12.467|13.413|
|按此次DUT主机速率的小时估值|5.11|5.82|
|原trace条件字节量|4956234784|5268851336|
|套用本次压缩比的归档条件字节量|1106915236|1180545440|

两组DUT条件总时约10.93主机小时，另有参考/检查/工具成本；不得当工期承诺或CPU运行秒。原codec每输入512MiB上限、旧8M/600s/256MiB采集预算均不能直接覆盖160次；原算法迭代CRC/数据分支使C2不是2*C1，不从这张估算表生成未来正确性预期。

## 收敛后的技术路线与真实权限

1. 先做**A-COREMARK-STREAM-EVIDENCE-M1**：在新副本只改验证管道，关闭段后有界无损归档、连续索引、功能检查不再按全部物理拍存列表。先重放两旧原流和负例，再1次真实性能种子2迭代DUT与F151严格等价。13RTL/官方算法/C镜像/时钟/外设语义不动，不让B重开发。这是下一唯一实施建议，确切文件/预算/临时段处理和验收已写入NEXT_IMPLEMENTATION_SCOPE，**PENDING，未实施**。
2. 管道通过后才决定是否值得进行双种子160次软件长验证：先独立冻结长程序参考、确认新CRC和所有期望、合理资源预算，不把2次乘80冒充参考。若当时硬件安全仍未解除，软件长验证只积累可移植证据；不能代替FPGA运行/ILA。当前不购买/安装新仿真器，也不为减少主机耗时改CPU或官方算法。
3. 板上正式测量另保留时基外部核验、实际运行、完整输出、资源/时序及片上波形；over_temp停止/Pango告警仍是对应硬件线门槛，不让所有软件线等待，也不绕过停止。保留计算与UART计时分离、同种子/编译条件比较及前后质量代价。

## 规范与结论边界

本地固定EEMBC提交1f483d5b8316753a742cbf5590caf5bd0a4e4777的README实际重新读取33–46、124–192行，barebones_porting的计时/迭代/外部参照部分：允许为模拟器指定迭代；有效报告要求至少10秒、两组规定种子/2000B/统一编译条件；可改迭代和port，官方六源不得修改。不能声称CoreMark本身禁止仿真。但本项目名义时基、SIM ONLY标记及比赛FPGA/片上波形要求仍独立，仿真>=10秒不自动取得作品的硬件证据。

来源为本地上述upstream-direct/files/README.md与barebones_porting.md，源链接固定：[README](https://github.com/eembc/coremark/blob/1f483d5b8316753a742cbf5590caf5bd0a4e4777/README.md)、[裸机移植](https://github.com/eembc/coremark/blob/1f483d5b8316753a742cbf5590caf5bd0a4e4777/barebones_porting.md)。本轮复用本地已核固定版本，不声称重新联网。比赛原件要求按F118正式审查入口，不重新全量审题。

现collector没有轮转/在线归档，新codec也没有接到DUT/功能检查器；通过容器测试不能宣称生产管道通过。本轮未做CPU重构/真实长跑/新参考ISA运行，不解除over_temp，不PDS/设备/JTAG/上电/下载/Flash/SCBV/供电/跳线/温控。B v02已经有限接收，不再记等待R1–R3，回复是否转达B仍仅按用户反馈；无自动外发或后台任务。
