minzhetang/pangu-riscv-soc/reports/verification/2026-10-25-coremark-measurement-readiness-m0.md

# 正式CoreMark测量就绪检查：先校准可控重复执行

日期2026-10-25（北京时间），A-COREMARK-MEASUREMENT-READINESS-M0。结论：**现有短测尚不能直接升级正式长测**；最小下一步是稳定F143/O2上的双种子各2迭代校准，具体实施仍待一次范围确认。当前只读核码、旧原始产物与预算计算，0GCC/RTL编译/仿真/参考执行/PDS/许可/硬件；不是新的CPU正确性或正式测量结果。

用户已报告将最终v01回复及文件发给B；记录为用户确认人工转交，不推定B回执/新v02/承诺时间。B只做R1–R3，主线本项与之解耦；不再要求转发同包、不接管B验证代码。A继续F143稳定/F146优化候选暂缓/F147确切告警含义待外部事实，过温硬件STOP不变。

## 1. 依据与实际检查

重新实际打开固定官方[EEMBC README/Run Rules](https://github.com/eembc/coremark/blob/1f483d5b8316753a742cbf5590caf5bd0a4e4777/README.md#run-rules)及[裸机移植说明](https://github.com/eembc/coremark/blob/1f483d5b8316753a742cbf5590caf5bd0a4e4777/barebones_porting.md)，commit **1f483d5b8316753a742cbf5590caf5bd0a4e4777**；同时读取本地官方副本。规则要求至少10秒、2000B总数据、两组性能/验证种子均成功、类型与统一编译选项；迭代数和core_portme允许调整。8/8/8和1200B是PGO训练条件，本项目未启用PGO，不增派第三组当所有运行的必需项。

本轮核68个输入SHA：官方六源对既有可信归档记录与实际当前upstream均相同、F143稳定与F146候选整组26源不改、启动/链接/计时C和头、TB/实际运行器/检查器、两旧ELF/报告结果、旧原始trace/bus。原源码与配置不改；专有模型/授权内容未读。官方source-receipt-direct早期失败不是当前结论，实际以source-integrity-review已核SHA为依据，不删除其旧失败。

四个旧原始流一次遍历完成精确计算窗口/外围的字节和事件分类、同时算完整SHA，既有check结果继续是旧动态证据；新统计不冒充新DUT或参考重放。入口`work/analysis/2026-10-25-coremark-measurement-readiness-m0/INPUTS.json、SUMMARY.json、STREAM_PARTITIONS.json、CODE_ANCHORS.json、postflight.json`；脚本audit.py无外部执行。具体代码行/文本在CODE_ANCHORS，适用文件均位于`work/system/2026-10-24-timed-coremark-m1`及F143同名work/fpga目录。

## 2. 查明的实施前提

|事项|实际证据|结论与最小处理|
|---|---|---|
|迭代参数未接通|port/core_portme.c把seed4_volatile直接初始化为1，SEED_VOLATILE→get_seed_32(4)读取它；port不引用ITERATIONS。两旧实际ELF的文件映射初值也为1|**只改-DITERATIONS=N不会接通该端口**。下一新副本用宏初始化volatile seed4，并核ELF真实初值/程序报告/参考执行；原版不改|
|计时真实读法|timer.h高-低-高重试；硬件计数64位，start/end/elapsed用uint64_t；CORE_TICKS32且delta超过UINT32_MAX显式报错|27MHz名义10秒为270,000,000ticks，能装入现32位接受区间，最大约159.072863秒。当前无须因长10秒就改RTL计数器/中断，但不能说已实测进位/回绕全部情况|
|秒值显示精度|HAS_FLOAT=0，官方允许secs_ret为ee_u32，time_in_secs直接整数除27M|整秒路径不是非法实现；显示及Iterations/Sec是截断整数，不是高精度测量。后续保留原始ticks/频率条件，用独立精确有理数计算补充分析，不能把仿真或配置频率当正式实测成绩|
|自动迭代0不适合当前短测框架|官方0会多次start/stop并放大10倍搜运行量；当前checker要求各调用一次、固定相位及12笔计时读|选明确2迭代校准，不设0触发不可控长跑，不绕过调用/相位检查。算法六源不改|
|检查器与短测耦合|当前明确要求不足10秒提示出现，手工计划是1迭代；全状态和有序每笔流依赖新ELF|不能只删警告或拿旧最终RAM/CRCfinal通过新程序。双迭代须先冻结新参考、明确Iterations2与迭代相关crcfinal；本轮没修改checker|
|存储/初始化|ROM/RAM各32K，链接保留8K栈、BSS边界ASSERT；初始化嵌入PDS/仿真镜像|新程序要重新检查ELF/ROM/RAM初态/启动/栈/符号/合法ISA，不以旧SHA或旧PDS INIT当新程序已映射。CPU/内存/接口不因此改|
|实物取证边界|F143 UART是真实CPU程序软件输出、频率设定27MHz；本轮无新频率测量|正式FPGA运行/外部时基验证/ILA与过温、安全授权缺口保持；纯软件≥10名义秒也不能替代这些|

## 3. 预算：为什么不能把单迭代直接放大

|旧F143原证据|性能种子|验证种子|
|---|---:|---:|
|实际计算ticks|2,103,648|2,263,000|
|按名义27MHz折算秒|0.077912889|0.083814815|
|旧整程序物理拍|3,784,487|3,941,007|
|旧DUT主机秒（不是芯片性能）|201.875|209.235|
|单迭代线性估算的10秒下限迭代数|129|120|

129/120是**单次工作量线性外推**，不是下一个迭代已验证行为/最小充分值；后续迭代数据与CRC持续演变，需要先做2迭代，不可直接承诺160一定足够或固定耗时。

当前TB最高6,000,000总拍，仅约0.2222名义秒，离至少270,000,000计算拍有明确差距；旧360秒主机上限和每trace/bus/VCD256MiB也不能照搬。

|条件外推（不是新实测）|性能|验证|
|---|---:|---:|
|2迭代计算tick|4,207,296|4,526,000|
|2迭代整程序物理拍估计|5,888,135|6,204,007|
|2迭代trace字节估计|83,500,552|87,358,389|
|2迭代bus字节估计|110,305,793|110,161,713|
|2迭代DUT主机秒估计|314.09|329.38|
|129/120迭代trace字节估计|3,924,688,831|3,885,838,687|
|129/120迭代DUT主机秒估计|14,565.32|14,506.69|

外推方法把旧计算区字节按迭代数线性扩展、外围保留一次，主机时间按旧整程序平均每拍推算；忽略每次迭代控制路径变化、事件位宽/磁盘/主机负载等，**仅用于发现预算数量级冲突**，不承诺长测约4小时必然完成或以它证明性能。以旧平均速度两组长测约8小时且各约3.6GiB trace，现有256MiB限会先拦截；不能偷偷放开所有文件上限或省略合法副作用来凑通过。

## 4. 定案与最小下一阶段

保持稳定F143/O2；不依赖B新v02，也不等待F146告警解除才校准稳定版。下一唯一推荐**A-COREMARK-ITER2-M1**：仅新副本端口的迭代初始化、真实build参数、两份新ELF及初始化、新TB可配置预算/校验计划，RTL/官方算法/时序/外设保持。先冻结独立参考，再每种子2迭代各新一次CPU程序运行，完整保留每笔合法WB/访存、全RF/RAM、计时与实际UART、受控波形。不是正式长测或新优化。

预算推荐每例8M物理拍/600主机秒、编译120秒、每trace/bus/nativeVCD256MiB，普通负控只针对新迭代/预算/报告判定。失败/X-Z/异常/错重复副作用/容量或预算超限则保留证据停止，不自行扩CPU/算法/时钟、加M/Cache、删事件或把超时当通过。双种子各2迭代仍预计<10名义秒，必须保留短测无有效成绩提示及NO VALID SCORE。

具体逐文件范围/验收/权限见`NEXT_IMPLEMENTATION_SCOPE.md`，**状态PENDING_SCOPE_APPROVAL，当前未修改端口/TB/RTL、未构建或运行新程序**。D133与D139各1迭代旧范围已完成，不把“继续主线”静默解释为正式长测/新端口实施授权。确认这个有限阶段后常规选择由A处理，不逐项索“继续”；固定外部Icarus编译如需要仍独立工具审批。

之后只在2迭代实测成立后，按实际增量决定长测验证器/资源计划；不现在实施完整流式框架、一次性跑160迭代或安装新工具。计时输出计入外围，算法本体性能不靠少打印改善；读源码与预算分析不冒充工程全部质量完成。
