minzhetang/pangu-riscv-soc/reports/verification/2026-10-25-prefetch-warning-m0.md

# constant-probe只读复核：排除最终综合网表中的有效组合环，原告警仍未闭

2026-10-25（北京时间），D141批准只读，F147/D142收尾。Git输入c92bb98b12deaad52aa0dcc7e16bb747204b6f4f。**新旧最终综合网表在本次明示建模边界内均无有效组合反馈，但仍未找到sdm2adm第8条告警对应的内部节点。候选不升级，F143/O2仍稳定基线。**

## 1. 本次做了什么、没有做什么

只读比较F142旧PDS工程（13源同F143）和F146候选保存产物，实际完整解析两个约2MB的board_top_syn.vm；旧/新13源、PDS目录逐文件清单/哈希、两个flow.log的安全阶段摘录、官方primitive端口与实现关系、三QCH帮助索引与相关条目已核。所有输入清单在work/analysis/2026-10-25-prefetch-warning-m0/INPUTS.json，最终哈希另存。

没有修改任何旧工程、RTL、TB、参考模型或测试预期；没有编译、DUT、参考程序重放、PDS、位流、硬件或安装。此处Python解析器/布尔关系自检不是硬件/CPU仿真，也不新增F146的832个DUT计数。新报告/记忆不采集授权内容或机器标识；检查工具日志时遇到其自带信息头，未复制到本轮证据摘录或Git，只保留安全的sdm2adm区间。过温STOP不变。

## 2. 原告警可查明的范围

|证据|旧版|候选|判断|
|---|---|---|---|
|flow.log|第278/279/283–287行共7条|第279/280/284–289行共8条|确有+1，不撤回F146|
|原文|Loop was found during constant probe.|同左|没有网名/错误码/层级|
|所在阶段|Start sdm2adm至成功结束|同左|不是本次最终网表图检查的输出|
|后续保存物|综合VM、数据库、映射/布局网表及报告|同左|中间探测的节点图未以可读形式保存|

原阶段还出现bmsWIDEMUX常量传播条目，但同一日志邻接不证明这些MUX就是告警对象；内部N号和告警次数不能稳定对应模块。仅凭多1条不能指认新增取指逻辑有真实组合环，也不能宣称工具误报。

## 3. 最终综合网表的独立检查

解析器只接受实际出现的结构Verilog：13个模块、声明、命名实例/参数/端口、位/段选择、连接与常量；不支持语法、未知primitive或宽度不符即停止，不跳过。各primitive方向来自当前PDS官方simulation文件，只读、不执行、不分发其源码。类型/每模块和层级统计/库路径及SHA在各graph结果中。层级展开后以实际单比特连接建图，不把整个多位总线当一个节点。

FF数据/使能/时钟路径和GTP_DRM18K_E1同步状态作为边界；LUT依其INIT枚举二值函数敏感性，区分双输出Z/Z5和CARRY参数，再施加实际直接绑0/1引脚。未能解析为直接常量的别名仍作自由量，保守增加依赖，不凭名称删边。另单独加入DFF异步C/P/R/S到Q路径，再查一次。隐式全局GRS、模拟延迟、CDC、物理缺陷及post-route连线不在该图证明范围。

|项目|旧最终综合网表|候选最终综合网表|
|---|---:|---:|
|模块数|13|13|
|展开primitive数|3821|3965|
|组合图节点/边|4770 / 12286|4939 / 12966|
|拓扑消去节点|4770|4939|
|残余节点|0|0|
|另含异步控制图节点/边|4808 / 12806|4977 / 13519|
|另含异步控制图残余|0|0|

结论限于**两个已保存的最终综合功能连接图**及上述边界：不存在该模型下的有向组合环。候选33个fetch_redirect标签/valid FF亦在完整图里，不是只读新增源码看起来没问题。此结论不覆盖不可见sdm2adm中间图，不能关闭其告警，也不是全芯片/所有时序或硬件验收。

## 4. 粗略图的可疑反馈为何消失

原始all-input→all-output图在新旧两版都有28个残余节点，不能把它们都叫真实SCC。仅按INIT而未约束绑脚仍存在。追到旧cpu/N473[15]（VM实际第30360行Z连接）、新cpu/N502[15]（第31489行）：两者同为GTP_LUT6D、同一INIT，Z=mem_load_half[15]、Z5=mem_load_data[31]，I5实际固定1。

把I5误当自由量时，I4似乎可以影响Z，沿load符号扩展网络形成反馈；在实际I5=1条件下，Z只依赖I0/I1/I2，函数为I0 ? I2 : I1，I3/I4完全不影响Z。旧/新各32种输入组合均与此独立MUX表达式一致。施加实际绑脚后两完整图残余均为0。

这是**本次分析器粗略建模的共同假阳性解释**，并非PDS内部constant-probe根因。三份粗略/未绑常量结果与最终两份constrained结果全部保留，不删除不利中间分析。SHARED_LUT_WITNESS.json记录实际实例、端口、INIT、页行及32+32个布尔检查。

解析器6个简单图/表达式检查、布尔表达式1150项及6个敏感性检查只验证分析方法，不是CPU新动态覆盖。开发时严格reader先因未列INBUF中止，检查当前官方INBUF/OUTBUF端口后显式支持；收集器先假定新旧实例同名、后把特征LUT也计入FF，这些均在接受结果前修正，不改变原网表或任何DUT结果，保留在ANALYZER_SELFTEST及脚本历史说明中。

## 5. 帮助资料与不可达范围

读取bin/helpDoc_pango.qch的18条、syn/lib/html/synerrmsg.qch的1392条、fpgahelp.qch的1765条HTML/TXT/XML，合计3175条，无解压失败。当前PDS用户指南说明Timing Check的Loops用于检查组合环，可能影响时序分析；Synplify的CL179/CL181、BN134/BN137等是其他明确消息，不能套作本次sdm2adm告警说明。没有找到constant probe原文解释。QCH内部具体路径/来源SHA与泛化命中目录见INPUTS，必要短摘录仅在本地help-search.json，不分发整套帮助。

只读官方域名pangomicro.com搜索原文和PDS组合环，两查询无结果；这不证明没有勘误。没有取得当前版本此条消息的官方严重性、清除规则或内部节点定位方法。

.db/.adf为工具二进制/压缩数据库，本轮不逆向读取其内部中间图；PNR导出包含实例、引脚方向、网名表，没有pin-to-net连接映射，不能把该表包装成post-route SCC证明。本轮未完整搜所有PDF或帮助图片，也没有运行任何官方工具诊断命令。清单内文件存在/哈希同不等内容已解析，覆盖分类单列。

## 6. 技术决定与下一步

F146的计算收益与资源/估频代价保留；F147补上最终综合连接证据，**降低“新增逻辑在最终网表引入有效组合环”的担忧，但不以自写解析器替代官方警告解释**。D140候选暂缓升级决定保持，稳定F143（原7警告同样未官方解释）并非被宣称无风险。原F146报告不改写、不重跑。

唯一下一项人类依赖：可向Pango确认原告警严重性和不重新综合的定位方法，已准备同目录PANGO_QUESTIONS.md，仅两问、安全摘录与最少背景，无机器/许可证/专有实现。尚未发送，也不要求B处理A工具问题；B/F139原整改及10月27日18北京时间返回窗保持。收到官方解释后核证决定是否需要一次官方保存数据库诊断或新的最小修复范围；本轮不自动执行。

源码/元件模型/中间数据库继续保持原件，读取后的逐SHA一致性和Git精确范围收尾记录在postflight；没有新许可状态查询，余9天仅F146当时实测提示，应及时官方续期。正式≥10秒、外部时序/CDC、FPGA/ILA和过温原因仍未关闭。
