minzhetang/pangu-riscv-soc/reports/verification/2026-10-25-control-flow-quality-m0.md

# 控制流质量复核：建议验证“已决目标提前取指”，尚未实施

2026-10-25（北京时间）；D137只读范围、F145原证据再分析、D138方案建议。有效基线仍F143/O2；F144的O3被拒结论不变。

本轮完成原始轨迹统计、源码时序推演和最小实施范围；**0编译、0模型重放、0新DUT、0PDS/硬件**。所有数值来自旧的已验真实运行或明确标记的条件算术，不是新优化成果。

## 1. 证据与核对方法

分析目录H：`D:\A_FPGA_Comp\work\analysis\2026-10-25-control-flow-quality-m0`。

- 13份整组源码：`D:\A_FPGA_Comp\work\fpga\2026-10-25-board-coremark-m1\source`，实际CPU SHA `7179EF273E62389280A23F962B696E3B8E09F3985CC72D76E5E80C7A0C59518D`，不只凭cpu哈希选择版本；其余12项及两个镜像见INPUTS。
- 旧原始运行：同目录`runs/performance-N234`、`validation-N234`的trace/check/stdout与原镜像；trace逐SHA核对F143最终清单，两个计算窗口的全部事件/时刻SHA仍为`C9632771A168FB5EC2CE23894973B40F0C5512295BABA75795049DD85F949269`、`632C6D6368F014C746A17B6FD66E3C3F9F5F22E923B773AE8762355ABEF80186`。
- 函数/编码来源：`D:\A_FPGA_Comp\work\system\2026-10-24-timed-coremark-m1\logs\build-performance-objdump\stdout.log`及validation对应文件；与同目录build-result和F143 bin SHA核同。
- 原分类：同目录`quality-window-analysis.json`及F143`quality-compare.json`。本轮从真实EX后继顺序、指令编码与间隔重数，整段重定向数等于原flush指标，窗口EX/load-use/redirect数均等于原已验分类；不重跑Reference或DUT。

新脚本`H/analyze.py`流式读取EX/WB/READ/STORE，按合法EX顺序和B/J立即数解码验证后继PC。普通路径2拍；无重定向load-use后继4拍；taken分支/跳转后继6拍。JALR目标沿用原独立功能验收，不冒称本轮重算其寄存器源；分支条件也复用原验收，本轮验证编码/顺序/计数关联。PC+4目标时单凭后继PC不能区分taken，脚本用已知基线6/2间隔消歧；两实际计算窗口均0项，不扩大动态覆盖声明。解析器5正/3负合成检查单列，不是CPU测试。

27个相关输入SHA前后相同；两个反汇编各3454个机器字逐项匹配原bin，46个函数标签逐项匹配原构建符号，两个逐PC表各223项与摘要计数一致，见`disassembly-check.json`。完整逐PC统计、样例、相邻间隔分布和摘要在`performance-by-pc.json`、`validation-by-pc.json`、`SUMMARY.json`、`INPUTS.json`、`postflight.json`。

## 2. 实际开销分布

|计算窗口|性能种子|验证种子|
|---|---:|---:|
|原始计算ticks|2,103,648|2,263,000|
|合法EX观察数|732,266|785,232|
|条件分支总数|198,102|217,130|
|条件分支taken|122,930|136,130|
|条件分支not-taken|75,172|81,000|
|JAL（本窗口均rd=x0）|4,060|3,990|
|JALR链接形态|11,214|11,200|
|JALR返回形态|11,214|11,200|
|其他JALR|4|4|
|全部实际重定向|149,422|162,524|
|load-use间隔数|20,714|21,220|
|重定向对应4拍项|597,688|650,096|
|该项占原始计算ticks|28.4120%|28.7272%|

JALR返回形态严格按rd=x0、rs1=x1/x5、imm=0计，不把所有JALR都称返回。直接JAL在当前编译参数下均为无链接跳转，很多调用是AUIPC+JALR；“提前直接JAL”不是覆盖主要调用路径。

`2×EX + 2×load-use + 4×redirect`分别精确还原两个原始计算窗口，残差0。它是本两拍模式的观测归因，不是退休CPI；全程序UART轮询分支已与计算分区隔离。

热循环例（两镜像编码/PC相同）：`__mulsi3`的PC0x353c/BNE，性能72448次中63052次taken，验证81876次中72480次taken；PC0x352c/BEQ为30452/34162次taken。软乘法是热点，但本方案不改官方算法、不加M，也不把常规微结构技巧冒称学术首创。

## 3. 源码与存储约束

以下行号指F143整组原件：

|源码证据|已查明内容|对方案的约束|
|---|---|---|
|cpu.v:23–31|两相memory_phase，只有推进相位更新流水线|不能靠取消另一相位假装提速|
|cpu.v:64–99、130–143、210–255|valid/EEI及IF/ID、ID/EX冲刷|必须保留错误路径清除及停止排空|
|cpu.v:109–128|pc直接来自pc_reg，重定向只在推进沿写PC|现有取指地址要等该沿才改变|
|cpu.v:259–302|前推后的两源、比较/目标已在现有EX路径计算|不需要预测新条件，但须证明采样相位内稳定|
|cpu.v:305–329、360–393|后级推进、load-use、重定向控制|不得牺牲旧MEM STORE/WB或改变边沿来减泡|
|memory_model.sv:108–114、200–209|ROM地址/银行标签每个posedge采样，一沿后提供inst|目标请求与返回标签必须一起对齐，不能同沿写新地址再用NBA后的数据|
|soc_top.sv:13–18|CPU SYNC_MEMORY=1，pc接真实存储取指端口|外部端口/存储延迟保持，pc是取指地址不是退休PC|

已验证的前提是F131/F141/F142/F143同步存储绑定及原运行。**尚未验证**新mux路径的稳定性、目标返回捕获、新valid逻辑或STA；旧资源/正裕量不能为新逻辑背书。本轮没有新增波形采集或声称旧窗口波形覆盖所有前推信号。

## 4. 推荐的唯一局部方向

在新副本增加默认关闭的参数，仅同步模式开启。把**现有EX已判定的重定向**接到下一个存储采样沿的取指地址，捕获valid/PC标签；到推进沿确认该返回仍匹配，保留目标指令于IF/ID，PC接目标+4，继续清错误路径ID/EX。无效、复位、EEI、非对齐或标签不匹配走旧路径。分支/跳转自身照常进入后级，JAL链接值不变。

下表是**静态推演，不是新波形或已实现行为**。E0/E2/E4均为推进沿；EX日志观察沿前状态，表中装入指沿后状态。

|相对沿|现有基线|候选假设|
|---|---|---|
|E0后|分支进入现有EX寄存器|相同，比较/目标开始稳定|
|E1采样|ROM采样旧顺序PC|ROM采样已决目标并记录标签|
|E2前/后|观察分支EX；写目标PC、清IF/ID与ID/EX|同样完成分支EX；若返回标签匹配，IF/ID保存目标，仍清ID/EX，PC接目标+4|
|E4后|刚把ROM目标装入IF/ID|目标装入ID/EX|
|E6前|目标尚未在EX日志出现|观察目标EX|
|E8前|观察目标EX|已继续后续指令|

因此**若实现成立**，分支EX至目标EX由6拍降至4拍，省一个逻辑槽/2物理拍。不是同沿抢读、不改变数据RAM等待，也不是提前预测分支。

|条件算术|性能种子|验证种子|
|---|---:|---:|
|若全部重定向各省2拍|298,844 tick|325,048 tick|
|占当前计算时间|14.2060%|14.3636%|
|若只优化直接JAL，各省2拍|8,120 tick（0.3860%）|7,980 tick（0.3526%）|

这些是所有事件均合格、其他因素不变时的理想账本，**不是预计必达、已测提升或承诺**。实际命中/回退、软件时序和路径STA需新实验核验。

## 5. 代价、备选与停止条件

- 推荐已决目标取指：预计局部涉及CPU取指mux、valid/PC标签和一次SoC参数绑定；能够针对全部已决分支/跳转，不改算法和数据接口。最主要风险是前推/比较/加法/mux→ROM地址setup的新长路径，以及PC标签错配、错误路径副作用、链接值/目标首条依赖、复位/EEI竞争。
- 不推荐只做直接JAL：当前计算占比太小，调用主要走JALR；单独为不足0.4%的理想时间空间改变前端，收益依据弱。
- 不选择改编译选项、增加预测器/Cache/M或整体单拍改造：O3已有负向结果；后几项越过当前局部范围并扩大存储、ISA、验证成本。本轮并不宣布它们永远不可做或高阶任务可免。
- 若需要改数据存储/握手、前推/load-use、时钟边沿、完整异常或全局流水结构，先停止该候选；不以“局部”名义隐藏扩张。任一正确性/重复副作用/X-Z/时序失败或无收益，保留O2及原架构。

## 6. 下一阶段的具体门槛

唯一建议批准`H/NEXT_IMPLEMENTATION_SCOPE.md`中的A-RESOLVED-TARGET-FETCH-M1整阶段：独立副本仅cpu.v与soc_top.sv，新增独立TB/时序检查适配；默认关闭的原763例回归、新模式定向边界与两个不变O2 CoreMark镜像，功能和收益成立后才PDS资源/27MHz对照，不生成位流。

原架构参考语义、冻结输入/预期保持；新检查器须独立区分控制事件/丢弃槽/合格预取，不简单把flush乘数统一改1来凑通。不在当前只读阶段执行这些未来测试。外部编译/PDS按准备后的固定清单另走工具审批，阶段内普通细节由A完成，不逐个向用户问信号。

负责人A，B无新任务/返工/接口依赖，原F139整改与10/27 18:00北京时间窗口保持。无新包/送达或外发事实。硬件STOP、正式≥10秒/ILA/7告警/外部时序缺口不变；F142余9天为上次许可证提示，本轮不查询或配置许可证。

继续保留当前体系的WB与MEM分流检查、无真实退休PC/统一提交接口、固定存储/初态/有限输入局限。理论少14%左右计算时间不证明频率、面积、能效、首创或比赛得分；只有新阶段的正确性、实际计算ticks与实现代价对照后才能判断是否接收。
