minzhetang/pangu-riscv-soc/reports/verification/2026-10-25-compile-quality-m1.md

# O2→O3质量对照：功能短测通过，但拒绝O3候选
日期2026-10-25（北京时间）；D135批准，F144实测/D136技术取舍。**保留O2，不把O3作为当前基线。**两个新DUT均通过严格检查，但两组计算都没有收益，代码均增加3080B；到此停止，不启动PDS。
## 1. 范围、规则与真实性
H=`D:\A_FPGA_Comp\work\fpga\2026-10-25-compile-quality-m1`。O2对照来自F143实际板级顶层/N234运行，代码/工具来自F136/F142；Git起点6d1ec32aacdfa728174c868a9fd35f491c57a7b9。原件、历史失败、O2输入与预期均保留，当前保护726项核同。
官方固定commit1f483d5b8316753a742cbf5590caf5bd0a4e4777 [Run Rules](https://github.com/eembc/coremark/blob/1f483d5b8316753a742cbf5590caf5bd0a4e4777/README.md#run-rules)允许改变构建选项，但须统一编译选项、不改算法，正式报告须至少10秒。已实际打开官网及固定README，并核本地规则章节、6份源码SHA与既有官方固定归档一致；旧头文件注释/MD5清单问题及失败收据原样保留，不重下、不执行网页命令。GitHub commits API访问失败不影响已固定原件核对，未冒称查到新版本。
只改新副本GCC选项-O2→-O3与core_portme.h的真实编译描述；PORT_DIFF.patch及consistency-receipt逐项证明。13RTL、冻结TB、两独立模型、启动、链接、端口C、算法、种子/2000字节/各1迭代、27MHz、N234及GPIO全释放保持；GCC命令路径归一后唯一开关差异得到核验。没有LTO/PGO、改算法/少计算或降低预期。
## 2. 实测与取舍
|种子|O2计算ticks|O3计算ticks|计算时间变化|O2→O3镜像B|功能|
|---|---:|---:|---:|---|---|
|performance-N234|2103648|2106278|+0.1250%（正数为变慢）|15912→18992|PASS|
|validation-N234|2263000|2267352|+0.1923%（正数为变慢）|15920→19000|PASS|

原始计算ticks不扣空读开销，两组empty窗口均26。仍在ROM32K、RAM32K/静态8K栈边界内，ELF为RV32I/ILP32、无未定义符号；代码增长不自动等于映射资源增加，O3未运行PDS，不能编造新LUT/FF/DRM数或时序。
|种子|主机运行秒|物理拍/推进|stall/flush|UART字节|最低SP/有限观测深度|
|---|---:|---|---|---:|---|
|performance-N234|201.015|3780627/1890313|152642/283667|662|0x17e70/400B|
|validation-N234|209.125|3938809/1969404|152957/296606|661|0x17e70/400B|

每笔x2合法WB均核在0x16000–0x18000；这是本次有限执行的SP观测，不是所有输入/中断/递归的最坏栈证明。每种子EX/WB/READ/STORE计数、每笔有序摘要、阶段0/1/2/3/4、12笔timer LOAD及全过程结果详RESULTS与原始check-result。
全RF/32K RAM与独立顺序模型一致，每笔EX/WB/MEM无去重，独立外设计时模型核真实MMIO，正常main返回0/SP恢复0x18000/EBREAK、尾32拍无副作用。原三算法/种子CRC、错误标志、timer调用次数、实际高低字时间戳及差值通过。新镜像布局/PC/编译描述变化，不能强求与O2全RF/RAM字节相同；使用同样严格的独立模型标准，不根据DUT反填。
## 3. 输出、波形与质量解释
完整连续UART引脚记录由独立中心采样和精确跳变时刻双重核验，逐字节对应独立模型生成的RAM报告，未用DUT未核数据作预期。4种实际引脚日志损坏被拒绝；合成1正4负仅检查解析器，不增加DUT次数。原生普通VCD仅明确窗口，逐配置解析pre/post计数/相位和全部12笔timer LOAD捕获，不宣称完整算法波形、退休PC或ILA。
|种子|格式化等 O2→O3 ticks|UART阶段 O2→O3 ticks|
|---|---|---|
|performance-N234|59088→59014|1559702→1559702|
|validation-N234|58210→58184|1557346→1557346|

全程序结束稍早不能替代算法计算更快；启动/格式化与计算/输出分列。当前编译器优化没有提供目标计算收益，且ROM空间消耗更高，因此不继续参数搜索，也不将它包装成创新。O2/F143仍是后续工作的基线，F142原资源/27MHz证据继续只适用于原O2镜像。
## 4. 告警、未执行项与交付
两次GCC构建/工具检查及两次Icarus编译无错误；继承regfile时间单位、部分模块未显式单位与官方模型grsn隐式线网告警保持，没有为消告警改源码。编译43.313/43.515秒；两个仿真均未超时/截断/强杀，主机秒不冒称FPGA计时。
仍是短实验，上游不足10秒和Errors detected原文保留，不是正式成绩。0PDS/0位流/0硬件，未查询或更改许可证；F142最后提示余9天仅历史，需人工官方续期。原7个constant-probe根因、14个外部IO时序/CDC及over_temp STOP保持，纯软件通过不能解除。
B沿F139既有整改/最终包与10/27 18:00北京时间窗口，不重索已有材料、不派新核心任务；当前有限系统TX证据不关闭B整包/RX条件。无本轮新包/送达/承诺事实。
H/COMMANDS.md提供完整命令/退出/预算；RESULTS、consistency-receipt、postflight及最终SHA、compile/build/simulation结果、各真实日志/全态/trace/bus/连续PIN/普通窗口VCD与审计提供本次证据。旧失败与SHA不覆盖。专有模型/工具/大型产物留本地；Git同步不是干净克隆一键复现保证。
唯一下一建议：A-CONTROL-FLOW-QUALITY-M0，仅只读现有O2源码与已验轨迹，对JAL/条件分支/返回重定向分别量化，再收敛一项能独立验收的最小减泡方案与风险/回归范围；不自动开始RTL/TB/模型修改或新仿真，不预设预测器/Cache/M，也不承诺提升。现有软件/内存/外设基线保护，硬件仍停止。
