minzhetang/pangu-riscv-soc/reports/verification/2026-10-24-timed-coremark-m1.md

# 可信计时与CoreMark短运行：有限软件系统验收

日期2026-10-24；A-TIMED-COREMARK-M1；授权D123，实测F136，验收决定D124。工作根目录：`D:\A_FPGA_Comp\work\system\2026-10-24-timed-coremark-m1`。无Git。

**已打通：官方固定CoreMark源码→RV32I C构建→同步存储上的真实CPU执行→程序读取真实物理时钟→双参数CRC/全状态/有序副作用→计时结束后实际UART报告→正常停止。**两个子里程碑有限通过；不是正式CoreMark成绩、全CPU或FPGA验收。

## 1. 修改与保护

独立复制F134整组CPU/官方存储功能模型/B包装和TX/GPIO。新增`source/cycle_counter64.sv`；仅修改新A侧`soc_data_adapter.sv、soc_top.sv`的计时路由/连接，新增自检C、新CoreMark平台端口、TB及参考/运行检查器。准确差异`SOURCE_DIFF.patch`，原件`source-before、port-before、models-before`保留。官方五C/coremark.h不改，CPU/ALU/control/regfile、F131 memory_model及B包装/核心逐SHA不变。

结束保护：37直接来源、174本阶段冻结项、3358原系统保护项核同；原F134程序两个配置的**trace.log、全部RF、全部RAM逐文件SHA相同**。原失败、旧包/原合同/原输入预期均不覆盖。本阶段没有重跑无关763例，没有安装/修改PATH或执行破解软件。

## 2. 计时器与真实采样

生产计数器复位归零，每非复位物理posedge加1，stall/flush及存储等待相位均计；不受pipeline_advance限制。A只读低/高字地址20000100/20000104，与B原20000000–ff互斥；所有计时写拒绝但不停止计数，错误仍是观察信号而非CPU trap。读组合、无清零/锁存副作用。

C用volatile高→低→高，变化则重试，时间戳对应低字实际LOAD取样时刻。CPU消费沿前值c−1；VCD稳定沿后计数c单独核对，不能混用。CoreMark保留上游32位CORE_TICKS，64位差值超过32位时显式timer_error，不能截断；本轮没有动态达到该错误范围。

单元v1 171检查通过；增强v2 **296检查通过**，不是两者简单累加成独立覆盖。v2使用明确非生产seed实例，经真实路由跨低字进位/读到高字1，高低高重试1次；两字各16种写掩码拒绝、保持读地址持续计数、复位/非对齐/保留地址/区域互斥有限检查。**CPU实际重试分支未动态触达**，不将单元近进位场景冒充CPU数十亿周期运行；生产实例始终默认零。

真实C计时自检：四低字采样263/289/311/723，时间戳全符独立物理沿；空窗口26拍、确定计算窗口412拍、checksum528、签名54494d31、串行`TIM1\r\n`6帧、主函数返回0。26拍是这段连续读取校准，不是所有计时调用的精确开销，不从正式时间盲扣。

## 3. 构建和实际运行

现有GCC15.2.0 xPack、Icarus/vvp13.0，绝对路径/显式-B及VPI路径；原工具文件核同。纯RV32I/ILP32、无未定义符号、ELF32LE/flags0、反汇编有限白名单、32K ROM/RAM/8K栈预留检查通过。镜像812/15912/15920B；全部构建命令在`COMMANDS.md`，native退出码/超时/日志在各process.json。

|新运行|结果|主机运行秒|物理周期|串行帧|
|---|---|---:|---:|---:|
|unit v1|171检查/进位重试通过|0.094|单元独立时序|—|
|unit v2|296检查/进位与路由增强通过|见unit-v2-result|单元独立时序|—|
|原系统N16|全状态/有序流/原SHA无退化|0.938|4179|12|
|原系统N234|同上|2.312|28779|12|
|timer smoke N16|真实LOAD/ticks/结果/输出通过|0.828|1979|6|
|CoreMark性能种子N16|v2严格判定通过|128.782|2338691|662|
|CoreMark验证种子N16|v2严格判定通过|137.781|2497395|661|

新7编译、7 DUT运行。前6固定非管理员外部仅编译各90s上限、首错停；另批1个30s单元增强仅编译，均已用完，不是常设权限。运行均普通权限：短例45s、CoreMark240s、最多1000万物理拍；没有超时或截断。7编译0错误；两个单元stderr空，系统目标保留CPU四源继承timescale和官方模型隐式grsn警告，未为消警告改原件。实际原生编译耗时分别0.157/35.703/39.031/40.641/35.250/40.813/0.094s。主机秒数不是FPGA计时。

BIN SHA：smoke `3B9BD54C01F72F6EEE8B0375A78EDF93FB081AC7B41250163C39F3EE347BB0B2`；性能 `B4CEEC1B250A5151C1D02F018FC45B3D22CDC049E12E26EFC2A0562D23740E60`；验证 `26B4F9C2900141EC2EF3A19F4C75C831ED62A1F6E02B34C441501B0FF4E84429`。ELF/所有源与产物完整SHA在build-result、postflight、SHA256SUMS。

## 4. 两组CoreMark实际结果

固定F122官方提交、2K总数据、单上下文、每组1迭代；五算法源/参数和原CRC期望不改。

|证据|性能种子|验证种子|
|---|---:|---:|
|seedcrc|e9f5|18f2|
|list / matrix / state CRC|e714 / 1fd7 / 8e3a|e3c1 / 0747 / 8d84|
|start / end实际tick|61967 / 2165615|62369 / 2325369|
|计算窗口原始物理tick|**2103648**|**2263000**|
|全段stall / flush|32208 / 165228|32712 / 178239|
|合法有序WB|551315|585410|
|有序READ / STORE|69824 / 20529|70273 / 20433|
|实际UART报告字节|662|661|

每组12笔计时LOAD逐笔核对沿前c−1/高字0，全部RF/32K RAM同独立指令解释；EX观察序列、每笔WB及READ/STORE各自有序核对，不去重。串口合同模型与独立公开引脚解码核所有报告字节，末帧结束后停止，RAM保留完整报告。计算计时窗口内**0笔MMIO写**；UART仅阶段3后开始，计算/格式化/发送分开。不把最终答案碰巧对当过程通过。

27MHz只是软件频率设定，分别折算约0.077913/0.083815秒，不是已测FPGA频率。HAS_FLOAT=0的上游整数秒显示0，同时raw ticks真实非零；原“Must execute for at least 10 secs”和“Errors detected”均在RAM和真实串行输出中保留，不能隐藏或据CRC通过报告正式CoreMark/CoreMark/MHz。每算法显示666来自2K三算法均分，不是数据规模改成666。

## 5. 发现的问题与检查器证据

性能组初版`check-result.json`真实FAIL：检查器阶段期望漏了启动BSS清零，实际0/1/2/3/4而非1/2/3/4。原trace明确PC54向timing_phase写0；未修改的启动镜像该PC编码0005a023（sw zero,0(a1)），且发生于首次计时读取前，完整架构流本来匹配。

保留原检查器/FAIL；新`check_timed_v2.py`明确要求完整0/1/2/3/4、唯一PC54初始零写和时序先后，不过滤零/重复事件，保持所有CRC、状态/流与计时期望。重读同一原始证据通过，**没有重跑DUT**；v2在验证组DUT前另冻结。对应`checker-v2-correction.json`原始SHA和修改理由，不静默改旧失败。首FAIL是验证端错误，不是CPU修复。

最终v2检查器正确控制1+错误沿后时间/冻结计数/错高字/错LOAD/重复WB/漏STORE/额外GPIO/未知引脚8项负例均正确拒绝；这些是派生日志负测，**0新增DUT**。旧v1负测保留，不把两个版本重复控制统计为18个不同用例。

普通VCD独立稳定沿后核smoke1300、性能2723、验证2753，共6776检查PASS；覆盖启动、时间读取、算法起止代表窗口、输出转段与停止。中间停采范围明确，**不是全算法流水线波形或片上ILA**，EX-PC不是退休PC。文件体积上限执行前冻结，文本事件完整保留，未用截断日志通过。

## 6. 立即进行的质量分析

`quality-window-analysis.json`在已验证参考上重放分类，0新DUT；使用实际EX采样时间和独立指令语义，计算窗口对账：

|物理拍组成|性能|验证|
|---|---:|---:|
|2×窗口EX观察数|1464532|1570464|
|2×参考load-use|41428|42440|
|4×参考重定向|597688|650096|
|合计|2103648|2263000|
|窗口边界残差|0|0|

这是固定两拍/两级冲刷模型与真实时间的闭合，不是退休CPI，也不是全VCD逐空泡独立审计。窗口含计时函数边界代码，不能称完全无测量开销。

窗口732266/785232个EX观察中，`__mulsi3`为432424/485282，是明显软乘法热点；其次是状态机、链表及矩阵函数。当前还没有实施优化或证明效率收益；不能未经取舍自动加M扩展、Cache/FIFO或改算法。两拍存储成本和重定向开销需结合实际资源/Fmax再判断改善价值。

计算结束到UART阶段另59088/58210拍，串行阶段到完成113906/113734拍，均与计算ticks分列；少发字节不能伪装计算更快。下一应先解决**可综合存储绑定/目标FPGA映射、资源和时序证据**，再据可比基线选择局部优化，不无限堆软件用例。

## 7. 边界、协作与下一步

有限计时软件系统可接收，原F134功能基线保留；B的F133入口/账本/元数据条件不因本次成功关闭，原任务/10月27日18窗口不变、不重派核心。有限测试不等全部RV32I、全部64位进位/回绕/计时错误、真实退休顺序或任意初态正确。

仍缺正式≥10秒运行和适当精度的正式报告、实际时钟证据、PDS综合映射/资源/Fmax、FPGA实跑及片上算法波形。**over_temp硬件STOP保持**，本轮未启动PDS/服务器/枚举设备或JTAG、上电、下载/Flash，也未改SCBV/供电/跳线/温控或联系外部。

唯一下一推荐：A-FPGA-IMPLEMENTABILITY-M0，先限定纯软件可综合绑定及PDS映射/资源时序预检，不连接硬件；现有memory_model的只读验证视图不能未经审查当生产顶层。该新范围/PDS执行尚未批准，本轮不自动开始，不用临近截止绕过安全或权限。

权威入口：`summary.json、postflight.json、COMMANDS.md、SOURCE_DIFF.patch、SHA256SUMS.txt、manual-plan.json、build-result.json、compile-result.json、unit-v2-result.json、checker-negative-result-v2.json、checker-v2-correction.json、quality-window-analysis.json`；各runs目录保存新VVP对应的原始日志、普通VCD、完整终态和实际check结果，不能选性能组旧FAIL代替v2最终结果，也不能删除旧FAIL。
