minzhetang/pangu-riscv-soc/work/analysis/2026-10-25-coremark-measurement-readiness-m0/NEXT_IMPLEMENTATION_SCOPE.md

# A-COREMARK-ITER2-M1：待一次批准的双迭代校准范围

版本1.0.0，2026-10-25；状态**PENDING_SCOPE_APPROVAL**。本文件是具体可审提案，不是实施/许可或DUT验收。新工作目录在执行时按实际日期创建`work/fpga/YYYY-MM-DD-coremark-iter2-m1`，冲突用唯一新版本，所有旧源/旧输入预期/产物保留。

## 目标/基线

在稳定F143/O2不变13RTL与同32K ROM/RAM、N234、27MHz名义时钟/原同步存储路径上，性能与验证两组2000B种子**各2迭代**，证明C端口参数接通和真实重复执行，取得同标准全态/逐笔副作用/计时/串行证据及资源增量。F146不启用，B核心/包装/接口保持；不是正式≥10秒、硬件、ILA、ISA补齐或优化阶段。

## 允许的新副本修改

1. `port/core_portme.c`只将seed4_volatile的硬编码1改为来自ITERATIONS的正整数初始化（默认1保留），运行构建只准2，拒绝0自动校准/负数/非法值；不改计时函数、算法、种子/数据量、输出时机或移除无效成绩提示。`port/core_portme.h`原样，O2选项统一、描述保持真实，不加float/M/LTO等新方向。
2. 新build脚本沿用已核现有xPack15.2.0-1绝对路径，性能/验证各一套ELF/bin/反汇编/初始化；仅参数ITERATIONS=2及输出目录/映像随改变。检查ELF RV32I/ILP32/无undefined、seed4实际初始化2、镜像/符号和ROM/RAM容量/启动data/BSS/预留栈。官方六源、start.S/link.ld/timer.h复制核同，原版保持。
3. 新冻结计划/手工预期/运行脚本。TB只把既有总拍上限参数化为本阶段8M、尾32拍和观测语义不变；继承固定时钟和波形窗口/实际UART连续记录。检查器仅将硬编码单迭代说明改为本阶段2迭代与新镜像的先验参考，不放宽每笔合法EX/WB/MEM/RF/RAM/MMIO/计时/停止检查，不去重/过滤BSS或动态回填。精确周期来自独立参考调度，实测不得用旧单次乘2替代参考。
4. 必要host-only反例：报告Iterations错1、crcfinal错误、缺/多合法副作用、计时/相位/预算不符必须被拒绝；围绕实际改动，不重跑原763例或B整矩阵。两个模型职责分离保留；参考和输入先冻结再DUT。

## 运行/验收与停止

- 现有Icarus/vvp13.0，显式-B/VPI、绝对路径、不改PATH。2目标编译各120s；如普通路由历史崩溃仍适用，单独申请此固定2次非管理员外部编译，旧次数不复用；首错停。每种子一次普通vvp，8M物理拍/600主机秒上限，各trace/bus/nativeVCD256MiB、stdout/stderr受限，任何超时/截断不算PASS。确认新VVP/原生日志/真实UART、退出后检查新产物。
- 新独立参考生成也限制5M架构步/600秒，先冻结输入和预期再运行DUT；超限保留诊断停止，不使用无限while。
- 新ELF seed4=2及实际UART Iterations2；两规定种子list/matrix/state CRC合法、迭代相关crcfinal由先冻结新参考判断；不能要求crcfinal等旧一次。全RF/RAM、每笔合法EX/WB与MEM及各自顺序不去重、stall/flush按新参考、无X/Z、正确返回/32拍无额外副作用。
- 计时高-低-高样本与独立物理拍一致、仅一个start/stop、raw差正确、无timer/port/overflow错误；计算区无UART等MMIO写，后置完整串行输出。两迭代若仍<10秒，明确仍非有效成绩并保留原提示；不改预期去掩盖意外多次调用/错误或重复写回。
- 与F143单次比较的是正确性及实际计算/输出/trace增长，不要求ticks精确2倍、不预承诺提速。记录新的真实主机耗时/文件量作为长测预算依据，有限通过不等完整ISA/CPU/硬件正确。
- 若CPU/存储/外设/计时语义确需额外RTL修改，原诊断保留后停，另列最小范围；不为跑通改算法/预期或换源。不把600s/256MiB静默提高成全天无限长跑。

## 禁止/成本边界

不修改13RTL/原TB/原模型/旧源或冻结历史、SCBV/时钟/供电/跳线/温控；不PDS/硬件服务器/JTAG/上电/下载/Flash、无新工具/安装/GUI/许可/管理员/环境/外发。不是≥10秒长测、正式成绩发布或FPGA时基校准。当前已查单次估算2迭代各约314/329主机秒、trace约80/83MiB，均仅预算外推；本阶段至多2编译/2新DUT，执行及检查可分批沟通，完成或失败按停止条件收尾。

用户只需批准这个有限纯软件实施阶段，无须选择普通技术细节。B原R1–R3继续独立，用户报告已转交，不再索其已有材料；B回执/新交付未知。
