minzhetang/pangu-riscv-soc/deliveries/competition-source-package-2026-11-03-v1/package/verification/offline-tool-v02/COMMANDS.md

# Commands executed

Plan SHA256: `82C42434FDE78495B6A3F9F945756F1ADE464EEEB6A5E9DC3D63E5C5F442AA4F`

## P01-S00-duplicates-kept
cwd: `C:\Users\ANON_USER\Desktop\FPGA\发给队员_盘古100Pro项目交接包_2026-10-18_v01\work\B-RETURN\B-VERIFY-OFFLINE-M0-return-v02`
native_rc: `0` elapsed_s: `0.156` timed_out: `False`
argv: `["C:\\Users\\ANON_USER\\AppData\\Local\\Programs\\Python\\Python312-embed\\python.exe", "-B", "C:\\Users\\ANON_USER\\Desktop\\FPGA\\发给队员_盘古100Pro项目交接包_2026-10-18_v01\\work\\B-RETURN\\B-VERIFY-OFFLINE-M0-return-v02\\RUN.py", "--case-file", "C:\\Users\\ANON_USER\\Desktop\\FPGA\\发给队员_盘古100Pro项目交接包_2026-10-18_v01\\work\\B-RETURN\\B-VERIFY-OFFLINE-M0-return-v02\\tests\\cases\\P01-S00-duplicates-kept.json", "--input-root", "C:\\Users\\ANON_USER\\Desktop\\FPGA\\mainline-b-verify-offline-m0-2026-10-26-v1", "--out", "C:\\Users\\ANON_USER\\AppData\\Local\\Temp\\opencode\\bverify-r1-suite-20261027-v6\\out\\P01-S00-duplicates-kept"]`

## P01-S01-wrong-field
cwd: `C:\Users\ANON_USER\Desktop\FPGA\发给队员_盘古100Pro项目交接包_2026-10-18_v01\work\B-RETURN\B-VERIFY-OFFLINE-M0-return-v02`
native_rc: `2` elapsed_s: `0.156` timed_out: `False`
argv: `["C:\\Users\\ANON_USER\\AppData\\Local\\Programs\\Python\\Python312-embed\\python.exe", "-B", "C:\\Users\\ANON_USER\\Desktop\\FPGA\\发给队员_盘古100Pro项目交接包_2026-10-18_v01\\work\\B-RETURN\\B-VERIFY-OFFLINE-M0-return-v02\\RUN.py", "--case-file", "C:\\Users\\ANON_USER\\Desktop\\FPGA\\发给队员_盘古100Pro项目交接包_2026-10-18_v01\\work\\B-RETURN\\B-VERIFY-OFFLINE-M0-return-v02\\tests\\cases\\P01-S01-wrong-field.json", "--input-root", "C:\\Users\\ANON_USER\\Desktop\\FPGA\\mainline-b-verify-offline-m0-2026-10-26-v1", "--out", "C:\\Users\\ANON_USER\\AppData\\Local\\Temp\\opencode\\bverify-r1-suite-20261027-v6\\out\\P01-S01-wrong-field"]`

## P01-S02-missing-tail
cwd: `C:\Users\ANON_USER\Desktop\FPGA\发给队员_盘古100Pro项目交接包_2026-10-18_v01\work\B-RETURN\B-VERIFY-OFFLINE-M0-return-v02`
native_rc: `2` elapsed_s: `0.172` timed_out: `False`
argv: `["C:\\Users\\ANON_USER\\AppData\\Local\\Programs\\Python\\Python312-embed\\python.exe", "-B", "C:\\Users\\ANON_USER\\Desktop\\FPGA\\发给队员_盘古100Pro项目交接包_2026-10-18_v01\\work\\B-RETURN\\B-VERIFY-OFFLINE-M0-return-v02\\RUN.py", "--case-file", "C:\\Users\\ANON_USER\\Desktop\\FPGA\\发给队员_盘古100Pro项目交接包_2026-10-18_v01\\work\\B-RETURN\\B-VERIFY-OFFLINE-M0-return-v02\\tests\\cases\\P01-S02-missing-tail.json", "--input-root", "C:\\Users\\ANON_USER\\Desktop\\FPGA\\mainline-b-verify-offline-m0-2026-10-26-v1", "--out", "C:\\Users\\ANON_USER\\AppData\\Local\\Temp\\opencode\\bverify-r1-suite-20261027-v6\\out\\P01-S02-missing-tail"]`

## P01-S03-unknown-data
cwd: `C:\Users\ANON_USER\Desktop\FPGA\发给队员_盘古100Pro项目交接包_2026-10-18_v01\work\B-RETURN\B-VERIFY-OFFLINE-M0-return-v02`
native_rc: `3` elapsed_s: `0.14` timed_out: `False`
argv: `["C:\\Users\\ANON_USER\\AppData\\Local\\Programs\\Python\\Python312-embed\\python.exe", "-B", "C:\\Users\\ANON_USER\\Desktop\\FPGA\\发给队员_盘古100Pro项目交接包_2026-10-18_v01\\work\\B-RETURN\\B-VERIFY-OFFLINE-M0-return-v02\\RUN.py", "--case-file", "C:\\Users\\ANON_USER\\Desktop\\FPGA\\发给队员_盘古100Pro项目交接包_2026-10-18_v01\\work\\B-RETURN\\B-VERIFY-OFFLINE-M0-return-v02\\tests\\cases\\P01-S03-unknown-data.json", "--input-root", "C:\\Users\\ANON_USER\\Desktop\\FPGA\\mainline-b-verify-offline-m0-2026-10-26-v1", "--out", "C:\\Users\\ANON_USER\\AppData\\Local\\Temp\\opencode\\bverify-r1-suite-20261027-v6\\out\\P01-S03-unknown-data"]`

## P01-S04-empty-explicit
cwd: `C:\Users\ANON_USER\Desktop\FPGA\发给队员_盘古100Pro项目交接包_2026-10-18_v01\work\B-RETURN\B-VERIFY-OFFLINE-M0-return-v02`
native_rc: `0` elapsed_s: `0.172` timed_out: `False`
argv: `["C:\\Users\\ANON_USER\\AppData\\Local\\Programs\\Python\\Python312-embed\\python.exe", "-B", "C:\\Users\\ANON_USER\\Desktop\\FPGA\\发给队员_盘古100Pro项目交接包_2026-10-18_v01\\work\\B-RETURN\\B-VERIFY-OFFLINE-M0-return-v02\\RUN.py", "--case-file", "C:\\Users\\ANON_USER\\Desktop\\FPGA\\发给队员_盘古100Pro项目交接包_2026-10-18_v01\\work\\B-RETURN\\B-VERIFY-OFFLINE-M0-return-v02\\tests\\cases\\P01-S04-empty-explicit.json", "--input-root", "C:\\Users\\ANON_USER\\Desktop\\FPGA\\mainline-b-verify-offline-m0-2026-10-26-v1", "--out", "C:\\Users\\ANON_USER\\AppData\\Local\\Temp\\opencode\\bverify-r1-suite-20261027-v6\\out\\P01-S04-empty-explicit"]`

## P01-S05-empty-forbidden
cwd: `C:\Users\ANON_USER\Desktop\FPGA\发给队员_盘古100Pro项目交接包_2026-10-18_v01\work\B-RETURN\B-VERIFY-OFFLINE-M0-return-v02`
native_rc: `4` elapsed_s: `0.157` timed_out: `False`
argv: `["C:\\Users\\ANON_USER\\AppData\\Local\\Programs\\Python\\Python312-embed\\python.exe", "-B", "C:\\Users\\ANON_USER\\Desktop\\FPGA\\发给队员_盘古100Pro项目交接包_2026-10-18_v01\\work\\B-RETURN\\B-VERIFY-OFFLINE-M0-return-v02\\RUN.py", "--case-file", "C:\\Users\\ANON_USER\\Desktop\\FPGA\\发给队员_盘古100Pro项目交接包_2026-10-18_v01\\work\\B-RETURN\\B-VERIFY-OFFLINE-M0-return-v02\\tests\\cases\\P01-S05-empty-forbidden.json", "--input-root", "C:\\Users\\ANON_USER\\Desktop\\FPGA\\mainline-b-verify-offline-m0-2026-10-26-v1", "--out", "C:\\Users\\ANON_USER\\AppData\\Local\\Temp\\opencode\\bverify-r1-suite-20261027-v6\\out\\P01-S05-empty-forbidden"]`

## P01-S06-bus-format
cwd: `C:\Users\ANON_USER\Desktop\FPGA\发给队员_盘古100Pro项目交接包_2026-10-18_v01\work\B-RETURN\B-VERIFY-OFFLINE-M0-return-v02`
native_rc: `0` elapsed_s: `0.156` timed_out: `False`
argv: `["C:\\Users\\ANON_USER\\AppData\\Local\\Programs\\Python\\Python312-embed\\python.exe", "-B", "C:\\Users\\ANON_USER\\Desktop\\FPGA\\发给队员_盘古100Pro项目交接包_2026-10-18_v01\\work\\B-RETURN\\B-VERIFY-OFFLINE-M0-return-v02\\RUN.py", "--case-file", "C:\\Users\\ANON_USER\\Desktop\\FPGA\\发给队员_盘古100Pro项目交接包_2026-10-18_v01\\work\\B-RETURN\\B-VERIFY-OFFLINE-M0-return-v02\\tests\\cases\\P01-S06-bus-format.json", "--input-root", "C:\\Users\\ANON_USER\\Desktop\\FPGA\\mainline-b-verify-offline-m0-2026-10-26-v1", "--out", "C:\\Users\\ANON_USER\\AppData\\Local\\Temp\\opencode\\bverify-r1-suite-20261027-v6\\out\\P01-S06-bus-format"]`

## P02-R-performance-trace
cwd: `C:\Users\ANON_USER\Desktop\FPGA\发给队员_盘古100Pro项目交接包_2026-10-18_v01\work\B-RETURN\B-VERIFY-OFFLINE-M0-return-v02`
native_rc: `0` elapsed_s: `21.203` timed_out: `False`
argv: `["C:\\Users\\ANON_USER\\AppData\\Local\\Programs\\Python\\Python312-embed\\python.exe", "-B", "C:\\Users\\ANON_USER\\Desktop\\FPGA\\发给队员_盘古100Pro项目交接包_2026-10-18_v01\\work\\B-RETURN\\B-VERIFY-OFFLINE-M0-return-v02\\RUN.py", "--case-file", "C:\\Users\\ANON_USER\\Desktop\\FPGA\\发给队员_盘古100Pro项目交接包_2026-10-18_v01\\work\\B-RETURN\\B-VERIFY-OFFLINE-M0-return-v02\\tests\\cases\\P02-R-performance-trace.json", "--input-root", "C:\\Users\\ANON_USER\\Desktop\\FPGA\\mainline-b-verify-offline-m0-2026-10-26-v1", "--out", "C:\\Users\\ANON_USER\\AppData\\Local\\Temp\\opencode\\bverify-r1-suite-20261027-v6\\out\\P02-R-performance-trace"]`

## P02-R-performance-bus
cwd: `C:\Users\ANON_USER\Desktop\FPGA\发给队员_盘古100Pro项目交接包_2026-10-18_v01\work\B-RETURN\B-VERIFY-OFFLINE-M0-return-v02`
native_rc: `0` elapsed_s: `24.953` timed_out: `False`
argv: `["C:\\Users\\ANON_USER\\AppData\\Local\\Programs\\Python\\Python312-embed\\python.exe", "-B", "C:\\Users\\ANON_USER\\Desktop\\FPGA\\发给队员_盘古100Pro项目交接包_2026-10-18_v01\\work\\B-RETURN\\B-VERIFY-OFFLINE-M0-return-v02\\RUN.py", "--case-file", "C:\\Users\\ANON_USER\\Desktop\\FPGA\\发给队员_盘古100Pro项目交接包_2026-10-18_v01\\work\\B-RETURN\\B-VERIFY-OFFLINE-M0-return-v02\\tests\\cases\\P02-R-performance-bus.json", "--input-root", "C:\\Users\\ANON_USER\\Desktop\\FPGA\\mainline-b-verify-offline-m0-2026-10-26-v1", "--out", "C:\\Users\\ANON_USER\\AppData\\Local\\Temp\\opencode\\bverify-r1-suite-20261027-v6\\out\\P02-R-performance-bus"]`

## P02-R-validation-trace
cwd: `C:\Users\ANON_USER\Desktop\FPGA\发给队员_盘古100Pro项目交接包_2026-10-18_v01\work\B-RETURN\B-VERIFY-OFFLINE-M0-return-v02`
native_rc: `0` elapsed_s: `22.016` timed_out: `False`
argv: `["C:\\Users\\ANON_USER\\AppData\\Local\\Programs\\Python\\Python312-embed\\python.exe", "-B", "C:\\Users\\ANON_USER\\Desktop\\FPGA\\发给队员_盘古100Pro项目交接包_2026-10-18_v01\\work\\B-RETURN\\B-VERIFY-OFFLINE-M0-return-v02\\RUN.py", "--case-file", "C:\\Users\\ANON_USER\\Desktop\\FPGA\\发给队员_盘古100Pro项目交接包_2026-10-18_v01\\work\\B-RETURN\\B-VERIFY-OFFLINE-M0-return-v02\\tests\\cases\\P02-R-validation-trace.json", "--input-root", "C:\\Users\\ANON_USER\\Desktop\\FPGA\\mainline-b-verify-offline-m0-2026-10-26-v1", "--out", "C:\\Users\\ANON_USER\\AppData\\Local\\Temp\\opencode\\bverify-r1-suite-20261027-v6\\out\\P02-R-validation-trace"]`

## P02-R-validation-bus
cwd: `C:\Users\ANON_USER\Desktop\FPGA\发给队员_盘古100Pro项目交接包_2026-10-18_v01\work\B-RETURN\B-VERIFY-OFFLINE-M0-return-v02`
native_rc: `0` elapsed_s: `24.906` timed_out: `False`
argv: `["C:\\Users\\ANON_USER\\AppData\\Local\\Programs\\Python\\Python312-embed\\python.exe", "-B", "C:\\Users\\ANON_USER\\Desktop\\FPGA\\发给队员_盘古100Pro项目交接包_2026-10-18_v01\\work\\B-RETURN\\B-VERIFY-OFFLINE-M0-return-v02\\RUN.py", "--case-file", "C:\\Users\\ANON_USER\\Desktop\\FPGA\\发给队员_盘古100Pro项目交接包_2026-10-18_v01\\work\\B-RETURN\\B-VERIFY-OFFLINE-M0-return-v02\\tests\\cases\\P02-R-validation-bus.json", "--input-root", "C:\\Users\\ANON_USER\\Desktop\\FPGA\\mainline-b-verify-offline-m0-2026-10-26-v1", "--out", "C:\\Users\\ANON_USER\\AppData\\Local\\Temp\\opencode\\bverify-r1-suite-20261027-v6\\out\\P02-R-validation-bus"]`

## F01
cwd: `C:\Users\ANON_USER\Desktop\FPGA\发给队员_盘古100Pro项目交接包_2026-10-18_v01\work\B-RETURN\B-VERIFY-OFFLINE-M0-return-v02`
native_rc: `2` elapsed_s: `0.156` timed_out: `False`
argv: `["C:\\Users\\ANON_USER\\AppData\\Local\\Programs\\Python\\Python312-embed\\python.exe", "-B", "C:\\Users\\ANON_USER\\Desktop\\FPGA\\发给队员_盘古100Pro项目交接包_2026-10-18_v01\\work\\B-RETURN\\B-VERIFY-OFFLINE-M0-return-v02\\RUN.py", "--case-file", "C:\\Users\\ANON_USER\\Desktop\\FPGA\\发给队员_盘古100Pro项目交接包_2026-10-18_v01\\work\\B-RETURN\\B-VERIFY-OFFLINE-M0-return-v02\\tests\\cases\\F01.json", "--input-root", "C:\\Users\\ANON_USER\\AppData\\Local\\Temp\\opencode\\bverify-r1-suite-20261027-v6\\input", "--out", "C:\\Users\\ANON_USER\\AppData\\Local\\Temp\\opencode\\bverify-r1-suite-20261027-v6\\out\\F01"]`

## F02
cwd: `C:\Users\ANON_USER\Desktop\FPGA\发给队员_盘古100Pro项目交接包_2026-10-18_v01\work\B-RETURN\B-VERIFY-OFFLINE-M0-return-v02`
native_rc: `2` elapsed_s: `0.172` timed_out: `False`
argv: `["C:\\Users\\ANON_USER\\AppData\\Local\\Programs\\Python\\Python312-embed\\python.exe", "-B", "C:\\Users\\ANON_USER\\Desktop\\FPGA\\发给队员_盘古100Pro项目交接包_2026-10-18_v01\\work\\B-RETURN\\B-VERIFY-OFFLINE-M0-return-v02\\RUN.py", "--case-file", "C:\\Users\\ANON_USER\\Desktop\\FPGA\\发给队员_盘古100Pro项目交接包_2026-10-18_v01\\work\\B-RETURN\\B-VERIFY-OFFLINE-M0-return-v02\\tests\\cases\\F02.json", "--input-root", "C:\\Users\\ANON_USER\\AppData\\Local\\Temp\\opencode\\bverify-r1-suite-20261027-v6\\input", "--out", "C:\\Users\\ANON_USER\\AppData\\Local\\Temp\\opencode\\bverify-r1-suite-20261027-v6\\out\\F02"]`

## F03
cwd: `C:\Users\ANON_USER\Desktop\FPGA\发给队员_盘古100Pro项目交接包_2026-10-18_v01\work\B-RETURN\B-VERIFY-OFFLINE-M0-return-v02`
native_rc: `2` elapsed_s: `0.156` timed_out: `False`
argv: `["C:\\Users\\ANON_USER\\AppData\\Local\\Programs\\Python\\Python312-embed\\python.exe", "-B", "C:\\Users\\ANON_USER\\Desktop\\FPGA\\发给队员_盘古100Pro项目交接包_2026-10-18_v01\\work\\B-RETURN\\B-VERIFY-OFFLINE-M0-return-v02\\RUN.py", "--case-file", "C:\\Users\\ANON_USER\\Desktop\\FPGA\\发给队员_盘古100Pro项目交接包_2026-10-18_v01\\work\\B-RETURN\\B-VERIFY-OFFLINE-M0-return-v02\\tests\\cases\\F03.json", "--input-root", "C:\\Users\\ANON_USER\\AppData\\Local\\Temp\\opencode\\bverify-r1-suite-20261027-v6\\input", "--out", "C:\\Users\\ANON_USER\\AppData\\Local\\Temp\\opencode\\bverify-r1-suite-20261027-v6\\out\\F03"]`

## F04
cwd: `C:\Users\ANON_USER\Desktop\FPGA\发给队员_盘古100Pro项目交接包_2026-10-18_v01\work\B-RETURN\B-VERIFY-OFFLINE-M0-return-v02`
native_rc: `0` elapsed_s: `0.172` timed_out: `False`
argv: `["C:\\Users\\ANON_USER\\AppData\\Local\\Programs\\Python\\Python312-embed\\python.exe", "-B", "C:\\Users\\ANON_USER\\Desktop\\FPGA\\发给队员_盘古100Pro项目交接包_2026-10-18_v01\\work\\B-RETURN\\B-VERIFY-OFFLINE-M0-return-v02\\RUN.py", "--case-file", "C:\\Users\\ANON_USER\\Desktop\\FPGA\\发给队员_盘古100Pro项目交接包_2026-10-18_v01\\work\\B-RETURN\\B-VERIFY-OFFLINE-M0-return-v02\\tests\\cases\\F04.json", "--input-root", "C:\\Users\\ANON_USER\\Desktop\\FPGA\\mainline-b-verify-offline-m0-2026-10-26-v1", "--out", "C:\\Users\\ANON_USER\\AppData\\Local\\Temp\\opencode\\bverify-r1-suite-20261027-v6\\out\\F04"]`

## F05
cwd: `C:\Users\ANON_USER\Desktop\FPGA\发给队员_盘古100Pro项目交接包_2026-10-18_v01\work\B-RETURN\B-VERIFY-OFFLINE-M0-return-v02`
native_rc: `2` elapsed_s: `0.172` timed_out: `False`
argv: `["C:\\Users\\ANON_USER\\AppData\\Local\\Programs\\Python\\Python312-embed\\python.exe", "-B", "C:\\Users\\ANON_USER\\Desktop\\FPGA\\发给队员_盘古100Pro项目交接包_2026-10-18_v01\\work\\B-RETURN\\B-VERIFY-OFFLINE-M0-return-v02\\RUN.py", "--case-file", "C:\\Users\\ANON_USER\\Desktop\\FPGA\\发给队员_盘古100Pro项目交接包_2026-10-18_v01\\work\\B-RETURN\\B-VERIFY-OFFLINE-M0-return-v02\\tests\\cases\\F05.json", "--input-root", "C:\\Users\\ANON_USER\\AppData\\Local\\Temp\\opencode\\bverify-r1-suite-20261027-v6\\input", "--out", "C:\\Users\\ANON_USER\\AppData\\Local\\Temp\\opencode\\bverify-r1-suite-20261027-v6\\out\\F05"]`

## F06
cwd: `C:\Users\ANON_USER\Desktop\FPGA\发给队员_盘古100Pro项目交接包_2026-10-18_v01\work\B-RETURN\B-VERIFY-OFFLINE-M0-return-v02`
native_rc: `2` elapsed_s: `0.172` timed_out: `False`
argv: `["C:\\Users\\ANON_USER\\AppData\\Local\\Programs\\Python\\Python312-embed\\python.exe", "-B", "C:\\Users\\ANON_USER\\Desktop\\FPGA\\发给队员_盘古100Pro项目交接包_2026-10-18_v01\\work\\B-RETURN\\B-VERIFY-OFFLINE-M0-return-v02\\RUN.py", "--case-file", "C:\\Users\\ANON_USER\\Desktop\\FPGA\\发给队员_盘古100Pro项目交接包_2026-10-18_v01\\work\\B-RETURN\\B-VERIFY-OFFLINE-M0-return-v02\\tests\\cases\\F06.json", "--input-root", "C:\\Users\\ANON_USER\\AppData\\Local\\Temp\\opencode\\bverify-r1-suite-20261027-v6\\input", "--out", "C:\\Users\\ANON_USER\\AppData\\Local\\Temp\\opencode\\bverify-r1-suite-20261027-v6\\out\\F06"]`

## F07
cwd: `C:\Users\ANON_USER\Desktop\FPGA\发给队员_盘古100Pro项目交接包_2026-10-18_v01\work\B-RETURN\B-VERIFY-OFFLINE-M0-return-v02`
native_rc: `3` elapsed_s: `0.157` timed_out: `False`
argv: `["C:\\Users\\ANON_USER\\AppData\\Local\\Programs\\Python\\Python312-embed\\python.exe", "-B", "C:\\Users\\ANON_USER\\Desktop\\FPGA\\发给队员_盘古100Pro项目交接包_2026-10-18_v01\\work\\B-RETURN\\B-VERIFY-OFFLINE-M0-return-v02\\RUN.py", "--case-file", "C:\\Users\\ANON_USER\\Desktop\\FPGA\\发给队员_盘古100Pro项目交接包_2026-10-18_v01\\work\\B-RETURN\\B-VERIFY-OFFLINE-M0-return-v02\\tests\\cases\\F07.json", "--input-root", "C:\\Users\\ANON_USER\\AppData\\Local\\Temp\\opencode\\bverify-r1-suite-20261027-v6\\input", "--out", "C:\\Users\\ANON_USER\\AppData\\Local\\Temp\\opencode\\bverify-r1-suite-20261027-v6\\out\\F07"]`

## F08
cwd: `C:\Users\ANON_USER\Desktop\FPGA\发给队员_盘古100Pro项目交接包_2026-10-18_v01\work\B-RETURN\B-VERIFY-OFFLINE-M0-return-v02`
native_rc: `3` elapsed_s: `0.172` timed_out: `False`
argv: `["C:\\Users\\ANON_USER\\AppData\\Local\\Programs\\Python\\Python312-embed\\python.exe", "-B", "C:\\Users\\ANON_USER\\Desktop\\FPGA\\发给队员_盘古100Pro项目交接包_2026-10-18_v01\\work\\B-RETURN\\B-VERIFY-OFFLINE-M0-return-v02\\RUN.py", "--case-file", "C:\\Users\\ANON_USER\\Desktop\\FPGA\\发给队员_盘古100Pro项目交接包_2026-10-18_v01\\work\\B-RETURN\\B-VERIFY-OFFLINE-M0-return-v02\\tests\\cases\\F08.json", "--input-root", "C:\\Users\\ANON_USER\\AppData\\Local\\Temp\\opencode\\bverify-r1-suite-20261027-v6\\input", "--out", "C:\\Users\\ANON_USER\\AppData\\Local\\Temp\\opencode\\bverify-r1-suite-20261027-v6\\out\\F08"]`

## F13
cwd: `C:\Users\ANON_USER\Desktop\FPGA\发给队员_盘古100Pro项目交接包_2026-10-18_v01\work\B-RETURN\B-VERIFY-OFFLINE-M0-return-v02`
native_rc: `3` elapsed_s: `0.172` timed_out: `False`
argv: `["C:\\Users\\ANON_USER\\AppData\\Local\\Programs\\Python\\Python312-embed\\python.exe", "-B", "C:\\Users\\ANON_USER\\Desktop\\FPGA\\发给队员_盘古100Pro项目交接包_2026-10-18_v01\\work\\B-RETURN\\B-VERIFY-OFFLINE-M0-return-v02\\RUN.py", "--case-file", "C:\\Users\\ANON_USER\\Desktop\\FPGA\\发给队员_盘古100Pro项目交接包_2026-10-18_v01\\work\\B-RETURN\\B-VERIFY-OFFLINE-M0-return-v02\\tests\\cases\\F13.json", "--input-root", "C:\\Users\\ANON_USER\\AppData\\Local\\Temp\\opencode\\bverify-r1-suite-20261027-v6\\input", "--out", "C:\\Users\\ANON_USER\\AppData\\Local\\Temp\\opencode\\bverify-r1-suite-20261027-v6\\out\\F13"]`

## F09
cwd: `C:\Users\ANON_USER\Desktop\FPGA\发给队员_盘古100Pro项目交接包_2026-10-18_v01\work\B-RETURN\B-VERIFY-OFFLINE-M0-return-v02`
native_rc: `4` elapsed_s: `0.172` timed_out: `False`
argv: `["C:\\Users\\ANON_USER\\AppData\\Local\\Programs\\Python\\Python312-embed\\python.exe", "-B", "C:\\Users\\ANON_USER\\Desktop\\FPGA\\发给队员_盘古100Pro项目交接包_2026-10-18_v01\\work\\B-RETURN\\B-VERIFY-OFFLINE-M0-return-v02\\RUN.py", "--case-file", "C:\\Users\\ANON_USER\\Desktop\\FPGA\\发给队员_盘古100Pro项目交接包_2026-10-18_v01\\work\\B-RETURN\\B-VERIFY-OFFLINE-M0-return-v02\\tests\\cases\\F09.json", "--input-root", "C:\\Users\\ANON_USER\\Desktop\\FPGA\\mainline-b-verify-offline-m0-2026-10-26-v1", "--out", "C:\\Users\\ANON_USER\\AppData\\Local\\Temp\\opencode\\bverify-r1-suite-20261027-v6\\out\\F09"]`

## F10
cwd: `C:\Users\ANON_USER\Desktop\FPGA\发给队员_盘古100Pro项目交接包_2026-10-18_v01\work\B-RETURN\B-VERIFY-OFFLINE-M0-return-v02`
native_rc: `3` elapsed_s: `0.156` timed_out: `False`
argv: `["C:\\Users\\ANON_USER\\AppData\\Local\\Programs\\Python\\Python312-embed\\python.exe", "-B", "C:\\Users\\ANON_USER\\Desktop\\FPGA\\发给队员_盘古100Pro项目交接包_2026-10-18_v01\\work\\B-RETURN\\B-VERIFY-OFFLINE-M0-return-v02\\RUN.py", "--case-file", "C:\\Users\\ANON_USER\\Desktop\\FPGA\\发给队员_盘古100Pro项目交接包_2026-10-18_v01\\work\\B-RETURN\\B-VERIFY-OFFLINE-M0-return-v02\\tests\\cases\\F10.json", "--input-root", "C:\\Users\\ANON_USER\\AppData\\Local\\Temp\\opencode\\bverify-r1-suite-20261027-v6\\input", "--out", "C:\\Users\\ANON_USER\\AppData\\Local\\Temp\\opencode\\bverify-r1-suite-20261027-v6\\out\\F10"]`

## F11
cwd: `C:\Users\ANON_USER\Desktop\FPGA\发给队员_盘古100Pro项目交接包_2026-10-18_v01\work\B-RETURN\B-VERIFY-OFFLINE-M0-return-v02`
native_rc: `3` elapsed_s: `0.172` timed_out: `False`
argv: `["C:\\Users\\ANON_USER\\AppData\\Local\\Programs\\Python\\Python312-embed\\python.exe", "-B", "C:\\Users\\ANON_USER\\Desktop\\FPGA\\发给队员_盘古100Pro项目交接包_2026-10-18_v01\\work\\B-RETURN\\B-VERIFY-OFFLINE-M0-return-v02\\RUN.py", "--case-file", "C:\\Users\\ANON_USER\\Desktop\\FPGA\\发给队员_盘古100Pro项目交接包_2026-10-18_v01\\work\\B-RETURN\\B-VERIFY-OFFLINE-M0-return-v02\\tests\\cases\\F11.json", "--input-root", "C:\\Users\\ANON_USER\\AppData\\Local\\Temp\\opencode\\bverify-r1-suite-20261027-v6\\input", "--out", "C:\\Users\\ANON_USER\\AppData\\Local\\Temp\\opencode\\bverify-r1-suite-20261027-v6\\out\\F11"]`

## F12
cwd: `C:\Users\ANON_USER\Desktop\FPGA\发给队员_盘古100Pro项目交接包_2026-10-18_v01\work\B-RETURN\B-VERIFY-OFFLINE-M0-return-v02`
native_rc: `3` elapsed_s: `0.156` timed_out: `False`
argv: `["C:\\Users\\ANON_USER\\AppData\\Local\\Programs\\Python\\Python312-embed\\python.exe", "-B", "C:\\Users\\ANON_USER\\Desktop\\FPGA\\发给队员_盘古100Pro项目交接包_2026-10-18_v01\\work\\B-RETURN\\B-VERIFY-OFFLINE-M0-return-v02\\RUN.py", "--case-file", "C:\\Users\\ANON_USER\\Desktop\\FPGA\\发给队员_盘古100Pro项目交接包_2026-10-18_v01\\work\\B-RETURN\\B-VERIFY-OFFLINE-M0-return-v02\\tests\\cases\\F12.json", "--input-root", "C:\\Users\\ANON_USER\\AppData\\Local\\Temp\\opencode\\bverify-r1-suite-20261027-v6\\input", "--out", "C:\\Users\\ANON_USER\\AppData\\Local\\Temp\\opencode\\bverify-r1-suite-20261027-v6\\out\\F12"]`

## F14
cwd: `C:\Users\ANON_USER\Desktop\FPGA\发给队员_盘古100Pro项目交接包_2026-10-18_v01\work\B-RETURN\B-VERIFY-OFFLINE-M0-return-v02`
native_rc: `5` elapsed_s: `0.156` timed_out: `False`
argv: `["C:\\Users\\ANON_USER\\AppData\\Local\\Programs\\Python\\Python312-embed\\python.exe", "-B", "C:\\Users\\ANON_USER\\Desktop\\FPGA\\发给队员_盘古100Pro项目交接包_2026-10-18_v01\\work\\B-RETURN\\B-VERIFY-OFFLINE-M0-return-v02\\RUN.py", "--case-file", "C:\\Users\\ANON_USER\\Desktop\\FPGA\\发给队员_盘古100Pro项目交接包_2026-10-18_v01\\work\\B-RETURN\\B-VERIFY-OFFLINE-M0-return-v02\\tests\\cases\\F14.json", "--input-root", "C:\\Users\\ANON_USER\\Desktop\\FPGA\\mainline-b-verify-offline-m0-2026-10-26-v1", "--out", "C:\\Users\\ANON_USER\\AppData\\Local\\Temp\\opencode\\bverify-r1-suite-20261027-v6\\out\\F14"]`

## F15
cwd: `C:\Users\ANON_USER\Desktop\FPGA\发给队员_盘古100Pro项目交接包_2026-10-18_v01\work\B-RETURN\B-VERIFY-OFFLINE-M0-return-v02`
native_rc: `6` elapsed_s: `0.172` timed_out: `False`
argv: `["C:\\Users\\ANON_USER\\AppData\\Local\\Programs\\Python\\Python312-embed\\python.exe", "-B", "C:\\Users\\ANON_USER\\Desktop\\FPGA\\发给队员_盘古100Pro项目交接包_2026-10-18_v01\\work\\B-RETURN\\B-VERIFY-OFFLINE-M0-return-v02\\RUN.py", "--case-file", "C:\\Users\\ANON_USER\\Desktop\\FPGA\\发给队员_盘古100Pro项目交接包_2026-10-18_v01\\work\\B-RETURN\\B-VERIFY-OFFLINE-M0-return-v02\\tests\\cases\\F15.json", "--input-root", "C:\\Users\\ANON_USER\\AppData\\Local\\Temp\\opencode\\bverify-r1-suite-20261027-v6\\input", "--out", "C:\\Users\\ANON_USER\\AppData\\Local\\Temp\\opencode\\bverify-r1-suite-20261027-v6\\out\\F15"]`

## F16
cwd: `C:\Users\ANON_USER\Desktop\FPGA\发给队员_盘古100Pro项目交接包_2026-10-18_v01\work\B-RETURN\B-VERIFY-OFFLINE-M0-return-v02`
native_rc: `7` elapsed_s: `0.063` timed_out: `False`
argv: `["C:\\Users\\ANON_USER\\AppData\\Local\\Programs\\Python\\Python312-embed\\python.exe", "-B", "C:\\Users\\ANON_USER\\Desktop\\FPGA\\发给队员_盘古100Pro项目交接包_2026-10-18_v01\\work\\B-RETURN\\B-VERIFY-OFFLINE-M0-return-v02\\RUN.py", "--case-file", "C:\\Users\\ANON_USER\\Desktop\\FPGA\\发给队员_盘古100Pro项目交接包_2026-10-18_v01\\work\\B-RETURN\\B-VERIFY-OFFLINE-M0-return-v02\\tests\\cases\\F16.json", "--input-root", "C:\\Users\\ANON_USER\\Desktop\\FPGA\\mainline-b-verify-offline-m0-2026-10-26-v1", "--out", "C:\\Users\\ANON_USER\\AppData\\Local\\Temp\\opencode\\bverify-r1-suite-20261027-v6\\out\\F16"]`

## F19
cwd: `C:\Users\ANON_USER\Desktop\FPGA\发给队员_盘古100Pro项目交接包_2026-10-18_v01\work\B-RETURN\B-VERIFY-OFFLINE-M0-return-v02`
native_rc: `3` elapsed_s: `0.078` timed_out: `False`
argv: `["C:\\Users\\ANON_USER\\AppData\\Local\\Programs\\Python\\Python312-embed\\python.exe", "-O", "-B", "C:\\Users\\ANON_USER\\Desktop\\FPGA\\发给队员_盘古100Pro项目交接包_2026-10-18_v01\\work\\B-RETURN\\B-VERIFY-OFFLINE-M0-return-v02\\RUN.py", "--case-file", "C:\\Users\\ANON_USER\\Desktop\\FPGA\\发给队员_盘古100Pro项目交接包_2026-10-18_v01\\work\\B-RETURN\\B-VERIFY-OFFLINE-M0-return-v02\\tests\\cases\\F19.json", "--input-root", "C:\\Users\\ANON_USER\\Desktop\\FPGA\\mainline-b-verify-offline-m0-2026-10-26-v1", "--out", "C:\\Users\\ANON_USER\\AppData\\Local\\Temp\\opencode\\bverify-r1-suite-20261027-v6\\out\\F19"]`

## D01
cwd: `C:\Users\ANON_USER\Desktop\FPGA\发给队员_盘古100Pro项目交接包_2026-10-18_v01\work\B-RETURN\B-VERIFY-OFFLINE-M0-return-v02`
native_rc: `2` elapsed_s: `0.156` timed_out: `False`
argv: `["C:\\Users\\ANON_USER\\AppData\\Local\\Programs\\Python\\Python312-embed\\python.exe", "-B", "C:\\Users\\ANON_USER\\Desktop\\FPGA\\发给队员_盘古100Pro项目交接包_2026-10-18_v01\\work\\B-RETURN\\B-VERIFY-OFFLINE-M0-return-v02\\RUN.py", "--case-file", "C:\\Users\\ANON_USER\\Desktop\\FPGA\\发给队员_盘古100Pro项目交接包_2026-10-18_v01\\work\\B-RETURN\\B-VERIFY-OFFLINE-M0-return-v02\\tests\\cases\\D01.json", "--input-root", "C:\\Users\\ANON_USER\\AppData\\Local\\Temp\\opencode\\bverify-r1-suite-20261027-v6\\input", "--out", "C:\\Users\\ANON_USER\\AppData\\Local\\Temp\\opencode\\bverify-r1-suite-20261027-v6\\out\\D01"]`

## D02
cwd: `C:\Users\ANON_USER\Desktop\FPGA\发给队员_盘古100Pro项目交接包_2026-10-18_v01\work\B-RETURN\B-VERIFY-OFFLINE-M0-return-v02`
native_rc: `2` elapsed_s: `2.031` timed_out: `False`
argv: `["C:\\Users\\ANON_USER\\AppData\\Local\\Programs\\Python\\Python312-embed\\python.exe", "-B", "C:\\Users\\ANON_USER\\Desktop\\FPGA\\发给队员_盘古100Pro项目交接包_2026-10-18_v01\\work\\B-RETURN\\B-VERIFY-OFFLINE-M0-return-v02\\RUN.py", "--case-file", "C:\\Users\\ANON_USER\\Desktop\\FPGA\\发给队员_盘古100Pro项目交接包_2026-10-18_v01\\work\\B-RETURN\\B-VERIFY-OFFLINE-M0-return-v02\\tests\\cases\\D02.json", "--input-root", "C:\\Users\\ANON_USER\\AppData\\Local\\Temp\\opencode\\bverify-r1-suite-20261027-v6\\input", "--out", "C:\\Users\\ANON_USER\\AppData\\Local\\Temp\\opencode\\bverify-r1-suite-20261027-v6\\out\\D02"]`

## R01
cwd: `C:\Users\ANON_USER\AppData\Local\Temp\opencode\bverify-r1-suite-20261027-v6\moved 中文 空格`
native_rc: `0` elapsed_s: `0.188` timed_out: `False`
argv: `["C:\\Users\\ANON_USER\\AppData\\Local\\Programs\\Python\\Python312-embed\\python.exe", "-B", "C:\\Users\\ANON_USER\\AppData\\Local\\Temp\\opencode\\bverify-r1-suite-20261027-v6\\moved 中文 空格\\return tool\\RUN.py", "--case-file", "C:\\Users\\ANON_USER\\AppData\\Local\\Temp\\opencode\\bverify-r1-suite-20261027-v6\\moved 中文 空格\\return tool\\tests\\cases\\R01.json", "--input-root", "C:\\Users\\ANON_USER\\AppData\\Local\\Temp\\opencode\\bverify-r1-suite-20261027-v6\\moved 中文 空格\\input package", "--out", "C:\\Users\\ANON_USER\\AppData\\Local\\Temp\\opencode\\bverify-r1-suite-20261027-v6\\moved 中文 空格\\out R01"]`

## S01-1
cwd: `C:\Users\ANON_USER\Desktop\FPGA\发给队员_盘古100Pro项目交接包_2026-10-18_v01\work\B-RETURN\B-VERIFY-OFFLINE-M0-return-v02`
native_rc: `0` elapsed_s: `0.391` timed_out: `False`
argv: `["C:\\Users\\ANON_USER\\AppData\\Local\\Programs\\Python\\Python312-embed\\python.exe", "-B", "C:\\Users\\ANON_USER\\Desktop\\FPGA\\发给队员_盘古100Pro项目交接包_2026-10-18_v01\\work\\B-RETURN\\B-VERIFY-OFFLINE-M0-return-v02\\RUN.py", "--case-file", "C:\\Users\\ANON_USER\\Desktop\\FPGA\\发给队员_盘古100Pro项目交接包_2026-10-18_v01\\work\\B-RETURN\\B-VERIFY-OFFLINE-M0-return-v02\\tests\\cases\\S01-1.json", "--input-root", "C:\\Users\\ANON_USER\\AppData\\Local\\Temp\\opencode\\bverify-r1-suite-20261027-v6\\input", "--out", "C:\\Users\\ANON_USER\\AppData\\Local\\Temp\\opencode\\bverify-r1-suite-20261027-v6\\out\\S01-1"]`

## S01-16
cwd: `C:\Users\ANON_USER\Desktop\FPGA\发给队员_盘古100Pro项目交接包_2026-10-18_v01\work\B-RETURN\B-VERIFY-OFFLINE-M0-return-v02`
native_rc: `0` elapsed_s: `3.875` timed_out: `False`
argv: `["C:\\Users\\ANON_USER\\AppData\\Local\\Programs\\Python\\Python312-embed\\python.exe", "-B", "C:\\Users\\ANON_USER\\Desktop\\FPGA\\发给队员_盘古100Pro项目交接包_2026-10-18_v01\\work\\B-RETURN\\B-VERIFY-OFFLINE-M0-return-v02\\RUN.py", "--case-file", "C:\\Users\\ANON_USER\\Desktop\\FPGA\\发给队员_盘古100Pro项目交接包_2026-10-18_v01\\work\\B-RETURN\\B-VERIFY-OFFLINE-M0-return-v02\\tests\\cases\\S01-16.json", "--input-root", "C:\\Users\\ANON_USER\\AppData\\Local\\Temp\\opencode\\bverify-r1-suite-20261027-v6\\input", "--out", "C:\\Users\\ANON_USER\\AppData\\Local\\Temp\\opencode\\bverify-r1-suite-20261027-v6\\out\\S01-16"]`

## S01-128
cwd: `C:\Users\ANON_USER\Desktop\FPGA\发给队员_盘古100Pro项目交接包_2026-10-18_v01\work\B-RETURN\B-VERIFY-OFFLINE-M0-return-v02`
native_rc: `0` elapsed_s: `30.047` timed_out: `False`
argv: `["C:\\Users\\ANON_USER\\AppData\\Local\\Programs\\Python\\Python312-embed\\python.exe", "-B", "C:\\Users\\ANON_USER\\Desktop\\FPGA\\发给队员_盘古100Pro项目交接包_2026-10-18_v01\\work\\B-RETURN\\B-VERIFY-OFFLINE-M0-return-v02\\RUN.py", "--case-file", "C:\\Users\\ANON_USER\\Desktop\\FPGA\\发给队员_盘古100Pro项目交接包_2026-10-18_v01\\work\\B-RETURN\\B-VERIFY-OFFLINE-M0-return-v02\\tests\\cases\\S01-128.json", "--input-root", "C:\\Users\\ANON_USER\\AppData\\Local\\Temp\\opencode\\bverify-r1-suite-20261027-v6\\input", "--out", "C:\\Users\\ANON_USER\\AppData\\Local\\Temp\\opencode\\bverify-r1-suite-20261027-v6\\out\\S01-128"]`

## S02
cwd: `C:\Users\ANON_USER\Desktop\FPGA\发给队员_盘古100Pro项目交接包_2026-10-18_v01\work\B-RETURN\B-VERIFY-OFFLINE-M0-return-v02`
native_rc: `0` elapsed_s: `0.172` timed_out: `False`
argv: `["C:\\Users\\ANON_USER\\AppData\\Local\\Programs\\Python\\Python312-embed\\python.exe", "-B", "C:\\Users\\ANON_USER\\Desktop\\FPGA\\发给队员_盘古100Pro项目交接包_2026-10-18_v01\\work\\B-RETURN\\B-VERIFY-OFFLINE-M0-return-v02\\RUN.py", "--case-file", "C:\\Users\\ANON_USER\\Desktop\\FPGA\\发给队员_盘古100Pro项目交接包_2026-10-18_v01\\work\\B-RETURN\\B-VERIFY-OFFLINE-M0-return-v02\\tests\\cases\\S02.json", "--input-root", "C:\\Users\\ANON_USER\\AppData\\Local\\Temp\\opencode\\bverify-r1-suite-20261027-v6\\input", "--out", "C:\\Users\\ANON_USER\\AppData\\Local\\Temp\\opencode\\bverify-r1-suite-20261027-v6\\out\\S02"]`

## C0-default
cwd: `C:\Users\ANON_USER\Desktop\FPGA\发给队员_盘古100Pro项目交接包_2026-10-18_v01\work\B-RETURN\B-VERIFY-OFFLINE-M0-return-v02`
native_rc: `0` elapsed_s: `0.141` timed_out: `False`
argv: `["C:\\Users\\ANON_USER\\AppData\\Local\\Programs\\Python\\Python312-embed\\python.exe", "-B", "C:\\Users\\ANON_USER\\Desktop\\FPGA\\发给队员_盘古100Pro项目交接包_2026-10-18_v01\\work\\B-RETURN\\B-VERIFY-OFFLINE-M0-return-v02\\RUN.py", "--case-file", "C:\\Users\\ANON_USER\\Desktop\\FPGA\\发给队员_盘古100Pro项目交接包_2026-10-18_v01\\work\\B-RETURN\\B-VERIFY-OFFLINE-M0-return-v02\\tests\\cases\\C0-default.json", "--input-root", "C:\\Users\\ANON_USER\\Desktop\\FPGA\\mainline-b-verify-offline-m0-2026-10-26-v1", "--out", "C:\\Users\\ANON_USER\\AppData\\Local\\Temp\\opencode\\bverify-r1-suite-20261027-v6\\out\\C0-default"]`

## C1-worker-memory
cwd: `C:\Users\ANON_USER\Desktop\FPGA\发给队员_盘古100Pro项目交接包_2026-10-18_v01\work\B-RETURN\B-VERIFY-OFFLINE-M0-return-v02`
native_rc: `5` elapsed_s: `0.062` timed_out: `False`
argv: `["C:\\Users\\ANON_USER\\AppData\\Local\\Programs\\Python\\Python312-embed\\python.exe", "-B", "C:\\Users\\ANON_USER\\Desktop\\FPGA\\发给队员_盘古100Pro项目交接包_2026-10-18_v01\\work\\B-RETURN\\B-VERIFY-OFFLINE-M0-return-v02\\RUN.py", "--case-file", "C:\\Users\\ANON_USER\\Desktop\\FPGA\\发给队员_盘古100Pro项目交接包_2026-10-18_v01\\work\\B-RETURN\\B-VERIFY-OFFLINE-M0-return-v02\\tests\\cases\\C1-worker-memory.json", "--input-root", "C:\\Users\\ANON_USER\\Desktop\\FPGA\\mainline-b-verify-offline-m0-2026-10-26-v1", "--out", "C:\\Users\\ANON_USER\\AppData\\Local\\Temp\\opencode\\bverify-r1-suite-20261027-v6\\out\\C1-worker-memory"]`

## C2-result-size
cwd: `C:\Users\ANON_USER\Desktop\FPGA\发给队员_盘古100Pro项目交接包_2026-10-18_v01\work\B-RETURN\B-VERIFY-OFFLINE-M0-return-v02`
native_rc: `5` elapsed_s: `0.14` timed_out: `False`
argv: `["C:\\Users\\ANON_USER\\AppData\\Local\\Programs\\Python\\Python312-embed\\python.exe", "-B", "C:\\Users\\ANON_USER\\Desktop\\FPGA\\发给队员_盘古100Pro项目交接包_2026-10-18_v01\\work\\B-RETURN\\B-VERIFY-OFFLINE-M0-return-v02\\RUN.py", "--case-file", "C:\\Users\\ANON_USER\\Desktop\\FPGA\\发给队员_盘古100Pro项目交接包_2026-10-18_v01\\work\\B-RETURN\\B-VERIFY-OFFLINE-M0-return-v02\\tests\\cases\\C2-result-size.json", "--input-root", "C:\\Users\\ANON_USER\\Desktop\\FPGA\\mainline-b-verify-offline-m0-2026-10-26-v1", "--out", "C:\\Users\\ANON_USER\\AppData\\Local\\Temp\\opencode\\bverify-r1-suite-20261027-v6\\out\\C2-result-size"]`

## C3-optimized-protected
cwd: `C:\Users\ANON_USER\AppData\Local\Temp\opencode\bverify-r1-suite-20261027-v6\protected-tool`
native_rc: `3` elapsed_s: `0.062` timed_out: `False`
argv: `["C:\\Users\\ANON_USER\\AppData\\Local\\Programs\\Python\\Python312-embed\\python.exe", "-O", "-B", "C:\\Users\\ANON_USER\\AppData\\Local\\Temp\\opencode\\bverify-r1-suite-20261027-v6\\protected-tool\\RUN.py", "--case-file", "C:\\Users\\ANON_USER\\Desktop\\FPGA\\发给队员_盘古100Pro项目交接包_2026-10-18_v01\\work\\B-RETURN\\B-VERIFY-OFFLINE-M0-return-v02\\tests\\cases\\C3-optimized-protected.json", "--input-root", "C:\\Users\\ANON_USER\\Desktop\\FPGA\\mainline-b-verify-offline-m0-2026-10-26-v1", "--out", "C:\\Users\\ANON_USER\\AppData\\Local\\Temp\\opencode\\bverify-r1-suite-20261027-v6\\protected-tool\\forbidden-output-probe"]`

## R1-MEM-OVER
cwd: `C:\Users\ANON_USER\Desktop\FPGA\发给队员_盘古100Pro项目交接包_2026-10-18_v01\work\B-RETURN\B-VERIFY-OFFLINE-M0-return-v02`
native_rc: `5` elapsed_s: `0.172` timed_out: `False`
argv: `["C:\\Users\\ANON_USER\\AppData\\Local\\Programs\\Python\\Python312-embed\\python.exe", "-B", "C:\\Users\\ANON_USER\\Desktop\\FPGA\\发给队员_盘古100Pro项目交接包_2026-10-18_v01\\work\\B-RETURN\\B-VERIFY-OFFLINE-M0-return-v02\\RUN.py", "--case-file", "C:\\Users\\ANON_USER\\Desktop\\FPGA\\发给队员_盘古100Pro项目交接包_2026-10-18_v01\\work\\B-RETURN\\B-VERIFY-OFFLINE-M0-return-v02\\tests\\cases\\R1-MEM-OVER.json", "--input-root", "C:\\Users\\ANON_USER\\Desktop\\FPGA\\mainline-b-verify-offline-m0-2026-10-26-v1", "--out", "C:\\Users\\ANON_USER\\AppData\\Local\\Temp\\opencode\\bverify-r1-suite-20261027-v6\\out\\R1-MEM-OVER"]`

## R1-RESULT-ENOUGH
cwd: `C:\Users\ANON_USER\Desktop\FPGA\发给队员_盘古100Pro项目交接包_2026-10-18_v01\work\B-RETURN\B-VERIFY-OFFLINE-M0-return-v02`
native_rc: `0` elapsed_s: `0.14` timed_out: `False`
argv: `["C:\\Users\\ANON_USER\\AppData\\Local\\Programs\\Python\\Python312-embed\\python.exe", "-B", "C:\\Users\\ANON_USER\\Desktop\\FPGA\\发给队员_盘古100Pro项目交接包_2026-10-18_v01\\work\\B-RETURN\\B-VERIFY-OFFLINE-M0-return-v02\\RUN.py", "--case-file", "C:\\Users\\ANON_USER\\Desktop\\FPGA\\发给队员_盘古100Pro项目交接包_2026-10-18_v01\\work\\B-RETURN\\B-VERIFY-OFFLINE-M0-return-v02\\tests\\cases\\R1-RESULT-ENOUGH.json", "--input-root", "C:\\Users\\ANON_USER\\Desktop\\FPGA\\mainline-b-verify-offline-m0-2026-10-26-v1", "--out", "C:\\Users\\ANON_USER\\AppData\\Local\\Temp\\opencode\\bverify-r1-suite-20261027-v6\\out\\R1-RESULT-ENOUGH"]`

## R1-LOG-FLOOD
cwd: `C:\Users\ANON_USER\Desktop\FPGA\发给队员_盘古100Pro项目交接包_2026-10-18_v01\work\B-RETURN\B-VERIFY-OFFLINE-M0-return-v02`
native_rc: `5` elapsed_s: `0.094` timed_out: `False`
argv: `["C:\\Users\\ANON_USER\\AppData\\Local\\Programs\\Python\\Python312-embed\\python.exe", "-B", "C:\\Users\\ANON_USER\\Desktop\\FPGA\\发给队员_盘古100Pro项目交接包_2026-10-18_v01\\work\\B-RETURN\\B-VERIFY-OFFLINE-M0-return-v02\\RUN.py", "--case-file", "C:\\Users\\ANON_USER\\Desktop\\FPGA\\发给队员_盘古100Pro项目交接包_2026-10-18_v01\\work\\B-RETURN\\B-VERIFY-OFFLINE-M0-return-v02\\tests\\cases\\R1-LOG-FLOOD.json", "--input-root", "C:\\Users\\ANON_USER\\Desktop\\FPGA\\mainline-b-verify-offline-m0-2026-10-26-v1", "--out", "C:\\Users\\ANON_USER\\AppData\\Local\\Temp\\opencode\\bverify-r1-suite-20261027-v6\\out\\R1-LOG-FLOOD", "--fixture-worker", "log_flood"]`

## R1-TIMEOUT-TOTAL
cwd: `C:\Users\ANON_USER\Desktop\FPGA\发给队员_盘古100Pro项目交接包_2026-10-18_v01\work\B-RETURN\B-VERIFY-OFFLINE-M0-return-v02`
native_rc: `6` elapsed_s: `2.094` timed_out: `False`
argv: `["C:\\Users\\ANON_USER\\AppData\\Local\\Programs\\Python\\Python312-embed\\python.exe", "-B", "C:\\Users\\ANON_USER\\Desktop\\FPGA\\发给队员_盘古100Pro项目交接包_2026-10-18_v01\\work\\B-RETURN\\B-VERIFY-OFFLINE-M0-return-v02\\RUN.py", "--case-file", "C:\\Users\\ANON_USER\\Desktop\\FPGA\\发给队员_盘古100Pro项目交接包_2026-10-18_v01\\work\\B-RETURN\\B-VERIFY-OFFLINE-M0-return-v02\\tests\\cases\\R1-TIMEOUT-TOTAL.json", "--input-root", "C:\\Users\\ANON_USER\\Desktop\\FPGA\\mainline-b-verify-offline-m0-2026-10-26-v1", "--out", "C:\\Users\\ANON_USER\\AppData\\Local\\Temp\\opencode\\bverify-r1-suite-20261027-v6\\out\\R1-TIMEOUT-TOTAL", "--fixture-worker", "sleep_forever"]`

## R1-WORKER-RC
cwd: `C:\Users\ANON_USER\Desktop\FPGA\发给队员_盘古100Pro项目交接包_2026-10-18_v01\work\B-RETURN\B-VERIFY-OFFLINE-M0-return-v02`
native_rc: `7` elapsed_s: `0.093` timed_out: `False`
argv: `["C:\\Users\\ANON_USER\\AppData\\Local\\Programs\\Python\\Python312-embed\\python.exe", "-B", "C:\\Users\\ANON_USER\\Desktop\\FPGA\\发给队员_盘古100Pro项目交接包_2026-10-18_v01\\work\\B-RETURN\\B-VERIFY-OFFLINE-M0-return-v02\\RUN.py", "--case-file", "C:\\Users\\ANON_USER\\Desktop\\FPGA\\发给队员_盘古100Pro项目交接包_2026-10-18_v01\\work\\B-RETURN\\B-VERIFY-OFFLINE-M0-return-v02\\tests\\cases\\R1-WORKER-RC.json", "--input-root", "C:\\Users\\ANON_USER\\Desktop\\FPGA\\mainline-b-verify-offline-m0-2026-10-26-v1", "--out", "C:\\Users\\ANON_USER\\AppData\\Local\\Temp\\opencode\\bverify-r1-suite-20261027-v6\\out\\R1-WORKER-RC", "--fixture-worker", "nonzero_rc"]`

## R1-MISSING-RESULT
cwd: `C:\Users\ANON_USER\Desktop\FPGA\发给队员_盘古100Pro项目交接包_2026-10-18_v01\work\B-RETURN\B-VERIFY-OFFLINE-M0-return-v02`
native_rc: `7` elapsed_s: `0.094` timed_out: `False`
argv: `["C:\\Users\\ANON_USER\\AppData\\Local\\Programs\\Python\\Python312-embed\\python.exe", "-B", "C:\\Users\\ANON_USER\\Desktop\\FPGA\\发给队员_盘古100Pro项目交接包_2026-10-18_v01\\work\\B-RETURN\\B-VERIFY-OFFLINE-M0-return-v02\\RUN.py", "--case-file", "C:\\Users\\ANON_USER\\Desktop\\FPGA\\发给队员_盘古100Pro项目交接包_2026-10-18_v01\\work\\B-RETURN\\B-VERIFY-OFFLINE-M0-return-v02\\tests\\cases\\R1-MISSING-RESULT.json", "--input-root", "C:\\Users\\ANON_USER\\Desktop\\FPGA\\mainline-b-verify-offline-m0-2026-10-26-v1", "--out", "C:\\Users\\ANON_USER\\AppData\\Local\\Temp\\opencode\\bverify-r1-suite-20261027-v6\\out\\R1-MISSING-RESULT", "--fixture-worker", "missing_result"]`

## R1-PASS-TEXT
cwd: `C:\Users\ANON_USER\Desktop\FPGA\发给队员_盘古100Pro项目交接包_2026-10-18_v01\work\B-RETURN\B-VERIFY-OFFLINE-M0-return-v02`
native_rc: `7` elapsed_s: `0.11` timed_out: `False`
argv: `["C:\\Users\\ANON_USER\\AppData\\Local\\Programs\\Python\\Python312-embed\\python.exe", "-B", "C:\\Users\\ANON_USER\\Desktop\\FPGA\\发给队员_盘古100Pro项目交接包_2026-10-18_v01\\work\\B-RETURN\\B-VERIFY-OFFLINE-M0-return-v02\\RUN.py", "--case-file", "C:\\Users\\ANON_USER\\Desktop\\FPGA\\发给队员_盘古100Pro项目交接包_2026-10-18_v01\\work\\B-RETURN\\B-VERIFY-OFFLINE-M0-return-v02\\tests\\cases\\R1-PASS-TEXT.json", "--input-root", "C:\\Users\\ANON_USER\\Desktop\\FPGA\\mainline-b-verify-offline-m0-2026-10-26-v1", "--out", "C:\\Users\\ANON_USER\\AppData\\Local\\Temp\\opencode\\bverify-r1-suite-20261027-v6\\out\\R1-PASS-TEXT", "--fixture-worker", "pass_text"]`

## R1-INVALID-JSON
cwd: `C:\Users\ANON_USER\Desktop\FPGA\发给队员_盘古100Pro项目交接包_2026-10-18_v01\work\B-RETURN\B-VERIFY-OFFLINE-M0-return-v02`
native_rc: `3` elapsed_s: `0.079` timed_out: `False`
argv: `["C:\\Users\\ANON_USER\\AppData\\Local\\Programs\\Python\\Python312-embed\\python.exe", "-B", "C:\\Users\\ANON_USER\\Desktop\\FPGA\\发给队员_盘古100Pro项目交接包_2026-10-18_v01\\work\\B-RETURN\\B-VERIFY-OFFLINE-M0-return-v02\\RUN.py", "--case-file", "C:\\Users\\ANON_USER\\Desktop\\FPGA\\发给队员_盘古100Pro项目交接包_2026-10-18_v01\\work\\B-RETURN\\B-VERIFY-OFFLINE-M0-return-v02\\tests\\cases\\R1-INVALID-JSON.json", "--input-root", "C:\\Users\\ANON_USER\\Desktop\\FPGA\\mainline-b-verify-offline-m0-2026-10-26-v1", "--out", "C:\\Users\\ANON_USER\\AppData\\Local\\Temp\\opencode\\bverify-r1-suite-20261027-v6\\out\\R1-INVALID-JSON"]`

## R1-INVALID-ROOT
cwd: `C:\Users\ANON_USER\Desktop\FPGA\发给队员_盘古100Pro项目交接包_2026-10-18_v01\work\B-RETURN\B-VERIFY-OFFLINE-M0-return-v02`
native_rc: `3` elapsed_s: `0.062` timed_out: `False`
argv: `["C:\\Users\\ANON_USER\\AppData\\Local\\Programs\\Python\\Python312-embed\\python.exe", "-B", "C:\\Users\\ANON_USER\\Desktop\\FPGA\\发给队员_盘古100Pro项目交接包_2026-10-18_v01\\work\\B-RETURN\\B-VERIFY-OFFLINE-M0-return-v02\\RUN.py", "--case-file", "C:\\Users\\ANON_USER\\Desktop\\FPGA\\发给队员_盘古100Pro项目交接包_2026-10-18_v01\\work\\B-RETURN\\B-VERIFY-OFFLINE-M0-return-v02\\tests\\cases\\C0-default.json", "--input-root", "C:\\Users\\ANON_USER\\AppData\\Local\\Temp\\opencode\\bverify-r1-suite-20261027-v6\\missing-input-root", "--out", "C:\\Users\\ANON_USER\\AppData\\Local\\Temp\\opencode\\bverify-r1-suite-20261027-v6\\out\\R1-INVALID-ROOT"]`

## R1-OVERSIZE-CASE
cwd: `C:\Users\ANON_USER\Desktop\FPGA\发给队员_盘古100Pro项目交接包_2026-10-18_v01\work\B-RETURN\B-VERIFY-OFFLINE-M0-return-v02`
native_rc: `3` elapsed_s: `0.063` timed_out: `False`
argv: `["C:\\Users\\ANON_USER\\AppData\\Local\\Programs\\Python\\Python312-embed\\python.exe", "-B", "C:\\Users\\ANON_USER\\Desktop\\FPGA\\发给队员_盘古100Pro项目交接包_2026-10-18_v01\\work\\B-RETURN\\B-VERIFY-OFFLINE-M0-return-v02\\RUN.py", "--case-file", "C:\\Users\\ANON_USER\\Desktop\\FPGA\\发给队员_盘古100Pro项目交接包_2026-10-18_v01\\work\\B-RETURN\\B-VERIFY-OFFLINE-M0-return-v02\\tests\\cases\\R1-OVERSIZE-CASE.json", "--input-root", "C:\\Users\\ANON_USER\\Desktop\\FPGA\\mainline-b-verify-offline-m0-2026-10-26-v1", "--out", "C:\\Users\\ANON_USER\\AppData\\Local\\Temp\\opencode\\bverify-r1-suite-20261027-v6\\out\\R1-OVERSIZE-CASE"]`

## R1-OVERSIZE-INDEX
cwd: `C:\Users\ANON_USER\Desktop\FPGA\发给队员_盘古100Pro项目交接包_2026-10-18_v01\work\B-RETURN\B-VERIFY-OFFLINE-M0-return-v02`
native_rc: `3` elapsed_s: `0.171` timed_out: `False`
argv: `["C:\\Users\\ANON_USER\\AppData\\Local\\Programs\\Python\\Python312-embed\\python.exe", "-B", "C:\\Users\\ANON_USER\\Desktop\\FPGA\\发给队员_盘古100Pro项目交接包_2026-10-18_v01\\work\\B-RETURN\\B-VERIFY-OFFLINE-M0-return-v02\\RUN.py", "--case-file", "C:\\Users\\ANON_USER\\Desktop\\FPGA\\发给队员_盘古100Pro项目交接包_2026-10-18_v01\\work\\B-RETURN\\B-VERIFY-OFFLINE-M0-return-v02\\tests\\cases\\R1-OVERSIZE-INDEX.json", "--input-root", "C:\\Users\\ANON_USER\\AppData\\Local\\Temp\\opencode\\bverify-r1-suite-20261027-v6\\input", "--out", "C:\\Users\\ANON_USER\\AppData\\Local\\Temp\\opencode\\bverify-r1-suite-20261027-v6\\out\\R1-OVERSIZE-INDEX"]`

## R1-EXISTING-OUT
cwd: `C:\Users\ANON_USER\Desktop\FPGA\发给队员_盘古100Pro项目交接包_2026-10-18_v01\work\B-RETURN\B-VERIFY-OFFLINE-M0-return-v02`
native_rc: `7` elapsed_s: `0.063` timed_out: `False`
argv: `["C:\\Users\\ANON_USER\\AppData\\Local\\Programs\\Python\\Python312-embed\\python.exe", "-B", "C:\\Users\\ANON_USER\\Desktop\\FPGA\\发给队员_盘古100Pro项目交接包_2026-10-18_v01\\work\\B-RETURN\\B-VERIFY-OFFLINE-M0-return-v02\\RUN.py", "--case-file", "C:\\Users\\ANON_USER\\Desktop\\FPGA\\发给队员_盘古100Pro项目交接包_2026-10-18_v01\\work\\B-RETURN\\B-VERIFY-OFFLINE-M0-return-v02\\tests\\cases\\R1-EXISTING-OUT.json", "--input-root", "C:\\Users\\ANON_USER\\Desktop\\FPGA\\mainline-b-verify-offline-m0-2026-10-26-v1", "--out", "C:\\Users\\ANON_USER\\AppData\\Local\\Temp\\opencode\\bverify-r1-suite-20261027-v6\\out\\R1-EXISTING-OUT"]`

## R1-MEM-MEASURE
cwd: `C:\Users\ANON_USER\Desktop\FPGA\发给队员_盘古100Pro项目交接包_2026-10-18_v01\work\B-RETURN\B-VERIFY-OFFLINE-M0-return-v02`
native_rc: `7` elapsed_s: `0.062` timed_out: `False`
argv: `["internal:execute_case", "no_peak_worker.py"]`
