minzhetang/pangu-riscv-soc/deliveries/competition-source-package-2026-11-03-v1/package/evidence/reports/2026-11-01-basic-reliability-and-performance.md

# 基础运行版本可靠性收尾与单候选性能对照

日期：2026-11-01；决定D292/D293，事实F253/F254。当前接受的是非调试O2可靠性版本；本轮未宣称完整作品/全RV32I认证或全物理时序签核。原图和2026指南选题一实际10–11页重新核对，基础要求是RV32I、至少三级流水线及冒险/分支、基础外设交互；本系统已有五级实现。高阶任务归属/权重不自行豁免。

## 实际保留的改进

只在独立副本的`board_reset_sync.sv`与`gpio_core.v`为复位释放寄存器/第一同步级加官方`/* synthesis syn_preserve=1 */`，使意图明确反映在实现中。功能RTL、CPU、时钟频率、引脚、O2基准C、启动和链接、ROM/RAM初始化均不变。准确差异见[RELIABILITY.diff](../../work/quality/2026-11-01-basic-closure-m1/RELIABILITY.diff)。

新增三项窄域约束：4个人工GPIO输入仅到首同步bank、原始KEY0仅到复位释放bank设置异步入口例外；9个输出设置37.037037ns内部datapath预算。后级FF路径、主域setup/hold以及同步释放到消费者的recovery/removal继续检查。人工按键没有同步外部时钟，不能虚填输入延时；输出内部预算也不等真实外部接收器setup/hold或板级SI保证。Timing4086/4087继续如实保留。

官方依据为安装版`D:/PDS/PDS_2022.2-SP6.4/doc/ADS_Synthesis_User_Guide.pdf`实际53、92页（syn_preserve印刷91），及`User_Constraint_Editor_User_Guide.pdf`实际97–98页和get_cells/get_pins/set_false_path章节。官方明确DEDICATED_ROUTE=FALSE允许SRB并降级告警，不是修复，本轮不以新增该降级属性充当修复。相关提取和检索入口在工作目录OFFICIAL_DOC_HITS/ADS_PRESERVATION；本轮另渲染并视觉核对official-pages/ads-092、uce-097/098三页，Symbol/ArialUnicode字体替代警告保留，关键文字/表格完整可读。资料版权/厂商模型不外发。

## 验收结果与边界

| 检查 | 新结果 | 可支持的结论/限制 |
|---|---|---|
| 数字复位/GPIO测试 | 5种释放相位、98个检查通过；新普通VCD | 验证3沿释放/2级GPIO数据延迟及输出写入/复位；不模拟亚稳态，不证明MTBF |
| 真实映射 | 3个reset FF；各8位GPIO首/次级FF；首至次级STA路径存在 | 证明显式顺序保留；旧gopSRL2/组合FF打包未被证明错误，不宣称修了旧硬件缺陷 |
| 约束 | 97项、0错误/0Critical；0锁存器 | 94原约束保持并新增3项；输入例外不是全局false_path |
| 内部27MHz STA | 慢/快setup、hold、recovery、removal八组均0失败 | 最小setup23.453ns/hold0.125ns；外部同步IO/模拟CDC仍有限制 |
| 真实DRM INIT | 1792片与原O2逐项相同 | 不仅检查源码文件名或位流存在 |
| 新物理运行 | H61/H64各一次完整原厂SVF后自动输出1123字节 | 两份全文SHA、五CRC、538539600ticks完全相同，工具正常退出 |
| 同条件周期 | 19.945911111标称秒、12.834710762iter/s | 计算窗与串口打印分开；按标称27MHz换算，不是独立时钟校准或EEMBC认证 |

资源从旧非调试1805 LUT/1519 FF到1807 LUT/1527 FF，增加2 LUT和8 FF，等效DRM36仍14块，IO15。仿真首次受限环境编译0xC0000005、首次空构建及pin选择错误均保留；合法官方单元端点规则修正后成功，不因原生exit0将失败算通过。数字测试编译/运行日志与完整argv在`io-contract-test-r1`；其两份输入与最终release-r2字节相同。未重跑无改动CPU的全历史矩阵，也未将本测试称为CPU新回归。

## 性能试验：测到了小收益，但不采用

唯一候选只改编译选项`-O2`为`-O3 -funroll-loops`。基准C/算法、启动、链接策略、ISA、种子、256迭代、计时窗口和27MHz保持，报告如实打印新参数。五CRC、32KiB上限、≥10标称秒以及≥10%降周期采用门在运行前冻结。新镜像所有可执行字静态符合纯RV32I，静态检查不是功能验收。

| 指标 | 保留O2可靠性版 | O3展开候选 |
|---|---:|---:|
| 程序字节 | 16352 | 30640 |
| 计算周期 | 538539600 | 528264036 |
| 标称计算秒数 | 19.945911111 | 19.565334667 |
| iter/s，非固件整数显示 | 12.834710762 | 13.084366016 |
| LUT / FF | 1807 / 1527 | 1805 / 1527 |
| 等效DRM36 | 14 | 16 |
| 实机五CRC/全文语法 | 两份同全文通过 | 单性能种子一份通过 |
| 采用判断 | 保留 | **不采用** |

降周期1.9080424%，对应吞吐增1.9451568%；代码增87.3777%、多两块DRM、32KiB ROM只余2128字节，不合冻结10%收益门。不继续盲试参数，不追加这个拒绝候选的验证种子/重复测量，不将它包装成CPU架构创新或正式改进成绩。完成一次精确O2恢复H64并核全文，当前驻留为可靠性O2版本。

## 被守卫抓住的数据绑定错误

候选准备首轮只改`init_tables.svh`，而实际参与PDS综合的`memory_model.sv`含独立内嵌ROM_BITS，因此其28块DRM18/1792片INIT仍全部等旧O2。旧位流46F126…已明确拒绝，**从未下载**。这是本轮准备错误，不能据此解释历史原生Program的身份异常。

新`performance-implementation-r1`只替换两处ROM常量，分别回读到同一新bin+补零；RAM/内存协议不变，之后2048片物理INIT逐项匹配才导出/核payload并下载17F652…新位流。新增`guard_rom_binding.py`可在未来构建前同时核对两处。错误源/位流/日志和原始守卫失败原样保留，没有降低期望来通过。

## 基础任务与作品剩余项

| 项目 | 当前真实状态 |
|---|---|
| CPU五级/冒险/分支/RV32I能力 | 既有实现及有限验证；本轮功能CPU不改，不补保留编码/特权机制 |
| 裸机C与同步存储 | 既有真实启动和DRM固定时序；本轮原1792INIT不变及实机运行复验 |
| UART/Timer | 新完整物理串口及64位计算时间两次匹配；固定串行TX，不冒称RX已接入 |
| GPIO | MMIO/核心既有有限验收，本轮数字同步/输出测试与实现保留通过；本轮未做物理输入/LED专项现场验收 |
| ≥10s CoreMark | F249旧基线双种子各重复通过；本轮新可靠性镜像仅性能种子两次19.9459s，不冒称新验证种子也测过 |
| 片上效率分析 | F251/F252旧固定调试版4个不同真实窗口及报告，仍是独立镜像证据；本轮未再采ILA |
| Debug Critical | 旧调试版4条TCK/扫描链SRB时钟Critical未关闭；当前无调试0Critical不能替它签核 |
| 最终比赛交付 | 代码/技术报告/视频照片与声明仍需整合核对，不以本轮阶段通过等作品提交完成 |

仍未证明独立校频、实体温度/完整SCBV供电接线、全物理CDC/IO签核、全程退休IPC及统一WB/STORE顺序；RF上电初态/固定存储模型和测试范围限制保持。CFG bit27=1保留，保护不改；本轮不操作Flash、供电或跳线，未知温度不写成正常。本次PDS许可提示剩余2天，后续构建注意合法续期。

## 身份与复现入口

- 保留位流SHA-256：`531FB1C72DF600039B81DEA5F286BC53068FA880B9955D25124FF830639DA87A`。
- 保留完整SVF：`2879B89190D914288C9EBE63C30CF72336CA460B7F1504BCE1DA60E87F7712D3`；不是旧原生Program替代命令的假名，确实执行完整CRAM配置。
- 保留两份全文：`73425EECBAB76C9DDE20D58A7F1E85014F346B3242C995C9B6F64B1DCDC0679E`。
- 拒绝O3有效位流：`17F652C92ABD94EC05D435E38070192A8866C52138454F468757D448814AE2CE`；真实输出`F9ECF8026F54602F0188596BADFE050885C9B3A2779547ADCD8FF10EAB0F9F52`。
- [阶段结果、源码/约束差异、原始测试和审计](../../work/quality/2026-11-01-basic-closure-m1/RESULTS.json)，[命令索引](../../work/quality/2026-11-01-basic-closure-m1/COMMANDS.md)，[冻结恢复基线](../../work/hardware-baselines/2026-11-01-coremark256-reliability-v1/BASELINE.json)。

PDS2022.2-SP6.4 build146967、Icarus/vvp13.0、GCC15.2.0均用既有绝对路径。3次真实易失性配置含最终恢复，均正常退出；2次离线SVF导出不当硬件配置。实现端3次完整PnR含一次ROM绑定被拒候选，另有未达PnR的失败/预检，完整命令/退出/守卫见原始记录。软件GCC首次只强清conhost子进程，编译器已原生0/ELF生成；未重编译，后续四工具原生0，原失败/清理差异保留，不能写所有软件任务无任何强清。

下一重点是将可信固定运行版、双种子历史长测与片上效率证据整合为比赛交付，再按真实瓶颈讨论收益足够的改进；不为这点小收益冒险重构双相存储推进，也不自动扩Cache/预测器。D245待审文档继续本地，无本轮Git提交/推送。
