minzhetang/pangu-riscv-soc/deliveries/competition-source-package-2026-11-03-v1/package/verification/offline-tool-mainline-review/TEAMMATE_REPLY.md

B及B的AI：

已收到B-VERIFY-OFFLINE-M0-return-v02，540文件/539条SHA核同，清单SHA为5F06E6D6…3371C8ED，计划82C42434…F442AA4F；原37例输入/预期、历史快照及冻结API/codec未变，CHANGED_FILES/SOURCE_INDEX与59段DIFF全部可核。54/54 PASS_LOCAL作为B本地证据接收，不能替代A验收。

A在不改你方源码的新副本完成25项独立主机检查：22 PASS、3 FAIL。7个种子、4份旧流（共9,378,498条）逐笔重放、C0/C1/C2、-O/-OO保护、足量结果容量、非零rc/缺结果/只打印PASS等已得到有限支持。C0保持MATCH、1B阈值预拒绝、不写超256B结果、优化模式不污染工具树均已关闭，无需重复提交这些已收到材料，也不用重做UART/GPIO/RX或新核心。

总体有条件接收，R1生产资源守卫尚未关闭。现在请仅在D158原有范围完成以下三组最小差额：

G1 内存：RUN的轮询只记录peak，结束后才检查阈值。A真实32MiB夹具在16MiB阈值下实测峰52,289,536B，超限持续约0.828s，未调用kill，worker正常rc0结束后才LIMIT。请在运行中检查/立即终止并wait本次worker；可用现有20ms轮询，不新增通用runner/清树。父进程同时按既有硬上限256MiB测量/限制并保留父peak，测量失败明确TOOL_ERROR；不要在合并worker结果时丢掉父字段。启动前1B预拒绝保留。验收需真正观察kill/已退出、活跃越界被中止和None失败路径，不能只验最终rc5。

G2 日志：当前stdout/stderr直接指向文件，随后truncate。A在4,096B限额下独立观测实际文件曾达5,242,880B，最终裁到4KiB不等于有界写入。请使用有界PIPE消费/剩余额度写入或等价局部方案，最多写到阈值；读到超额立即终止并wait，保留LIMIT/真实rc和触发信息。验收同时核运行中最大文件长度与最终长度（两者均<=阈值），不能只看最终文件。只改本模块局部监督，不加任意命令入口。

G3 期限与测试判据：当前到case+cleanup才kill，wait又各给新cleanup，worker的remaining也在启动后重设。A的1s+1s固定sleep夹具直到2.016s才kill，总2.031s；总时长在2.1s以内不构成主期限合格。请主阶段在started+case_timeout停止，所有wait/清理共用同一个绝对总deadline，cleanup不成为继续计算时间。内部worker可直接传同一绝对单调deadline，外部ABI/CASE不变。短测试核kill<=1.1s、总<=2.1s（100ms只为观测容差），默认总<=188s且不得续期。新R1测试max_elapsed=2.6不符合原任务约定，请在新计划中纠正此新增判据；原37输入/预期不得改变。记录父CLI实际rc、worker原生rc、终止时刻、cleanup和总耗时；必要的受控故障注入仍只用固定小fixture，不改比较结果。

请先核本回复版本与输入清单，回实际可用工时/ETA；随后集中完成G1–G3，返回唯一独立候选v03和准确diff/清单/冻结新增计划/逐项原日志与真实码/内存与日志峰值/期限终止证据。保留v01/v02、原37、冻结API/codec与旧失败，不降低期望。复用已生成且SHA核同的压力输入即可，不必反复生成大数据；相关守卫变更后按原任务回归原37及新增定向，不重跑外设或CPU。A只需小型差额及明确依赖，不要重发65MB输入或已有整套外设成果；不要求ZIP。若发现必须改冻结API或工作量超原有界整改，请停止相关部分，一次列原因与最小方案。

B现在仅做这三组守卫，不等A批准新的核心/接口；A负责复验和公共记忆，不接管你方重写。其余比较功能/外设无新增开发任务。A主线F160八迭代结果保持独立，不等待此工具才能继续，B工具目前不接入生产采集/验收链。

10月27日18:00为原外设返回窗口，不因本次R1审查自动顺延；本回复未替B新增承诺截止。若剩余资源工具整改与可用工时冲突，交真实完成部分及三项状态，由A/负责人决定取舍，不自行延期或降标。硬件STOP、CPU/ISA/PDS/JTAG/Flash/安装等权限不变。
