minzhetang/pangu-riscv-soc/deliveries/competition-source-package-2026-11-03-v1/package/verification/peripherals-frozen-v02/MAINLINE_ACCEPTANCE/TEAMMATE_REPLY.md

# 给B队员及其AI：v02已接收，R1–R3限定差额关闭

A已收到handoff-mainline-v02-20261025及内层stage-return-final-20261027-v02，完成80文件逐项阅读/解析、外层79与内层69 SHA、28源索引、67变更和10依赖核对；27个diff块含5个元数据块均精确重建。A另从源码独立编译7目标、实际运行7次并解析新波形，原件/旧包未改。

**结论：v02作为B当前活动的有限软件交付可接收，R1/R2和R3身份/重建缺口关闭。**这不是完整作品/新A系统/RX系统集成或硬件验收。

- R1：N8/N16/N234为92/110/68事件，独立公开模型、共享捕获和内联逐笔type/data/edge完全一致；共2700个pre/post字段无差异。seq0/seq30及5e真实沿快照已核，核心不变。
- R2：全部START匹配实际接受沿，12个完整结束分别匹配真实E+10N，首帧N16 37→197、N234 6→2346；observed=event+1正确，两配置各6完整/3取消/0bad stop，末半stop复位控制保持。
- R3：清单/SOURCE_INDEX/CHANGED及五元数据diff闭合。仅一处非阻塞文案：RX results.json的COM-01.expected仍写旧1.3.4路径，实际SHA、门禁、run_manifest与新输入均1.3.5。A已在独立导入注记标明，不要求你改写原运行结果，不要求为此重跑DUT或制作v03。
- W06继续A-W06-SUPPLEMENT，GPIO1.0.2继续有限接收；无需重复核心开发、GPIO矩阵/W06、旧机制和已经收到的历史整包。F123旧失败和旧根OPEN_PREEXISTING继续保留。

对QUESTIONS_TO_MAINLINE.md五问一次答复：
1. 确认v02为当前活动B交付，v01及2335/1735等只读历史。其上游PASS_LOCAL原标记不改写；A接收/复现结论在独立收据。
2. A已完成R1/R2受影响7次新编译/7次运行；导入映射已固定。TX/GPIO/包装与F143/F151同SHA，主线无需覆盖；RX模块通过不等于接进CPU/SoC，后续系统归A。
3. 目录足够，ZIP可选，不需要生成ZIP或补发整包。
4. 旧根manifest/source-link仍OPEN_PREEXISTING，由A/负责人处理，不要求B修改根/旧包，也不能写成PASS。
5. 当前没有必须补交的开发差额。将来若A发现具体问题，会一次给出文件/字段、最小复现、预期和有界范围，B只处理该差额；不扩RX包装/CPU/SoC/硬件。

**现在立即做**：冻结并保存v02及继承源/冻结计划/日志/普通VCD/清单，现有目录就是交付，不再额外重封包或扩功能；可仅确认已知悉本结论。**等待/依赖**：仅按A确切复验问题协助定位；无正在等待的接口/开工审批，无新增核心开发任务。A负责正式长测验证与资源方案、CPU/同步存储/SoC/Timer/CoreMark/PDS/最终报告；这些不转嫁给B，也不是本回复自动批准RX REGIF。

10月27日18:00北京时间窗口保持；现有有限软件阶段可以按本结论收束，不自动顺延、取消原范围或降低标准。无需为A下一系统/硬件阶段承诺额外工期；若后续确有新范围或窗口冲突，A给最小影响，由负责人确认。

硬件仍STOPPED；本回复不批准PDS/服务器/设备/JTAG/上电/下载/Flash/SCBV/供电/跳线/温控。本文由A准备、未自动外发。
