minzhetang/pangu-riscv-soc/deliveries/competition-source-package-2026-11-03-v1/package/verification/offline-tool-v02/r1/task/START_HERE.md

# B-VERIFY-OFFLINE-M0-R1 / 任务入口

2026-10-27，D158；对原工具任务的有界整改阶段。用户要求按当前进度给B指派新任务；本包已批准收到核验后在限定范围开工，尚未代发/未知B新回执与承诺。

先读 TEAMMATE_PROMPT.md → TASK.md → COUNTEREXAMPLES.json / REPRODUCE.md。当前v01清单373/373核同，冻结API同字节；B自测结果文件确有37条PASS_LOCAL，但A只完成4个定向CLI控制，发现3个反例，**不是整包已经验收或所有比较功能失败**。

请保留v01、旧37输入/预期和原日志，在独立v02候选中整改自己的RUN/src及测试入口，冻结比较内核和ABI1.0.0不动。本补充任务版本1.0.1，只收敛资源/路径/失败守卫，不加新验证功能、外设、CPU、采集管道或硬件。

开始时一次回执：实际收到时间、本包SHA256SUMS整体SHA、可用净工时、目标返回时间及原10/27 18:00北京时间外设窗口是否冲突。建议目标2–4净工时是A估计，不是B承诺，不为凑一天扩任务。旧窗口不自动变更；遇显著超时/新内核缺陷集中反馈。

最终返回 B-VERIFY-OFFLINE-M0-return-v02/，目录即可，无需重发65MB输入或重封外设v02。完整交付和验收见TASK.md。
