minzhetang/pangu-riscv-soc/deliveries/competition-source-package-2026-11-03-v1/package/verification/offline-tool-v02/r1/task/TASK.md

# 资源与失败守卫整改 / 补充1.0.1

任务编号B-VERIFY-OFFLINE-M0-R1，优先级P0，日期2026-10-27，D158。收到并核验可开工。原冻结ABI1.0.0、输入、37例预期及已完成外设任务保持；本轮不扩大功能范围。

## 事实与问题

A已核原件374文件/373条SHA全部匹配，两个frozen文件同A原包。4次普通Python小输入CLI复验：

|ID|固定预期|v01实际|
|---|---|---|
|C0|默认比较8条MATCH/rc0|符合|
|C1|worker限额1B时不能MATCH，应LIMIT/rc5；可启动前明确拒绝，无需大分配|rc0/MATCH，仍运行远超1B的Python worker|
|C2|max_result_bytes=256，不能写超限结果；容量不足应明确LIMIT/rc5|rc7/TOOL_ERROR，worker-result1372B/result2135B；已拒绝但仍超限落盘。不要误写成此例也返回MATCH|
|C3|-O应INVALID_INPUT/rc3，且不得在工具输入树创建输出|rc3正确，但在复制工具树内新建输出和945B结果|

精确实测和旧源码SHA在COUNTEREXAMPLES/BASELINE。上述只证明特定缺口；A尚未完整复现原37例或所有边界。不可把收件/清单/自测PASS当A验收。

## 仅修改自己的包装与测试

### R1-1：资源守卫真正生效

- worker工作集要与配置阈值实际比较，超限立即终止并wait本次自己的worker，返回LIMIT/rc5、fully_consumed=false，不能继续MATCH。阈值低于运行器基本开销时，可预先明确拒绝为LIMIT。测量失败不能把None当0或宣称预算通过，返回TOOL_ERROR/rc7。父进程也报告/限制资源，禁止把全轨迹搬到父进程。
- stdout/stderr流式限额写入，触界停止保存/终止worker并失败，不等超大日志全部落盘才标截断。不接受任意外部命令，不建通用清树器/孙进程体系，不需要管理员或安装。
- result与worker-result均按本case的max_result_bytes做有界序列化/原子发布；不能只用全局1MiB常量。极小限额无法容纳最小合法结果时，允许不生成结果文件，但必须rc5明确失败，不能写超限fallback，更不能MATCH。CLI诊断也须有界。

### R1-2：统一前置路径、输入与错误分支

- 所有分支包括-O/-OO、无效CASE、无效input-root都先执行输出保护：不得写输入包或返回工具树，不覆盖既有输出，失败只能有界报告。C3必须rc3且受保护树前后清单/哈希不变。仅在自己的独立测试副本做破坏尝试。
- CASE元数据先stat，硬上限1MiB再读；归档index沿用冻结codec的2MiB上限，先校验路径/链接及大小再读取/解析；原始输入先核本case字节上限再计算身份摘要。把identity预读取计入同一截止时间，不能先无限读再进入冻结reader。
- 不修改frozen API/codec，不新建ISA参考、不改原预期。若发现冻结内核缺陷，交最小反例/原因归A处理，B不绕过它放行。

### R1-3：一个总期限，真实原生退出码

- 从任务准备/元数据读取开始使用同一单调时钟截止时间；worker计算、身份、诊断不能各自重新获得一份预算。主工作到case_timeout即停止，预留cleanup<=8秒，总流程<=case_timeout+cleanup且<=188秒；不等188秒后再另加清理期。
- 短超时测试用1秒主预算+1秒清理，并记录总耗时；可预先注明100ms调度观测容差，仅用于短测试判断，不得在实现中续期或扩大188秒上限。实际未退出/无法测量/缺结果/截断/rc不一致绝不能成功。
- 测试驱动要同时检查父CLI实际进程rc、worker原生rc、结果status/native_rc；不能仅用结果JSON自述rc判断PASS。原F17/F18纯守卫单元测试仍标单元证据，新增实际runner路径测试分开。

## 冻结新增测试后集中执行

不改变原37例的输入和预期。可修驱动对真实rc的判定，再追加R1矩阵：
1. C0正控与C1/C2/C3同输入新旧对照，旧v01保留已证反例，新版消除；无需让旧版全部失败。
2. 正常预算/过低内存阈值/工作集测量失败；输出中保留阈值、观测、触发原因、worker已退出和真实总耗时。
3. 结果大小低/足够上限、日志达到上限/超限，以及无超限文件发布。摘要不替代逐笔核验。
4. -O/-OO、无效JSON及无效根分别试受保护输出；普通错误、已存在输出也不覆盖/创建污染。
5. CASE/index先验大小拒绝；证明不会在拒绝前整文件读取/完整哈希。故障文件限自己的小型可控目录，不读个人资料/凭据/许可，不扫描机器。
6. 同一绝对截止时间、受控挂起worker的父级终止/清理，验证不靠worker主动TIMEOUT才通过。
7. 在实际父级路径注入受控未知/非零rc、缺/截断结果、只打印PASS，不能成功。测试可使用固定白名单的短Python fixture驱动同一内部runner，生产CLI不新增任意worker/命令入口，不force比较结果。
8. 原37例全部回归、真实1/16/128MiB压力和四旧流重放，以及搬到中文空格独立目录。功能MATCH的逐笔比较不去重、不改条件。

新增预期先手工冻结，不按结果回填。schema/预期拒绝测试PASS与被测CLI失败码分开。未执行、超时、失败原样记，不为“全绿”降标准。无需重跑UART/GPIO/RX DUT，A在线采集/CPU不在此任务。

## 返回与验收

独立 B-VERIFY-OFFLINE-M0-return-v02/：START_HERE、R1_RESPONSE逐项对照、准确DIFF/CHANGED_FILES、原件/冻结API/旧37输入预期SHA不变证据、冻结新增计划与逐项结果、真实命令/原日志/原生rc、终止与资源/文件上限证据、压力/搬目录结果、OPEN_ITEMS和SHA。保留v01不覆盖；外设v02不改，原65MB输入只引用身份不重复发送。

仅PASS_LOCAL，A收件先审代码再复现，分别判材料、模块、本机、ABI、系统、硬件。R1到点交真实完成部分，2–4净工时只是目标估计；收到先确认容量与ETA，原10/27 18:00外设窗口不自动改。发现超过一个工作块或涉及冻结内核/接口/系统/CPU必须停相关项并集中说明，由A/负责人决定取舍。

本包不授权安装、GUI/管理员/许可证/系统环境、联网外发、DUT/TB/PDS、JTAG/上电/Flash/SCBV/供电/温控。over_temp STOP保持。A主线有限M1已完成，A并行做只读采集开销/长跑预算，不等待本工具整包，也不替B重写。
