minzhetang/pangu-riscv-soc/deliveries/competition-source-package-2026-11-03-v1/package/verification/offline-tool-v02/r1/task/TEAMMATE_PROMPT.md

B及你的AI：

现派发B-VERIFY-OFFLINE-M0-R1（补充1.0.1，2026-10-27，D158），收到核验后即可按TASK开工。你提交的v01已收到，374文件/373SHA核同，冻结API同字节；37条PASS_LOCAL材料保留，但A未完成全量独立复验。A在独立副本做4个小型CLI检查，正控通过，确认3个护栏缺口：内存限额1B仍MATCH；结果限额256B却写出更大的worker/result（此例已rc7拒绝，不是错误MATCH）；-O虽rc3拒绝，却在工具树创建输出。COUNTEREXAMPLES和固定CASE给出实测。

下一阶段只补齐资源限额、统一错误路径保护、输入预检查和一个总截止时间，回归原37例并追加TASK规定的真实runner负向证据。不要另开CPU/外设/新功能，也不修改frozen API、旧计划预期或原v01。普通实现自行收敛；内核缺陷集中最小反例交A，不绕过放行。原冻结ABI仍1.0.0。

请先回实际收到时间、本包SHA、可用工时、目标返回和是否影响原10/27 18:00北京时间外设窗口。A建议2–4净工时目标，并非已承诺工期；不能自行顺延原窗口。一次集中返回B-VERIFY-OFFLINE-M0-return-v02/，包含逐项修复、源码diff、冻结新增计划、原37不变/回归、真实rc/日志/资源/清理/压力/搬目录证据及SHA/未完成项；原65MB输入和外设v02无需再发/重封。

A主线已完成有限采集管道M1，后续在线采集/CPU语义/系统和长跑成本归A并行负责，不以你的整包完成作为只读分析前提。你只标PASS_LOCAL，等待A独立审收；本任务不是CPU/ISA或新DUT验证。既有硬件STOP及不安装/不运行PDS/仿真器/不操作板卡的边界不变。
