minzhetang/pangu-riscv-soc/deliveries/competition-source-package-2026-11-03-v1/package/advanced/btb-mmode/project/reports/verification/2026-11-03-taskB-software-closure.md

# 高阶B：独立软件候选的真实程序闭环与收尾

2026-11-03，D325/F285。本轮完成“先取得可信仿真成果”的有限软件目标，保护已验板级版；**没有完成或宣称完整高阶任务2，更没有整套HL4合入。**

## 从定向指令推进到真实程序

独立M3 CPU实际运行GCC15.2编译的裸机C程序：启动清BSS、32项排序、CRC、64次交替函数指针调用、完整返回与签名输出。不是宿主Python替代CPU，不是只看完成标记。C镜像1960字节；目标RV32I/ILP32，O2、freestanding、nostdlib、禁relax及small-data，完整命令见M4 COMMANDS。ELF SHA A5EF6E5D33A9CD4C54E25D9ABD46C4D65301964BF167E654F8EE4E8230568E3F，bin SHA 08C124405F6CBAB2A1BBEB3355C435CF25F31C9A0DCA55A7520EECCB23A6FF79。

两个输入（1、0xDEADBEEF）先由独立高层算法和逐指令RV32I模型互校，冻结后才跑DUT。每个输入有完整WB/STORE、32寄存器及32KiB内存预期；逐行/逐笔比较，不去重、不用哈希代替轨迹。参考动态指令数12628/12670，非x0 WB11228/11260，STORE391/394。第三路zlib CRC32核对排序后128字节数据，匹配219552364/481511221。主程序返回必须为0，done标记必须正确，任何额外/重复/错误写回和STORE均失败。

八次新DUT（两输入×预测开关×组合/同步存储）全部PASS。新补充“MRET恢复使能时已有pending IRQ”“取中断不得先提交被打断STORE，返回后STORE恰好一次”各四配置，共8PASS。CPU源码未再改，八模块同M3 SHA；因此继承M3 152次限定回归的源码身份，但不能把旧运行冒称本轮重跑。

## 同条件量化结果

计算区间为CPU接受start标记STORE到done标记STORE，包含排序/CRC/间接调用/返回正确性和结果写入，不含启动清BSS；没有串口输出。两边相同ELF/镜像/输入/初态/存储时序，唯一参数差异为BTB_ENABLE。

|输入|读时序|预测关周期|预测开周期|减少周期|周期减少|
|---|---|---:|---:|---:|---:|
|1|组合|14066|12938|1128|8.0193%|
|1|同步|28132|25876|2256|8.0193%|
|0xDEADBEEF|组合|14121|12983|1138|8.0589%|
|0xDEADBEEF|同步|28242|25966|2276|8.0589%|

这比仅在手写小循环上的2/4拍差值更接近真实程序证据，但**不是CoreMark、不是普适8%提升、不是FPGA吞吐收益**。没有本候选综合频率/资源/功耗数据，无法据此判定物理实现综合收益。BTB开关两边完整功能轨迹相同，周期差不是减少计算、少输出或漏记副作用所得。END尾部六拍仅用于排空检查，不计计算区间；预测统计有启动/尾部循环，不能称退休IPC。

## 已完成及未完成矩阵

|事项|当前证据|结论|
|---|---|---|
|动态BTB/方向预测基础|既有单元12检查、M1–M4程序与前后反例|有限仿真通过|
|停顿旧STORE重复|自然数据walker停顿，完整有序副作用|已测反例修复|
|停顿redirect链接/训练|自然IF miss、JAL/JALR/taken/not-taken及异常冲突|已测反例修复|
|未对齐目标归属|原始EPC/cause/tval、无错误链接|有限通过|
|M-mode异常/中断|direct/vector、优先级、CSR后响应、暖机循环、MRET及STORE边界|有限通过|
|真实C运行与周期比较|双输入、双时序、预测开关、全状态及逐笔轨迹|本轮新闭环|
|完整M-mode/异常矩阵|嵌套/长期/全部冲突等未覆盖|未完成，不宣传|
|S/U、PMP、Sv32|原R3–R6委派、MPRV/TOR/宽度、walker权限及fault上下文等|不在所选实现范围，原问题保持|
|完整高阶2|指南要求不能凭“高阶”自行免除；当前只交有限范围|未完成|
|候选CoreMark/正式测量|无该候选严格CoreMark验收，不移植旧主线成绩|未完成|
|候选PDS/频率资源/位流/实机/ILA|本轮未执行|NOT_RUN|

本轮的软件工作线可以准确冻结交付；剩余问题不因软件通过消失。生产仍使用D300/SM2和D320应用，不采用未验候选替代作品。后续若要进入候选FPGA实现，必须先收敛器件/存储/约束/工具范围并取得该阶段明确授权，当前不自动执行。

## 检查与证据限制

M4 AUDIT独立逐行复查全部流、10个重复/丢失/错数据/顺序/掩码/截断负向控制拒绝、有效控制和WB/STORE的X、指令/存储地址范围和禁止写ROM。普通VCD仅前2048拍及done附近窗口，其余全程由账本检验；不冒充片上波形或真实退休PC。完成窗口post-NBA时addr已可能属于下一槽，初audit误将它当接受STORE，原AUDIT-first-wave-expectation保留；改为仅核完成标记，接受数据仍在沿前STORE账本逐笔核，不重写DUT结果。

启动及存储模型：ROM8KiB，数据端镜像同字节只读区，RAM32KiB、BSS0x4000、stack0x8000、seed0x2000、签名0x3000–0x3020。本模型是独立验证平台，不是生产SoC接口修改或真实DRM签核。编译器将CRC优化为只读查表，初参考模型未初始化数据口ROM，算法互校在DUT前拒绝；补全明确镜像模型后才冻结，不改算法期望。保留初链接脚本语法错误、补测生成器KeyError；都不是CPU失败。首轮gcc日志另存gcc-first-link-error.log；COMMANDS含各工具原生rc。

89生产/应用保护SHA保持，M3 1291文件清单核同；本轮源码与M3一致。编译保留timescale警告，未屏蔽；已有合法工具普通用户执行，无安装/环境/安全功能改变、无硬件操作。无法由有限程序证明完整ISA、任意初态、完整异常/特权或工业认证。

工作入口：work/advanced/2026-11-03-btb-cprogram-m4/START_HERE.md。本次软件交付包按PACKAGE_CHECK核身份、内容和可重现入口，不带许可证、专有模型、工具安装包或vvp。静态清单通过不是功能通过；包内C入口另做隔离复现，见PACKAGE_REPRO结果。
