minzhetang/pangu-riscv-soc/deliveries/competition-source-package-2026-11-03-v1/package/verification/system-origin/project/work/system/2026-10-23-memory-adapt-m1/COMMANDS.md

# 本次实际执行命令

16次编译经单批权限审批；781次仿真为普通权限。以下JSON argv不经shell拆分；cwd、限时、原生rc和墙时见对应process.json。

```json
{"argv": ["D:\\A_FPGA_Comp\\tools\\iverilog-13.0-msys2-ucrt64\\ucrt64\\bin\\iverilog.exe", "-B", "D:\\A_FPGA_Comp\\tools\\iverilog-13.0-msys2-ucrt64\\ucrt64\\lib\\ivl", "-g2012", "-Wall", "-s", "tb_mem_adapt", "-Ptb_mem_adapt.SYNC=0", "-o", "D:\\A_FPGA_Comp\\work\\system\\2026-10-23-memory-adapt-m1\\compile\\generic-0.vvp", "D:\\A_FPGA_Comp\\work\\system\\2026-10-23-memory-adapt-m1\\source\\cpu.v", "D:\\A_FPGA_Comp\\work\\system\\2026-10-23-memory-adapt-m1\\source\\alu.v", "D:\\A_FPGA_Comp\\work\\system\\2026-10-23-memory-adapt-m1\\source\\control.v", "D:\\A_FPGA_Comp\\work\\system\\2026-10-23-memory-adapt-m1\\source\\regfile.v", "D:\\A_FPGA_Comp\\work\\system\\2026-10-23-memory-adapt-m1\\memory_model.sv", "D:\\A_FPGA_Comp\\work\\system\\2026-10-23-memory-adapt-m1\\tb_mem_adapt.sv"], "cwd": "D:\\A_FPGA_Comp\\work\\system\\2026-10-23-memory-adapt-m1", "timeout_seconds": 60}
```

```json
{"argv": ["D:\\A_FPGA_Comp\\tools\\iverilog-13.0-msys2-ucrt64\\ucrt64\\bin\\iverilog.exe", "-B", "D:\\A_FPGA_Comp\\tools\\iverilog-13.0-msys2-ucrt64\\ucrt64\\lib\\ivl", "-g2012", "-Wall", "-s", "tb_mem_adapt", "-Ptb_mem_adapt.SYNC=1", "-o", "D:\\A_FPGA_Comp\\work\\system\\2026-10-23-memory-adapt-m1\\compile\\generic-1.vvp", "D:\\A_FPGA_Comp\\work\\system\\2026-10-23-memory-adapt-m1\\source\\cpu.v", "D:\\A_FPGA_Comp\\work\\system\\2026-10-23-memory-adapt-m1\\source\\alu.v", "D:\\A_FPGA_Comp\\work\\system\\2026-10-23-memory-adapt-m1\\source\\control.v", "D:\\A_FPGA_Comp\\work\\system\\2026-10-23-memory-adapt-m1\\source\\regfile.v", "D:\\A_FPGA_Comp\\work\\system\\2026-10-23-memory-adapt-m1\\memory_model.sv", "D:\\A_FPGA_Comp\\work\\system\\2026-10-23-memory-adapt-m1\\tb_mem_adapt.sv"], "cwd": "D:\\A_FPGA_Comp\\work\\system\\2026-10-23-memory-adapt-m1", "timeout_seconds": 60}
```

```json
{"argv": ["D:\\A_FPGA_Comp\\tools\\iverilog-13.0-msys2-ucrt64\\ucrt64\\bin\\iverilog.exe", "-B", "D:\\A_FPGA_Comp\\tools\\iverilog-13.0-msys2-ucrt64\\ucrt64\\lib\\ivl", "-g2012", "-Wall", "-s", "tb_cpu_selfcheck_v1", "-o", "D:\\A_FPGA_Comp\\work\\system\\2026-10-23-memory-adapt-m1\\compile\\regression-base.vvp", "D:\\A_FPGA_Comp\\work\\system\\2026-10-23-memory-adapt-m1\\source\\cpu.v", "D:\\A_FPGA_Comp\\work\\system\\2026-10-23-memory-adapt-m1\\source\\alu.v", "D:\\A_FPGA_Comp\\work\\system\\2026-10-23-memory-adapt-m1\\source\\control.v", "D:\\A_FPGA_Comp\\work\\system\\2026-10-23-memory-adapt-m1\\source\\regfile.v", "D:\\A_FPGA_Comp\\work\\icarus\\2026-10-21-cpu-shifti-reject\\tb_cpu_selfcheck_v1.sv"], "cwd": "D:\\A_FPGA_Comp\\work\\system\\2026-10-23-memory-adapt-m1", "timeout_seconds": 60}
```

```json
{"argv": ["D:\\A_FPGA_Comp\\tools\\iverilog-13.0-msys2-ucrt64\\ucrt64\\bin\\iverilog.exe", "-B", "D:\\A_FPGA_Comp\\tools\\iverilog-13.0-msys2-ucrt64\\ucrt64\\lib\\ivl", "-g2012", "-Wall", "-s", "tb_cpu_selfcheck_v1", "-o", "D:\\A_FPGA_Comp\\work\\system\\2026-10-23-memory-adapt-m1\\compile\\regression-lbu.vvp", "D:\\A_FPGA_Comp\\work\\system\\2026-10-23-memory-adapt-m1\\source\\cpu.v", "D:\\A_FPGA_Comp\\work\\system\\2026-10-23-memory-adapt-m1\\source\\alu.v", "D:\\A_FPGA_Comp\\work\\system\\2026-10-23-memory-adapt-m1\\source\\control.v", "D:\\A_FPGA_Comp\\work\\system\\2026-10-23-memory-adapt-m1\\source\\regfile.v", "D:\\A_FPGA_Comp\\work\\icarus\\2026-10-21-cpu-shifti-reject\\tb_cpu_lbu_selfcheck_v1.sv"], "cwd": "D:\\A_FPGA_Comp\\work\\system\\2026-10-23-memory-adapt-m1", "timeout_seconds": 60}
```

```json
{"argv": ["D:\\A_FPGA_Comp\\tools\\iverilog-13.0-msys2-ucrt64\\ucrt64\\bin\\iverilog.exe", "-B", "D:\\A_FPGA_Comp\\tools\\iverilog-13.0-msys2-ucrt64\\ucrt64\\lib\\ivl", "-g2012", "-Wall", "-s", "tb_cpu_selfcheck_v1", "-o", "D:\\A_FPGA_Comp\\work\\system\\2026-10-23-memory-adapt-m1\\compile\\regression-lb.vvp", "D:\\A_FPGA_Comp\\work\\system\\2026-10-23-memory-adapt-m1\\source\\cpu.v", "D:\\A_FPGA_Comp\\work\\system\\2026-10-23-memory-adapt-m1\\source\\alu.v", "D:\\A_FPGA_Comp\\work\\system\\2026-10-23-memory-adapt-m1\\source\\control.v", "D:\\A_FPGA_Comp\\work\\system\\2026-10-23-memory-adapt-m1\\source\\regfile.v", "D:\\A_FPGA_Comp\\work\\icarus\\2026-10-21-cpu-shifti-reject\\tb_cpu_lb_selfcheck_v1.sv"], "cwd": "D:\\A_FPGA_Comp\\work\\system\\2026-10-23-memory-adapt-m1", "timeout_seconds": 60}
```

```json
{"argv": ["D:\\A_FPGA_Comp\\tools\\iverilog-13.0-msys2-ucrt64\\ucrt64\\bin\\iverilog.exe", "-B", "D:\\A_FPGA_Comp\\tools\\iverilog-13.0-msys2-ucrt64\\ucrt64\\lib\\ivl", "-g2012", "-Wall", "-s", "tb_cpu_selfcheck_v1", "-o", "D:\\A_FPGA_Comp\\work\\system\\2026-10-23-memory-adapt-m1\\compile\\regression-lhu.vvp", "D:\\A_FPGA_Comp\\work\\system\\2026-10-23-memory-adapt-m1\\source\\cpu.v", "D:\\A_FPGA_Comp\\work\\system\\2026-10-23-memory-adapt-m1\\source\\alu.v", "D:\\A_FPGA_Comp\\work\\system\\2026-10-23-memory-adapt-m1\\source\\control.v", "D:\\A_FPGA_Comp\\work\\system\\2026-10-23-memory-adapt-m1\\source\\regfile.v", "D:\\A_FPGA_Comp\\work\\icarus\\2026-10-21-cpu-shifti-reject\\tb_cpu_lhu_selfcheck_v1.sv"], "cwd": "D:\\A_FPGA_Comp\\work\\system\\2026-10-23-memory-adapt-m1", "timeout_seconds": 60}
```

```json
{"argv": ["D:\\A_FPGA_Comp\\tools\\iverilog-13.0-msys2-ucrt64\\ucrt64\\bin\\iverilog.exe", "-B", "D:\\A_FPGA_Comp\\tools\\iverilog-13.0-msys2-ucrt64\\ucrt64\\lib\\ivl", "-g2012", "-Wall", "-s", "tb_cpu_selfcheck_v1", "-o", "D:\\A_FPGA_Comp\\work\\system\\2026-10-23-memory-adapt-m1\\compile\\regression-lh.vvp", "D:\\A_FPGA_Comp\\work\\system\\2026-10-23-memory-adapt-m1\\source\\cpu.v", "D:\\A_FPGA_Comp\\work\\system\\2026-10-23-memory-adapt-m1\\source\\alu.v", "D:\\A_FPGA_Comp\\work\\system\\2026-10-23-memory-adapt-m1\\source\\control.v", "D:\\A_FPGA_Comp\\work\\system\\2026-10-23-memory-adapt-m1\\source\\regfile.v", "D:\\A_FPGA_Comp\\work\\icarus\\2026-10-21-cpu-shifti-reject\\tb_cpu_lh_selfcheck_v1.sv"], "cwd": "D:\\A_FPGA_Comp\\work\\system\\2026-10-23-memory-adapt-m1", "timeout_seconds": 60}
```

```json
{"argv": ["D:\\A_FPGA_Comp\\tools\\iverilog-13.0-msys2-ucrt64\\ucrt64\\bin\\iverilog.exe", "-B", "D:\\A_FPGA_Comp\\tools\\iverilog-13.0-msys2-ucrt64\\ucrt64\\lib\\ivl", "-g2012", "-Wall", "-s", "tb_cpu_selfcheck_v1", "-o", "D:\\A_FPGA_Comp\\work\\system\\2026-10-23-memory-adapt-m1\\compile\\regression-sb.vvp", "D:\\A_FPGA_Comp\\work\\system\\2026-10-23-memory-adapt-m1\\source\\cpu.v", "D:\\A_FPGA_Comp\\work\\system\\2026-10-23-memory-adapt-m1\\source\\alu.v", "D:\\A_FPGA_Comp\\work\\system\\2026-10-23-memory-adapt-m1\\source\\control.v", "D:\\A_FPGA_Comp\\work\\system\\2026-10-23-memory-adapt-m1\\source\\regfile.v", "D:\\A_FPGA_Comp\\work\\icarus\\2026-10-21-cpu-shifti-reject\\tb_cpu_sb_selfcheck_v1.sv"], "cwd": "D:\\A_FPGA_Comp\\work\\system\\2026-10-23-memory-adapt-m1", "timeout_seconds": 60}
```

```json
{"argv": ["D:\\A_FPGA_Comp\\tools\\iverilog-13.0-msys2-ucrt64\\ucrt64\\bin\\iverilog.exe", "-B", "D:\\A_FPGA_Comp\\tools\\iverilog-13.0-msys2-ucrt64\\ucrt64\\lib\\ivl", "-g2012", "-Wall", "-s", "tb_cpu_selfcheck_v1", "-o", "D:\\A_FPGA_Comp\\work\\system\\2026-10-23-memory-adapt-m1\\compile\\regression-sh.vvp", "D:\\A_FPGA_Comp\\work\\system\\2026-10-23-memory-adapt-m1\\source\\cpu.v", "D:\\A_FPGA_Comp\\work\\system\\2026-10-23-memory-adapt-m1\\source\\alu.v", "D:\\A_FPGA_Comp\\work\\system\\2026-10-23-memory-adapt-m1\\source\\control.v", "D:\\A_FPGA_Comp\\work\\system\\2026-10-23-memory-adapt-m1\\source\\regfile.v", "D:\\A_FPGA_Comp\\work\\icarus\\2026-10-21-cpu-shifti-reject\\tb_cpu_sh_selfcheck_v1.sv"], "cwd": "D:\\A_FPGA_Comp\\work\\system\\2026-10-23-memory-adapt-m1", "timeout_seconds": 60}
```

```json
{"argv": ["D:\\A_FPGA_Comp\\tools\\iverilog-13.0-msys2-ucrt64\\ucrt64\\bin\\iverilog.exe", "-B", "D:\\A_FPGA_Comp\\tools\\iverilog-13.0-msys2-ucrt64\\ucrt64\\lib\\ivl", "-g2012", "-Wall", "-s", "tb_cpu_selfcheck_v1", "-o", "D:\\A_FPGA_Comp\\work\\system\\2026-10-23-memory-adapt-m1\\compile\\regression-fence.vvp", "D:\\A_FPGA_Comp\\work\\system\\2026-10-23-memory-adapt-m1\\source\\cpu.v", "D:\\A_FPGA_Comp\\work\\system\\2026-10-23-memory-adapt-m1\\source\\alu.v", "D:\\A_FPGA_Comp\\work\\system\\2026-10-23-memory-adapt-m1\\source\\control.v", "D:\\A_FPGA_Comp\\work\\system\\2026-10-23-memory-adapt-m1\\source\\regfile.v", "D:\\A_FPGA_Comp\\work\\icarus\\2026-10-21-cpu-shifti-reject\\tb_cpu_fence_selfcheck_v1.sv"], "cwd": "D:\\A_FPGA_Comp\\work\\system\\2026-10-23-memory-adapt-m1", "timeout_seconds": 60}
```

```json
{"argv": ["D:\\A_FPGA_Comp\\tools\\iverilog-13.0-msys2-ucrt64\\ucrt64\\bin\\iverilog.exe", "-B", "D:\\A_FPGA_Comp\\tools\\iverilog-13.0-msys2-ucrt64\\ucrt64\\lib\\ivl", "-g2012", "-Wall", "-s", "tb_cpu_selfcheck_v1", "-o", "D:\\A_FPGA_Comp\\work\\system\\2026-10-23-memory-adapt-m1\\compile\\regression-eei.vvp", "D:\\A_FPGA_Comp\\work\\system\\2026-10-23-memory-adapt-m1\\source\\cpu.v", "D:\\A_FPGA_Comp\\work\\system\\2026-10-23-memory-adapt-m1\\source\\alu.v", "D:\\A_FPGA_Comp\\work\\system\\2026-10-23-memory-adapt-m1\\source\\control.v", "D:\\A_FPGA_Comp\\work\\system\\2026-10-23-memory-adapt-m1\\source\\regfile.v", "D:\\A_FPGA_Comp\\work\\icarus\\2026-10-21-cpu-shifti-reject\\tb_cpu_eei_selfcheck_v1.sv"], "cwd": "D:\\A_FPGA_Comp\\work\\system\\2026-10-23-memory-adapt-m1", "timeout_seconds": 60}
```

```json
{"argv": ["D:\\A_FPGA_Comp\\tools\\iverilog-13.0-msys2-ucrt64\\ucrt64\\bin\\iverilog.exe", "-B", "D:\\A_FPGA_Comp\\tools\\iverilog-13.0-msys2-ucrt64\\ucrt64\\lib\\ivl", "-g2012", "-Wall", "-s", "tb_cpu_selfcheck_v1", "-o", "D:\\A_FPGA_Comp\\work\\system\\2026-10-23-memory-adapt-m1\\compile\\regression-zero.vvp", "D:\\A_FPGA_Comp\\work\\system\\2026-10-23-memory-adapt-m1\\source\\cpu.v", "D:\\A_FPGA_Comp\\work\\system\\2026-10-23-memory-adapt-m1\\source\\alu.v", "D:\\A_FPGA_Comp\\work\\system\\2026-10-23-memory-adapt-m1\\source\\control.v", "D:\\A_FPGA_Comp\\work\\system\\2026-10-23-memory-adapt-m1\\source\\regfile.v", "D:\\A_FPGA_Comp\\work\\icarus\\2026-10-21-cpu-shifti-reject\\tb_cpu_zero_selfcheck_v1.sv"], "cwd": "D:\\A_FPGA_Comp\\work\\system\\2026-10-23-memory-adapt-m1", "timeout_seconds": 60}
```

```json
{"argv": ["D:\\A_FPGA_Comp\\tools\\iverilog-13.0-msys2-ucrt64\\ucrt64\\bin\\iverilog.exe", "-B", "D:\\A_FPGA_Comp\\tools\\iverilog-13.0-msys2-ucrt64\\ucrt64\\lib\\ivl", "-g2012", "-Wall", "-s", "tb_cpu_selfcheck_v1", "-o", "D:\\A_FPGA_Comp\\work\\system\\2026-10-23-memory-adapt-m1\\compile\\regression-r4.vvp", "D:\\A_FPGA_Comp\\work\\system\\2026-10-23-memory-adapt-m1\\source\\cpu.v", "D:\\A_FPGA_Comp\\work\\system\\2026-10-23-memory-adapt-m1\\source\\alu.v", "D:\\A_FPGA_Comp\\work\\system\\2026-10-23-memory-adapt-m1\\source\\control.v", "D:\\A_FPGA_Comp\\work\\system\\2026-10-23-memory-adapt-m1\\source\\regfile.v", "D:\\A_FPGA_Comp\\work\\icarus\\2026-10-21-cpu-shifti-reject\\tb_cpu_r4_selfcheck_v1.sv"], "cwd": "D:\\A_FPGA_Comp\\work\\system\\2026-10-23-memory-adapt-m1", "timeout_seconds": 60}
```

```json
{"argv": ["D:\\A_FPGA_Comp\\tools\\iverilog-13.0-msys2-ucrt64\\ucrt64\\bin\\iverilog.exe", "-B", "D:\\A_FPGA_Comp\\tools\\iverilog-13.0-msys2-ucrt64\\ucrt64\\lib\\ivl", "-g2012", "-Wall", "-s", "tb_cpu_selfcheck_v1", "-o", "D:\\A_FPGA_Comp\\work\\system\\2026-10-23-memory-adapt-m1\\compile\\regression-rcmp.vvp", "D:\\A_FPGA_Comp\\work\\system\\2026-10-23-memory-adapt-m1\\source\\cpu.v", "D:\\A_FPGA_Comp\\work\\system\\2026-10-23-memory-adapt-m1\\source\\alu.v", "D:\\A_FPGA_Comp\\work\\system\\2026-10-23-memory-adapt-m1\\source\\control.v", "D:\\A_FPGA_Comp\\work\\system\\2026-10-23-memory-adapt-m1\\source\\regfile.v", "D:\\A_FPGA_Comp\\work\\icarus\\2026-10-21-cpu-shifti-reject\\tb_cpu_rcmp_selfcheck_v1.sv"], "cwd": "D:\\A_FPGA_Comp\\work\\system\\2026-10-23-memory-adapt-m1", "timeout_seconds": 60}
```

```json
{"argv": ["D:\\A_FPGA_Comp\\tools\\iverilog-13.0-msys2-ucrt64\\ucrt64\\bin\\iverilog.exe", "-B", "D:\\A_FPGA_Comp\\tools\\iverilog-13.0-msys2-ucrt64\\ucrt64\\lib\\ivl", "-g2012", "-Wall", "-s", "tb_cpu_selfcheck_v1", "-o", "D:\\A_FPGA_Comp\\work\\system\\2026-10-23-memory-adapt-m1\\compile\\regression-addsub.vvp", "D:\\A_FPGA_Comp\\work\\system\\2026-10-23-memory-adapt-m1\\source\\cpu.v", "D:\\A_FPGA_Comp\\work\\system\\2026-10-23-memory-adapt-m1\\source\\alu.v", "D:\\A_FPGA_Comp\\work\\system\\2026-10-23-memory-adapt-m1\\source\\control.v", "D:\\A_FPGA_Comp\\work\\system\\2026-10-23-memory-adapt-m1\\source\\regfile.v", "D:\\A_FPGA_Comp\\work\\icarus\\2026-10-21-cpu-shifti-reject\\tb_cpu_addsub_selfcheck_v1.sv"], "cwd": "D:\\A_FPGA_Comp\\work\\system\\2026-10-23-memory-adapt-m1", "timeout_seconds": 60}
```

```json
{"argv": ["D:\\A_FPGA_Comp\\tools\\iverilog-13.0-msys2-ucrt64\\ucrt64\\bin\\iverilog.exe", "-B", "D:\\A_FPGA_Comp\\tools\\iverilog-13.0-msys2-ucrt64\\ucrt64\\lib\\ivl", "-g2012", "-Wall", "-s", "tb_cpu_selfcheck_v1", "-o", "D:\\A_FPGA_Comp\\work\\system\\2026-10-23-memory-adapt-m1\\compile\\regression-rshift.vvp", "D:\\A_FPGA_Comp\\work\\system\\2026-10-23-memory-adapt-m1\\source\\cpu.v", "D:\\A_FPGA_Comp\\work\\system\\2026-10-23-memory-adapt-m1\\source\\alu.v", "D:\\A_FPGA_Comp\\work\\system\\2026-10-23-memory-adapt-m1\\source\\control.v", "D:\\A_FPGA_Comp\\work\\system\\2026-10-23-memory-adapt-m1\\source\\regfile.v", "D:\\A_FPGA_Comp\\work\\icarus\\2026-10-21-cpu-shifti-reject\\tb_cpu_rshift_selfcheck_v1.sv"], "cwd": "D:\\A_FPGA_Comp\\work\\system\\2026-10-23-memory-adapt-m1", "timeout_seconds": 60}
```

```json
{"argv": ["D:\\A_FPGA_Comp\\tools\\iverilog-13.0-msys2-ucrt64\\ucrt64\\bin\\vvp.exe", "-N", "-M-", "-MD:\\A_FPGA_Comp\\tools\\iverilog-13.0-msys2-ucrt64\\ucrt64\\lib\\ivl", "D:\\A_FPGA_Comp\\work\\system\\2026-10-23-memory-adapt-m1\\compile\\regression-base.vvp", "+case=T01_addi_x0", "+inputs=D:/A_FPGA_Comp/work/icarus/2026-10-21-cpu-shifti-reject/cases/T01_addi_x0"], "cwd": "D:\\A_FPGA_Comp\\work\\system\\2026-10-23-memory-adapt-m1\\runs\\regression\\T01_addi_x0", "timeout_seconds": 30}
```

```json
{"argv": ["D:\\A_FPGA_Comp\\tools\\iverilog-13.0-msys2-ucrt64\\ucrt64\\bin\\vvp.exe", "-N", "-M-", "-MD:\\A_FPGA_Comp\\tools\\iverilog-13.0-msys2-ucrt64\\ucrt64\\lib\\ivl", "D:\\A_FPGA_Comp\\work\\system\\2026-10-23-memory-adapt-m1\\compile\\regression-base.vvp", "+case=T02_alu_isolated", "+inputs=D:/A_FPGA_Comp/work/icarus/2026-10-21-cpu-shifti-reject/cases/T02_alu_isolated"], "cwd": "D:\\A_FPGA_Comp\\work\\system\\2026-10-23-memory-adapt-m1\\runs\\regression\\T02_alu_isolated", "timeout_seconds": 30}
```

```json
{"argv": ["D:\\A_FPGA_Comp\\tools\\iverilog-13.0-msys2-ucrt64\\ucrt64\\bin\\vvp.exe", "-N", "-M-", "-MD:\\A_FPGA_Comp\\tools\\iverilog-13.0-msys2-ucrt64\\ucrt64\\lib\\ivl", "D:\\A_FPGA_Comp\\work\\system\\2026-10-23-memory-adapt-m1\\compile\\regression-base.vvp", "+case=T03_memory_isolated", "+inputs=D:/A_FPGA_Comp/work/icarus/2026-10-21-cpu-shifti-reject/cases/T03_memory_isolated"], "cwd": "D:\\A_FPGA_Comp\\work\\system\\2026-10-23-memory-adapt-m1\\runs\\regression\\T03_memory_isolated", "timeout_seconds": 30}
```

```json
{"argv": ["D:\\A_FPGA_Comp\\tools\\iverilog-13.0-msys2-ucrt64\\ucrt64\\bin\\vvp.exe", "-N", "-M-", "-MD:\\A_FPGA_Comp\\tools\\iverilog-13.0-msys2-ucrt64\\ucrt64\\lib\\ivl", "D:\\A_FPGA_Comp\\work\\system\\2026-10-23-memory-adapt-m1\\compile\\regression-base.vvp", "+case=T04_beq_taken", "+inputs=D:/A_FPGA_Comp/work/icarus/2026-10-21-cpu-shifti-reject/cases/T04_beq_taken"], "cwd": "D:\\A_FPGA_Comp\\work\\system\\2026-10-23-memory-adapt-m1\\runs\\regression\\T04_beq_taken", "timeout_seconds": 30}
```

```json
{"argv": ["D:\\A_FPGA_Comp\\tools\\iverilog-13.0-msys2-ucrt64\\ucrt64\\bin\\vvp.exe", "-N", "-M-", "-MD:\\A_FPGA_Comp\\tools\\iverilog-13.0-msys2-ucrt64\\ucrt64\\lib\\ivl", "D:\\A_FPGA_Comp\\work\\system\\2026-10-23-memory-adapt-m1\\compile\\regression-base.vvp", "+case=T05_beq_not_taken", "+inputs=D:/A_FPGA_Comp/work/icarus/2026-10-21-cpu-shifti-reject/cases/T05_beq_not_taken"], "cwd": "D:\\A_FPGA_Comp\\work\\system\\2026-10-23-memory-adapt-m1\\runs\\regression\\T05_beq_not_taken", "timeout_seconds": 30}
```

```json
{"argv": ["D:\\A_FPGA_Comp\\tools\\iverilog-13.0-msys2-ucrt64\\ucrt64\\bin\\vvp.exe", "-N", "-M-", "-MD:\\A_FPGA_Comp\\tools\\iverilog-13.0-msys2-ucrt64\\ucrt64\\lib\\ivl", "D:\\A_FPGA_Comp\\work\\system\\2026-10-23-memory-adapt-m1\\compile\\regression-base.vvp", "+case=T06_bne_taken", "+inputs=D:/A_FPGA_Comp/work/icarus/2026-10-21-cpu-shifti-reject/cases/T06_bne_taken"], "cwd": "D:\\A_FPGA_Comp\\work\\system\\2026-10-23-memory-adapt-m1\\runs\\regression\\T06_bne_taken", "timeout_seconds": 30}
```

```json
{"argv": ["D:\\A_FPGA_Comp\\tools\\iverilog-13.0-msys2-ucrt64\\ucrt64\\bin\\vvp.exe", "-N", "-M-", "-MD:\\A_FPGA_Comp\\tools\\iverilog-13.0-msys2-ucrt64\\ucrt64\\lib\\ivl", "D:\\A_FPGA_Comp\\work\\system\\2026-10-23-memory-adapt-m1\\compile\\regression-base.vvp", "+case=T07_bne_not_taken", "+inputs=D:/A_FPGA_Comp/work/icarus/2026-10-21-cpu-shifti-reject/cases/T07_bne_not_taken"], "cwd": "D:\\A_FPGA_Comp\\work\\system\\2026-10-23-memory-adapt-m1\\runs\\regression\\T07_bne_not_taken", "timeout_seconds": 30}
```

```json
{"argv": ["D:\\A_FPGA_Comp\\tools\\iverilog-13.0-msys2-ucrt64\\ucrt64\\bin\\vvp.exe", "-N", "-M-", "-MD:\\A_FPGA_Comp\\tools\\iverilog-13.0-msys2-ucrt64\\ucrt64\\lib\\ivl", "D:\\A_FPGA_Comp\\work\\system\\2026-10-23-memory-adapt-m1\\compile\\regression-base.vvp", "+case=T08_raw_adjacent", "+inputs=D:/A_FPGA_Comp/work/icarus/2026-10-21-cpu-shifti-reject/cases/T08_raw_adjacent"], "cwd": "D:\\A_FPGA_Comp\\work\\system\\2026-10-23-memory-adapt-m1\\runs\\regression\\T08_raw_adjacent", "timeout_seconds": 30}
```

```json
{"argv": ["D:\\A_FPGA_Comp\\tools\\iverilog-13.0-msys2-ucrt64\\ucrt64\\bin\\vvp.exe", "-N", "-M-", "-MD:\\A_FPGA_Comp\\tools\\iverilog-13.0-msys2-ucrt64\\ucrt64\\lib\\ivl", "D:\\A_FPGA_Comp\\work\\system\\2026-10-23-memory-adapt-m1\\compile\\regression-base.vvp", "+case=T09_store_raw_adjacent", "+inputs=D:/A_FPGA_Comp/work/icarus/2026-10-21-cpu-shifti-reject/cases/T09_store_raw_adjacent"], "cwd": "D:\\A_FPGA_Comp\\work\\system\\2026-10-23-memory-adapt-m1\\runs\\regression\\T09_store_raw_adjacent", "timeout_seconds": 30}
```

```json
{"argv": ["D:\\A_FPGA_Comp\\tools\\iverilog-13.0-msys2-ucrt64\\ucrt64\\bin\\vvp.exe", "-N", "-M-", "-MD:\\A_FPGA_Comp\\tools\\iverilog-13.0-msys2-ucrt64\\ucrt64\\lib\\ivl", "D:\\A_FPGA_Comp\\work\\system\\2026-10-23-memory-adapt-m1\\compile\\regression-base.vvp", "+case=T10_load_use_adjacent", "+inputs=D:/A_FPGA_Comp/work/icarus/2026-10-21-cpu-shifti-reject/cases/T10_load_use_adjacent"], "cwd": "D:\\A_FPGA_Comp\\work\\system\\2026-10-23-memory-adapt-m1\\runs\\regression\\T10_load_use_adjacent", "timeout_seconds": 30}
```

```json
{"argv": ["D:\\A_FPGA_Comp\\tools\\iverilog-13.0-msys2-ucrt64\\ucrt64\\bin\\vvp.exe", "-N", "-M-", "-MD:\\A_FPGA_Comp\\tools\\iverilog-13.0-msys2-ucrt64\\ucrt64\\lib\\ivl", "D:\\A_FPGA_Comp\\work\\system\\2026-10-23-memory-adapt-m1\\compile\\regression-base.vvp", "+case=T11_load_use_same_rd", "+inputs=D:/A_FPGA_Comp/work/icarus/2026-10-21-cpu-shifti-reject/cases/T11_load_use_same_rd"], "cwd": "D:\\A_FPGA_Comp\\work\\system\\2026-10-23-memory-adapt-m1\\runs\\regression\\T11_load_use_same_rd", "timeout_seconds": 30}
```

```json
{"argv": ["D:\\A_FPGA_Comp\\tools\\iverilog-13.0-msys2-ucrt64\\ucrt64\\bin\\vvp.exe", "-N", "-M-", "-MD:\\A_FPGA_Comp\\tools\\iverilog-13.0-msys2-ucrt64\\ucrt64\\lib\\ivl", "D:\\A_FPGA_Comp\\work\\system\\2026-10-23-memory-adapt-m1\\compile\\regression-base.vvp", "+case=T12_jal", "+inputs=D:/A_FPGA_Comp/work/icarus/2026-10-21-cpu-shifti-reject/cases/T12_jal"], "cwd": "D:\\A_FPGA_Comp\\work\\system\\2026-10-23-memory-adapt-m1\\runs\\regression\\T12_jal", "timeout_seconds": 30}
```

```json
{"argv": ["D:\\A_FPGA_Comp\\tools\\iverilog-13.0-msys2-ucrt64\\ucrt64\\bin\\vvp.exe", "-N", "-M-", "-MD:\\A_FPGA_Comp\\tools\\iverilog-13.0-msys2-ucrt64\\ucrt64\\lib\\ivl", "D:\\A_FPGA_Comp\\work\\system\\2026-10-23-memory-adapt-m1\\compile\\regression-base.vvp", "+case=T13_jalr", "+inputs=D:/A_FPGA_Comp/work/icarus/2026-10-21-cpu-shifti-reject/cases/T13_jalr"], "cwd": "D:\\A_FPGA_Comp\\work\\system\\2026-10-23-memory-adapt-m1\\runs\\regression\\T13_jalr", "timeout_seconds": 30}
```

```json
{"argv": ["D:\\A_FPGA_Comp\\tools\\iverilog-13.0-msys2-ucrt64\\ucrt64\\bin\\vvp.exe", "-N", "-M-", "-MD:\\A_FPGA_Comp\\tools\\iverilog-13.0-msys2-ucrt64\\ucrt64\\lib\\ivl", "D:\\A_FPGA_Comp\\work\\system\\2026-10-23-memory-adapt-m1\\compile\\regression-base.vvp", "+case=B01_priority_dual_store", "+inputs=D:/A_FPGA_Comp/work/icarus/2026-10-21-cpu-shifti-reject/cases/B01_priority_dual_store"], "cwd": "D:\\A_FPGA_Comp\\work\\system\\2026-10-23-memory-adapt-m1\\runs\\regression\\B01_priority_dual_store", "timeout_seconds": 30}
```

```json
{"argv": ["D:\\A_FPGA_Comp\\tools\\iverilog-13.0-msys2-ucrt64\\ucrt64\\bin\\vvp.exe", "-N", "-M-", "-MD:\\A_FPGA_Comp\\tools\\iverilog-13.0-msys2-ucrt64\\ucrt64\\lib\\ivl", "D:\\A_FPGA_Comp\\work\\system\\2026-10-23-memory-adapt-m1\\compile\\regression-base.vvp", "+case=B02_x0_immediate_store_address", "+inputs=D:/A_FPGA_Comp/work/icarus/2026-10-21-cpu-shifti-reject/cases/B02_x0_immediate_store_address"], "cwd": "D:\\A_FPGA_Comp\\work\\system\\2026-10-23-memory-adapt-m1\\runs\\regression\\B02_x0_immediate_store_address", "timeout_seconds": 30}
```

```json
{"argv": ["D:\\A_FPGA_Comp\\tools\\iverilog-13.0-msys2-ucrt64\\ucrt64\\bin\\vvp.exe", "-N", "-M-", "-MD:\\A_FPGA_Comp\\tools\\iverilog-13.0-msys2-ucrt64\\ucrt64\\lib\\ivl", "D:\\A_FPGA_Comp\\work\\system\\2026-10-23-memory-adapt-m1\\compile\\regression-base.vvp", "+case=B03_wb_id_same_edge", "+inputs=D:/A_FPGA_Comp/work/icarus/2026-10-21-cpu-shifti-reject/cases/B03_wb_id_same_edge"], "cwd": "D:\\A_FPGA_Comp\\work\\system\\2026-10-23-memory-adapt-m1\\runs\\regression\\B03_wb_id_same_edge", "timeout_seconds": 30}
```

```json
{"argv": ["D:\\A_FPGA_Comp\\tools\\iverilog-13.0-msys2-ucrt64\\ucrt64\\bin\\vvp.exe", "-N", "-M-", "-MD:\\A_FPGA_Comp\\tools\\iverilog-13.0-msys2-ucrt64\\ucrt64\\lib\\ivl", "D:\\A_FPGA_Comp\\work\\system\\2026-10-23-memory-adapt-m1\\compile\\regression-base.vvp", "+case=C01_wb_id_dual_source", "+inputs=D:/A_FPGA_Comp/work/icarus/2026-10-21-cpu-shifti-reject/cases/C01_wb_id_dual_source"], "cwd": "D:\\A_FPGA_Comp\\work\\system\\2026-10-23-memory-adapt-m1\\runs\\regression\\C01_wb_id_dual_source", "timeout_seconds": 30}
```

```json
{"argv": ["D:\\A_FPGA_Comp\\tools\\iverilog-13.0-msys2-ucrt64\\ucrt64\\bin\\vvp.exe", "-N", "-M-", "-MD:\\A_FPGA_Comp\\tools\\iverilog-13.0-msys2-ucrt64\\ucrt64\\lib\\ivl", "D:\\A_FPGA_Comp\\work\\system\\2026-10-23-memory-adapt-m1\\compile\\regression-base.vvp", "+case=C02_wb_id_store_rs2", "+inputs=D:/A_FPGA_Comp/work/icarus/2026-10-21-cpu-shifti-reject/cases/C02_wb_id_store_rs2"], "cwd": "D:\\A_FPGA_Comp\\work\\system\\2026-10-23-memory-adapt-m1\\runs\\regression\\C02_wb_id_store_rs2", "timeout_seconds": 30}
```

```json
{"argv": ["D:\\A_FPGA_Comp\\tools\\iverilog-13.0-msys2-ucrt64\\ucrt64\\bin\\vvp.exe", "-N", "-M-", "-MD:\\A_FPGA_Comp\\tools\\iverilog-13.0-msys2-ucrt64\\ucrt64\\lib\\ivl", "D:\\A_FPGA_Comp\\work\\system\\2026-10-23-memory-adapt-m1\\compile\\regression-base.vvp", "+case=C03_wb_id_x0_excluded", "+inputs=D:/A_FPGA_Comp/work/icarus/2026-10-21-cpu-shifti-reject/cases/C03_wb_id_x0_excluded"], "cwd": "D:\\A_FPGA_Comp\\work\\system\\2026-10-23-memory-adapt-m1\\runs\\regression\\C03_wb_id_x0_excluded", "timeout_seconds": 30}
```

```json
{"argv": ["D:\\A_FPGA_Comp\\tools\\iverilog-13.0-msys2-ucrt64\\ucrt64\\bin\\vvp.exe", "-N", "-M-", "-MD:\\A_FPGA_Comp\\tools\\iverilog-13.0-msys2-ucrt64\\ucrt64\\lib\\ivl", "D:\\A_FPGA_Comp\\work\\system\\2026-10-23-memory-adapt-m1\\compile\\regression-base.vvp", "+case=L01_load_dual_source", "+inputs=D:/A_FPGA_Comp/work/icarus/2026-10-21-cpu-shifti-reject/cases/L01_load_dual_source"], "cwd": "D:\\A_FPGA_Comp\\work\\system\\2026-10-23-memory-adapt-m1\\runs\\regression\\L01_load_dual_source", "timeout_seconds": 30}
```

```json
{"argv": ["D:\\A_FPGA_Comp\\tools\\iverilog-13.0-msys2-ucrt64\\ucrt64\\bin\\vvp.exe", "-N", "-M-", "-MD:\\A_FPGA_Comp\\tools\\iverilog-13.0-msys2-ucrt64\\ucrt64\\lib\\ivl", "D:\\A_FPGA_Comp\\work\\system\\2026-10-23-memory-adapt-m1\\compile\\regression-base.vvp", "+case=L02_load_store_reload", "+inputs=D:/A_FPGA_Comp/work/icarus/2026-10-21-cpu-shifti-reject/cases/L02_load_store_reload"], "cwd": "D:\\A_FPGA_Comp\\work\\system\\2026-10-23-memory-adapt-m1\\runs\\regression\\L02_load_store_reload", "timeout_seconds": 30}
```

```json
{"argv": ["D:\\A_FPGA_Comp\\tools\\iverilog-13.0-msys2-ucrt64\\ucrt64\\bin\\vvp.exe", "-N", "-M-", "-MD:\\A_FPGA_Comp\\tools\\iverilog-13.0-msys2-ucrt64\\ucrt64\\lib\\ivl", "D:\\A_FPGA_Comp\\work\\system\\2026-10-23-memory-adapt-m1\\compile\\regression-base.vvp", "+case=L03_false_rs2_x0", "+inputs=D:/A_FPGA_Comp/work/icarus/2026-10-21-cpu-shifti-reject/cases/L03_false_rs2_x0"], "cwd": "D:\\A_FPGA_Comp\\work\\system\\2026-10-23-memory-adapt-m1\\runs\\regression\\L03_false_rs2_x0", "timeout_seconds": 30}
```

```json
{"argv": ["D:\\A_FPGA_Comp\\tools\\iverilog-13.0-msys2-ucrt64\\ucrt64\\bin\\vvp.exe", "-N", "-M-", "-MD:\\A_FPGA_Comp\\tools\\iverilog-13.0-msys2-ucrt64\\ucrt64\\lib\\ivl", "D:\\A_FPGA_Comp\\work\\system\\2026-10-23-memory-adapt-m1\\compile\\regression-base.vvp", "+case=J01_negative_jal_link_squash", "+inputs=D:/A_FPGA_Comp/work/icarus/2026-10-21-cpu-shifti-reject/cases/J01_negative_jal_link_squash"], "cwd": "D:\\A_FPGA_Comp\\work\\system\\2026-10-23-memory-adapt-m1\\runs\\regression\\J01_negative_jal_link_squash", "timeout_seconds": 30}
```

```json
{"argv": ["D:\\A_FPGA_Comp\\tools\\iverilog-13.0-msys2-ucrt64\\ucrt64\\bin\\vvp.exe", "-N", "-M-", "-MD:\\A_FPGA_Comp\\tools\\iverilog-13.0-msys2-ucrt64\\ucrt64\\lib\\ivl", "D:\\A_FPGA_Comp\\work\\system\\2026-10-23-memory-adapt-m1\\compile\\regression-base.vvp", "+case=J02_jalr_forward_odd_negative", "+inputs=D:/A_FPGA_Comp/work/icarus/2026-10-21-cpu-shifti-reject/cases/J02_jalr_forward_odd_negative"], "cwd": "D:\\A_FPGA_Comp\\work\\system\\2026-10-23-memory-adapt-m1\\runs\\regression\\J02_jalr_forward_odd_negative", "timeout_seconds": 30}
```

```json
{"argv": ["D:\\A_FPGA_Comp\\tools\\iverilog-13.0-msys2-ucrt64\\ucrt64\\bin\\vvp.exe", "-N", "-M-", "-MD:\\A_FPGA_Comp\\tools\\iverilog-13.0-msys2-ucrt64\\ucrt64\\lib\\ivl", "D:\\A_FPGA_Comp\\work\\system\\2026-10-23-memory-adapt-m1\\compile\\regression-base.vvp", "+case=J03_load_jalr_same_rd", "+inputs=D:/A_FPGA_Comp/work/icarus/2026-10-21-cpu-shifti-reject/cases/J03_load_jalr_same_rd"], "cwd": "D:\\A_FPGA_Comp\\work\\system\\2026-10-23-memory-adapt-m1\\runs\\regression\\J03_load_jalr_same_rd", "timeout_seconds": 30}
```

```json
{"argv": ["D:\\A_FPGA_Comp\\tools\\iverilog-13.0-msys2-ucrt64\\ucrt64\\bin\\vvp.exe", "-N", "-M-", "-MD:\\A_FPGA_Comp\\tools\\iverilog-13.0-msys2-ucrt64\\ucrt64\\lib\\ivl", "D:\\A_FPGA_Comp\\work\\system\\2026-10-23-memory-adapt-m1\\compile\\regression-base.vvp", "+case=J04_jump_x0_base", "+inputs=D:/A_FPGA_Comp/work/icarus/2026-10-21-cpu-shifti-reject/cases/J04_jump_x0_base"], "cwd": "D:\\A_FPGA_Comp\\work\\system\\2026-10-23-memory-adapt-m1\\runs\\regression\\J04_jump_x0_base", "timeout_seconds": 30}
```

```json
{"argv": ["D:\\A_FPGA_Comp\\tools\\iverilog-13.0-msys2-ucrt64\\ucrt64\\bin\\vvp.exe", "-N", "-M-", "-MD:\\A_FPGA_Comp\\tools\\iverilog-13.0-msys2-ucrt64\\ucrt64\\lib\\ivl", "D:\\A_FPGA_Comp\\work\\system\\2026-10-23-memory-adapt-m1\\compile\\regression-base.vvp", "+case=X01_wrap_signed_logic", "+inputs=D:/A_FPGA_Comp/work/icarus/2026-10-21-cpu-shifti-reject/cases/X01_wrap_signed_logic"], "cwd": "D:\\A_FPGA_Comp\\work\\system\\2026-10-23-memory-adapt-m1\\runs\\regression\\X01_wrap_signed_logic", "timeout_seconds": 30}
```

```json
{"argv": ["D:\\A_FPGA_Comp\\tools\\iverilog-13.0-msys2-ucrt64\\ucrt64\\bin\\vvp.exe", "-N", "-M-", "-MD:\\A_FPGA_Comp\\tools\\iverilog-13.0-msys2-ucrt64\\ucrt64\\lib\\ivl", "D:\\A_FPGA_Comp\\work\\system\\2026-10-23-memory-adapt-m1\\compile\\regression-base.vvp", "+case=X02_shift_mask_sign", "+inputs=D:/A_FPGA_Comp/work/icarus/2026-10-21-cpu-shifti-reject/cases/X02_shift_mask_sign"], "cwd": "D:\\A_FPGA_Comp\\work\\system\\2026-10-23-memory-adapt-m1\\runs\\regression\\X02_shift_mask_sign", "timeout_seconds": 30}
```

```json
{"argv": ["D:\\A_FPGA_Comp\\tools\\iverilog-13.0-msys2-ucrt64\\ucrt64\\bin\\vvp.exe", "-N", "-M-", "-MD:\\A_FPGA_Comp\\tools\\iverilog-13.0-msys2-ucrt64\\ucrt64\\lib\\ivl", "D:\\A_FPGA_Comp\\work\\system\\2026-10-23-memory-adapt-m1\\compile\\regression-base.vvp", "+case=X03_branch_dual_forward", "+inputs=D:/A_FPGA_Comp/work/icarus/2026-10-21-cpu-shifti-reject/cases/X03_branch_dual_forward"], "cwd": "D:\\A_FPGA_Comp\\work\\system\\2026-10-23-memory-adapt-m1\\runs\\regression\\X03_branch_dual_forward", "timeout_seconds": 30}
```

```json
{"argv": ["D:\\A_FPGA_Comp\\tools\\iverilog-13.0-msys2-ucrt64\\ucrt64\\bin\\vvp.exe", "-N", "-M-", "-MD:\\A_FPGA_Comp\\tools\\iverilog-13.0-msys2-ucrt64\\ucrt64\\lib\\ivl", "D:\\A_FPGA_Comp\\work\\system\\2026-10-23-memory-adapt-m1\\compile\\regression-base.vvp", "+case=X04_backward_branch_load_not_taken", "+inputs=D:/A_FPGA_Comp/work/icarus/2026-10-21-cpu-shifti-reject/cases/X04_backward_branch_load_not_taken"], "cwd": "D:\\A_FPGA_Comp\\work\\system\\2026-10-23-memory-adapt-m1\\runs\\regression\\X04_backward_branch_load_not_taken", "timeout_seconds": 30}
```

```json
{"argv": ["D:\\A_FPGA_Comp\\tools\\iverilog-13.0-msys2-ucrt64\\ucrt64\\bin\\vvp.exe", "-N", "-M-", "-MD:\\A_FPGA_Comp\\tools\\iverilog-13.0-msys2-ucrt64\\ucrt64\\lib\\ivl", "D:\\A_FPGA_Comp\\work\\system\\2026-10-23-memory-adapt-m1\\compile\\regression-base.vvp", "+case=X05_load_branch_squash_jump", "+inputs=D:/A_FPGA_Comp/work/icarus/2026-10-21-cpu-shifti-reject/cases/X05_load_branch_squash_jump"], "cwd": "D:\\A_FPGA_Comp\\work\\system\\2026-10-23-memory-adapt-m1\\runs\\regression\\X05_load_branch_squash_jump", "timeout_seconds": 30}
```

```json
{"argv": ["D:\\A_FPGA_Comp\\tools\\iverilog-13.0-msys2-ucrt64\\ucrt64\\bin\\vvp.exe", "-N", "-M-", "-MD:\\A_FPGA_Comp\\tools\\iverilog-13.0-msys2-ucrt64\\ucrt64\\lib\\ivl", "D:\\A_FPGA_Comp\\work\\system\\2026-10-23-memory-adapt-m1\\compile\\regression-base.vvp", "+case=X06_load_address_store_chain", "+inputs=D:/A_FPGA_Comp/work/icarus/2026-10-21-cpu-shifti-reject/cases/X06_load_address_store_chain"], "cwd": "D:\\A_FPGA_Comp\\work\\system\\2026-10-23-memory-adapt-m1\\runs\\regression\\X06_load_address_store_chain", "timeout_seconds": 30}
```

```json
{"argv": ["D:\\A_FPGA_Comp\\tools\\iverilog-13.0-msys2-ucrt64\\ucrt64\\bin\\vvp.exe", "-N", "-M-", "-MD:\\A_FPGA_Comp\\tools\\iverilog-13.0-msys2-ucrt64\\ucrt64\\lib\\ivl", "D:\\A_FPGA_Comp\\work\\system\\2026-10-23-memory-adapt-m1\\compile\\regression-base.vvp", "+case=X07_latest_load_same_rd", "+inputs=D:/A_FPGA_Comp/work/icarus/2026-10-21-cpu-shifti-reject/cases/X07_latest_load_same_rd"], "cwd": "D:\\A_FPGA_Comp\\work\\system\\2026-10-23-memory-adapt-m1\\runs\\regression\\X07_latest_load_same_rd", "timeout_seconds": 30}
```

```json
{"argv": ["D:\\A_FPGA_Comp\\tools\\iverilog-13.0-msys2-ucrt64\\ucrt64\\bin\\vvp.exe", "-N", "-M-", "-MD:\\A_FPGA_Comp\\tools\\iverilog-13.0-msys2-ucrt64\\ucrt64\\lib\\ivl", "D:\\A_FPGA_Comp\\work\\system\\2026-10-23-memory-adapt-m1\\compile\\regression-base.vvp", "+case=X08_jal_target_jalr_return", "+inputs=D:/A_FPGA_Comp/work/icarus/2026-10-21-cpu-shifti-reject/cases/X08_jal_target_jalr_return"], "cwd": "D:\\A_FPGA_Comp\\work\\system\\2026-10-23-memory-adapt-m1\\runs\\regression\\X08_jal_target_jalr_return", "timeout_seconds": 30}
```

```json
{"argv": ["D:\\A_FPGA_Comp\\tools\\iverilog-13.0-msys2-ucrt64\\ucrt64\\bin\\vvp.exe", "-N", "-M-", "-MD:\\A_FPGA_Comp\\tools\\iverilog-13.0-msys2-ucrt64\\ucrt64\\lib\\ivl", "D:\\A_FPGA_Comp\\work\\system\\2026-10-23-memory-adapt-m1\\compile\\regression-base.vvp", "+case=I01_xori_alias", "+inputs=D:/A_FPGA_Comp/work/icarus/2026-10-21-cpu-shifti-reject/cases/I01_xori_alias"], "cwd": "D:\\A_FPGA_Comp\\work\\system\\2026-10-23-memory-adapt-m1\\runs\\regression\\I01_xori_alias", "timeout_seconds": 30}
```

```json
{"argv": ["D:\\A_FPGA_Comp\\tools\\iverilog-13.0-msys2-ucrt64\\ucrt64\\bin\\vvp.exe", "-N", "-M-", "-MD:\\A_FPGA_Comp\\tools\\iverilog-13.0-msys2-ucrt64\\ucrt64\\lib\\ivl", "D:\\A_FPGA_Comp\\work\\system\\2026-10-23-memory-adapt-m1\\compile\\regression-base.vvp", "+case=I02_andi_alias_store", "+inputs=D:/A_FPGA_Comp/work/icarus/2026-10-21-cpu-shifti-reject/cases/I02_andi_alias_store"], "cwd": "D:\\A_FPGA_Comp\\work\\system\\2026-10-23-memory-adapt-m1\\runs\\regression\\I02_andi_alias_store", "timeout_seconds": 30}
```

```json
{"argv": ["D:\\A_FPGA_Comp\\tools\\iverilog-13.0-msys2-ucrt64\\ucrt64\\bin\\vvp.exe", "-N", "-M-", "-MD:\\A_FPGA_Comp\\tools\\iverilog-13.0-msys2-ucrt64\\ucrt64\\lib\\ivl", "D:\\A_FPGA_Comp\\work\\system\\2026-10-23-memory-adapt-m1\\compile\\regression-base.vvp", "+case=I03_zero_control", "+inputs=D:/A_FPGA_Comp/work/icarus/2026-10-21-cpu-shifti-reject/cases/I03_zero_control"], "cwd": "D:\\A_FPGA_Comp\\work\\system\\2026-10-23-memory-adapt-m1\\runs\\regression\\I03_zero_control", "timeout_seconds": 30}
```

```json
{"argv": ["D:\\A_FPGA_Comp\\tools\\iverilog-13.0-msys2-ucrt64\\ucrt64\\bin\\vvp.exe", "-N", "-M-", "-MD:\\A_FPGA_Comp\\tools\\iverilog-13.0-msys2-ucrt64\\ucrt64\\lib\\ivl", "D:\\A_FPGA_Comp\\work\\system\\2026-10-23-memory-adapt-m1\\compile\\regression-base.vvp", "+case=I04_signed_pattern", "+inputs=D:/A_FPGA_Comp/work/icarus/2026-10-21-cpu-shifti-reject/cases/I04_signed_pattern"], "cwd": "D:\\A_FPGA_Comp\\work\\system\\2026-10-23-memory-adapt-m1\\runs\\regression\\I04_signed_pattern", "timeout_seconds": 30}
```

```json
{"argv": ["D:\\A_FPGA_Comp\\tools\\iverilog-13.0-msys2-ucrt64\\ucrt64\\bin\\vvp.exe", "-N", "-M-", "-MD:\\A_FPGA_Comp\\tools\\iverilog-13.0-msys2-ucrt64\\ucrt64\\lib\\ivl", "D:\\A_FPGA_Comp\\work\\system\\2026-10-23-memory-adapt-m1\\compile\\regression-base.vvp", "+case=I05_ones_signbit", "+inputs=D:/A_FPGA_Comp/work/icarus/2026-10-21-cpu-shifti-reject/cases/I05_ones_signbit"], "cwd": "D:\\A_FPGA_Comp\\work\\system\\2026-10-23-memory-adapt-m1\\runs\\regression\\I05_ones_signbit", "timeout_seconds": 30}
```

```json
{"argv": ["D:\\A_FPGA_Comp\\tools\\iverilog-13.0-msys2-ucrt64\\ucrt64\\bin\\vvp.exe", "-N", "-M-", "-MD:\\A_FPGA_Comp\\tools\\iverilog-13.0-msys2-ucrt64\\ucrt64\\lib\\ivl", "D:\\A_FPGA_Comp\\work\\system\\2026-10-23-memory-adapt-m1\\compile\\regression-base.vvp", "+case=I06_bypass_distances", "+inputs=D:/A_FPGA_Comp/work/icarus/2026-10-21-cpu-shifti-reject/cases/I06_bypass_distances"], "cwd": "D:\\A_FPGA_Comp\\work\\system\\2026-10-23-memory-adapt-m1\\runs\\regression\\I06_bypass_distances", "timeout_seconds": 30}
```

```json
{"argv": ["D:\\A_FPGA_Comp\\tools\\iverilog-13.0-msys2-ucrt64\\ucrt64\\bin\\vvp.exe", "-N", "-M-", "-MD:\\A_FPGA_Comp\\tools\\iverilog-13.0-msys2-ucrt64\\ucrt64\\lib\\ivl", "D:\\A_FPGA_Comp\\work\\system\\2026-10-23-memory-adapt-m1\\compile\\regression-base.vvp", "+case=I07_x0_self_rd", "+inputs=D:/A_FPGA_Comp/work/icarus/2026-10-21-cpu-shifti-reject/cases/I07_x0_self_rd"], "cwd": "D:\\A_FPGA_Comp\\work\\system\\2026-10-23-memory-adapt-m1\\runs\\regression\\I07_x0_self_rd", "timeout_seconds": 30}
```

```json
{"argv": ["D:\\A_FPGA_Comp\\tools\\iverilog-13.0-msys2-ucrt64\\ucrt64\\bin\\vvp.exe", "-N", "-M-", "-MD:\\A_FPGA_Comp\\tools\\iverilog-13.0-msys2-ucrt64\\ucrt64\\lib\\ivl", "D:\\A_FPGA_Comp\\work\\system\\2026-10-23-memory-adapt-m1\\compile\\regression-base.vvp", "+case=I08_false_rs2_regression", "+inputs=D:/A_FPGA_Comp/work/icarus/2026-10-21-cpu-shifti-reject/cases/I08_false_rs2_regression"], "cwd": "D:\\A_FPGA_Comp\\work\\system\\2026-10-23-memory-adapt-m1\\runs\\regression\\I08_false_rs2_regression", "timeout_seconds": 30}
```

```json
{"argv": ["D:\\A_FPGA_Comp\\tools\\iverilog-13.0-msys2-ucrt64\\ucrt64\\bin\\vvp.exe", "-N", "-M-", "-MD:\\A_FPGA_Comp\\tools\\iverilog-13.0-msys2-ucrt64\\ucrt64\\lib\\ivl", "D:\\A_FPGA_Comp\\work\\system\\2026-10-23-memory-adapt-m1\\compile\\regression-base.vvp", "+case=S01_slli_alias", "+inputs=D:/A_FPGA_Comp/work/icarus/2026-10-21-cpu-shifti-reject/cases/S01_slli_alias"], "cwd": "D:\\A_FPGA_Comp\\work\\system\\2026-10-23-memory-adapt-m1\\runs\\regression\\S01_slli_alias", "timeout_seconds": 30}
```

```json
{"argv": ["D:\\A_FPGA_Comp\\tools\\iverilog-13.0-msys2-ucrt64\\ucrt64\\bin\\vvp.exe", "-N", "-M-", "-MD:\\A_FPGA_Comp\\tools\\iverilog-13.0-msys2-ucrt64\\ucrt64\\lib\\ivl", "D:\\A_FPGA_Comp\\work\\system\\2026-10-23-memory-adapt-m1\\compile\\regression-base.vvp", "+case=S02_zero_shift_control", "+inputs=D:/A_FPGA_Comp/work/icarus/2026-10-21-cpu-shifti-reject/cases/S02_zero_shift_control"], "cwd": "D:\\A_FPGA_Comp\\work\\system\\2026-10-23-memory-adapt-m1\\runs\\regression\\S02_zero_shift_control", "timeout_seconds": 30}
```

```json
{"argv": ["D:\\A_FPGA_Comp\\tools\\iverilog-13.0-msys2-ucrt64\\ucrt64\\bin\\vvp.exe", "-N", "-M-", "-MD:\\A_FPGA_Comp\\tools\\iverilog-13.0-msys2-ucrt64\\ucrt64\\lib\\ivl", "D:\\A_FPGA_Comp\\work\\system\\2026-10-23-memory-adapt-m1\\compile\\regression-base.vvp", "+case=S03_pattern_truncation", "+inputs=D:/A_FPGA_Comp/work/icarus/2026-10-21-cpu-shifti-reject/cases/S03_pattern_truncation"], "cwd": "D:\\A_FPGA_Comp\\work\\system\\2026-10-23-memory-adapt-m1\\runs\\regression\\S03_pattern_truncation", "timeout_seconds": 30}
```

```json
{"argv": ["D:\\A_FPGA_Comp\\tools\\iverilog-13.0-msys2-ucrt64\\ucrt64\\bin\\vvp.exe", "-N", "-M-", "-MD:\\A_FPGA_Comp\\tools\\iverilog-13.0-msys2-ucrt64\\ucrt64\\lib\\ivl", "D:\\A_FPGA_Comp\\work\\system\\2026-10-23-memory-adapt-m1\\compile\\regression-base.vvp", "+case=S04_ones_signbit", "+inputs=D:/A_FPGA_Comp/work/icarus/2026-10-21-cpu-shifti-reject/cases/S04_ones_signbit"], "cwd": "D:\\A_FPGA_Comp\\work\\system\\2026-10-23-memory-adapt-m1\\runs\\regression\\S04_ones_signbit", "timeout_seconds": 30}
```

```json
{"argv": ["D:\\A_FPGA_Comp\\tools\\iverilog-13.0-msys2-ucrt64\\ucrt64\\bin\\vvp.exe", "-N", "-M-", "-MD:\\A_FPGA_Comp\\tools\\iverilog-13.0-msys2-ucrt64\\ucrt64\\lib\\ivl", "D:\\A_FPGA_Comp\\work\\system\\2026-10-23-memory-adapt-m1\\compile\\regression-base.vvp", "+case=S05_bypass_distances", "+inputs=D:/A_FPGA_Comp/work/icarus/2026-10-21-cpu-shifti-reject/cases/S05_bypass_distances"], "cwd": "D:\\A_FPGA_Comp\\work\\system\\2026-10-23-memory-adapt-m1\\runs\\regression\\S05_bypass_distances", "timeout_seconds": 30}
```

```json
{"argv": ["D:\\A_FPGA_Comp\\tools\\iverilog-13.0-msys2-ucrt64\\ucrt64\\bin\\vvp.exe", "-N", "-M-", "-MD:\\A_FPGA_Comp\\tools\\iverilog-13.0-msys2-ucrt64\\ucrt64\\lib\\ivl", "D:\\A_FPGA_Comp\\work\\system\\2026-10-23-memory-adapt-m1\\compile\\regression-base.vvp", "+case=S06_x0_self_rd", "+inputs=D:/A_FPGA_Comp/work/icarus/2026-10-21-cpu-shifti-reject/cases/S06_x0_self_rd"], "cwd": "D:\\A_FPGA_Comp\\work\\system\\2026-10-23-memory-adapt-m1\\runs\\regression\\S06_x0_self_rd", "timeout_seconds": 30}
```

```json
{"argv": ["D:\\A_FPGA_Comp\\tools\\iverilog-13.0-msys2-ucrt64\\ucrt64\\bin\\vvp.exe", "-N", "-M-", "-MD:\\A_FPGA_Comp\\tools\\iverilog-13.0-msys2-ucrt64\\ucrt64\\lib\\ivl", "D:\\A_FPGA_Comp\\work\\system\\2026-10-23-memory-adapt-m1\\compile\\regression-base.vvp", "+case=S07_false_rs2_regression", "+inputs=D:/A_FPGA_Comp/work/icarus/2026-10-21-cpu-shifti-reject/cases/S07_false_rs2_regression"], "cwd": "D:\\A_FPGA_Comp\\work\\system\\2026-10-23-memory-adapt-m1\\runs\\regression\\S07_false_rs2_regression", "timeout_seconds": 30}
```

```json
{"argv": ["D:\\A_FPGA_Comp\\tools\\iverilog-13.0-msys2-ucrt64\\ucrt64\\bin\\vvp.exe", "-N", "-M-", "-MD:\\A_FPGA_Comp\\tools\\iverilog-13.0-msys2-ucrt64\\ucrt64\\lib\\ivl", "D:\\A_FPGA_Comp\\work\\system\\2026-10-23-memory-adapt-m1\\compile\\regression-base.vvp", "+case=S08_load_store_chain", "+inputs=D:/A_FPGA_Comp/work/icarus/2026-10-21-cpu-shifti-reject/cases/S08_load_store_chain"], "cwd": "D:\\A_FPGA_Comp\\work\\system\\2026-10-23-memory-adapt-m1\\runs\\regression\\S08_load_store_chain", "timeout_seconds": 30}
```

```json
{"argv": ["D:\\A_FPGA_Comp\\tools\\iverilog-13.0-msys2-ucrt64\\ucrt64\\bin\\vvp.exe", "-N", "-M-", "-MD:\\A_FPGA_Comp\\tools\\iverilog-13.0-msys2-ucrt64\\ucrt64\\lib\\ivl", "D:\\A_FPGA_Comp\\work\\system\\2026-10-23-memory-adapt-m1\\compile\\regression-base.vvp", "+case=R01_srli_alias", "+inputs=D:/A_FPGA_Comp/work/icarus/2026-10-21-cpu-shifti-reject/cases/R01_srli_alias"], "cwd": "D:\\A_FPGA_Comp\\work\\system\\2026-10-23-memory-adapt-m1\\runs\\regression\\R01_srli_alias", "timeout_seconds": 30}
```

```json
{"argv": ["D:\\A_FPGA_Comp\\tools\\iverilog-13.0-msys2-ucrt64\\ucrt64\\bin\\vvp.exe", "-N", "-M-", "-MD:\\A_FPGA_Comp\\tools\\iverilog-13.0-msys2-ucrt64\\ucrt64\\lib\\ivl", "D:\\A_FPGA_Comp\\work\\system\\2026-10-23-memory-adapt-m1\\compile\\regression-base.vvp", "+case=R02_zero_shift_control", "+inputs=D:/A_FPGA_Comp/work/icarus/2026-10-21-cpu-shifti-reject/cases/R02_zero_shift_control"], "cwd": "D:\\A_FPGA_Comp\\work\\system\\2026-10-23-memory-adapt-m1\\runs\\regression\\R02_zero_shift_control", "timeout_seconds": 30}
```

```json
{"argv": ["D:\\A_FPGA_Comp\\tools\\iverilog-13.0-msys2-ucrt64\\ucrt64\\bin\\vvp.exe", "-N", "-M-", "-MD:\\A_FPGA_Comp\\tools\\iverilog-13.0-msys2-ucrt64\\ucrt64\\lib\\ivl", "D:\\A_FPGA_Comp\\work\\system\\2026-10-23-memory-adapt-m1\\compile\\regression-base.vvp", "+case=R03_unsigned_pattern", "+inputs=D:/A_FPGA_Comp/work/icarus/2026-10-21-cpu-shifti-reject/cases/R03_unsigned_pattern"], "cwd": "D:\\A_FPGA_Comp\\work\\system\\2026-10-23-memory-adapt-m1\\runs\\regression\\R03_unsigned_pattern", "timeout_seconds": 30}
```

```json
{"argv": ["D:\\A_FPGA_Comp\\tools\\iverilog-13.0-msys2-ucrt64\\ucrt64\\bin\\vvp.exe", "-N", "-M-", "-MD:\\A_FPGA_Comp\\tools\\iverilog-13.0-msys2-ucrt64\\ucrt64\\lib\\ivl", "D:\\A_FPGA_Comp\\work\\system\\2026-10-23-memory-adapt-m1\\compile\\regression-base.vvp", "+case=R04_ones_zero_fill", "+inputs=D:/A_FPGA_Comp/work/icarus/2026-10-21-cpu-shifti-reject/cases/R04_ones_zero_fill"], "cwd": "D:\\A_FPGA_Comp\\work\\system\\2026-10-23-memory-adapt-m1\\runs\\regression\\R04_ones_zero_fill", "timeout_seconds": 30}
```

```json
{"argv": ["D:\\A_FPGA_Comp\\tools\\iverilog-13.0-msys2-ucrt64\\ucrt64\\bin\\vvp.exe", "-N", "-M-", "-MD:\\A_FPGA_Comp\\tools\\iverilog-13.0-msys2-ucrt64\\ucrt64\\lib\\ivl", "D:\\A_FPGA_Comp\\work\\system\\2026-10-23-memory-adapt-m1\\compile\\regression-base.vvp", "+case=R05_bypass_distances", "+inputs=D:/A_FPGA_Comp/work/icarus/2026-10-21-cpu-shifti-reject/cases/R05_bypass_distances"], "cwd": "D:\\A_FPGA_Comp\\work\\system\\2026-10-23-memory-adapt-m1\\runs\\regression\\R05_bypass_distances", "timeout_seconds": 30}
```

```json
{"argv": ["D:\\A_FPGA_Comp\\tools\\iverilog-13.0-msys2-ucrt64\\ucrt64\\bin\\vvp.exe", "-N", "-M-", "-MD:\\A_FPGA_Comp\\tools\\iverilog-13.0-msys2-ucrt64\\ucrt64\\lib\\ivl", "D:\\A_FPGA_Comp\\work\\system\\2026-10-23-memory-adapt-m1\\compile\\regression-base.vvp", "+case=R06_x0_self_rd", "+inputs=D:/A_FPGA_Comp/work/icarus/2026-10-21-cpu-shifti-reject/cases/R06_x0_self_rd"], "cwd": "D:\\A_FPGA_Comp\\work\\system\\2026-10-23-memory-adapt-m1\\runs\\regression\\R06_x0_self_rd", "timeout_seconds": 30}
```

```json
{"argv": ["D:\\A_FPGA_Comp\\tools\\iverilog-13.0-msys2-ucrt64\\ucrt64\\bin\\vvp.exe", "-N", "-M-", "-MD:\\A_FPGA_Comp\\tools\\iverilog-13.0-msys2-ucrt64\\ucrt64\\lib\\ivl", "D:\\A_FPGA_Comp\\work\\system\\2026-10-23-memory-adapt-m1\\compile\\regression-base.vvp", "+case=R07_false_rs2_regression", "+inputs=D:/A_FPGA_Comp/work/icarus/2026-10-21-cpu-shifti-reject/cases/R07_false_rs2_regression"], "cwd": "D:\\A_FPGA_Comp\\work\\system\\2026-10-23-memory-adapt-m1\\runs\\regression\\R07_false_rs2_regression", "timeout_seconds": 30}
```

```json
{"argv": ["D:\\A_FPGA_Comp\\tools\\iverilog-13.0-msys2-ucrt64\\ucrt64\\bin\\vvp.exe", "-N", "-M-", "-MD:\\A_FPGA_Comp\\tools\\iverilog-13.0-msys2-ucrt64\\ucrt64\\lib\\ivl", "D:\\A_FPGA_Comp\\work\\system\\2026-10-23-memory-adapt-m1\\compile\\regression-base.vvp", "+case=R08_load_store_chain", "+inputs=D:/A_FPGA_Comp/work/icarus/2026-10-21-cpu-shifti-reject/cases/R08_load_store_chain"], "cwd": "D:\\A_FPGA_Comp\\work\\system\\2026-10-23-memory-adapt-m1\\runs\\regression\\R08_load_store_chain", "timeout_seconds": 30}
```

```json
{"argv": ["D:\\A_FPGA_Comp\\tools\\iverilog-13.0-msys2-ucrt64\\ucrt64\\bin\\vvp.exe", "-N", "-M-", "-MD:\\A_FPGA_Comp\\tools\\iverilog-13.0-msys2-ucrt64\\ucrt64\\lib\\ivl", "D:\\A_FPGA_Comp\\work\\system\\2026-10-23-memory-adapt-m1\\compile\\regression-base.vvp", "+case=A01_srai_alias", "+inputs=D:/A_FPGA_Comp/work/icarus/2026-10-21-cpu-shifti-reject/cases/A01_srai_alias"], "cwd": "D:\\A_FPGA_Comp\\work\\system\\2026-10-23-memory-adapt-m1\\runs\\regression\\A01_srai_alias", "timeout_seconds": 30}
```

```json
{"argv": ["D:\\A_FPGA_Comp\\tools\\iverilog-13.0-msys2-ucrt64\\ucrt64\\bin\\vvp.exe", "-N", "-M-", "-MD:\\A_FPGA_Comp\\tools\\iverilog-13.0-msys2-ucrt64\\ucrt64\\lib\\ivl", "D:\\A_FPGA_Comp\\work\\system\\2026-10-23-memory-adapt-m1\\compile\\regression-base.vvp", "+case=A02_zero_shift", "+inputs=D:/A_FPGA_Comp/work/icarus/2026-10-21-cpu-shifti-reject/cases/A02_zero_shift"], "cwd": "D:\\A_FPGA_Comp\\work\\system\\2026-10-23-memory-adapt-m1\\runs\\regression\\A02_zero_shift", "timeout_seconds": 30}
```

```json
{"argv": ["D:\\A_FPGA_Comp\\tools\\iverilog-13.0-msys2-ucrt64\\ucrt64\\bin\\vvp.exe", "-N", "-M-", "-MD:\\A_FPGA_Comp\\tools\\iverilog-13.0-msys2-ucrt64\\ucrt64\\lib\\ivl", "D:\\A_FPGA_Comp\\work\\system\\2026-10-23-memory-adapt-m1\\compile\\regression-base.vvp", "+case=A03_signed_pattern", "+inputs=D:/A_FPGA_Comp/work/icarus/2026-10-21-cpu-shifti-reject/cases/A03_signed_pattern"], "cwd": "D:\\A_FPGA_Comp\\work\\system\\2026-10-23-memory-adapt-m1\\runs\\regression\\A03_signed_pattern", "timeout_seconds": 30}
```

```json
{"argv": ["D:\\A_FPGA_Comp\\tools\\iverilog-13.0-msys2-ucrt64\\ucrt64\\bin\\vvp.exe", "-N", "-M-", "-MD:\\A_FPGA_Comp\\tools\\iverilog-13.0-msys2-ucrt64\\ucrt64\\lib\\ivl", "D:\\A_FPGA_Comp\\work\\system\\2026-10-23-memory-adapt-m1\\compile\\regression-base.vvp", "+case=A04_ones_positive", "+inputs=D:/A_FPGA_Comp/work/icarus/2026-10-21-cpu-shifti-reject/cases/A04_ones_positive"], "cwd": "D:\\A_FPGA_Comp\\work\\system\\2026-10-23-memory-adapt-m1\\runs\\regression\\A04_ones_positive", "timeout_seconds": 30}
```

```json
{"argv": ["D:\\A_FPGA_Comp\\tools\\iverilog-13.0-msys2-ucrt64\\ucrt64\\bin\\vvp.exe", "-N", "-M-", "-MD:\\A_FPGA_Comp\\tools\\iverilog-13.0-msys2-ucrt64\\ucrt64\\lib\\ivl", "D:\\A_FPGA_Comp\\work\\system\\2026-10-23-memory-adapt-m1\\compile\\regression-base.vvp", "+case=A05_bypass_distances", "+inputs=D:/A_FPGA_Comp/work/icarus/2026-10-21-cpu-shifti-reject/cases/A05_bypass_distances"], "cwd": "D:\\A_FPGA_Comp\\work\\system\\2026-10-23-memory-adapt-m1\\runs\\regression\\A05_bypass_distances", "timeout_seconds": 30}
```

```json
{"argv": ["D:\\A_FPGA_Comp\\tools\\iverilog-13.0-msys2-ucrt64\\ucrt64\\bin\\vvp.exe", "-N", "-M-", "-MD:\\A_FPGA_Comp\\tools\\iverilog-13.0-msys2-ucrt64\\ucrt64\\lib\\ivl", "D:\\A_FPGA_Comp\\work\\system\\2026-10-23-memory-adapt-m1\\compile\\regression-base.vvp", "+case=A06_x0_self_rd", "+inputs=D:/A_FPGA_Comp/work/icarus/2026-10-21-cpu-shifti-reject/cases/A06_x0_self_rd"], "cwd": "D:\\A_FPGA_Comp\\work\\system\\2026-10-23-memory-adapt-m1\\runs\\regression\\A06_x0_self_rd", "timeout_seconds": 30}
```

```json
{"argv": ["D:\\A_FPGA_Comp\\tools\\iverilog-13.0-msys2-ucrt64\\ucrt64\\bin\\vvp.exe", "-N", "-M-", "-MD:\\A_FPGA_Comp\\tools\\iverilog-13.0-msys2-ucrt64\\ucrt64\\lib\\ivl", "D:\\A_FPGA_Comp\\work\\system\\2026-10-23-memory-adapt-m1\\compile\\regression-base.vvp", "+case=A07_false_rs2_regression", "+inputs=D:/A_FPGA_Comp/work/icarus/2026-10-21-cpu-shifti-reject/cases/A07_false_rs2_regression"], "cwd": "D:\\A_FPGA_Comp\\work\\system\\2026-10-23-memory-adapt-m1\\runs\\regression\\A07_false_rs2_regression", "timeout_seconds": 30}
```

```json
{"argv": ["D:\\A_FPGA_Comp\\tools\\iverilog-13.0-msys2-ucrt64\\ucrt64\\bin\\vvp.exe", "-N", "-M-", "-MD:\\A_FPGA_Comp\\tools\\iverilog-13.0-msys2-ucrt64\\ucrt64\\lib\\ivl", "D:\\A_FPGA_Comp\\work\\system\\2026-10-23-memory-adapt-m1\\compile\\regression-base.vvp", "+case=A08_load_store_chain", "+inputs=D:/A_FPGA_Comp/work/icarus/2026-10-21-cpu-shifti-reject/cases/A08_load_store_chain"], "cwd": "D:\\A_FPGA_Comp\\work\\system\\2026-10-23-memory-adapt-m1\\runs\\regression\\A08_load_store_chain", "timeout_seconds": 30}
```

```json
{"argv": ["D:\\A_FPGA_Comp\\tools\\iverilog-13.0-msys2-ucrt64\\ucrt64\\bin\\vvp.exe", "-N", "-M-", "-MD:\\A_FPGA_Comp\\tools\\iverilog-13.0-msys2-ucrt64\\ucrt64\\lib\\ivl", "D:\\A_FPGA_Comp\\work\\system\\2026-10-23-memory-adapt-m1\\compile\\regression-base.vvp", "+case=K01_slt_signed_alias", "+inputs=D:/A_FPGA_Comp/work/icarus/2026-10-21-cpu-shifti-reject/cases/K01_slt_signed_alias"], "cwd": "D:\\A_FPGA_Comp\\work\\system\\2026-10-23-memory-adapt-m1\\runs\\regression\\K01_slt_signed_alias", "timeout_seconds": 30}
```

```json
{"argv": ["D:\\A_FPGA_Comp\\tools\\iverilog-13.0-msys2-ucrt64\\ucrt64\\bin\\vvp.exe", "-N", "-M-", "-MD:\\A_FPGA_Comp\\tools\\iverilog-13.0-msys2-ucrt64\\ucrt64\\lib\\ivl", "D:\\A_FPGA_Comp\\work\\system\\2026-10-23-memory-adapt-m1\\compile\\regression-base.vvp", "+case=K02_slt_positive_order", "+inputs=D:/A_FPGA_Comp/work/icarus/2026-10-21-cpu-shifti-reject/cases/K02_slt_positive_order"], "cwd": "D:\\A_FPGA_Comp\\work\\system\\2026-10-23-memory-adapt-m1\\runs\\regression\\K02_slt_positive_order", "timeout_seconds": 30}
```

```json
{"argv": ["D:\\A_FPGA_Comp\\tools\\iverilog-13.0-msys2-ucrt64\\ucrt64\\bin\\vvp.exe", "-N", "-M-", "-MD:\\A_FPGA_Comp\\tools\\iverilog-13.0-msys2-ucrt64\\ucrt64\\lib\\ivl", "D:\\A_FPGA_Comp\\work\\system\\2026-10-23-memory-adapt-m1\\compile\\regression-base.vvp", "+case=K03_slt_extreme_overflow", "+inputs=D:/A_FPGA_Comp/work/icarus/2026-10-21-cpu-shifti-reject/cases/K03_slt_extreme_overflow"], "cwd": "D:\\A_FPGA_Comp\\work\\system\\2026-10-23-memory-adapt-m1\\runs\\regression\\K03_slt_extreme_overflow", "timeout_seconds": 30}
```

```json
{"argv": ["D:\\A_FPGA_Comp\\tools\\iverilog-13.0-msys2-ucrt64\\ucrt64\\bin\\vvp.exe", "-N", "-M-", "-MD:\\A_FPGA_Comp\\tools\\iverilog-13.0-msys2-ucrt64\\ucrt64\\lib\\ivl", "D:\\A_FPGA_Comp\\work\\system\\2026-10-23-memory-adapt-m1\\compile\\regression-base.vvp", "+case=K04_slt_negative_order", "+inputs=D:/A_FPGA_Comp/work/icarus/2026-10-21-cpu-shifti-reject/cases/K04_slt_negative_order"], "cwd": "D:\\A_FPGA_Comp\\work\\system\\2026-10-23-memory-adapt-m1\\runs\\regression\\K04_slt_negative_order", "timeout_seconds": 30}
```

```json
{"argv": ["D:\\A_FPGA_Comp\\tools\\iverilog-13.0-msys2-ucrt64\\ucrt64\\bin\\vvp.exe", "-N", "-M-", "-MD:\\A_FPGA_Comp\\tools\\iverilog-13.0-msys2-ucrt64\\ucrt64\\lib\\ivl", "D:\\A_FPGA_Comp\\work\\system\\2026-10-23-memory-adapt-m1\\compile\\regression-base.vvp", "+case=K05_slt_rs1_bypasses", "+inputs=D:/A_FPGA_Comp/work/icarus/2026-10-21-cpu-shifti-reject/cases/K05_slt_rs1_bypasses"], "cwd": "D:\\A_FPGA_Comp\\work\\system\\2026-10-23-memory-adapt-m1\\runs\\regression\\K05_slt_rs1_bypasses", "timeout_seconds": 30}
```

```json
{"argv": ["D:\\A_FPGA_Comp\\tools\\iverilog-13.0-msys2-ucrt64\\ucrt64\\bin\\vvp.exe", "-N", "-M-", "-MD:\\A_FPGA_Comp\\tools\\iverilog-13.0-msys2-ucrt64\\ucrt64\\lib\\ivl", "D:\\A_FPGA_Comp\\work\\system\\2026-10-23-memory-adapt-m1\\compile\\regression-base.vvp", "+case=K06_slt_rs2_bypasses", "+inputs=D:/A_FPGA_Comp/work/icarus/2026-10-21-cpu-shifti-reject/cases/K06_slt_rs2_bypasses"], "cwd": "D:\\A_FPGA_Comp\\work\\system\\2026-10-23-memory-adapt-m1\\runs\\regression\\K06_slt_rs2_bypasses", "timeout_seconds": 30}
```

```json
{"argv": ["D:\\A_FPGA_Comp\\tools\\iverilog-13.0-msys2-ucrt64\\ucrt64\\bin\\vvp.exe", "-N", "-M-", "-MD:\\A_FPGA_Comp\\tools\\iverilog-13.0-msys2-ucrt64\\ucrt64\\lib\\ivl", "D:\\A_FPGA_Comp\\work\\system\\2026-10-23-memory-adapt-m1\\compile\\regression-base.vvp", "+case=K07_slt_load_rs1", "+inputs=D:/A_FPGA_Comp/work/icarus/2026-10-21-cpu-shifti-reject/cases/K07_slt_load_rs1"], "cwd": "D:\\A_FPGA_Comp\\work\\system\\2026-10-23-memory-adapt-m1\\runs\\regression\\K07_slt_load_rs1", "timeout_seconds": 30}
```

```json
{"argv": ["D:\\A_FPGA_Comp\\tools\\iverilog-13.0-msys2-ucrt64\\ucrt64\\bin\\vvp.exe", "-N", "-M-", "-MD:\\A_FPGA_Comp\\tools\\iverilog-13.0-msys2-ucrt64\\ucrt64\\lib\\ivl", "D:\\A_FPGA_Comp\\work\\system\\2026-10-23-memory-adapt-m1\\compile\\regression-base.vvp", "+case=K08_slt_load_rs2", "+inputs=D:/A_FPGA_Comp/work/icarus/2026-10-21-cpu-shifti-reject/cases/K08_slt_load_rs2"], "cwd": "D:\\A_FPGA_Comp\\work\\system\\2026-10-23-memory-adapt-m1\\runs\\regression\\K08_slt_load_rs2", "timeout_seconds": 30}
```

```json
{"argv": ["D:\\A_FPGA_Comp\\tools\\iverilog-13.0-msys2-ucrt64\\ucrt64\\bin\\vvp.exe", "-N", "-M-", "-MD:\\A_FPGA_Comp\\tools\\iverilog-13.0-msys2-ucrt64\\ucrt64\\lib\\ivl", "D:\\A_FPGA_Comp\\work\\system\\2026-10-23-memory-adapt-m1\\compile\\regression-base.vvp", "+case=K09_slt_x0_self_sources", "+inputs=D:/A_FPGA_Comp/work/icarus/2026-10-21-cpu-shifti-reject/cases/K09_slt_x0_self_sources"], "cwd": "D:\\A_FPGA_Comp\\work\\system\\2026-10-23-memory-adapt-m1\\runs\\regression\\K09_slt_x0_self_sources", "timeout_seconds": 30}
```

```json
{"argv": ["D:\\A_FPGA_Comp\\tools\\iverilog-13.0-msys2-ucrt64\\ucrt64\\bin\\vvp.exe", "-N", "-M-", "-MD:\\A_FPGA_Comp\\tools\\iverilog-13.0-msys2-ucrt64\\ucrt64\\lib\\ivl", "D:\\A_FPGA_Comp\\work\\system\\2026-10-23-memory-adapt-m1\\compile\\regression-base.vvp", "+case=K10_slt_load_x0", "+inputs=D:/A_FPGA_Comp/work/icarus/2026-10-21-cpu-shifti-reject/cases/K10_slt_load_x0"], "cwd": "D:\\A_FPGA_Comp\\work\\system\\2026-10-23-memory-adapt-m1\\runs\\regression\\K10_slt_load_x0", "timeout_seconds": 30}
```

```json
{"argv": ["D:\\A_FPGA_Comp\\tools\\iverilog-13.0-msys2-ucrt64\\ucrt64\\bin\\vvp.exe", "-N", "-M-", "-MD:\\A_FPGA_Comp\\tools\\iverilog-13.0-msys2-ucrt64\\ucrt64\\lib\\ivl", "D:\\A_FPGA_Comp\\work\\system\\2026-10-23-memory-adapt-m1\\compile\\regression-base.vvp", "+case=K11_slt_zero_coincidence", "+inputs=D:/A_FPGA_Comp/work/icarus/2026-10-21-cpu-shifti-reject/cases/K11_slt_zero_coincidence"], "cwd": "D:\\A_FPGA_Comp\\work\\system\\2026-10-23-memory-adapt-m1\\runs\\regression\\K11_slt_zero_coincidence", "timeout_seconds": 30}
```

```json
{"argv": ["D:\\A_FPGA_Comp\\tools\\iverilog-13.0-msys2-ucrt64\\ucrt64\\bin\\vvp.exe", "-N", "-M-", "-MD:\\A_FPGA_Comp\\tools\\iverilog-13.0-msys2-ucrt64\\ucrt64\\lib\\ivl", "D:\\A_FPGA_Comp\\work\\system\\2026-10-23-memory-adapt-m1\\compile\\regression-base.vvp", "+case=U01_sltu_alias", "+inputs=D:/A_FPGA_Comp/work/icarus/2026-10-21-cpu-shifti-reject/cases/U01_sltu_alias"], "cwd": "D:\\A_FPGA_Comp\\work\\system\\2026-10-23-memory-adapt-m1\\runs\\regression\\U01_sltu_alias", "timeout_seconds": 30}
```

```json
{"argv": ["D:\\A_FPGA_Comp\\tools\\iverilog-13.0-msys2-ucrt64\\ucrt64\\bin\\vvp.exe", "-N", "-M-", "-MD:\\A_FPGA_Comp\\tools\\iverilog-13.0-msys2-ucrt64\\ucrt64\\lib\\ivl", "D:\\A_FPGA_Comp\\work\\system\\2026-10-23-memory-adapt-m1\\compile\\regression-base.vvp", "+case=U02_sltu_signed_distinction", "+inputs=D:/A_FPGA_Comp/work/icarus/2026-10-21-cpu-shifti-reject/cases/U02_sltu_signed_distinction"], "cwd": "D:\\A_FPGA_Comp\\work\\system\\2026-10-23-memory-adapt-m1\\runs\\regression\\U02_sltu_signed_distinction", "timeout_seconds": 30}
```

```json
{"argv": ["D:\\A_FPGA_Comp\\tools\\iverilog-13.0-msys2-ucrt64\\ucrt64\\bin\\vvp.exe", "-N", "-M-", "-MD:\\A_FPGA_Comp\\tools\\iverilog-13.0-msys2-ucrt64\\ucrt64\\lib\\ivl", "D:\\A_FPGA_Comp\\work\\system\\2026-10-23-memory-adapt-m1\\compile\\regression-base.vvp", "+case=U03_sltu_sign_boundary", "+inputs=D:/A_FPGA_Comp/work/icarus/2026-10-21-cpu-shifti-reject/cases/U03_sltu_sign_boundary"], "cwd": "D:\\A_FPGA_Comp\\work\\system\\2026-10-23-memory-adapt-m1\\runs\\regression\\U03_sltu_sign_boundary", "timeout_seconds": 30}
```

```json
{"argv": ["D:\\A_FPGA_Comp\\tools\\iverilog-13.0-msys2-ucrt64\\ucrt64\\bin\\vvp.exe", "-N", "-M-", "-MD:\\A_FPGA_Comp\\tools\\iverilog-13.0-msys2-ucrt64\\ucrt64\\lib\\ivl", "D:\\A_FPGA_Comp\\work\\system\\2026-10-23-memory-adapt-m1\\compile\\regression-base.vvp", "+case=U04_sltu_max_neighbours", "+inputs=D:/A_FPGA_Comp/work/icarus/2026-10-21-cpu-shifti-reject/cases/U04_sltu_max_neighbours"], "cwd": "D:\\A_FPGA_Comp\\work\\system\\2026-10-23-memory-adapt-m1\\runs\\regression\\U04_sltu_max_neighbours", "timeout_seconds": 30}
```

```json
{"argv": ["D:\\A_FPGA_Comp\\tools\\iverilog-13.0-msys2-ucrt64\\ucrt64\\bin\\vvp.exe", "-N", "-M-", "-MD:\\A_FPGA_Comp\\tools\\iverilog-13.0-msys2-ucrt64\\ucrt64\\lib\\ivl", "D:\\A_FPGA_Comp\\work\\system\\2026-10-23-memory-adapt-m1\\compile\\regression-base.vvp", "+case=U05_sltu_rs1_bypasses", "+inputs=D:/A_FPGA_Comp/work/icarus/2026-10-21-cpu-shifti-reject/cases/U05_sltu_rs1_bypasses"], "cwd": "D:\\A_FPGA_Comp\\work\\system\\2026-10-23-memory-adapt-m1\\runs\\regression\\U05_sltu_rs1_bypasses", "timeout_seconds": 30}
```

```json
{"argv": ["D:\\A_FPGA_Comp\\tools\\iverilog-13.0-msys2-ucrt64\\ucrt64\\bin\\vvp.exe", "-N", "-M-", "-MD:\\A_FPGA_Comp\\tools\\iverilog-13.0-msys2-ucrt64\\ucrt64\\lib\\ivl", "D:\\A_FPGA_Comp\\work\\system\\2026-10-23-memory-adapt-m1\\compile\\regression-base.vvp", "+case=U06_sltu_rs2_bypasses", "+inputs=D:/A_FPGA_Comp/work/icarus/2026-10-21-cpu-shifti-reject/cases/U06_sltu_rs2_bypasses"], "cwd": "D:\\A_FPGA_Comp\\work\\system\\2026-10-23-memory-adapt-m1\\runs\\regression\\U06_sltu_rs2_bypasses", "timeout_seconds": 30}
```

```json
{"argv": ["D:\\A_FPGA_Comp\\tools\\iverilog-13.0-msys2-ucrt64\\ucrt64\\bin\\vvp.exe", "-N", "-M-", "-MD:\\A_FPGA_Comp\\tools\\iverilog-13.0-msys2-ucrt64\\ucrt64\\lib\\ivl", "D:\\A_FPGA_Comp\\work\\system\\2026-10-23-memory-adapt-m1\\compile\\regression-base.vvp", "+case=U07_sltu_load_rs1", "+inputs=D:/A_FPGA_Comp/work/icarus/2026-10-21-cpu-shifti-reject/cases/U07_sltu_load_rs1"], "cwd": "D:\\A_FPGA_Comp\\work\\system\\2026-10-23-memory-adapt-m1\\runs\\regression\\U07_sltu_load_rs1", "timeout_seconds": 30}
```

```json
{"argv": ["D:\\A_FPGA_Comp\\tools\\iverilog-13.0-msys2-ucrt64\\ucrt64\\bin\\vvp.exe", "-N", "-M-", "-MD:\\A_FPGA_Comp\\tools\\iverilog-13.0-msys2-ucrt64\\ucrt64\\lib\\ivl", "D:\\A_FPGA_Comp\\work\\system\\2026-10-23-memory-adapt-m1\\compile\\regression-base.vvp", "+case=U08_sltu_load_rs2", "+inputs=D:/A_FPGA_Comp/work/icarus/2026-10-21-cpu-shifti-reject/cases/U08_sltu_load_rs2"], "cwd": "D:\\A_FPGA_Comp\\work\\system\\2026-10-23-memory-adapt-m1\\runs\\regression\\U08_sltu_load_rs2", "timeout_seconds": 30}
```

```json
{"argv": ["D:\\A_FPGA_Comp\\tools\\iverilog-13.0-msys2-ucrt64\\ucrt64\\bin\\vvp.exe", "-N", "-M-", "-MD:\\A_FPGA_Comp\\tools\\iverilog-13.0-msys2-ucrt64\\ucrt64\\lib\\ivl", "D:\\A_FPGA_Comp\\work\\system\\2026-10-23-memory-adapt-m1\\compile\\regression-base.vvp", "+case=U09_sltu_x0_self_sources", "+inputs=D:/A_FPGA_Comp/work/icarus/2026-10-21-cpu-shifti-reject/cases/U09_sltu_x0_self_sources"], "cwd": "D:\\A_FPGA_Comp\\work\\system\\2026-10-23-memory-adapt-m1\\runs\\regression\\U09_sltu_x0_self_sources", "timeout_seconds": 30}
```

```json
{"argv": ["D:\\A_FPGA_Comp\\tools\\iverilog-13.0-msys2-ucrt64\\ucrt64\\bin\\vvp.exe", "-N", "-M-", "-MD:\\A_FPGA_Comp\\tools\\iverilog-13.0-msys2-ucrt64\\ucrt64\\lib\\ivl", "D:\\A_FPGA_Comp\\work\\system\\2026-10-23-memory-adapt-m1\\compile\\regression-base.vvp", "+case=U10_sltu_load_x0", "+inputs=D:/A_FPGA_Comp/work/icarus/2026-10-21-cpu-shifti-reject/cases/U10_sltu_load_x0"], "cwd": "D:\\A_FPGA_Comp\\work\\system\\2026-10-23-memory-adapt-m1\\runs\\regression\\U10_sltu_load_x0", "timeout_seconds": 30}
```

```json
{"argv": ["D:\\A_FPGA_Comp\\tools\\iverilog-13.0-msys2-ucrt64\\ucrt64\\bin\\vvp.exe", "-N", "-M-", "-MD:\\A_FPGA_Comp\\tools\\iverilog-13.0-msys2-ucrt64\\ucrt64\\lib\\ivl", "D:\\A_FPGA_Comp\\work\\system\\2026-10-23-memory-adapt-m1\\compile\\regression-base.vvp", "+case=U11_sltu_zero_coincidence", "+inputs=D:/A_FPGA_Comp/work/icarus/2026-10-21-cpu-shifti-reject/cases/U11_sltu_zero_coincidence"], "cwd": "D:\\A_FPGA_Comp\\work\\system\\2026-10-23-memory-adapt-m1\\runs\\regression\\U11_sltu_zero_coincidence", "timeout_seconds": 30}
```

```json
{"argv": ["D:\\A_FPGA_Comp\\tools\\iverilog-13.0-msys2-ucrt64\\ucrt64\\bin\\vvp.exe", "-N", "-M-", "-MD:\\A_FPGA_Comp\\tools\\iverilog-13.0-msys2-ucrt64\\ucrt64\\lib\\ivl", "D:\\A_FPGA_Comp\\work\\system\\2026-10-23-memory-adapt-m1\\compile\\regression-base.vvp", "+case=V01_slti_equal_alias", "+inputs=D:/A_FPGA_Comp/work/icarus/2026-10-21-cpu-shifti-reject/cases/V01_slti_equal_alias"], "cwd": "D:\\A_FPGA_Comp\\work\\system\\2026-10-23-memory-adapt-m1\\runs\\regression\\V01_slti_equal_alias", "timeout_seconds": 30}
```

```json
{"argv": ["D:\\A_FPGA_Comp\\tools\\iverilog-13.0-msys2-ucrt64\\ucrt64\\bin\\vvp.exe", "-N", "-M-", "-MD:\\A_FPGA_Comp\\tools\\iverilog-13.0-msys2-ucrt64\\ucrt64\\lib\\ivl", "D:\\A_FPGA_Comp\\work\\system\\2026-10-23-memory-adapt-m1\\compile\\regression-base.vvp", "+case=V02_slti_negative_immediate", "+inputs=D:/A_FPGA_Comp/work/icarus/2026-10-21-cpu-shifti-reject/cases/V02_slti_negative_immediate"], "cwd": "D:\\A_FPGA_Comp\\work\\system\\2026-10-23-memory-adapt-m1\\runs\\regression\\V02_slti_negative_immediate", "timeout_seconds": 30}
```

```json
{"argv": ["D:\\A_FPGA_Comp\\tools\\iverilog-13.0-msys2-ucrt64\\ucrt64\\bin\\vvp.exe", "-N", "-M-", "-MD:\\A_FPGA_Comp\\tools\\iverilog-13.0-msys2-ucrt64\\ucrt64\\lib\\ivl", "D:\\A_FPGA_Comp\\work\\system\\2026-10-23-memory-adapt-m1\\compile\\regression-base.vvp", "+case=V03_slti_extremes", "+inputs=D:/A_FPGA_Comp/work/icarus/2026-10-21-cpu-shifti-reject/cases/V03_slti_extremes"], "cwd": "D:\\A_FPGA_Comp\\work\\system\\2026-10-23-memory-adapt-m1\\runs\\regression\\V03_slti_extremes", "timeout_seconds": 30}
```

```json
{"argv": ["D:\\A_FPGA_Comp\\tools\\iverilog-13.0-msys2-ucrt64\\ucrt64\\bin\\vvp.exe", "-N", "-M-", "-MD:\\A_FPGA_Comp\\tools\\iverilog-13.0-msys2-ucrt64\\ucrt64\\lib\\ivl", "D:\\A_FPGA_Comp\\work\\system\\2026-10-23-memory-adapt-m1\\compile\\regression-base.vvp", "+case=V04_slti_low_boundary", "+inputs=D:/A_FPGA_Comp/work/icarus/2026-10-21-cpu-shifti-reject/cases/V04_slti_low_boundary"], "cwd": "D:\\A_FPGA_Comp\\work\\system\\2026-10-23-memory-adapt-m1\\runs\\regression\\V04_slti_low_boundary", "timeout_seconds": 30}
```

```json
{"argv": ["D:\\A_FPGA_Comp\\tools\\iverilog-13.0-msys2-ucrt64\\ucrt64\\bin\\vvp.exe", "-N", "-M-", "-MD:\\A_FPGA_Comp\\tools\\iverilog-13.0-msys2-ucrt64\\ucrt64\\lib\\ivl", "D:\\A_FPGA_Comp\\work\\system\\2026-10-23-memory-adapt-m1\\compile\\regression-base.vvp", "+case=V05_slti_high_boundary", "+inputs=D:/A_FPGA_Comp/work/icarus/2026-10-21-cpu-shifti-reject/cases/V05_slti_high_boundary"], "cwd": "D:\\A_FPGA_Comp\\work\\system\\2026-10-23-memory-adapt-m1\\runs\\regression\\V05_slti_high_boundary", "timeout_seconds": 30}
```

```json
{"argv": ["D:\\A_FPGA_Comp\\tools\\iverilog-13.0-msys2-ucrt64\\ucrt64\\bin\\vvp.exe", "-N", "-M-", "-MD:\\A_FPGA_Comp\\tools\\iverilog-13.0-msys2-ucrt64\\ucrt64\\lib\\ivl", "D:\\A_FPGA_Comp\\work\\system\\2026-10-23-memory-adapt-m1\\compile\\regression-base.vvp", "+case=V06_slti_bypasses", "+inputs=D:/A_FPGA_Comp/work/icarus/2026-10-21-cpu-shifti-reject/cases/V06_slti_bypasses"], "cwd": "D:\\A_FPGA_Comp\\work\\system\\2026-10-23-memory-adapt-m1\\runs\\regression\\V06_slti_bypasses", "timeout_seconds": 30}
```

```json
{"argv": ["D:\\A_FPGA_Comp\\tools\\iverilog-13.0-msys2-ucrt64\\ucrt64\\bin\\vvp.exe", "-N", "-M-", "-MD:\\A_FPGA_Comp\\tools\\iverilog-13.0-msys2-ucrt64\\ucrt64\\lib\\ivl", "D:\\A_FPGA_Comp\\work\\system\\2026-10-23-memory-adapt-m1\\compile\\regression-base.vvp", "+case=V07_slti_load", "+inputs=D:/A_FPGA_Comp/work/icarus/2026-10-21-cpu-shifti-reject/cases/V07_slti_load"], "cwd": "D:\\A_FPGA_Comp\\work\\system\\2026-10-23-memory-adapt-m1\\runs\\regression\\V07_slti_load", "timeout_seconds": 30}
```

```json
{"argv": ["D:\\A_FPGA_Comp\\tools\\iverilog-13.0-msys2-ucrt64\\ucrt64\\bin\\vvp.exe", "-N", "-M-", "-MD:\\A_FPGA_Comp\\tools\\iverilog-13.0-msys2-ucrt64\\ucrt64\\lib\\ivl", "D:\\A_FPGA_Comp\\work\\system\\2026-10-23-memory-adapt-m1\\compile\\regression-base.vvp", "+case=V08_slti_false_rs2", "+inputs=D:/A_FPGA_Comp/work/icarus/2026-10-21-cpu-shifti-reject/cases/V08_slti_false_rs2"], "cwd": "D:\\A_FPGA_Comp\\work\\system\\2026-10-23-memory-adapt-m1\\runs\\regression\\V08_slti_false_rs2", "timeout_seconds": 30}
```

```json
{"argv": ["D:\\A_FPGA_Comp\\tools\\iverilog-13.0-msys2-ucrt64\\ucrt64\\bin\\vvp.exe", "-N", "-M-", "-MD:\\A_FPGA_Comp\\tools\\iverilog-13.0-msys2-ucrt64\\ucrt64\\lib\\ivl", "D:\\A_FPGA_Comp\\work\\system\\2026-10-23-memory-adapt-m1\\compile\\regression-base.vvp", "+case=V09_slti_x0_self_rd", "+inputs=D:/A_FPGA_Comp/work/icarus/2026-10-21-cpu-shifti-reject/cases/V09_slti_x0_self_rd"], "cwd": "D:\\A_FPGA_Comp\\work\\system\\2026-10-23-memory-adapt-m1\\runs\\regression\\V09_slti_x0_self_rd", "timeout_seconds": 30}
```

```json
{"argv": ["D:\\A_FPGA_Comp\\tools\\iverilog-13.0-msys2-ucrt64\\ucrt64\\bin\\vvp.exe", "-N", "-M-", "-MD:\\A_FPGA_Comp\\tools\\iverilog-13.0-msys2-ucrt64\\ucrt64\\lib\\ivl", "D:\\A_FPGA_Comp\\work\\system\\2026-10-23-memory-adapt-m1\\compile\\regression-base.vvp", "+case=V10_slti_load_x0", "+inputs=D:/A_FPGA_Comp/work/icarus/2026-10-21-cpu-shifti-reject/cases/V10_slti_load_x0"], "cwd": "D:\\A_FPGA_Comp\\work\\system\\2026-10-23-memory-adapt-m1\\runs\\regression\\V10_slti_load_x0", "timeout_seconds": 30}
```

```json
{"argv": ["D:\\A_FPGA_Comp\\tools\\iverilog-13.0-msys2-ucrt64\\ucrt64\\bin\\vvp.exe", "-N", "-M-", "-MD:\\A_FPGA_Comp\\tools\\iverilog-13.0-msys2-ucrt64\\ucrt64\\lib\\ivl", "D:\\A_FPGA_Comp\\work\\system\\2026-10-23-memory-adapt-m1\\compile\\regression-base.vvp", "+case=V11_slti_zero_coincidence", "+inputs=D:/A_FPGA_Comp/work/icarus/2026-10-21-cpu-shifti-reject/cases/V11_slti_zero_coincidence"], "cwd": "D:\\A_FPGA_Comp\\work\\system\\2026-10-23-memory-adapt-m1\\runs\\regression\\V11_slti_zero_coincidence", "timeout_seconds": 30}
```

```json
{"argv": ["D:\\A_FPGA_Comp\\tools\\iverilog-13.0-msys2-ucrt64\\ucrt64\\bin\\vvp.exe", "-N", "-M-", "-MD:\\A_FPGA_Comp\\tools\\iverilog-13.0-msys2-ucrt64\\ucrt64\\lib\\ivl", "D:\\A_FPGA_Comp\\work\\system\\2026-10-23-memory-adapt-m1\\compile\\regression-base.vvp", "+case=W01_sltiu_alias", "+inputs=D:/A_FPGA_Comp/work/icarus/2026-10-21-cpu-shifti-reject/cases/W01_sltiu_alias"], "cwd": "D:\\A_FPGA_Comp\\work\\system\\2026-10-23-memory-adapt-m1\\runs\\regression\\W01_sltiu_alias", "timeout_seconds": 30}
```

```json
{"argv": ["D:\\A_FPGA_Comp\\tools\\iverilog-13.0-msys2-ucrt64\\ucrt64\\bin\\vvp.exe", "-N", "-M-", "-MD:\\A_FPGA_Comp\\tools\\iverilog-13.0-msys2-ucrt64\\ucrt64\\lib\\ivl", "D:\\A_FPGA_Comp\\work\\system\\2026-10-23-memory-adapt-m1\\compile\\regression-base.vvp", "+case=W02_sltiu_signext_pair", "+inputs=D:/A_FPGA_Comp/work/icarus/2026-10-21-cpu-shifti-reject/cases/W02_sltiu_signext_pair"], "cwd": "D:\\A_FPGA_Comp\\work\\system\\2026-10-23-memory-adapt-m1\\runs\\regression\\W02_sltiu_signext_pair", "timeout_seconds": 30}
```

```json
{"argv": ["D:\\A_FPGA_Comp\\tools\\iverilog-13.0-msys2-ucrt64\\ucrt64\\bin\\vvp.exe", "-N", "-M-", "-MD:\\A_FPGA_Comp\\tools\\iverilog-13.0-msys2-ucrt64\\ucrt64\\lib\\ivl", "D:\\A_FPGA_Comp\\work\\system\\2026-10-23-memory-adapt-m1\\compile\\regression-base.vvp", "+case=W03_sltiu_negative_threshold", "+inputs=D:/A_FPGA_Comp/work/icarus/2026-10-21-cpu-shifti-reject/cases/W03_sltiu_negative_threshold"], "cwd": "D:\\A_FPGA_Comp\\work\\system\\2026-10-23-memory-adapt-m1\\runs\\regression\\W03_sltiu_negative_threshold", "timeout_seconds": 30}
```

```json
{"argv": ["D:\\A_FPGA_Comp\\tools\\iverilog-13.0-msys2-ucrt64\\ucrt64\\bin\\vvp.exe", "-N", "-M-", "-MD:\\A_FPGA_Comp\\tools\\iverilog-13.0-msys2-ucrt64\\ucrt64\\lib\\ivl", "D:\\A_FPGA_Comp\\work\\system\\2026-10-23-memory-adapt-m1\\compile\\regression-base.vvp", "+case=W04_sltiu_zero_detection", "+inputs=D:/A_FPGA_Comp/work/icarus/2026-10-21-cpu-shifti-reject/cases/W04_sltiu_zero_detection"], "cwd": "D:\\A_FPGA_Comp\\work\\system\\2026-10-23-memory-adapt-m1\\runs\\regression\\W04_sltiu_zero_detection", "timeout_seconds": 30}
```

```json
{"argv": ["D:\\A_FPGA_Comp\\tools\\iverilog-13.0-msys2-ucrt64\\ucrt64\\bin\\vvp.exe", "-N", "-M-", "-MD:\\A_FPGA_Comp\\tools\\iverilog-13.0-msys2-ucrt64\\ucrt64\\lib\\ivl", "D:\\A_FPGA_Comp\\work\\system\\2026-10-23-memory-adapt-m1\\compile\\regression-base.vvp", "+case=W05_sltiu_positive_boundary", "+inputs=D:/A_FPGA_Comp/work/icarus/2026-10-21-cpu-shifti-reject/cases/W05_sltiu_positive_boundary"], "cwd": "D:\\A_FPGA_Comp\\work\\system\\2026-10-23-memory-adapt-m1\\runs\\regression\\W05_sltiu_positive_boundary", "timeout_seconds": 30}
```

```json
{"argv": ["D:\\A_FPGA_Comp\\tools\\iverilog-13.0-msys2-ucrt64\\ucrt64\\bin\\vvp.exe", "-N", "-M-", "-MD:\\A_FPGA_Comp\\tools\\iverilog-13.0-msys2-ucrt64\\ucrt64\\lib\\ivl", "D:\\A_FPGA_Comp\\work\\system\\2026-10-23-memory-adapt-m1\\compile\\regression-base.vvp", "+case=W06_sltiu_bypasses", "+inputs=D:/A_FPGA_Comp/work/icarus/2026-10-21-cpu-shifti-reject/cases/W06_sltiu_bypasses"], "cwd": "D:\\A_FPGA_Comp\\work\\system\\2026-10-23-memory-adapt-m1\\runs\\regression\\W06_sltiu_bypasses", "timeout_seconds": 30}
```

```json
{"argv": ["D:\\A_FPGA_Comp\\tools\\iverilog-13.0-msys2-ucrt64\\ucrt64\\bin\\vvp.exe", "-N", "-M-", "-MD:\\A_FPGA_Comp\\tools\\iverilog-13.0-msys2-ucrt64\\ucrt64\\lib\\ivl", "D:\\A_FPGA_Comp\\work\\system\\2026-10-23-memory-adapt-m1\\compile\\regression-base.vvp", "+case=W07_sltiu_load", "+inputs=D:/A_FPGA_Comp/work/icarus/2026-10-21-cpu-shifti-reject/cases/W07_sltiu_load"], "cwd": "D:\\A_FPGA_Comp\\work\\system\\2026-10-23-memory-adapt-m1\\runs\\regression\\W07_sltiu_load", "timeout_seconds": 30}
```

```json
{"argv": ["D:\\A_FPGA_Comp\\tools\\iverilog-13.0-msys2-ucrt64\\ucrt64\\bin\\vvp.exe", "-N", "-M-", "-MD:\\A_FPGA_Comp\\tools\\iverilog-13.0-msys2-ucrt64\\ucrt64\\lib\\ivl", "D:\\A_FPGA_Comp\\work\\system\\2026-10-23-memory-adapt-m1\\compile\\regression-base.vvp", "+case=W08_sltiu_false_rs2", "+inputs=D:/A_FPGA_Comp/work/icarus/2026-10-21-cpu-shifti-reject/cases/W08_sltiu_false_rs2"], "cwd": "D:\\A_FPGA_Comp\\work\\system\\2026-10-23-memory-adapt-m1\\runs\\regression\\W08_sltiu_false_rs2", "timeout_seconds": 30}
```

```json
{"argv": ["D:\\A_FPGA_Comp\\tools\\iverilog-13.0-msys2-ucrt64\\ucrt64\\bin\\vvp.exe", "-N", "-M-", "-MD:\\A_FPGA_Comp\\tools\\iverilog-13.0-msys2-ucrt64\\ucrt64\\lib\\ivl", "D:\\A_FPGA_Comp\\work\\system\\2026-10-23-memory-adapt-m1\\compile\\regression-base.vvp", "+case=W09_sltiu_x0_self_rd", "+inputs=D:/A_FPGA_Comp/work/icarus/2026-10-21-cpu-shifti-reject/cases/W09_sltiu_x0_self_rd"], "cwd": "D:\\A_FPGA_Comp\\work\\system\\2026-10-23-memory-adapt-m1\\runs\\regression\\W09_sltiu_x0_self_rd", "timeout_seconds": 30}
```

```json
{"argv": ["D:\\A_FPGA_Comp\\tools\\iverilog-13.0-msys2-ucrt64\\ucrt64\\bin\\vvp.exe", "-N", "-M-", "-MD:\\A_FPGA_Comp\\tools\\iverilog-13.0-msys2-ucrt64\\ucrt64\\lib\\ivl", "D:\\A_FPGA_Comp\\work\\system\\2026-10-23-memory-adapt-m1\\compile\\regression-base.vvp", "+case=W10_sltiu_load_x0", "+inputs=D:/A_FPGA_Comp/work/icarus/2026-10-21-cpu-shifti-reject/cases/W10_sltiu_load_x0"], "cwd": "D:\\A_FPGA_Comp\\work\\system\\2026-10-23-memory-adapt-m1\\runs\\regression\\W10_sltiu_load_x0", "timeout_seconds": 30}
```

```json
{"argv": ["D:\\A_FPGA_Comp\\tools\\iverilog-13.0-msys2-ucrt64\\ucrt64\\bin\\vvp.exe", "-N", "-M-", "-MD:\\A_FPGA_Comp\\tools\\iverilog-13.0-msys2-ucrt64\\ucrt64\\lib\\ivl", "D:\\A_FPGA_Comp\\work\\system\\2026-10-23-memory-adapt-m1\\compile\\regression-base.vvp", "+case=W11_sltiu_zero_coincidence", "+inputs=D:/A_FPGA_Comp/work/icarus/2026-10-21-cpu-shifti-reject/cases/W11_sltiu_zero_coincidence"], "cwd": "D:\\A_FPGA_Comp\\work\\system\\2026-10-23-memory-adapt-m1\\runs\\regression\\W11_sltiu_zero_coincidence", "timeout_seconds": 30}
```

```json
{"argv": ["D:\\A_FPGA_Comp\\tools\\iverilog-13.0-msys2-ucrt64\\ucrt64\\bin\\vvp.exe", "-N", "-M-", "-MD:\\A_FPGA_Comp\\tools\\iverilog-13.0-msys2-ucrt64\\ucrt64\\lib\\ivl", "D:\\A_FPGA_Comp\\work\\system\\2026-10-23-memory-adapt-m1\\compile\\regression-base.vvp", "+case=Z01_blt_alias_positive", "+inputs=D:/A_FPGA_Comp/work/icarus/2026-10-21-cpu-shifti-reject/cases/Z01_blt_alias_positive"], "cwd": "D:\\A_FPGA_Comp\\work\\system\\2026-10-23-memory-adapt-m1\\runs\\regression\\Z01_blt_alias_positive", "timeout_seconds": 30}
```

```json
{"argv": ["D:\\A_FPGA_Comp\\tools\\iverilog-13.0-msys2-ucrt64\\ucrt64\\bin\\vvp.exe", "-N", "-M-", "-MD:\\A_FPGA_Comp\\tools\\iverilog-13.0-msys2-ucrt64\\ucrt64\\lib\\ivl", "D:\\A_FPGA_Comp\\work\\system\\2026-10-23-memory-adapt-m1\\compile\\regression-base.vvp", "+case=Z02_blt_alias_signed", "+inputs=D:/A_FPGA_Comp/work/icarus/2026-10-21-cpu-shifti-reject/cases/Z02_blt_alias_signed"], "cwd": "D:\\A_FPGA_Comp\\work\\system\\2026-10-23-memory-adapt-m1\\runs\\regression\\Z02_blt_alias_signed", "timeout_seconds": 30}
```

```json
{"argv": ["D:\\A_FPGA_Comp\\tools\\iverilog-13.0-msys2-ucrt64\\ucrt64\\bin\\vvp.exe", "-N", "-M-", "-MD:\\A_FPGA_Comp\\tools\\iverilog-13.0-msys2-ucrt64\\ucrt64\\lib\\ivl", "D:\\A_FPGA_Comp\\work\\system\\2026-10-23-memory-adapt-m1\\compile\\regression-base.vvp", "+case=Z03_blt_equal_positive", "+inputs=D:/A_FPGA_Comp/work/icarus/2026-10-21-cpu-shifti-reject/cases/Z03_blt_equal_positive"], "cwd": "D:\\A_FPGA_Comp\\work\\system\\2026-10-23-memory-adapt-m1\\runs\\regression\\Z03_blt_equal_positive", "timeout_seconds": 30}
```

```json
{"argv": ["D:\\A_FPGA_Comp\\tools\\iverilog-13.0-msys2-ucrt64\\ucrt64\\bin\\vvp.exe", "-N", "-M-", "-MD:\\A_FPGA_Comp\\tools\\iverilog-13.0-msys2-ucrt64\\ucrt64\\lib\\ivl", "D:\\A_FPGA_Comp\\work\\system\\2026-10-23-memory-adapt-m1\\compile\\regression-base.vvp", "+case=Z04_blt_equal_zero", "+inputs=D:/A_FPGA_Comp/work/icarus/2026-10-21-cpu-shifti-reject/cases/Z04_blt_equal_zero"], "cwd": "D:\\A_FPGA_Comp\\work\\system\\2026-10-23-memory-adapt-m1\\runs\\regression\\Z04_blt_equal_zero", "timeout_seconds": 30}
```

```json
{"argv": ["D:\\A_FPGA_Comp\\tools\\iverilog-13.0-msys2-ucrt64\\ucrt64\\bin\\vvp.exe", "-N", "-M-", "-MD:\\A_FPGA_Comp\\tools\\iverilog-13.0-msys2-ucrt64\\ucrt64\\lib\\ivl", "D:\\A_FPGA_Comp\\work\\system\\2026-10-23-memory-adapt-m1\\compile\\regression-base.vvp", "+case=Z05_blt_extreme", "+inputs=D:/A_FPGA_Comp/work/icarus/2026-10-21-cpu-shifti-reject/cases/Z05_blt_extreme"], "cwd": "D:\\A_FPGA_Comp\\work\\system\\2026-10-23-memory-adapt-m1\\runs\\regression\\Z05_blt_extreme", "timeout_seconds": 30}
```

```json
{"argv": ["D:\\A_FPGA_Comp\\tools\\iverilog-13.0-msys2-ucrt64\\ucrt64\\bin\\vvp.exe", "-N", "-M-", "-MD:\\A_FPGA_Comp\\tools\\iverilog-13.0-msys2-ucrt64\\ucrt64\\lib\\ivl", "D:\\A_FPGA_Comp\\work\\system\\2026-10-23-memory-adapt-m1\\compile\\regression-base.vvp", "+case=Z06_blt_extreme_reverse", "+inputs=D:/A_FPGA_Comp/work/icarus/2026-10-21-cpu-shifti-reject/cases/Z06_blt_extreme_reverse"], "cwd": "D:\\A_FPGA_Comp\\work\\system\\2026-10-23-memory-adapt-m1\\runs\\regression\\Z06_blt_extreme_reverse", "timeout_seconds": 30}
```

```json
{"argv": ["D:\\A_FPGA_Comp\\tools\\iverilog-13.0-msys2-ucrt64\\ucrt64\\bin\\vvp.exe", "-N", "-M-", "-MD:\\A_FPGA_Comp\\tools\\iverilog-13.0-msys2-ucrt64\\ucrt64\\lib\\ivl", "D:\\A_FPGA_Comp\\work\\system\\2026-10-23-memory-adapt-m1\\compile\\regression-base.vvp", "+case=Z07_blt_equal_min", "+inputs=D:/A_FPGA_Comp/work/icarus/2026-10-21-cpu-shifti-reject/cases/Z07_blt_equal_min"], "cwd": "D:\\A_FPGA_Comp\\work\\system\\2026-10-23-memory-adapt-m1\\runs\\regression\\Z07_blt_equal_min", "timeout_seconds": 30}
```

```json
{"argv": ["D:\\A_FPGA_Comp\\tools\\iverilog-13.0-msys2-ucrt64\\ucrt64\\bin\\vvp.exe", "-N", "-M-", "-MD:\\A_FPGA_Comp\\tools\\iverilog-13.0-msys2-ucrt64\\ucrt64\\lib\\ivl", "D:\\A_FPGA_Comp\\work\\system\\2026-10-23-memory-adapt-m1\\compile\\regression-base.vvp", "+case=Z08_blt_equal_max", "+inputs=D:/A_FPGA_Comp/work/icarus/2026-10-21-cpu-shifti-reject/cases/Z08_blt_equal_max"], "cwd": "D:\\A_FPGA_Comp\\work\\system\\2026-10-23-memory-adapt-m1\\runs\\regression\\Z08_blt_equal_max", "timeout_seconds": 30}
```

```json
{"argv": ["D:\\A_FPGA_Comp\\tools\\iverilog-13.0-msys2-ucrt64\\ucrt64\\bin\\vvp.exe", "-N", "-M-", "-MD:\\A_FPGA_Comp\\tools\\iverilog-13.0-msys2-ucrt64\\ucrt64\\lib\\ivl", "D:\\A_FPGA_Comp\\work\\system\\2026-10-23-memory-adapt-m1\\compile\\regression-base.vvp", "+case=Z09_blt_negative_order", "+inputs=D:/A_FPGA_Comp/work/icarus/2026-10-21-cpu-shifti-reject/cases/Z09_blt_negative_order"], "cwd": "D:\\A_FPGA_Comp\\work\\system\\2026-10-23-memory-adapt-m1\\runs\\regression\\Z09_blt_negative_order", "timeout_seconds": 30}
```

```json
{"argv": ["D:\\A_FPGA_Comp\\tools\\iverilog-13.0-msys2-ucrt64\\ucrt64\\bin\\vvp.exe", "-N", "-M-", "-MD:\\A_FPGA_Comp\\tools\\iverilog-13.0-msys2-ucrt64\\ucrt64\\lib\\ivl", "D:\\A_FPGA_Comp\\work\\system\\2026-10-23-memory-adapt-m1\\compile\\regression-base.vvp", "+case=Z10_blt_negative_reverse", "+inputs=D:/A_FPGA_Comp/work/icarus/2026-10-21-cpu-shifti-reject/cases/Z10_blt_negative_reverse"], "cwd": "D:\\A_FPGA_Comp\\work\\system\\2026-10-23-memory-adapt-m1\\runs\\regression\\Z10_blt_negative_reverse", "timeout_seconds": 30}
```

```json
{"argv": ["D:\\A_FPGA_Comp\\tools\\iverilog-13.0-msys2-ucrt64\\ucrt64\\bin\\vvp.exe", "-N", "-M-", "-MD:\\A_FPGA_Comp\\tools\\iverilog-13.0-msys2-ucrt64\\ucrt64\\lib\\ivl", "D:\\A_FPGA_Comp\\work\\system\\2026-10-23-memory-adapt-m1\\compile\\regression-base.vvp", "+case=Z11_blt_positive_less", "+inputs=D:/A_FPGA_Comp/work/icarus/2026-10-21-cpu-shifti-reject/cases/Z11_blt_positive_less"], "cwd": "D:\\A_FPGA_Comp\\work\\system\\2026-10-23-memory-adapt-m1\\runs\\regression\\Z11_blt_positive_less", "timeout_seconds": 30}
```

```json
{"argv": ["D:\\A_FPGA_Comp\\tools\\iverilog-13.0-msys2-ucrt64\\ucrt64\\bin\\vvp.exe", "-N", "-M-", "-MD:\\A_FPGA_Comp\\tools\\iverilog-13.0-msys2-ucrt64\\ucrt64\\lib\\ivl", "D:\\A_FPGA_Comp\\work\\system\\2026-10-23-memory-adapt-m1\\compile\\regression-base.vvp", "+case=Z12_blt_rs1_EX", "+inputs=D:/A_FPGA_Comp/work/icarus/2026-10-21-cpu-shifti-reject/cases/Z12_blt_rs1_EX"], "cwd": "D:\\A_FPGA_Comp\\work\\system\\2026-10-23-memory-adapt-m1\\runs\\regression\\Z12_blt_rs1_EX", "timeout_seconds": 30}
```

```json
{"argv": ["D:\\A_FPGA_Comp\\tools\\iverilog-13.0-msys2-ucrt64\\ucrt64\\bin\\vvp.exe", "-N", "-M-", "-MD:\\A_FPGA_Comp\\tools\\iverilog-13.0-msys2-ucrt64\\ucrt64\\lib\\ivl", "D:\\A_FPGA_Comp\\work\\system\\2026-10-23-memory-adapt-m1\\compile\\regression-base.vvp", "+case=Z13_blt_rs1_WBEX", "+inputs=D:/A_FPGA_Comp/work/icarus/2026-10-21-cpu-shifti-reject/cases/Z13_blt_rs1_WBEX"], "cwd": "D:\\A_FPGA_Comp\\work\\system\\2026-10-23-memory-adapt-m1\\runs\\regression\\Z13_blt_rs1_WBEX", "timeout_seconds": 30}
```

```json
{"argv": ["D:\\A_FPGA_Comp\\tools\\iverilog-13.0-msys2-ucrt64\\ucrt64\\bin\\vvp.exe", "-N", "-M-", "-MD:\\A_FPGA_Comp\\tools\\iverilog-13.0-msys2-ucrt64\\ucrt64\\lib\\ivl", "D:\\A_FPGA_Comp\\work\\system\\2026-10-23-memory-adapt-m1\\compile\\regression-base.vvp", "+case=Z14_blt_rs1_WBID", "+inputs=D:/A_FPGA_Comp/work/icarus/2026-10-21-cpu-shifti-reject/cases/Z14_blt_rs1_WBID"], "cwd": "D:\\A_FPGA_Comp\\work\\system\\2026-10-23-memory-adapt-m1\\runs\\regression\\Z14_blt_rs1_WBID", "timeout_seconds": 30}
```

```json
{"argv": ["D:\\A_FPGA_Comp\\tools\\iverilog-13.0-msys2-ucrt64\\ucrt64\\bin\\vvp.exe", "-N", "-M-", "-MD:\\A_FPGA_Comp\\tools\\iverilog-13.0-msys2-ucrt64\\ucrt64\\lib\\ivl", "D:\\A_FPGA_Comp\\work\\system\\2026-10-23-memory-adapt-m1\\compile\\regression-base.vvp", "+case=Z15_blt_rs2_EX", "+inputs=D:/A_FPGA_Comp/work/icarus/2026-10-21-cpu-shifti-reject/cases/Z15_blt_rs2_EX"], "cwd": "D:\\A_FPGA_Comp\\work\\system\\2026-10-23-memory-adapt-m1\\runs\\regression\\Z15_blt_rs2_EX", "timeout_seconds": 30}
```

```json
{"argv": ["D:\\A_FPGA_Comp\\tools\\iverilog-13.0-msys2-ucrt64\\ucrt64\\bin\\vvp.exe", "-N", "-M-", "-MD:\\A_FPGA_Comp\\tools\\iverilog-13.0-msys2-ucrt64\\ucrt64\\lib\\ivl", "D:\\A_FPGA_Comp\\work\\system\\2026-10-23-memory-adapt-m1\\compile\\regression-base.vvp", "+case=Z16_blt_rs2_WBEX", "+inputs=D:/A_FPGA_Comp/work/icarus/2026-10-21-cpu-shifti-reject/cases/Z16_blt_rs2_WBEX"], "cwd": "D:\\A_FPGA_Comp\\work\\system\\2026-10-23-memory-adapt-m1\\runs\\regression\\Z16_blt_rs2_WBEX", "timeout_seconds": 30}
```

```json
{"argv": ["D:\\A_FPGA_Comp\\tools\\iverilog-13.0-msys2-ucrt64\\ucrt64\\bin\\vvp.exe", "-N", "-M-", "-MD:\\A_FPGA_Comp\\tools\\iverilog-13.0-msys2-ucrt64\\ucrt64\\lib\\ivl", "D:\\A_FPGA_Comp\\work\\system\\2026-10-23-memory-adapt-m1\\compile\\regression-base.vvp", "+case=Z17_blt_rs2_WBID", "+inputs=D:/A_FPGA_Comp/work/icarus/2026-10-21-cpu-shifti-reject/cases/Z17_blt_rs2_WBID"], "cwd": "D:\\A_FPGA_Comp\\work\\system\\2026-10-23-memory-adapt-m1\\runs\\regression\\Z17_blt_rs2_WBID", "timeout_seconds": 30}
```

```json
{"argv": ["D:\\A_FPGA_Comp\\tools\\iverilog-13.0-msys2-ucrt64\\ucrt64\\bin\\vvp.exe", "-N", "-M-", "-MD:\\A_FPGA_Comp\\tools\\iverilog-13.0-msys2-ucrt64\\ucrt64\\lib\\ivl", "D:\\A_FPGA_Comp\\work\\system\\2026-10-23-memory-adapt-m1\\compile\\regression-base.vvp", "+case=Z18_blt_latest_priority", "+inputs=D:/A_FPGA_Comp/work/icarus/2026-10-21-cpu-shifti-reject/cases/Z18_blt_latest_priority"], "cwd": "D:\\A_FPGA_Comp\\work\\system\\2026-10-23-memory-adapt-m1\\runs\\regression\\Z18_blt_latest_priority", "timeout_seconds": 30}
```

```json
{"argv": ["D:\\A_FPGA_Comp\\tools\\iverilog-13.0-msys2-ucrt64\\ucrt64\\bin\\vvp.exe", "-N", "-M-", "-MD:\\A_FPGA_Comp\\tools\\iverilog-13.0-msys2-ucrt64\\ucrt64\\lib\\ivl", "D:\\A_FPGA_Comp\\work\\system\\2026-10-23-memory-adapt-m1\\compile\\regression-base.vvp", "+case=Z19_blt_load_rs1", "+inputs=D:/A_FPGA_Comp/work/icarus/2026-10-21-cpu-shifti-reject/cases/Z19_blt_load_rs1"], "cwd": "D:\\A_FPGA_Comp\\work\\system\\2026-10-23-memory-adapt-m1\\runs\\regression\\Z19_blt_load_rs1", "timeout_seconds": 30}
```

```json
{"argv": ["D:\\A_FPGA_Comp\\tools\\iverilog-13.0-msys2-ucrt64\\ucrt64\\bin\\vvp.exe", "-N", "-M-", "-MD:\\A_FPGA_Comp\\tools\\iverilog-13.0-msys2-ucrt64\\ucrt64\\lib\\ivl", "D:\\A_FPGA_Comp\\work\\system\\2026-10-23-memory-adapt-m1\\compile\\regression-base.vvp", "+case=Z20_blt_load_rs2", "+inputs=D:/A_FPGA_Comp/work/icarus/2026-10-21-cpu-shifti-reject/cases/Z20_blt_load_rs2"], "cwd": "D:\\A_FPGA_Comp\\work\\system\\2026-10-23-memory-adapt-m1\\runs\\regression\\Z20_blt_load_rs2", "timeout_seconds": 30}
```

```json
{"argv": ["D:\\A_FPGA_Comp\\tools\\iverilog-13.0-msys2-ucrt64\\ucrt64\\bin\\vvp.exe", "-N", "-M-", "-MD:\\A_FPGA_Comp\\tools\\iverilog-13.0-msys2-ucrt64\\ucrt64\\lib\\ivl", "D:\\A_FPGA_Comp\\work\\system\\2026-10-23-memory-adapt-m1\\compile\\regression-base.vvp", "+case=Z21_blt_load_same_source", "+inputs=D:/A_FPGA_Comp/work/icarus/2026-10-21-cpu-shifti-reject/cases/Z21_blt_load_same_source"], "cwd": "D:\\A_FPGA_Comp\\work\\system\\2026-10-23-memory-adapt-m1\\runs\\regression\\Z21_blt_load_same_source", "timeout_seconds": 30}
```

```json
{"argv": ["D:\\A_FPGA_Comp\\tools\\iverilog-13.0-msys2-ucrt64\\ucrt64\\bin\\vvp.exe", "-N", "-M-", "-MD:\\A_FPGA_Comp\\tools\\iverilog-13.0-msys2-ucrt64\\ucrt64\\lib\\ivl", "D:\\A_FPGA_Comp\\work\\system\\2026-10-23-memory-adapt-m1\\compile\\regression-base.vvp", "+case=Z22_blt_load_x0", "+inputs=D:/A_FPGA_Comp/work/icarus/2026-10-21-cpu-shifti-reject/cases/Z22_blt_load_x0"], "cwd": "D:\\A_FPGA_Comp\\work\\system\\2026-10-23-memory-adapt-m1\\runs\\regression\\Z22_blt_load_x0", "timeout_seconds": 30}
```

```json
{"argv": ["D:\\A_FPGA_Comp\\tools\\iverilog-13.0-msys2-ucrt64\\ucrt64\\bin\\vvp.exe", "-N", "-M-", "-MD:\\A_FPGA_Comp\\tools\\iverilog-13.0-msys2-ucrt64\\ucrt64\\lib\\ivl", "D:\\A_FPGA_Comp\\work\\system\\2026-10-23-memory-adapt-m1\\compile\\regression-base.vvp", "+case=Z23_blt_backward_loop", "+inputs=D:/A_FPGA_Comp/work/icarus/2026-10-21-cpu-shifti-reject/cases/Z23_blt_backward_loop"], "cwd": "D:\\A_FPGA_Comp\\work\\system\\2026-10-23-memory-adapt-m1\\runs\\regression\\Z23_blt_backward_loop", "timeout_seconds": 30}
```

```json
{"argv": ["D:\\A_FPGA_Comp\\tools\\iverilog-13.0-msys2-ucrt64\\ucrt64\\bin\\vvp.exe", "-N", "-M-", "-MD:\\A_FPGA_Comp\\tools\\iverilog-13.0-msys2-ucrt64\\ucrt64\\lib\\ivl", "D:\\A_FPGA_Comp\\work\\system\\2026-10-23-memory-adapt-m1\\compile\\regression-base.vvp", "+case=Z24_blt_plus4", "+inputs=D:/A_FPGA_Comp/work/icarus/2026-10-21-cpu-shifti-reject/cases/Z24_blt_plus4"], "cwd": "D:\\A_FPGA_Comp\\work\\system\\2026-10-23-memory-adapt-m1\\runs\\regression\\Z24_blt_plus4", "timeout_seconds": 30}
```

```json
{"argv": ["D:\\A_FPGA_Comp\\tools\\iverilog-13.0-msys2-ucrt64\\ucrt64\\bin\\vvp.exe", "-N", "-M-", "-MD:\\A_FPGA_Comp\\tools\\iverilog-13.0-msys2-ucrt64\\ucrt64\\lib\\ivl", "D:\\A_FPGA_Comp\\work\\system\\2026-10-23-memory-adapt-m1\\compile\\regression-base.vvp", "+case=Z25_blt_zero_offset", "+inputs=D:/A_FPGA_Comp/work/icarus/2026-10-21-cpu-shifti-reject/cases/Z25_blt_zero_offset"], "cwd": "D:\\A_FPGA_Comp\\work\\system\\2026-10-23-memory-adapt-m1\\runs\\regression\\Z25_blt_zero_offset", "timeout_seconds": 30}
```

```json
{"argv": ["D:\\A_FPGA_Comp\\tools\\iverilog-13.0-msys2-ucrt64\\ucrt64\\bin\\vvp.exe", "-N", "-M-", "-MD:\\A_FPGA_Comp\\tools\\iverilog-13.0-msys2-ucrt64\\ucrt64\\lib\\ivl", "D:\\A_FPGA_Comp\\work\\system\\2026-10-23-memory-adapt-m1\\compile\\regression-base.vvp", "+case=Z26_blt_squash_jump_load", "+inputs=D:/A_FPGA_Comp/work/icarus/2026-10-21-cpu-shifti-reject/cases/Z26_blt_squash_jump_load"], "cwd": "D:\\A_FPGA_Comp\\work\\system\\2026-10-23-memory-adapt-m1\\runs\\regression\\Z26_blt_squash_jump_load", "timeout_seconds": 30}
```

```json
{"argv": ["D:\\A_FPGA_Comp\\tools\\iverilog-13.0-msys2-ucrt64\\ucrt64\\bin\\vvp.exe", "-N", "-M-", "-MD:\\A_FPGA_Comp\\tools\\iverilog-13.0-msys2-ucrt64\\ucrt64\\lib\\ivl", "D:\\A_FPGA_Comp\\work\\system\\2026-10-23-memory-adapt-m1\\compile\\regression-base.vvp", "+case=G01_bge_positive", "+inputs=D:/A_FPGA_Comp/work/icarus/2026-10-21-cpu-shifti-reject/cases/G01_bge_positive"], "cwd": "D:\\A_FPGA_Comp\\work\\system\\2026-10-23-memory-adapt-m1\\runs\\regression\\G01_bge_positive", "timeout_seconds": 30}
```

```json
{"argv": ["D:\\A_FPGA_Comp\\tools\\iverilog-13.0-msys2-ucrt64\\ucrt64\\bin\\vvp.exe", "-N", "-M-", "-MD:\\A_FPGA_Comp\\tools\\iverilog-13.0-msys2-ucrt64\\ucrt64\\lib\\ivl", "D:\\A_FPGA_Comp\\work\\system\\2026-10-23-memory-adapt-m1\\compile\\regression-base.vvp", "+case=G02_bge_signed_false", "+inputs=D:/A_FPGA_Comp/work/icarus/2026-10-21-cpu-shifti-reject/cases/G02_bge_signed_false"], "cwd": "D:\\A_FPGA_Comp\\work\\system\\2026-10-23-memory-adapt-m1\\runs\\regression\\G02_bge_signed_false", "timeout_seconds": 30}
```

```json
{"argv": ["D:\\A_FPGA_Comp\\tools\\iverilog-13.0-msys2-ucrt64\\ucrt64\\bin\\vvp.exe", "-N", "-M-", "-MD:\\A_FPGA_Comp\\tools\\iverilog-13.0-msys2-ucrt64\\ucrt64\\lib\\ivl", "D:\\A_FPGA_Comp\\work\\system\\2026-10-23-memory-adapt-m1\\compile\\regression-base.vvp", "+case=G03_bge_equal_positive", "+inputs=D:/A_FPGA_Comp/work/icarus/2026-10-21-cpu-shifti-reject/cases/G03_bge_equal_positive"], "cwd": "D:\\A_FPGA_Comp\\work\\system\\2026-10-23-memory-adapt-m1\\runs\\regression\\G03_bge_equal_positive", "timeout_seconds": 30}
```

```json
{"argv": ["D:\\A_FPGA_Comp\\tools\\iverilog-13.0-msys2-ucrt64\\ucrt64\\bin\\vvp.exe", "-N", "-M-", "-MD:\\A_FPGA_Comp\\tools\\iverilog-13.0-msys2-ucrt64\\ucrt64\\lib\\ivl", "D:\\A_FPGA_Comp\\work\\system\\2026-10-23-memory-adapt-m1\\compile\\regression-base.vvp", "+case=G04_bge_equal_zero", "+inputs=D:/A_FPGA_Comp/work/icarus/2026-10-21-cpu-shifti-reject/cases/G04_bge_equal_zero"], "cwd": "D:\\A_FPGA_Comp\\work\\system\\2026-10-23-memory-adapt-m1\\runs\\regression\\G04_bge_equal_zero", "timeout_seconds": 30}
```

```json
{"argv": ["D:\\A_FPGA_Comp\\tools\\iverilog-13.0-msys2-ucrt64\\ucrt64\\bin\\vvp.exe", "-N", "-M-", "-MD:\\A_FPGA_Comp\\tools\\iverilog-13.0-msys2-ucrt64\\ucrt64\\lib\\ivl", "D:\\A_FPGA_Comp\\work\\system\\2026-10-23-memory-adapt-m1\\compile\\regression-base.vvp", "+case=G05_bge_extreme", "+inputs=D:/A_FPGA_Comp/work/icarus/2026-10-21-cpu-shifti-reject/cases/G05_bge_extreme"], "cwd": "D:\\A_FPGA_Comp\\work\\system\\2026-10-23-memory-adapt-m1\\runs\\regression\\G05_bge_extreme", "timeout_seconds": 30}
```

```json
{"argv": ["D:\\A_FPGA_Comp\\tools\\iverilog-13.0-msys2-ucrt64\\ucrt64\\bin\\vvp.exe", "-N", "-M-", "-MD:\\A_FPGA_Comp\\tools\\iverilog-13.0-msys2-ucrt64\\ucrt64\\lib\\ivl", "D:\\A_FPGA_Comp\\work\\system\\2026-10-23-memory-adapt-m1\\compile\\regression-base.vvp", "+case=G06_bge_extreme_reverse", "+inputs=D:/A_FPGA_Comp/work/icarus/2026-10-21-cpu-shifti-reject/cases/G06_bge_extreme_reverse"], "cwd": "D:\\A_FPGA_Comp\\work\\system\\2026-10-23-memory-adapt-m1\\runs\\regression\\G06_bge_extreme_reverse", "timeout_seconds": 30}
```

```json
{"argv": ["D:\\A_FPGA_Comp\\tools\\iverilog-13.0-msys2-ucrt64\\ucrt64\\bin\\vvp.exe", "-N", "-M-", "-MD:\\A_FPGA_Comp\\tools\\iverilog-13.0-msys2-ucrt64\\ucrt64\\lib\\ivl", "D:\\A_FPGA_Comp\\work\\system\\2026-10-23-memory-adapt-m1\\compile\\regression-base.vvp", "+case=G07_bge_equal_min", "+inputs=D:/A_FPGA_Comp/work/icarus/2026-10-21-cpu-shifti-reject/cases/G07_bge_equal_min"], "cwd": "D:\\A_FPGA_Comp\\work\\system\\2026-10-23-memory-adapt-m1\\runs\\regression\\G07_bge_equal_min", "timeout_seconds": 30}
```

```json
{"argv": ["D:\\A_FPGA_Comp\\tools\\iverilog-13.0-msys2-ucrt64\\ucrt64\\bin\\vvp.exe", "-N", "-M-", "-MD:\\A_FPGA_Comp\\tools\\iverilog-13.0-msys2-ucrt64\\ucrt64\\lib\\ivl", "D:\\A_FPGA_Comp\\work\\system\\2026-10-23-memory-adapt-m1\\compile\\regression-base.vvp", "+case=G08_bge_equal_max", "+inputs=D:/A_FPGA_Comp/work/icarus/2026-10-21-cpu-shifti-reject/cases/G08_bge_equal_max"], "cwd": "D:\\A_FPGA_Comp\\work\\system\\2026-10-23-memory-adapt-m1\\runs\\regression\\G08_bge_equal_max", "timeout_seconds": 30}
```

```json
{"argv": ["D:\\A_FPGA_Comp\\tools\\iverilog-13.0-msys2-ucrt64\\ucrt64\\bin\\vvp.exe", "-N", "-M-", "-MD:\\A_FPGA_Comp\\tools\\iverilog-13.0-msys2-ucrt64\\ucrt64\\lib\\ivl", "D:\\A_FPGA_Comp\\work\\system\\2026-10-23-memory-adapt-m1\\compile\\regression-base.vvp", "+case=G09_bge_negative_order", "+inputs=D:/A_FPGA_Comp/work/icarus/2026-10-21-cpu-shifti-reject/cases/G09_bge_negative_order"], "cwd": "D:\\A_FPGA_Comp\\work\\system\\2026-10-23-memory-adapt-m1\\runs\\regression\\G09_bge_negative_order", "timeout_seconds": 30}
```

```json
{"argv": ["D:\\A_FPGA_Comp\\tools\\iverilog-13.0-msys2-ucrt64\\ucrt64\\bin\\vvp.exe", "-N", "-M-", "-MD:\\A_FPGA_Comp\\tools\\iverilog-13.0-msys2-ucrt64\\ucrt64\\lib\\ivl", "D:\\A_FPGA_Comp\\work\\system\\2026-10-23-memory-adapt-m1\\compile\\regression-base.vvp", "+case=G10_bge_negative_reverse", "+inputs=D:/A_FPGA_Comp/work/icarus/2026-10-21-cpu-shifti-reject/cases/G10_bge_negative_reverse"], "cwd": "D:\\A_FPGA_Comp\\work\\system\\2026-10-23-memory-adapt-m1\\runs\\regression\\G10_bge_negative_reverse", "timeout_seconds": 30}
```

```json
{"argv": ["D:\\A_FPGA_Comp\\tools\\iverilog-13.0-msys2-ucrt64\\ucrt64\\bin\\vvp.exe", "-N", "-M-", "-MD:\\A_FPGA_Comp\\tools\\iverilog-13.0-msys2-ucrt64\\ucrt64\\lib\\ivl", "D:\\A_FPGA_Comp\\work\\system\\2026-10-23-memory-adapt-m1\\compile\\regression-base.vvp", "+case=G11_bge_signed_true", "+inputs=D:/A_FPGA_Comp/work/icarus/2026-10-21-cpu-shifti-reject/cases/G11_bge_signed_true"], "cwd": "D:\\A_FPGA_Comp\\work\\system\\2026-10-23-memory-adapt-m1\\runs\\regression\\G11_bge_signed_true", "timeout_seconds": 30}
```

```json
{"argv": ["D:\\A_FPGA_Comp\\tools\\iverilog-13.0-msys2-ucrt64\\ucrt64\\bin\\vvp.exe", "-N", "-M-", "-MD:\\A_FPGA_Comp\\tools\\iverilog-13.0-msys2-ucrt64\\ucrt64\\lib\\ivl", "D:\\A_FPGA_Comp\\work\\system\\2026-10-23-memory-adapt-m1\\compile\\regression-base.vvp", "+case=G12_bge_rs1_EX", "+inputs=D:/A_FPGA_Comp/work/icarus/2026-10-21-cpu-shifti-reject/cases/G12_bge_rs1_EX"], "cwd": "D:\\A_FPGA_Comp\\work\\system\\2026-10-23-memory-adapt-m1\\runs\\regression\\G12_bge_rs1_EX", "timeout_seconds": 30}
```

```json
{"argv": ["D:\\A_FPGA_Comp\\tools\\iverilog-13.0-msys2-ucrt64\\ucrt64\\bin\\vvp.exe", "-N", "-M-", "-MD:\\A_FPGA_Comp\\tools\\iverilog-13.0-msys2-ucrt64\\ucrt64\\lib\\ivl", "D:\\A_FPGA_Comp\\work\\system\\2026-10-23-memory-adapt-m1\\compile\\regression-base.vvp", "+case=G13_bge_rs1_WBEX", "+inputs=D:/A_FPGA_Comp/work/icarus/2026-10-21-cpu-shifti-reject/cases/G13_bge_rs1_WBEX"], "cwd": "D:\\A_FPGA_Comp\\work\\system\\2026-10-23-memory-adapt-m1\\runs\\regression\\G13_bge_rs1_WBEX", "timeout_seconds": 30}
```

```json
{"argv": ["D:\\A_FPGA_Comp\\tools\\iverilog-13.0-msys2-ucrt64\\ucrt64\\bin\\vvp.exe", "-N", "-M-", "-MD:\\A_FPGA_Comp\\tools\\iverilog-13.0-msys2-ucrt64\\ucrt64\\lib\\ivl", "D:\\A_FPGA_Comp\\work\\system\\2026-10-23-memory-adapt-m1\\compile\\regression-base.vvp", "+case=G14_bge_rs1_WBID", "+inputs=D:/A_FPGA_Comp/work/icarus/2026-10-21-cpu-shifti-reject/cases/G14_bge_rs1_WBID"], "cwd": "D:\\A_FPGA_Comp\\work\\system\\2026-10-23-memory-adapt-m1\\runs\\regression\\G14_bge_rs1_WBID", "timeout_seconds": 30}
```

```json
{"argv": ["D:\\A_FPGA_Comp\\tools\\iverilog-13.0-msys2-ucrt64\\ucrt64\\bin\\vvp.exe", "-N", "-M-", "-MD:\\A_FPGA_Comp\\tools\\iverilog-13.0-msys2-ucrt64\\ucrt64\\lib\\ivl", "D:\\A_FPGA_Comp\\work\\system\\2026-10-23-memory-adapt-m1\\compile\\regression-base.vvp", "+case=G15_bge_rs2_EX", "+inputs=D:/A_FPGA_Comp/work/icarus/2026-10-21-cpu-shifti-reject/cases/G15_bge_rs2_EX"], "cwd": "D:\\A_FPGA_Comp\\work\\system\\2026-10-23-memory-adapt-m1\\runs\\regression\\G15_bge_rs2_EX", "timeout_seconds": 30}
```

```json
{"argv": ["D:\\A_FPGA_Comp\\tools\\iverilog-13.0-msys2-ucrt64\\ucrt64\\bin\\vvp.exe", "-N", "-M-", "-MD:\\A_FPGA_Comp\\tools\\iverilog-13.0-msys2-ucrt64\\ucrt64\\lib\\ivl", "D:\\A_FPGA_Comp\\work\\system\\2026-10-23-memory-adapt-m1\\compile\\regression-base.vvp", "+case=G16_bge_rs2_WBEX", "+inputs=D:/A_FPGA_Comp/work/icarus/2026-10-21-cpu-shifti-reject/cases/G16_bge_rs2_WBEX"], "cwd": "D:\\A_FPGA_Comp\\work\\system\\2026-10-23-memory-adapt-m1\\runs\\regression\\G16_bge_rs2_WBEX", "timeout_seconds": 30}
```

```json
{"argv": ["D:\\A_FPGA_Comp\\tools\\iverilog-13.0-msys2-ucrt64\\ucrt64\\bin\\vvp.exe", "-N", "-M-", "-MD:\\A_FPGA_Comp\\tools\\iverilog-13.0-msys2-ucrt64\\ucrt64\\lib\\ivl", "D:\\A_FPGA_Comp\\work\\system\\2026-10-23-memory-adapt-m1\\compile\\regression-base.vvp", "+case=G17_bge_rs2_WBID", "+inputs=D:/A_FPGA_Comp/work/icarus/2026-10-21-cpu-shifti-reject/cases/G17_bge_rs2_WBID"], "cwd": "D:\\A_FPGA_Comp\\work\\system\\2026-10-23-memory-adapt-m1\\runs\\regression\\G17_bge_rs2_WBID", "timeout_seconds": 30}
```

```json
{"argv": ["D:\\A_FPGA_Comp\\tools\\iverilog-13.0-msys2-ucrt64\\ucrt64\\bin\\vvp.exe", "-N", "-M-", "-MD:\\A_FPGA_Comp\\tools\\iverilog-13.0-msys2-ucrt64\\ucrt64\\lib\\ivl", "D:\\A_FPGA_Comp\\work\\system\\2026-10-23-memory-adapt-m1\\compile\\regression-base.vvp", "+case=G18_bge_latest_priority", "+inputs=D:/A_FPGA_Comp/work/icarus/2026-10-21-cpu-shifti-reject/cases/G18_bge_latest_priority"], "cwd": "D:\\A_FPGA_Comp\\work\\system\\2026-10-23-memory-adapt-m1\\runs\\regression\\G18_bge_latest_priority", "timeout_seconds": 30}
```
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
