minzhetang/pangu-riscv-soc/reports/verification/2026-10-29-debug-connectivity-m1.md

# Design Editor只读检查：部分完成，连接验收未通过

2026-10-29，D182批准A-DEBUG-CONNECTIVITY-M1/1.0.0；结果F173/D183。**本轮真实打开并载入R4后布局副本，但未取得完整数据输入连接证据。不是CPU设计测试失败，也不能记连接检查PASS。**

## 实际执行和保护

- 一次安装版`D:/PDS/PDS_2022.2-SP6.4/bin/de.exe`，没有重开GUI。3个同字节输入为board_top_pnr.adf、board_top_rtp.adf、rtr.db，SHA及原路径见COPY_RECEIPT。版本检查保持勾选，未编辑数据库或保存布局。
- 界面实际显示PDS2022.2-SP6.4、目标PG2L100H-6FBG676；截图13可见“Loading wires finished / Import Design DB finished”，随后能查看真实布线与采样单元。它只证明已载入，不能代替完整连接、调试可靠性或硬件验证。
- 原监督器首次EnumWindows返回FALSE，启动期控制脚本错误退出；当时未作GUI动作。只读检查原PID/程序路径和当前唯一主窗后，在原期限内接管**同一进程**，未启动第二次DE或重置计时。原错误保留，不能当原监督器正常运行。
- GUI到590.094秒保护截止，原生退出码1；GUI_RESULT留存瞬时窗口条目。后续OpenProcess原PID明确返回ERROR_INVALID_PARAMETER(87)，确认原进程已不存在；不将首次枚举失败或最后瞬时窗口当正常枚举0。没有通过非零rc判定验收成功。
- 260保护条目和3份数据库副本后验SHA同，阶段执行/后验检查712.360秒，低于1200秒。GUI内1项help，2次source适配尝试；0用户RTL编译、PDS构建、新DUT或硬件。DE载入时自身提示编译verification operator library，是其内部载入步骤，不是执行了CPU编译/仿真。

## 真正观察到什么

|对象|本轮新证据|结论边界|
|---|---|---|
|R4后布局设计|实际载入成功，器件视图及网表树出现|不是仅文件存在，也不是新生成DB|
|stopped网络|截图18/21显示网络存在；展开后有Q1:CLMS_135_943物理根和SRB/负载分支|可确认该网络不是在后布局完全不存在；尚未把物理驱动还原为逻辑实例和输出脚|
|136号一级采样单元|截图25/28/30按`*trig0_d1*136*`定位单元，展开INPUT/CLK/D，D脚可高亮实际布线|不能仅凭高亮几何相似判定它等于stopped，完整D→net→driver未取得|
|137–139/34/38|没有完成实际输入驱动检查|明确未验证，不因FIC正确或140个CLK通过补写PASS|
|4条Critical|本轮没有完成逐条原生路径/负载取证|F172的只读分析和开放状态保持，不新增豁免|

完整连接闭合数量为**0/140**；这是严格验收口径，不否认上述有限原生观察。前插核源别名、原生FIC和全部采样CLK依据仍保留，但不足以关闭后布局输入驱动问题。

## 采集适配问题和责任

- 原Inserter适配器发送`source {path}`，本版DE把大括号当文件名字符，返回Flow-0048。去括号后能读取同一只读脚本，但第一条标准Tcl`set`返回Flow-0161；说明**本版DE此控制台入口不接受该标准Tcl脚本**，不能推成PDS所有工具都不支持Tcl。
- 单次`help`未取得可留存的命令帮助结果。原监督器退出后标准输出采集也不完整，不能把空log当“没有报错”。本轮命令/错误主要通过本地截图和动作记录核对。
- Find框的WM_CHAR退格无效，造成一次旧词拼接；截图24保留。随后改用已视觉确认的Clear按钮，截图25显示正确新搜索词。这不属于DUT或ISA错误。
- 尝试浏览器分隔条消息拖动没有扩大可视区，未修改设计。限额内未取得可靠批量接口，不继续猜命令、反复GUI或降验收标准。主要不足是A的工具采集适配预检，不归咎CPU、B、许可证或硬件。

## 更合适的下一步：原生后布局文字网表导出

已回查并视觉核对安装版PDS用户手册V1.5：实际PDF148页（印刷147，§3.7）明确Generate Netlist输出后布局sim.v及SDF；实际252页（印刷251，§9.11/表9-11）列出`gen_netlist -help`、`-func_sim_only`等。这是可用于逐脚解析的官方输出路径，不能把该功能文档当本机已成功导出。

推荐**A-POSTROUTE-NETLIST-EXPORT-M0/1.0.0**：新独立副本，最多一次PDS命令行进程，先确认本版只读载入已有DB和导出接口，再只导出连接文字网表（若可独立执行）；不仿真，不重综合/Map/PnR/位流，不用`-run`自动追跑前置。如果接口要求重新实现或无法确认安全语义，停止并交付确切诊断，不扩范围。

本轮D182只批准DE GUI，明确不含PDS CLI，因此上述新工具入口**待单独批准**。不再推荐未经充分准备的同样GUI重复操作。导出后应逐笔核D引脚/网络/逻辑驱动和140路顺序，尤其停止/错误源；即使通过，也不自动解决4条布线Critical、CDC或硬件准入。

## 证据入口与安全

`work/analysis/2026-10-29-debug-connectivity-m1/`：APPROVAL、EXE_RECEIPT、COPY_RECEIPT、ATTACH_RECEIPT、GUI_ACTIONS、GUI_RESULT、EXIT_RECHECK、POSTFLIGHT、OBSERVATIONS、SUMMARY及本地截图/适配脚本。初期控制器异常和全部原始错误保留，不覆盖历史。

未重跑CPU/CoreMark；未起PDS硬件服务器、Debugger或扫描设备/JTAG；未上电、下载/操作Flash；SCBV/供电/跳线/温控不变，over_temp STOP保持。没有本轮新的许可证余期证据，不把10/28提示6天当10/29新查询。专有DB、完整网表、图片、程序、原始日志和私人标识不入Git；只审查本地普通脚本/摘要/报告，不绕过既有系统外发拒绝。
