minzhetang/pangu-riscv-soc/snapshots/2026-11-01-paused-technical-review/reports/2026-11-01-uart-direct-nodebug-closure.md

# UART直连对照与无ILA CoreMark8完整输出有限验收

日期2026-11-01（北京时间），F242/F243、D269–D271。用户报告UART先前经扩展坞，现已直连，并授权推进当前外部输出阶段；D267集中阶段权限保持。未安装驱动/软件、未重编CPU/程序/位流、未改RTL/TB、引脚/时钟、SCBV、启动、供电或芯片保护，无Flash、无Git提交推送。

## 结论

**当前已打通：固定CPU/SoC在FPGA运行CoreMark8 → 物理UART → Windows原始接收 → 全663字节与5CRC自动核验；同版本KEY0独立复跑两次均通过。** 这是有限程序及手动复位运行验收，不是CPU整体、配置后自动启动、正式CoreMark或所有硬件安全验收。

## 实验序列与实际结果

| 阶段 | 目的与条件 | 实际结果 | 分层判断 |
|---|---|---|---|
| H24 | 直连后主机/取消守卫 | COM22/OK/CP210x11.6.0.420签名驱动；实际开COM约1.061秒后正常取消，原生0/Job空/无强制清理 | 关闭接收器主机清理缺陷，不是CPU测试 |
| H25 | 原R4调试镜像，仅UART绕过扩展坞；先开COM再用户KEY0 | 监听133.208秒，0字节/0错误事件，正常关闭/Job空 | 直连本身未恢复输出，不能认定扩展坞唯一致因；直连拓扑为用户报告 |
| H26 | 新只读身份/STATUS | PG2L100H/00602899；081efca0，DONE1/GOUTEN0，CRC/ID等错误0，OT1照录；工具原生0 | 配置仍就绪，不为0字节重刷相同镜像 |
| H27 | 既有无ILA同程序实现，一次有依据的易失对照；先开COM | Program166.657秒成功，前081efca0/后两次081ffca0，**GOUTEN0→1**，其它已核错误0/OT1保持；UART188.891秒仍0 | 当前输出使能有真实变化，但自动输出尚未得到证据 |
| H28 | 保持H27镜像，先开COM再用户KEY0 | 663字节/无串口错误，数据后静默2秒结束，原生0/Job空 | 首次完整物理输出与冻结参考MATCH |
| H29 | 不重Program，同版本一次KEY0重复性检查 | 再663字节/无串口错误，原生0/Job空；与H28及参考全字节相同 | 第二次独立复跑通过，不能外推所有复位/长测情况 |

H28采集01:45:51.224–01:46:38.198；H29采集01:47:37.646–01:48:29.571，均在实体KEY0请求前就绪。准确物理按键沿未知，只保留用户按松回执；不靠聊天到达时刻冒充电气沿。两个接收器均115200、8N1、无流控、DTR/RTS关闭、0发送，有180秒及65536字节硬限；没有软件伪注入串口数据。

## 身份与可比较性

H27位流来自已存非调试实现work/fpga/2026-10-27-board-coremark8-bitstream-m1/pds/generate_bitstream/board_top.sbit；3791112字节，SHA F548BC8BAA3DDFB5E2EB3158AE108F5A9DFCE7FE6C08919DB8DB245187C8D7A4。

执行前核14个生产输入文件：R4去且仅去调试标记注释后均与该无ILA实现字节同；ELF、program.bin、引脚/27MHz约束完全同；65个bitgen设置行同。IDENTITY_REVIEW.json保留逐文件SHA与边界。program.bin SHA EC365839FEA1111CB365763322E2FA99C3C3B3F6B74A5884C5B0EB30593486F0，ELF SHA90E06A11E410E36FCDE16570BDA9BE6C4A57800D94FE4AA84B17FC2BE4224638。原调试镜像SHA139DD520…73EFC03未覆盖，历史波形与失败不删除。

两实现的插桩、映射和布局布线不同。因此观察支持“无ILA实现下GOUTEN可为1、明确KEY0后可输出”，不证明ILA模块本身是唯一根因，也不证明扩展坞无任何影响。H27下载后自动窗口0、H28手动复位成功，可靠步骤现须明确KEY0；不把自动/冷启动写成通过。未改变保护位，OT1与成功输出并存，但不能由此证明温度正常或位必假。

## 自动核验与计时

H28/H29原始各663字节，SHA均9C3B61CD225EF097C00F7ED8D53ADB69F937F2451DF80B45535758366693DA4A，等于事前冻结参考SHA。沿用未改check_capture.py检查：全字节一致，首差异无，CRC字段各恰一次，无重复字段。并非仅匹配摘要或CRC通过。

| 字段 | 两次实收 | 冻结期望 |
|---|---|---|
| seedcrc | e9f5 | e9f5 |
| crclist | e714 | e714 |
| crcmatrix | 1fd7 | 1fd7 |
| crcstate | 8e3a | 8e3a |
| crcfinal | ccd1 | ccd1 |
| Total ticks / Raw delta64 | 16829452 / 000000000100cc0c | 同左 |

原始输出start=000000000000f20f，end=000000000101be1b；独立主机算术end-start=16829452，与打印delta/先前片上值一致。不是宿主采集墙钟时间作为执行时间。采集耗时包含等待用户按键，不作为CPU性能。

固件仍含“Must execute for at least10 secs”“Errors detected”“SIM ONLY, NO VALID SCORE”及Total time(secs)=0，这些原封保留；前者是8迭代不足10秒的预期短测限制，不是本轮CRC不一致。虽然实际数据来源已经是FPGA物理UART，旧固件标签未因此重写。**不是正式CoreMark成绩，也未独立实测27MHz频率**。

## 已排除与尚未解决

- 已不再缺真实物理UART完整输出；H28/H29是同一当前无ILA配置下有限验收，不能反向升级旧R4失败记录。
- H24验证正常取消机制，关闭H21主机清理缺陷的当前入口；旧H21强制结束记录仍保留，不倒改。
- 离线官方cfg_help列出帮助入口，但按其“命令名查看用法”调用实际返回缺mode/未连接/无device错误；全程未连接硬件。没有因此猜HEX执行mode5或修改寄存器，旧mode4不支持/参数疑点仍留存。一次公开官网检索未获得适用本板的新GOUTEN诊断依据，不套用FBG484等其他板。
- R4为什么GOUTEN0、下载后为什么没自动输出、真实pad电平/供电/温度及原读回偏移仍未完整解释；当前成功不等这些问题不存在。
- 无ILA镜像没有调试核，不能用旧FIC直接抓新波形；旧R4五CRC/计时片上证据与本轮物理输出分别注明镜像和运行来源。
- 无ILA构建原7个常量探针告警、14个外部IO延迟/CDC/实际配置供电局限保留；R4的4个调试Critical属另镜像历史，不能混算成新镜像已清或当前仍有同样插桩。

## 当前配置及下一阶段

当前易失配置为H27无ILA位流，H29复跑输出已结束；串口、官方客户端/服务器及自有Job全退出。没有后台监测、不能代切物理电源；未收到新断电回执。旧KEY0请求失效，不需继续按键，也不自动恢复R4或固化Flash。

固定有限基线索引：work/hardware-baselines/2026-11-01-coremark8-uart-nodebug-v1/{BASELINE.json,SHA256SUMS.json,READ_ME.md}。这是本地身份索引，未复制受限模型/工具或对外发布。下一项推荐基于此可重复外链基线准备并核验>=10秒的冻结测量版本；正式测量、调试问题修复和优化仍按各自范围执行，不由本轮8迭代输出自动验收或启动。
