minzhetang/pangu-riscv-soc/deliveries/mainline-local-debug-insert-r2-scope-2026-10-28-v1/IMPLEMENTATION_SCOPE.md

# A-LOCAL-DEBUG-INSERT-M1-R2 / 范围1.2.0

2026-10-28，D174推荐，**PENDING_APPROVAL**。这是弥补R1自有GUI监督缺陷、完成同一个观察核目标的完整软件阶段，不是硬件许可或CPU功能扩张。原1.1.0已停止的计数/时钟/失败不重置。

## 输入与修改边界

- 新独立R2目录，保留R1；使用F163完整13源及原八迭代程序/约束，仅允许沿R1已准备的3文件6处PAP_MARK_DEBUG注释，去掉新增注释必须逐字节恢复F163。发现还需其他功能/接口更改则停。
- 优先重新综合保留观察网，再按实际新ADF网络配置单核140bit、1024点、27MHz物理上升沿、All Data、不启多窗口/过滤；缺必需对象或无法证实映射就不通过。
- CPU、存储协议/初始化、UART/GPIO、Timer、软件/地址、引脚、SCBV既有High Voltage工程假设保持。原功能1792 INIT逐件比对，调试RAM另计。

## 一次批准覆盖的执行

- 自有GUI监督先以无厂商进程的合成窗口元数据验证：用自有PID/已核窗口类与角色识别主窗口，允许保存后标题变化；点击前核当前尺寸/窗口角色，截图在落盘前遮盖主机标题。不静默重写R1历史脚本。
- **最多1次新的Inserter GUI会话，累计<=600秒**；普通配置和GUI内官方Tcl属于一次会话。可关闭已可靠读明的纯信息Expiration Reminder，不勾不再提醒、不进入许可/注册/续期。不能可靠读取/控制就停止，不盲点、不额外重开。
- **最多1次完整PDS CLI构建，<=1800秒**；可先综合、待新FIC后再Map/PnR/时序/生成位流，避免重复综合。必要官方只读命令帮助/配置查询最多6项、各<=30秒，不当许可申请或额外完整构建。
- 总阶段<=3600秒，日志/进程超时受限；普通用户系统外执行仍由工具审批，不需要逐按钮业务确认。新安装、管理员、安全策略/环境、许可证实际配置等新权限停止。

## 验收及禁止项

分别验收工具checkout、实际140位/FIC/核连接、源与INIT保护、新鲜位流/SHA、最终内部27MHz时序/资源。保留7旧告警、外部IO/CDC及实际配置供电局限；新不明严重警告或时序失败不追加重试。

不运行GCC/Icarus/新DUT，不修改功能或测试预期，不开启Debugger/下载配置器/硬件服务器，不枚举设备/JTAG/上电/下载/Flash，不改供电/跳线/温控，不登录远程/上传/付费/对外咨询。over_temp STOP保持；软件位流不等真实采样、CPU实机或正式CoreMark。

本范围只是推荐；须用户明确批准后才执行新GUI/构建。无需用户代查日志、研究信号或联系厂家。
