minzhetang/pangu-riscv-soc/deliveries/mainline-local-debug-insert-r1-scope-2026-10-28-v1/IMPLEMENTATION_SCOPE.md

# A-LOCAL-DEBUG-INSERT-M1-R1 / 实施范围1.1.0

2026-10-28，D172推荐，**PENDING_SCOPE_APPROVAL**。在新独立目录恢复本地纯软件插核验证，保留已停止1.0.0及一次只读GUI证据，不重置旧时钟/计数。本范围一次批准覆盖必要子步骤，不按普通按钮或技术选择反复请求“继续”。

## 相对1.0.0只增加哪些权限

- 允许本地Inserter的普通GUI操作：读取界面、打开独立复制的ADF/FIC、配置调试核/连线/采样参数、保存新FIC。仅在已确认属于Expiration Reminder的纯信息提醒时，允许点击明确的OK/确定/关闭使其消失；不勾选“不再提醒”，不点击续期/注册/导入许可，不进入License Finder配置。
- GUI操作累计<=10分钟、最多2次Inserter启动；总阶段<=3600秒，PDS完整CLI构建最多1次/<=1800秒，必要Inserter CLI最多6次/各<=60秒。不是允许反复猜参数或跑到成功；接口错误先诊断，未知安全/功能范围问题或不能可靠操作即停。
- 可自主使用现有可信的Windows窗口/辅助功能接口和自身脚本检查自有进程界面；不改执行策略、不用Bypass、不关闭安全功能、不安装组件。只定位自己的窗口，不读取其他程序/文件列表/许可身份字段。无法可靠读控件时不盲点，改为一次明确、最小的人类反馈请求。

## 保持的原范围和限制

1. 新`work/fpga/2026-10-28-local-debug-insert-m1-r1/`（已存在则唯一新目录）；F160/F163整组13功能源/原15912B八迭代程序、ROM32KiB/RAM32KiB A5、94条引脚和27MHz、PG2L100H/-6/FBG676保持。原程序、旧位流/输入/失败不覆盖。
2. 只新增调试核及FIC/配置/脚本；优先网表插入。必要时仅在新cpu.v/soc_top.sv/board_top.sv中既有观察信号加入PAP_MARK_DEBUG非功能标记，移除标记后与原字节一致。禁止功能/接口/流水线/存储/外设/Timer/软件变化，禁止添加新业务逻辑或虚构信号。
3. 观察计划仍单核/1024点/逻辑140bit、物理时钟上升沿/All Data、不使能过滤/多窗口。核实际可连接网络及钟/复位/信号位序，不能用RTL名字代替已证连接。缺必需观察对象则不通过验收。
4. 可完成既有本地PDS流程及调试位流生成；正常现有许可checkout，仅记录真实提示。High Voltage沿D010工程假设，不试Low、不改变供电/温控。遇到真正的许可申请/配置、管理员、安装、系统环境/重启等新权限即停。
5. 不运行GCC/Icarus/新DUT，不改预期、不重跑CPU全矩阵，不植入新ISA，不用旧产物冒新结果。不打开Debugger/下载配置器/硬件服务器，不枚举设备，不连接/上电/JTAG/下载/Flash；不登录远程平台、不上传/付费/账号申请或对外咨询。over_temp STOP保持。

## 验收及停止

- 冻结输入/完整命令/原生rc/超时与日志上限；GUI提示、实际操作及配置变更留脱敏记录。原生日志及厂商实现/ADF/大初始化/程序和位流仅本地。
- 工具入口、实际FIC网络连接/核、功能INIT与源保护、新调试位流/资源/内部时序分别验收；无新GUI或脚本文件不能当成功。确认原功能存储1792个保留INIT与原始ROM/RAM一致，调试RAM另计；原13源/镜像/FDC后验不变或只有已批标记差异。
- PDS退出后检查新鲜非空sbit/大小/SHA、生成完成、器件/SCBV、27MHz最终setup/hold/recovery/removal及资源开销。7旧constant-probe及外部IO/CDC限制不掩盖，新不明严重警告或时序失败即停止验收，不追加构建重试。
- 软件准备成功不等真实采样/FPGA实机/正式CoreMark成绩，也不解除过温/实际供电缺口。本阶段完成、触及预算或需要其他范围时停止，交付准确diff、FIC/位流SHA、时序资源及分层结论。
