minzhetang/pangu-riscv-soc/deliveries/mainline-local-debug-insert-scope-2026-10-28-v1/IMPLEMENTATION_SCOPE.md

# A-LOCAL-DEBUG-INSERT-M1 / 实施范围1.0.0

2026-10-28；D168技术推荐，**PENDING_SCOPE_APPROVAL**。这是本地纯软件片上调试准备，不要求外部咨询，不授权GUI、平台登录或任何硬件操作。

## 要解决的问题

F163已生成CPU8迭代基准位流，但没有DebugCore和配套FIC，不能据此取得CPU内部片上波形。本轮拟验证本机PDS能否把观察核加入同一设计，保留准确的CPU/时钟/控制信号，并生成内部27MHz时序合格的调试位流。软件构建成功仍不等真实捕获成功。

## 独立副本与不变内容

- 创建新的`work/fpga/2026-10-28-local-debug-insert-m1/`，存在则使用唯一新目录，不覆盖旧证据。保留source-before、输入SHA、F163无调试位流/ADF和原FIC示例。
- 目标仍PG2L100H/-6/FBG676、board_top，原27MHz与94条引脚约束不变。整组功能源以F160/F163的SOURCE_RECEIPTS核对，程序使用原15912B八迭代bin，ROM32KiB=image+零、RAM32KiB A5。
- 不改CPU功能、流水线、前推、存储协议、Timer、外设、地址映射、启动/链接、软件算法、参数或预期；不运行GCC/Icarus/新DUT，不重跑CPU矩阵，不混F146候选。

## 允许的最小变化与步骤

1. 新增本阶段监督/检查脚本、PDS构建Tcl、FIC和必要调试配置。先复制已有ADF到隔离目录，使用既有`cdt_ins.exe`核实批处理接口、列出实际可连接网络；按实际索引连接，不把RTL层次名直接当FIC有效映射。
2. 优先网表插核。若必要信号被优化，仅允许在**新副本**的既有信号声明处加入官方`PAP_MARK_DEBUG`非功能保留标记，范围限定`cpu.v、soc_top.sv、board_top.sv`中本次观察对象；禁止添加端口、逻辑、状态机、探针触发业务逻辑或改变赋值。移除新增标记后须与原功能源逐字节一致；精确diff和SHA单列。若仍需新增功能或更改接口，停止说明。
3. 观察草案沿F164：1个DebugCore、1024点、物理27MHz上升沿采样、All Data，初始禁多窗口/存储过滤；逻辑数据140bit，覆盖id_pc、有效/advance/hold/stall/flush/branch、复位、timer低32位、写地址/数据/使能、停止与错误信息。实际clock net/信号连接必须核对。遗漏必需信号不能假装全连通；可诊断保留，但不通过观察完整性验收。
4. 正常新副本PDS流程compile→ADS synthesize→插核/Map→pnr→report_timing→gen_bit_stream。SCBV仅沿D010工程假设High Voltage，不试Low、不改实际供电或旧工程。不调用Debugger、配置器、硬件服务器、设备枚举或JTAG。

## 明确预算和停止条件

- 既有`cdt_ins.exe`最多6次必要CLI短调用，每次<=60秒；不是允许连续猜参数。首次接口/载入失败先保留诊断并停止相关阶段，不运行失败输出或盲试别的组合。仅批处理；若必须使用GUI，停下来单独说明，不自动打开。
- 最多1次PDS完整构建，<=1800秒；整个阶段含准备与验收<=3600秒。原生stdout/stderr各<=32MiB，卷可用>=4GiB，独立绝对deadline/新目录/失败清理和实际资源观测边界留痕。
- 正常使用现有许可证checkout，记录本次实际提示；需要改许可/环境、安装、管理员、驱动、GUI或新软件即停，不关闭安全功能。沙箱外执行仍独立走系统审批。
- 新增不明严重警告、内部时序失败、遗漏观察信号、功能源/INIT不一致、超预算或所需范围扩大即停。失败照实交付，不重跑到通过，不篡改预期、不删除旧失败。

## 分层验收和交付

1. **工具入口**：本次批处理真实运行、原生rc/退出/日志；二进制出现`-batch`或示例存在不作通过。
2. **插核与对应关系**：FIC/当前设计/器件/时钟/实际net逐一对应；本次DebugCore/JtagHub与数据存储真实存在，1024深度/140bit及采样设置核同。FIC是描述，不凭文件存在认定已插核。
3. **基准不退化的静态证据**：原13功能语义/原8镜像/FDC不变，额外保留标记单列；从原始ROM/RAM核验功能存储的1792个保留INIT片段，调试RAM另列，不因总DRM增加混淆。保留无调试与有调试的资源/内部setup/hold/recovery/removal对照，记录新增开销，不预承诺无影响。
4. **位流**：PDS完全退出后检查真实完成标志、新鲜非空sbit、大小/SHA256、工具/器件/SCBV、完整时序/警告。原7条constant-probe仍是未闭问题；新告警单独诊断，不能因有位流就宣布无害。14个外部IO/物理CDC限制不因本阶段消失。
5. **明确未做**：没有真实片上捕获/采样延迟校准、CPU实机、正式CoreMark计时或远程平台适配验收。新FIC/位流不授权连接/上电/扫描/下载，也不证明实际配置电压或over_temp原因。

交付准确diff、完整脱敏命令/工具版本、本次日志/进程结果、新FIC/位流/SHA、探针映射和INIT核验、资源时序对比与分层结论。厂商模型/网表/数据库、原生日志、镜像/位流仅本地，Git只纳入已审脚本及脱敏证据。

本阶段完成或触及停止条件后结束，不自动启动GUI、校准采集、远程登录/账号/预约/付费/上传、实体测温或下一轮构建。over_temp硬件停止保持。
