minzhetang/pangu-riscv-soc/deliveries/mainline-debug-connectivity-scope-2026-10-29-v1/IMPLEMENTATION_SCOPE.md

# A-DEBUG-CONNECTIVITY-M1

版本1.0.0；2026-10-29；推荐待批，不是新GUI或硬件授权。

## 目标与依据

F172只读分析证明140个一级采样CLK在两角均属27MHz，但未取得后布局D引脚→网络→真实驱动的完整关系。4条调试时钟Critical保持开放。仅使用官方Design Editor核查已有产物，不重新制造位流或修改设计。

## 单次授权范围

- 新建独立工作目录，复制并核SHA：R4`build/place_route/board_top_pnr.adf`，必要时已有timing ADF及rtr.db。原件/位流/FIC/功能RTL/INIT/约束只读并前后核SHA；不得覆盖旧产物。
- 一次普通权限GUI：`D:/PDS/PDS_2022.2-SP6.4/bin/de.exe`，最长600秒，整个阶段最长1200秒；不另开PDS主窗、pds_shell或第二次GUI，不重置R4计数。
- 依据官方手册加载同字节数据库副本；保持版本检查。允许可靠读明后确认纯信息到期提醒，不进入许可证配置。遇授权/版本/未知模态错误即记录停止，不安装或修改环境。
- 只读查询或查看：140个trig0_d1的D/CLK实际驱动；优先数据136–139的停止/错误源、34的eei_hold、38的sys_rst_n；4条Critical的时钟源/缓冲/负载/实际路径。若当前软件提供可确认的批量导出则使用，否则记录实际完成覆盖，不冒称全通道。
- 同一次GUI内最多6项只读帮助查询，用于确认查询语法；只执行已确认不会修改网表/约束的命令。允许保存新文本查询结果/证据截图到独立目录；不保存或更改数据库/布局/约束，不编辑属性，不生成timing或bitstream新流程。
- 窗口识别失败、无法可靠控制、预算到期或查询需要修改设计时停止；只管理本次自有进程，不终止其他会话。禁止猜坐标盲点或连续重启。

## 不在范围内

0综合/映射/PnR/位流生成，0新DUT/编译，0功能RTL/TB/程序/存储/ISA/B接口修改；不改变FIC、复位配置、时钟/引脚/FDC或PAP_CLOCK_DEDICATED_ROUTE；不安装、管理员、许可证/驱动/环境修改、外发或咨询。

0 Debugger/硬件服务器/设备枚举/JTAG/连接/上电/下载/Flash；不改变SCBV、供电、跳线、温控，over_temp STOP保持。

## 验收及停止

- 原生载入成功和进程真实退出、源哈希同；准确记录版本/命令/所见对象/来源数据库及覆盖数量。
- 对每个实际核实通道记录采样D引脚、所属网络、驱动实例/输出引脚及对逻辑别名的解释；不要只列网络名或寄存器库存。无法追清的列为未核实。
- 对4条Critical记录路径/负载观察和仍需验证的内容；无官方适用依据时不得豁免，不把GUI能显示当物理可靠/CDC验证。
- 只有证据支持的局部连接问题可以关闭；软件候选、真实采样、实机、正式CoreMark分别记，不自动进入修复、重建或硬件。
- 阶段完成或明确门槛即停，报告下一最小建议，不能在同一授权下无限尝试。
