minzhetang/pangu-riscv-soc/deliveries/mainline-local-debug-insert-r4-scope-2026-10-28-v1/IMPLEMENTATION_SCOPE.md

# A-LOCAL-DEBUG-INSERT-M1-R4 / 范围1.4.0

2026-10-28，D178推荐，PENDING_APPROVAL。原R1/R2/R3失败、部分结果与计数只读保留。仅完成既有140位观察核软件准备；无CPU功能/接口或硬件扩张。

## 两项必要增量

1. 在既有3文件6处非功能标记上，**只多一处cpu.v的eei_hold保留注释，总7处**。准确提议见PROPOSED_EEI_HOLD_MARKER.patch；不改变任何表达式或新造逻辑。去掉7注释后完整13源必须逐字节等F163。未获批准不修改RTL候选；若仍缺其他必需观察点，不降低标准或继续扩大标记。
2. 改为**两个明确PDS CLI边界**：第一次只编译/综合并等进程退出、核新ADF后才启动GUI；GUI完成FIC并正常退出后，第二次执行一次完整带FIC构建（可沿已验证标准流程重新综合同一冻结输入，接受这一有限重复成本）。不在PDS Tcl中用等待循环阻塞尚未执行的动作队列，不用标志文件代替真正产物和退出结果。两次综合网表须除已记录日期/阶段路径外完整规范化核同；插核实际连接、新网表/INIT/位流另审。

## 额度与验收

- 新独立目录，PDS第一次综合<=180秒、第二次完整构建<=1800秒，最多这2次原生PDS入口；**1次GUI<=600秒**，总阶段<=3600秒。不追加原生帮助查询，复用已核接口；不因第一次综合通过就宣称插核成功。
- 沿可靠的提醒读取/明确OK确认、角色等待/窗口尺寸/自有PID规则；许可配置/续期/注册、安全策略、安装/管理员/系统环境等仍排除。一次批准覆盖整个阶段，不逐按钮申请。
- 140位全部实际映射并保存连接，clock/reset/单核1024点/27MHz物理上升沿/All Data/无过滤多窗口；原15912B程序、32KiB ROM/RAM A5、94引脚与约束不变。原1792功能INIT逐片核同、调试RAM另计。
- PDS正常退出后核新鲜位流/SHA、最终27MHz setup/hold/recovery/removal、资源和新增警告；保留7旧告警/外部IO及CDC/配置供电缺口。不以旧位流、139位、软件退出0或候选代验收。
- 无GCC/Icarus/新DUT，无Debugger/下载器/硬件服务器/设备枚举/JTAG/上电/位流下载/Flash，不改SCBV、供电、跳线或温控，不对外联系。over_temp STOP保持；软件准备不等真实采样/CPU实机/正式CoreMark。

当前只备范围和文本差异，**未实施第7处标记或新调用**。Git业务许可已明确但系统外发阻塞，不绕过；本地审查提交不以远端放行为前置。
