minzhetang/pangu-riscv-soc/deliveries/mainline-local-debug-insert-r3-scope-2026-10-28-v1/IMPLEMENTATION_SCOPE.md

# A-LOCAL-DEBUG-INSERT-M1-R3 / 范围1.3.0

2026-10-28，D176推荐，PENDING_APPROVAL。仅恢复被A控制脚本中断的同一软件观察核阶段；原R1/R2失败、额度及产物只读保留，不重置旧预算。没有新CPU功能或硬件范围。

- 原1.2.0输入/功能/安全及验收限制全部沿用。仍只用F163完整基线和R1已准备的3文件6处非功能保留标记，原程序/存储/外设/引脚/27MHz/SCBV不变；标记之外的RTL需求先停。
- 在新独立目录，先修正并离线复验完整控制路径：保存后标题变化、启动提醒、主窗口未出现、最小化/尺寸变化、PDS标志存在但进程已死。提醒必须先可靠读取再允许明确的信息确认，不盲点或配置许可证。
- PDS等待使用已原生验证的有界while/after/incr，不调用缺失clock；GUI启动前核自有PDS实际存活，不能只看SYNTH_READY。必要界面读取不转交用户研究。
- **最多1次新Inserter GUI/600秒、最多1次完整PDS/1800秒、总阶段3600秒**。本次不额外安排原生命令帮助查询（R2已核接口可复用）。一次批准覆盖必要配置/官方GUI Tcl/保存及构建，不逐按钮索继续。
- 验收完整140位实际连接/单核1024点/物理上升沿/All Data；1792功能INIT、原件哈希、新鲜位流/SHA、最终内部27MHz时序/资源分层核验，缺项不通过。未核别名、旧位流或退出码不得替代证据。
- 不运行GCC/Icarus/新DUT，不安装/改环境/许可，不启动Debugger/硬件服务器，不枚举设备/JTAG/上电/下载/Flash，不改供电/跳线/温控，不对外联系。over_temp STOP保持。

本文件是待批范围，不是已执行或新许可。Git已获用户业务批准但受系统审批阻塞，软件恢复不以推送放行为前置。
