minzhetang/pangu-riscv-soc/snapshots/2026-11-03-submission/report/figures/01-system.pdf

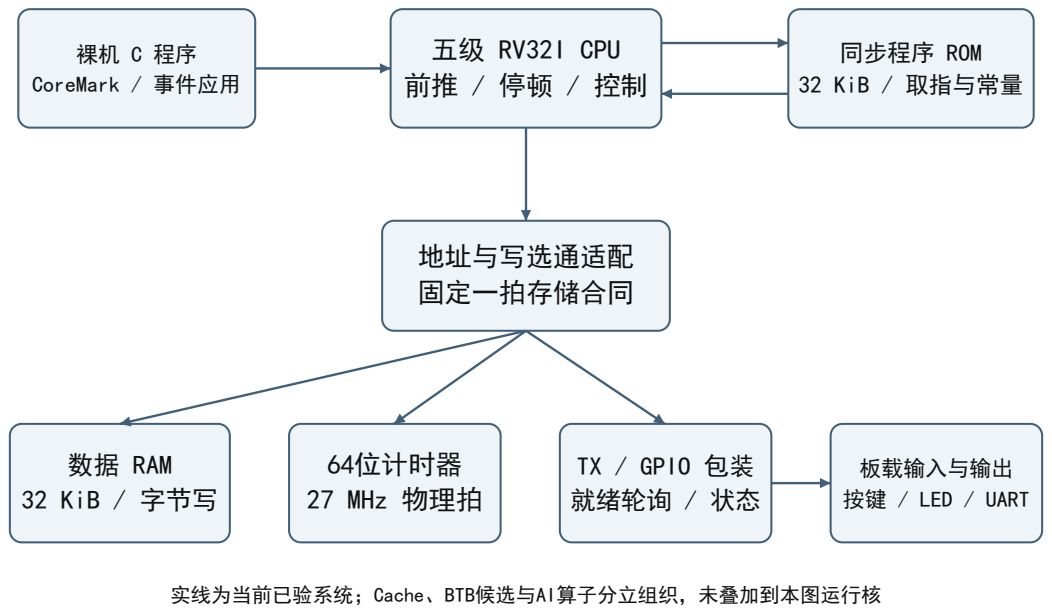
[picture p28: page 1]
裸机 C 程序 CoreMark / 事件应用; 同步程序 ROM 32 KiB / 取指与常量; 地址与写选通适配 固定一拍存储合同; 数据 RAM 32 KiB / 字节写; 64位计时器 27 MHz 物理拍

五级 RV32I CPU

TX / GPIO 包装
就绪轮询 / 状态

板载输入与输出
按键 / LED / UART

实线为当前已验系统；Cache、BTB候选与AI算子分立组织，未叠加到本图运行核
