minzhetang/pangu-riscv-soc/work/fpga/2026-10-27-board-coremark8-bitstream-m1/finalize.py

from pathlib import Path
import json,hashlib,sys,time,difflib,re
sys.dont_write_bytecode=True;sys.stdout.reconfigure(encoding='utf-8')
H=Path(__file__).resolve().parent;P=H.parents[2];B=P/'work/fpga/2026-10-25-board-top-m1';S=P/'work/fpga/2026-10-27-coremark-longrun-ready-m2'
from stage_budget import check
read=lambda p:json.loads(p.read_text(encoding='utf-8-sig'));sha=lambda p:hashlib.sha256(p.read_bytes()).hexdigest().upper()
def save(n,o):
 with (H/n).open('x',encoding='utf-8') as f:json.dump(o,f,ensure_ascii=False,indent=2);f.write('\n')
if __name__=='__main__':
 check();r=read(H/'AUDIT_RESULT.json');assert r['status']=='SOFTWARE_BITSTREAM_GENERATED_WITH_KNOWN_LIMITS';mem=read(H/'MEMORY_INIT_AUDIT.json');res=read(H/'TIMING_RESOURCE_AUDIT.json');warn=read(H/'WARNINGS_LICENSE_AUDIT.json')
 orig=read(H/'PROTECTED_ORIGINALS.json')['files'];live=read(H/'FROZEN_INPUTS.json')['files'];assert all(sha(Path(x['path']))==x['SHA256'] for x in orig);assert all(sha(H/x['path'])==x['SHA256'] for x in live)
 for row in read(H/'SOURCE_RECEIPTS.json')['functional_RTL']:
  assert sha(H/'source'/row['name'])==sha(H/'source-before'/row['name'])==row['SHA256'];assert sha(S/'source'/row['name'])==row['SHA256']
 assert read(H/'PDS-attempt.json')['used']==1
 summary=dict(stage='A-BOARD-COREMARK8-BITSTREAM-M1',date_client='2026-10-27',approval='D164',decision_result='D165',fact='F163',status=r['status'],PDS_runs=1,new_C_builds=0,new_sim_compiles=0,new_DUT=0,tool=res['tool'],target=dict(device='PG2L100H',speed='-6',package='FBG676',top='board_top'),image=read(H/'INIT_RECEIPT.json'),bitstream=r['artifact'],timing=r['timing'],resources=res['resources'],SCBV='High Voltage; D010 engineering assumption only',physical_configuration_supply='NOT_FULLY_VERIFIED',license_checkout='SUCCESS_THIS_RUN',license_days_prompt=r['license_days_remaining'],constant_probe=7,new_warning_counts={},unconstrained_input_count=5,unconstrained_output_count=9,independent_INIT_pieces=1792,INIT_changed_pieces=r['changed_INIT_pieces'],PDS_wall_seconds=r['PDS_process']['elapsed_seconds'],shell_peak_bytes=r['PDS_process']['peak_working_set_bytes'],supervisor_parent_peak_bytes=r['PDS_process']['parent_peak_working_set_bytes'],tool_reported_pool_MB=warn['tool_reported_memory_pool_max_MB'],memory_measurement_boundary='entry PDS shell and supervisor measured; internal stage memory pool is tool-reported, not independently measured whole-tree total',originals_protected=len(orig),frozen_inputs=len(live),functional_RTL13_unchanged=True,production_source='12 exact; memory_model deterministic M0_VERIFY exclusion and INIT expansion',hardware='STOPPED',JTAG_this_round='NOT_RUN; historical PG2L100H chain recognition retained separately',CPU_hardware='NOT_VALIDATED',ILA='NOT_IMPLEMENTED',formal_CoreMark_score=False,limitations=['known seven constant-probe warnings remain unresolved','14 external IO delays and physical CDC not validated','SCBV is accepted engineering assumption, not measured supply proof','no bitstream binary INIT decode/readback/post-layout functional simulation','program8 is finite short simulation baseline, no >=10second formal measurement','no hardware/Flash actions, no FPGA execution evidence'],scope_identity_correction=read(P/'deliveries/mainline-board-coremark8-bitstream-scope-2026-10-27-v1/SCOPE_IDENTITY_CORRECTION.json'),preparation_notes=['scope old SHA metadata used normalizedLF; actual reviewed Git file unchanged, erratum retained','initial auditor searched Tcl completion in flow.log; exact marker belongs to stdout; retained source/note','second auditor treated string INIT_MODE as numeric INIT data; corrected exact INIT_00..3F selection; ordinary parameters still checked; existing configuration checkpoint preserved identically'],next='resolve safe usable FPGA platform and scope real CPU/ILA evidence; no automatic hardware restore')
 save('SUMMARY.json',summary);save('STATUS.json',dict(status=summary['status'],PDS_used=1,new_C=0,new_simulation=0,CPU_bitstream_generated=True,hardware='STOPPED',formal_score=False))
 # Exact visible changes, without dumping large firmware tables into the review patch.
 diffs=[]
 for name in ['alu.v','board_reset_sync.sv','board_top.sv','control.v','cpu.v','cycle_counter64.sv','gpio_core.v','local_regif_txgpio_m1.v','regfile.v','soc_data_adapter.sv','soc_top.sv','uart_tx.v']:
  assert sha(H/'pds/source'/name)==sha(H/'source'/name)
 save('SOURCE_CHANGE_SUMMARY.json',dict(functional_RTL_diff=[],firmware_source_changes=[],source_before_files=13,production_exact_files=12,memory_transformation='No functional edits: strip M0_VERIFY verification-only blocks and inline same INIT',new8_ROM_replaces_old1_at_byte=15904,new_program_bin_SHA256=sha(H/'firmware/program.bin'),constraints_unchanged=[dict(name=n,SHA256=sha(H/'pds'/n),old_SHA256=sha(B/'pds'/n)) for n in ['board_pins.fdc','clock_27mhz.fdc']],flow_diff='FLOW_DIFF.patch',gen_bit_stream_added_with_existing_SCBV_decision=True))
 commands=dict(argv=r['PDS_process']['argv'],cwd=r['PDS_process']['cwd'],native_rc=0,timeout_seconds=1800,wall_seconds=summary['PDS_wall_seconds'],PDS_invocations=1,external_route='separately approved ordinary-user execution; not Windows administrator',Python=sys.version.split()[0],outputs='fresh files in new directory checked after PDS exit',hardware='STOPPED')
 save('COMMAND_RECEIPT.json',commands)
 (H/'COMMANDS.md').write_text('# One authorized PDS software invocation\n\nD164 scope; existing PDS, ordinary user, separately reviewed external execution. No GCC, Icarus, DUT, hardware server, JTAG or Flash actions. Actual command:\n\n```json\n'+json.dumps(commands,ensure_ascii=False,indent=2)+'\n```\n\nPipeline: compile, ADS synthesize, dev_map, pnr, report_timing, gen_bit_stream -scbv "High Voltage". Complete native logs are local-only because tools may include license locations/host fields. Public receipts contain only safe parsed fields. Recheck audit_build_v3.py and subordinate JSONs; initial auditors/diagnostic notes remain. Never rerun run_once.py or remove its attempt marker.\n',encoding='utf-8')
 (H/'REPRODUCE.md').write_text('''# CoreMark8 software bitstream baseline

Start with SUMMARY, APPROVAL, INIT_RECEIPT, SOURCE_RECEIPTS, SOURCE_CHANGE_SUMMARY, COMMANDS, CONFIGURATION_AUDIT, MEMORY_INIT_AUDIT, TIMING_RESOURCE_AUDIT and WARNINGS_LICENSE_AUDIT. The single PDS call is consumed. A reproduction needs a new independent directory, the pinned F16013 source/8 image, F142 FDC, existing licensed PDS and separately scoped permission. Do not rerun build scripts in this immutable evidence directory or reset its absolute2400-second clock.

The original proposal scope stays unchanged; its previous SHA was UTF8/LF-normalized. Read SCOPE_IDENTITY_CORRECTION in the proposal directory for the actual reviewed CRLF file SHA. This is a metadata erratum, not a different authorized build.

Twelve production files equal F160 bytes. memory_model only excludes M0_VERIFY views and inlines the unchanged new initializer; functional source/source-before remain identical. The raw image is15912 bytes padded to32KiB, RAM32KiB A5, and all1792 retained synthesis INIT fragments were independently computed from raw bytes. No claim of proprietary bitstream decoding or hardware readback.

Git excludes tool/vendor models, generated initializer/large expanded memory source, synthesized/netlist/PDS databases, firmwareELF/bin, native raw logs, sbit/smsk and license details. All full original local evidence is preserved; a Git clone alone does not include these artifacts. Hardware STOP remains even when software generation succeeds. Historical JTAG recognition is separate from this round's zero hardware actions and unverified CPU/ILA run.
''',encoding='utf-8')
 print(json.dumps(dict(status=summary['status'],bitstream=r['artifact']['path'],SHA256=r['artifact']['SHA256'],protected=len(orig),frozen=len(live),license_days=summary['license_days_prompt']),ensure_ascii=False))
