minzhetang/pangu-riscv-soc/work/fpga/2026-10-27-coremark-longrun-ready-m2/adapt.py

from pathlib import Path
import re
H=Path('D:/A_FPGA_Comp/work/fpga/2026-10-27-coremark-longrun-ready-m2')
p=H/'stream_io.py';s=p.read_text(encoding='utf-8-sig');s=s.replace('import block_codec','from stage_budget import check,json_read,deadline as make_deadline\nimport block_codec')
s=s.replace('RAW_CAP=512*1024*1024;ARCHIVE_CAP=256*1024*1024','RAW_CAP=16*1024**3;ARCHIVE_CAP=4*1024**3\nINDEX_CAP=16*1024**2;SEGMENT_CAP=16384;RECORD_CAP=500000000')
s=s.replace("    d=hashlib.sha256()", "    check();d=hashlib.sha256()",1).replace("for b in iter(lambda:f.read(1048576),b''):d.update(b)","for b in iter(lambda:f.read(1048576),b''):check();d.update(b)")
s=s.replace("d=Path(directory);spec=json.loads((d/'streams.json').read_text(encoding='utf-8'))[kind]", "check();d=Path(directory);spec=json_read(d/'streams.json',65536)[kind]")
s=s.replace('for block in iterator:\n', 'for block in iterator:\n            check()\n')
s=s.replace('index.stat().st_size<=2*1024*1024','index.stat().st_size<=INDEX_CAP').replace("meta=json.loads(index.read_text(encoding='utf-8'))", 'meta=json_read(index,INDEX_CAP)')
s=s.replace("len(meta['segments'])<=1024", "len(meta['segments'])<=SEGMENT_CAP").replace('count<=16000000','count<=RECORD_CAP')
s=s.replace("    for number,seg in enumerate(meta['segments']):\n", "    for number,seg in enumerate(meta['segments']):\n        check()\n")
s=s.replace("for block in block_codec.decode(folder,seg['index_SHA256']):\n", "for block in block_codec.decode(folder,seg['index_SHA256']):\n            check()\n")
s=s.replace('def __init__(self,run):', 'def __init__(self,run,deadline=None,poll=None):')
s=s.replace("        self.run=Path(run).resolve();", "        self.deadline=make_deadline(900) if deadline is None else deadline;self.poll=poll\n        self.timings=dict(encode_s=0.0,decode_verify_s=0.0,source_verify_delete_s=0.0)\n        self.run=Path(run).resolve();")
s=s.replace('    def consume(self,line):\n', '    def checkpoint(self):\n        check(self.deadline)\n        if self.poll is not None:self.poll()\n    def consume(self,line):\n        self.checkpoint()\n')
s=s.replace("k=a[1];seq,n=int(a[2]),int(a[3]);require", "k=a[1];seq,n=int(a[2]),int(a[3]);require(seq<SEGMENT_CAP,'SEGMENT_CAP');require")
s=s.replace("dst=self.root/k/f'{seq:06d}';meta=block_codec.encode(path,dst,time.monotonic()+15)", "require(sum(r['records'] for r in self.rows[k])+n<=RECORD_CAP,'RECORD_CAP')\n        dst=self.root/k/f'{seq:06d}';started=time.monotonic();self.checkpoint();meta=block_codec.encode(path,dst,min(self.deadline,time.monotonic()+15));self.timings['encode_s']+=time.monotonic()-started\n        self.checkpoint();started=time.monotonic()")
s=s.replace("        for block in block_codec.decode(dst,ih):\n", "        for block in block_codec.decode(dst,ih):\n            self.checkpoint()\n")
s=s.replace("        packed=sum(x.stat().st_size", "        self.timings['decode_verify_s']+=time.monotonic()-started\n        packed=sum(x.stat().st_size",1)
s=s.replace("        require(path.resolve(strict=True)==resolved", "        self.checkpoint();started=time.monotonic()\n        require(path.resolve(strict=True)==resolved",1)
s=s.replace("path.unlink();self.deleted.append", "path.unlink();self.timings['source_verify_delete_s']+=time.monotonic()-started;self.deleted.append")
s=s.replace("    def finish(self):\n", "    def finish(self):\n        self.checkpoint()\n")
s=s.replace("idx=self.root/k/'stream-index.json';save(idx,value)", "idx=self.root/k/'stream-index.json';require(len(json.dumps(value,indent=2).encode('utf-8'))+1<=INDEX_CAP,'GLOBAL_INDEX_CAP');save(idx,value)")
s=s.replace("packed_bytes=self.packed,deleted=self.deleted", "packed_bytes=self.packed,timings=self.timings,deleted=self.deleted")
s=s.replace("        return specs", "        require(sum(q.stat().st_size for q in self.root.rglob('*') if q.is_file())<=ARCHIVE_CAP,'ARCHIVE_META_CAP')\n        self.checkpoint();return specs")
p.write_text(s,encoding='utf-8',newline='\n')
# Budget-only changes; old2 uses its own frozen expected values.
p=H/'check_coremark.py';s=p.read_text(encoding='utf-8-sig').replace('assert ref.steps<5000000 and time.monotonic()-ref_started<600','assert ref.steps<25000000 and time.monotonic()-ref_started<900');p.write_text(s,encoding='utf-8',newline='\n')
p=H/'frozen_checks.py';s=p.read_text(encoding='utf-8-sig').replace("actual['iterations'],2)","actual['iterations'],frozen['iterations'])").replace("0<actual['physical']<=8000000", "0<actual['physical']<=(32000000 if frozen['iterations']==8 else 8000000)");p.write_text(s,encoding='utf-8',newline='\n')
p=H/'tests/tb_board_coremark.sv';s=p.read_text(encoding='utf-8-sig');assert s.count('8000000')==3;s=s.replace('8000000','32000000')
assert s.count('trace_total=trace_total+1;')==4 and s.count('bus_total=bus_total+1;')==1
s=s.replace('trace_total=trace_total+1;','').replace('bus_total=bus_total+1;','')
s=s.replace('$fclose(events_fd);events_fd=0;','trace_total=trace_total+trace_count;$fclose(events_fd);events_fd=0;').replace('$fclose(bus_fd);bus_fd=0;','bus_total=bus_total+bus_count;$fclose(bus_fd);bus_fd=0;')
p.write_text(s,encoding='utf-8',newline='\n')
print('Candidate limits/deadlines and close-segment counters updated; unchanged 13 RTL and ISA semantics')
