minzhetang/pangu-riscv-soc/(commit log)

2026-10-24 docs: define bounded FPGA implementability stage pending approval
2026-10-24 Validate logical SoC mapping and 27 MHz timing; retain board and warning limits
2026-10-25 Add board pinning, reset synchronizer and verified C UART/GPIO flow
    [audit_pds.py, audit_waves.py, board_reset_sync.sv, board_smoke.c, board_top.sv, check_board.py, checker_negatives.py, stage_board.py]
2026-10-25 Verify frozen CoreMark on board top with N234 UART; retain score limits
2026-10-25 Quantify existing control-flow cost and scope resolved-target fetch candidate
2026-10-25 Measure resolved-target fetch candidate; hold promotion pending new PDS warning
    [CASE_RESULTS.csv]
2026-10-25 Bound final-netlist loop risk; preserve unresolved constant-probe warning
2026-10-25 Review final stage v01; close ordered capture, retain precise evidence gaps
2026-10-25 Validate two-iteration CoreMark calibration with frozen independent expectations
2026-10-27 Profile existing CoreMark8 window and stage pending CPU bitstream scope
2026-10-28 Check local Inserter evidence and stage pending debug insertion scope
2026-10-28 Record approved Inserter probe stopped at GUI boundary; preserve diagnostics
2026-10-28 Inspect Inserter reminder; correct expiry parser and stage bounded GUI insertion scope
    [finalize.py]
2026-10-28 Preserve partial Inserter configuration and title-guard failure; stage bounded recovery
    [finalize.py]
2026-10-28 Preserve R2 synthesis-only evidence and control failures; prepare bounded fixes
    [finalize_stage.py]
2026-10-28 Record R3 normal GUI and unresolved hold probe; preserve mapping gate and bounded next scope
2026-10-29 Preserve native export prerequisite failure and context diagnosis
    [host_supervisor.py]
2026-10-29 Validate CoreMark software candidates with dual-seed short RTL checks
    [audit_uart.py, check_coremark.py, check_short_worker.py, diagnose_static.py, finalize_host.py, finalize_stage.py, frozen_checks.py, host_supervisor.py]
2026-10-30 Prepare pending single LED pre-post configuration diagnostic scope
2026-10-30 Archive LED diagnostic source and current hardware validation limits
2026-11-02 Accept finite SM2 dual-seed evidence and preserve UART diagnostics
2026-11-03 Archive complete submission code, application and independent advanced results
    Add the reviewed RAR5 submission artifact and browseable source, including
    the accepted SM2 system, event recorder, independent BTB/M-mode, Cache/AI,
    FPGA constraints, frozen verification inputs and declared dependencies.
    Add the 41-page technical report, editable DOCX, figures and evidence map.
    Keep production, application and candidate validation layers separate;
    the failed M6 long run is not a completed >=10-second candidate result.
    Verify all 8802 staged blobs against the reviewed SHA-256 scope. No new
    build, simulation, PDS flow or hardware run. Retain pending D245 README,
    contribution and dependency-docume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
    [CACHE_COMPARISON.csv, COMPARISON.csv, board_top_dmr.prt, board_top_hl4_dmr.prt, board_top_hl4_prr.prt, board_top_prr.prt, list.csv, matrix.csv]
